DanielBryars/ChadHouse/2D/Structural/20180212_132553 rebate spec.png

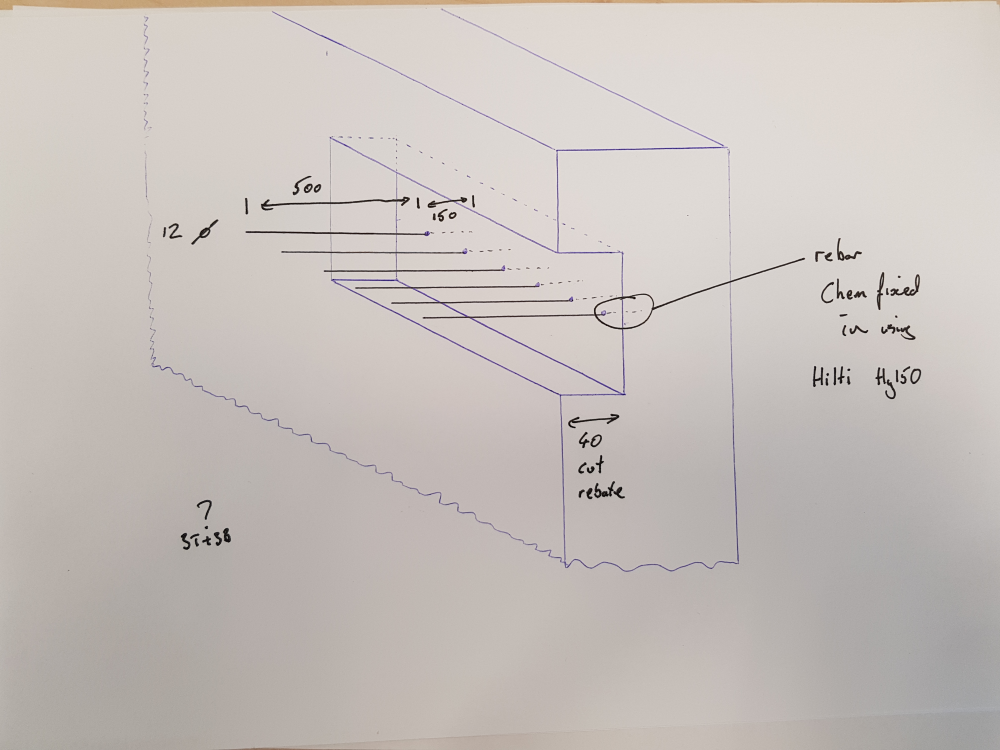
2D/Structural/20180212_132553 rebate spec.png
