DanielBryars/ChadHouse/Planning/readme.txt

15/03680/FUL

https://publicaccess.westoxon.gov.uk/online-applications/applicationDetails.do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
