DanielBryars/ChadHouse/Plumbing/Domestic Takeoff.pdf

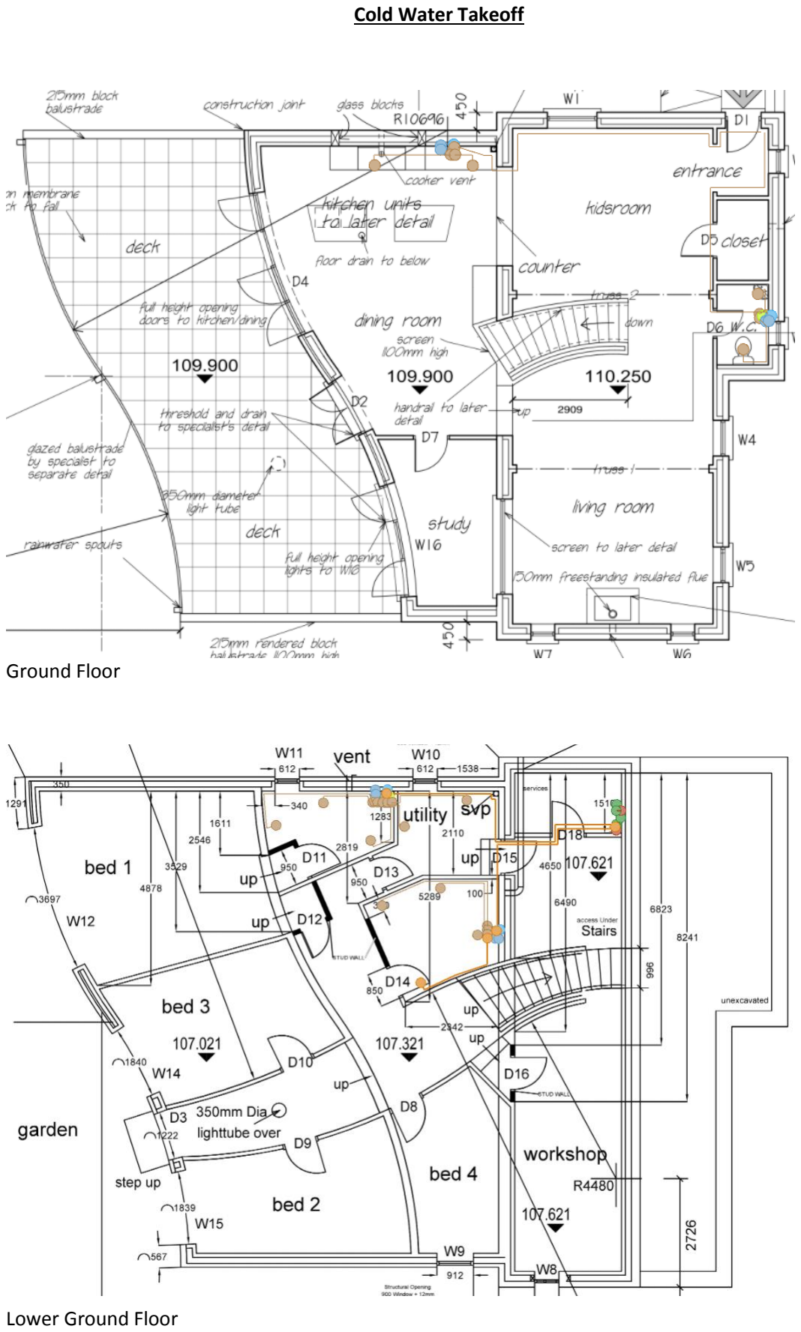
[picture p3: page 1]

Cold Water Takeoff

Ground Floor

Lower Ground Floor

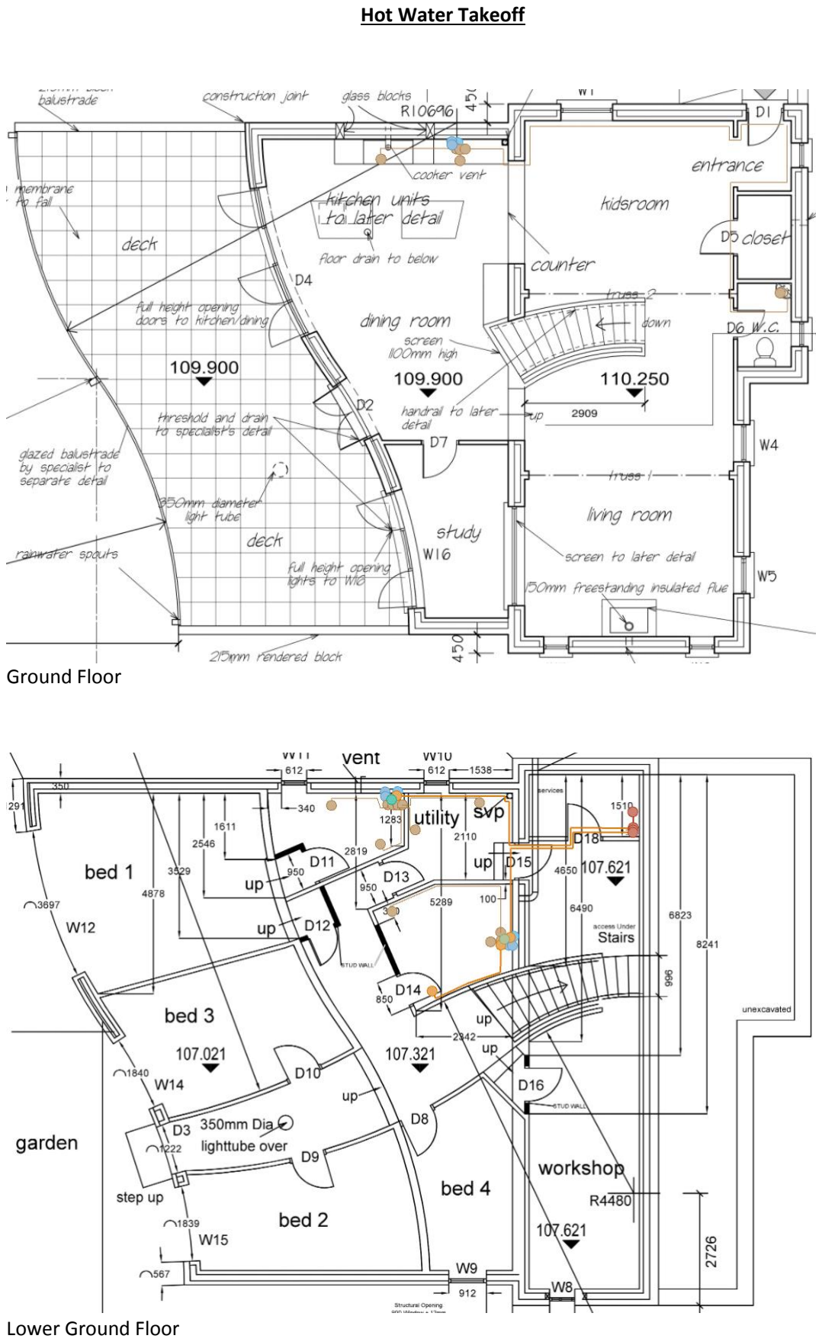
[picture p4: page 2]

Hot Water Takeoff

Ground Floor

Lower Ground Floor

### Key:

= 16mm MLCP

= 20mm MLCP

= 25mm MLCP

= 32mm MLCP
