DanielBryars/ChadHouse/Underfloor Heating/AppleBrookHouse2-Circuit Schedule.PDF

# Circuit Schedule

Project #:AppleBrookHouse2

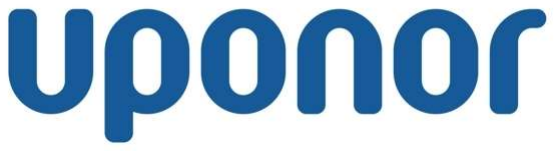
[picture p5: figure]

## Project Information

July 29, 2018

Project #:
Name:
Location:
AppleBrookHouse2 | Notes:

## Circuit Stock Summary

Part Number | Description | Quantity
A1220500 | 1/2" Wirsbo hePEX plus, 1,000 ft. coil | 3
A1250500 | 1/2" Wirsbo hePEX plus, 300 ft. coil | 1
A1260500 | 1/2" Wirsbo hePEX, 500 ft. coil | 1
A1140500 | 1/2" Wirsbo hePEX, 100-ft. coil | 1

## Coil Summary

Coil | Part Number | Coil Length (m) | Tube Type | Length Used (m)
Coil 1 | A1220500 | 304.8 | hePEX 1/2" | 292.6
Coil 2 | A1220500 | 304.8 | hePEX 1/2" | 303.4
Coil 3 | A1250500 | 91.4 | hePEX 1/2" | 87.3
Coil 4 | A1220500 | 304.8 | hePEX 1/2" | 304.1
Coil 5 | A1260500 | 152.4 | hePEX 1/2" | 142.6
Coil 6 | A1140500 | 30.5 | hePEX 1/2" | 12.2

## Circuits Cut Schedule

## Ground Floor

Circuit | Length (m) | Location | Coil | Coil Length (m)
A-1 | 39.1 | Ground Floor;Manifold 2;Main Bathroom | Coil 1 | 304.8
A-2 | 33.0 | Ground Floor;Manifold 2;Ensuite | Coil 2 | 304.8
A-3 | 68.8 | Ground Floor;Manifold 2;Bed 1 | Coil 2 | 304.8
A-4 | 66.6 | Ground Floor;Manifold 2;Bed 1 | Coil 2 | 304.8
A-5 | 35.5 | Ground Floor;Manifold 2;Hall 2 | Coil 2 | 304.8
A-6 | 59.8 | Ground Floor;Manifold 4;Bed 4 | Coil 1 | 304.8
A-7 | 49.2 | Ground Floor;Manifold 4;Bed 3 | Coil 2 | 304.8
A-8 | 50.4 | Ground Floor;Manifold 4;Bed 3 | Coil 2 | 304.8
A-9 | 52.5 | Ground Floor;Manifold 4;Bed 2 | Coil 1 | 304.8
A-10 | 52.5 | Ground Floor;Manifold 4;Bed 2 | Coil 1 | 304.8
A-11 | 44.9 | Ground Floor;Manifold 4;Hall 1 | Coil 1 | 304.8
A-12 | 87.3 | Ground Floor;Manifold 4;Basement | Coil 3 | 91.4
A-13 | 43.8 | Ground Floor;Manifold 4;Basement | Coil 1 | 304.8

## Main Floor

Circuit | Length (m) | Location | Coil | Coil Length (m)
B-1 | 44.8 | Main Floor;Manifold 1;Kitchen | Coil 5 | 152.4
B-2 | 3.8 | Main Floor;Manifold 1;Kitchen | Coil 6 | 30.5
B-3 | 4.3 | Main Floor;Manifold 1; | Coil 6 | 30.5

Created Using LoopCAD 2018 Uponor(US) (7/30/2018) Version:18.0.0594 R (Trial)

IN NO EVENT WILL AVENIR SOFTWARE INC. (“AVENIR”) OR ITS AFFILIATES BE LIABLE UNDER ANY CONTRACT, NEGLIGENCE, STRICT LIABILITY OR OTHER LEGAL OR EQUITABLE THEORY FOR ANY CONSEQUENTIAL, INCIDENTAL, INDIRECT OR SPECIAL OR PUNITIVE DAMAGES WHATSOEVER (INCLUDING, BUT NOT LIMITED TO, DAMAGES FOR LOSS OF BUSINESS PROFITS, BUSINESS INTERRUPTION, LOSS OF BUSINESS INFORMATION OR DATA AND THE LIKE), EVEN IF SUCH PARTY HAS BEEN ADVISED OF THE POSSIBILITY OF SUCH DAMAGES. AVENIR’S CUMULATIVE LIABILITY FROM ANY CAUSE RELATED TO OR ARISING FROM THE USE THIS REPORT, AND REGARDLESS OF THE FORM OF THE ACTION, SHALL BE LIMITED TO NO GREATER THAN THE AMOUNT OF FEES PAID TO AVENIR UNDER THE SOFTWARE LICENSE AGREEMENT.

B-4 | 4.1 | Main Floor;Manifold 1;Kitchen | Coil 6 | 30.5
B-5 | 61.4 | Main Floor;Manifold 1;Study | Coil 4 | 304.8
B-6 | 61.6 | Main Floor;Manifold 1;Kitchen | Coil 5 | 152.4
B-8 | 43.1 | Main Floor;Manifold 3;Main Cottage | Coil 4 | 304.8
B-9 | 66.0 | Main Floor;Manifold 3;Main Cottage,WC | Coil 4 | 304.8
B-10 | 65.5 | Main Floor;Manifold 3;Main Cottage,Entrance | Coil 4 | 304.8
B-11 | 36.1 | Main Floor;Manifold 3;Main Cottage | Coil 5 | 152.4
B-12 | 68.1 | Main Floor;Manifold 3;Main Cottage | Coil 4 | 304.8

The calculated values shown in this report are based on the data input by the user of the software. Inaccurate or erroneous data input will result in inaccurate or erroneous results. You are strongly advised to review all input data carefully, and to have the calculated results reviewed by an experienced heating professional to ensure reasonableness and suitability for your application.

## Disclaimers

Name:

Project #: AppleBrookHouse2 | Circuit Schedule July 29, 2018

Created Using LoopCAD 2018 Uponor(US) (7/30/2018) Version:18.0.0594 R (Trial)

IN NO EVENT WILL AVENIR SOFTWARE INC. (“AVENIR”) OR ITS AFFILIATES BE LIABLE UNDER ANY CONTRACT, NEGLIGENCE, STRICT LIABILITY OR OTHER LEGAL OR EQUITABLE THEORY FOR ANY CONSEQUENTIAL, INCIDENTAL, INDIRECT OR SPECIAL OR PUNITIVE DAMAGES WHATSOEVER (INCLUDING, BUT NOT LIMITED TO, DAMAGES FOR LOSS OF BUSINESS PROFITS, BUSINESS INTERRUPTION, LOSS OF BUSINESS INFORMATION OR DATA AND THE LIKE), EVEN IF SUCH PARTY HAS BEEN ADVISED OF THE POSSIBILITY OF SUCH DAMAGES. AVENIR’S CUMULATIVE LIABILITY FROM ANY CAUSE RELATED TO OR ARISING FROM THE USE THIS REPORT, AND REGARDLESS OF THE FORM OF THE ACTION, SHALL BE LIMITED TO NO GREATER THAN THE AMOUNT OF FEES PAID TO AVENIR UNDER THE SOFTWARE LICENSE AGREEMENT.
