DanielBryars/ChadHouse/Underfloor Heating/AppleBrookHouse2-Heating System Summary.PDF

# Heating System Summary

Project #:AppleBrookHouse2


## Project Information

July 29, 2018

Project #:
Name:
Location:
AppleBrookHouse2 | Notes:

### Project Summary

Some panels have excessive downward loss. The water temperature calculations are not valid when the downward losses (or back losses) exceed the required upward load. This can occur when inadequate, or no insulation is specified under the panel. It is recommended that adequate insulation be added to radiant panels.

Load Calculation Method: | Manual J8
Design Location: | (User Specified) Chadlington, Oxfordshire
Outdoor Temperature: | -3.8 °C
Floorplans / Levels:
Ground Floor | 150.9 m²
Main Floor | 115.8 m²
Total Area: | 266.7 m²

Total Circuit Lengths:
hePEX 1/2" | 1142.2 m
Total RH Circuits: | 24
Total Manifolds: | 4
Total Zones: | 13
Fluid Type: | 100% Water
Total Tubing Volume: | 130.6 L
Component Losses: | 5,168 W
Infiltration/Ventilation: | 2,129 W
Radiant Back Losses: | 4,855 W
Total Heating Load: | 12,152 W
Radiant Heating: | 7,201 W
Radiant Back Losses: | 4,855 W
Other: | 96 W
Total Heating Load: | 12,152 W

### Zone Heating Summary

Zone # | Gross Area | Construction | Heating Types | RH¹ Circuits | Total Tubing | Manifolds | Flowrate | Head Loss (Circuit Only) | RH Load² | Supplemental | Zone Load³
Zone 102 | 24.2 | Embedded Slab | RH | 2 | 135.4 | 1 | 1.61 | 2.0 | 1,083 | 0 | 1,083
Zone 103 | 6.6 | Embedded Slab | RH | 1 | 33.0 | 1 | 0.42 | 0.3 | 269 | 0 | 269
Zone 104 | 16.5 | Embedded Slab | RH | 2 | 99.6 | 1 | 0.76 | 0.4 | 423 | 0 | 423
Zone 105 | 8.0 | Embedded Slab | RH | 1 | 35.5 | 1 | 0.38 | 0.3 | 36 | 0 | 36
Zone 106 | 8.1 | Embedded Slab | RH | 1 | 39.1 | 1 | 0.38 | 0.3 | 64 | 0 | 64
Zone 107 | 6.6 | Embedded Slab | RH | 0 | 0.0 | 0 | 0.00 | 0.0 | 282 | 0 | 282
Zone 108 | 20.7 | Embedded Slab | RH | 1 | 44.9 | 1 | 0.38 | 0.4 | 347 | 0 | 347
Zone 109 | 17.2 | Embedded Slab | RH | 2 | 105.0 | 1 | 0.97 | 0.7 | 625 | 0 | 625
Zone 110 | 11.3 | Embedded Slab | RH | 1 | 59.8 | 1 | 0.43 | 0.6 | 250 | 0 | 250
Zone 111 | 31.5 | Embedded Slab | RH | 2 | 131.2 | 1 | 1.63 | 4.1 | 1,317 | 0 | 1,317

Created Using LoopCAD 2018 Uponor(US) (7/30/2018) Version:18.0.0594 R (Trial)

Length = m Area = m² | Temperature = °C | Flowrate = L/min | Air Flow = L/s | Heat Loss = W | Unit Heat Loss = W/m² | Rv = m²·K/W
Head Loss = kPa | RH = Radiant Floor Heating | BB = Baseboard | FA = Forced Air | OTH = Other Heating | SM = Snowmelt | N = Not Heated
See end of report for important Notes and Disclaimers. | Page 1 of 3

Zone 201 | 9.5 | Concrete Over-Pour On Suspended Slab | RH | 1 | 61.4 | 1 | 1.44 | 4.7 | 696 | 0 | 696
Zone 202 | 38.7 | Concrete Over-Pour On Suspended Slab | RH | 5 | 118.7 | 1 | 3.27 | 5.1 | 2,388 | 0 | 2,388
Zone 203 | 67.6 | Concrete Over-Pour On Suspended Slab | RH,OTH | 5 | 278.8 | 1 | 10.50 | 21.5 | 6,648 | 96 | 6,745
(1) Complete circuits assigned to this zone. (2) Total Radiant heating load for rooms in zone, including all panel back loss. (3) Total load for zone including all panel back loss. Does not account for reclaimed loss within building envelope.

### Room Heating Summary (By Construction Type)

### Embedded Slab

Zone # | Room Name | Heating Type | Floor Area | Heated Area | Manifold # | Tube Size | RH Circuits¹ | Tube Spacing | Tubing In Room | Floor Cover RV | Required Temp. | Unit RH Load | RH Load² | Supplemental | Total Load³
Zone 102 | Bed 1 | RH | 22.7 | 22.6 | Manifold 2 | 1/2" | 2 | 200 | 106.0 | 0.09 | 32 | 47.9 | 1,083 | 0 | 1,083
Zone 103 | Ensuite | RH | 5.9 | 5.9 | Manifold 2 | 1/2" | 1 | 200 | 24.9 | 0.09 | 32 | 45.1 | 269 | 0 | 269
Zone 104 | Bed 3 | RH | 15.5 | 15.5 | Manifold 4 | 1/2" | 2 | 200 | 68.4 | 0.09 | 32 | 27.3 | 423 | 0 | 423
Zone 105 | Hall 2 | RH | 7.4 | 7.4 | Manifold 2 | 1/2" | 1 | 200 | 36.4 | 0.09 | 32 | 4.9 | 36 | 0 | 36
Zone 106 | Main Bathroom | RH | 7.6 | 7.5 | Manifold 2 | 1/2" | 1 | 200 | 33.9 | 0.09 | 32 | 8.5 | 64 | 0 | 64
Zone 107 | Utility | RH | 5.9 | 5.4 | n/a | n/a | 0 | 200 | 31.9 | 0.09 | -18 | 52.4 | 282 | 0 | 282
Zone 108 | Hall 1 | RH | 19.3 | 19.2 | Manifold 4 | 1/2" | 1 | 200 | 111.8 | 0.09 | 32 | 18.1 | 347 | 0 | 347
Zone 109 | Bed 2 | RH | 15.9 | 15.2 | Manifold 4 | 1/2" | 2 | 200 | 63.9 | 0.09 | 32 | 41.2 | 625 | 0 | 625
Zone 110 | Bed 4 | RH | 10.5 | 10.0 | Manifold 4 | 1/2" | 1 | 200 | 43.0 | 0.09 | 32 | 25.1 | 250 | 0 | 250
Zone 111 | Basement | RH | 29.1 | 28.8 | Manifold 4 | 1/2" | 2 | 200 | 130.2 | 0.09 | 32 | 45.7 | 1,317 | 0 | 1,317
(1) Circuits assigned to this room. Leaders from other rooms may not be counted. (2) Includes panel back loss. (3) Total load including panel back loss. Does not account for reclaimed loss within building envelope.

### Concrete Over-Pour On Suspended Slab

Zone # | Room Name | Heating Type | Floor Area | Heated Area | Manifold # | Tube Size | RH Circuits¹ | Tube Spacing | Tubing In Room | Floor Cover RV | Required Temp. | Unit RH Load | RH Load² | Supplemental | Total Load³
Zone 201 | Study | RH | 8.6 | 8.6 | Manifold 1 | 1/2" | 1 | 200 | 41.9 | 0.09 | 38 | 81.0 | 696 | 0 | 696
Zone 202 | Kitchen | RH | 36.6 | 28.6 | Manifold 1 | 1/2" | 4 | 200 | 115.7 | 0.09 | 37 | 83.6 | 2,388 | 0 | 2,388
Zone 203 | Entrance | RH, OTH | 2.5 | 2.5 | Manifold 3 | 1/2" | 1 | 200 | 9.2 | 0.09 | 54 | 204.0 | 516 | 96 | 612
Zone 203 | Main Cottage | RH | 58.5 | 56.7 | Manifold 3 | 1/2" | 5 | 200 | 249.2 | 0.09 | 54 | 100.1 | 5,677 | 0 | 5,677
Zone 203 | WC | RH | 2.5 | 2.4 | Manifold 3 | 1/2" | 1 | 200 | 9.3 | 0.09 | 49 | 186.4 | 456 | 0 | 456
(1) Circuits assigned to this room. Leaders from other rooms may not be counted. (2) Includes panel back loss. (3) Total load including panel back loss. Does not account for reclaimed loss within building envelope.

### Manifold Summary

Manifold Name | #
Zones
Circuits

Flowrate Head
Loss¹

Required
Temp.

Supplied
Temp.

Temp
Drop
Manifold Type | Control
Type
Actuators

S/R
Length²

S/R
Pipe

Name:
Project #:AppleBrookHouse2

July 29, 2018

Created Using LoopCAD 2018 Uponor(US) (7/30/2018) Version:18.0.0594 R (Trial)

Length = m Area = m² | Temperature = °C | Flowrate = L/min | Air Flow = L/s | Heat Loss = W | Unit Heat Loss = W/m² | Rv = m²·K/W
Head Loss = kPa | RH = Radiant Floor Heating | BB = Baseboard | FA = Forced Air | OTH = Other Heating | SM = Snowmelt | N = Not Heated
See end of report for important Notes and Disclaimers. | Page 2 of 3

Name:
Project #:AppleBrookHouse2

July 29, 2018

Manifold 1 | 2 | 6 | 4.70 | 5.3 | 38 | 38 | 11 | TruFLOW Jr Valved w/ Balancing | Circuit | 6 | - | -
Manifold 2 | 4 | 5 | 2.79 | 2.1 | 32 | 38 | 11 | TruFLOW Jr Valved w/ Balancing | Circuit | 5 | - | -
Manifold 3 | 1 | 5 | 10.50 | 22.7 | 54 | 54 | 11 | TruFLOW Jr Valved w/ Balancing | Manifold | 0 | - | -
Manifold 4 | 5 | 8 | 4.18 | 4.2 | 32 | 38 | 11 | TruFLOW Jr Valved w/ Balancing | Circuit | 8 | - | -
Total | 12 | 24 | 22.17 | 22.7 | 54 | - | 11 | - | - | 19 | - | -
(1) Total Head loss includes manifold, circuits and supply/return piping if specified. (2) S/R Length = one way

## Disclaimers

With the permission of the Air Conditioning Contractors of America (“ACCA”), material is reproduced from Manual J Residential Load Calculation (8th Edition) which is copyrighted by ACCA. The program and data are provided "as is" without warranty of any kind either expressed or implied. The entire risk as the quality and performance of the program and data is with you. In no event will ACCA be liable to you for any damages, including without limitation any lost profits, lost savings, or other incidental or consequential damages arising out of the use or inability to use this program or the data. © 2015 Air Conditioning Contractors of America. All Rights Reserved. www.acca.org

ACCA, Manual J and Powered by ACCA Manual J are registered trademarks of the Air Conditioning Contractors of America. All rights reserved.

Cold weather humidification, or some lifestyles that produce excessive moisture, may cause condensation to occur if the absolute humidity of the indoor air is too high for the momentary circumstances. Condensation can occur on surfaces or concealed within the structure, and can lead to mold, mildew, frost damage, and moisture damage. The software does not perform calculations for the estimation or detection of possible condensation problems, and it is the designers (i.e. software users) responsibility to do so independently if required. For guidance and additional cautions refer to ACCA Manual J 8th Edition, including Section 1-11 and Section 27.

The calculated values shown in this report are based on the data input by the user of the software. Inaccurate or erroneous data input will result in inaccurate or erroneous results. You are strongly advised to review all input data carefully, and to have the calculated results reviewed by an experienced heating professional to ensure reasonableness and suitability for your application.

IN NO EVENT WILL AVENIR SOFTWARE INC. (“AVENIR”) OR ITS AFFILIATES BE LIABLE UNDER ANY CONTRACT, NEGLIGENCE, STRICT LIABILITY OR OTHER LEGAL OR EQUITABLE THEORY FOR ANY CONSEQUENTIAL, INCIDENTAL, INDIRECT OR SPECIAL OR PUNITIVE DAMAGES WHATSOEVER (INCLUDING, BUT NOT LIMITED TO, DAMAGES FOR LOSS OF BUSINESS PROFITS, BUSINESS INTERRUPTION, LOSS OF BUSINESS INFORMATION OR DATA AND THE LIKE), EVEN IF SUCH PARTY HAS BEEN ADVISED OF THE POSSIBILITY OF SUCH DAMAGES. AVENIR’S CUMULATIVE LIABILITY FROM ANY CAUSE RELATED TO OR ARISING FROM THE USE THIS REPORT, AND REGARDLESS OF THE FORM OF THE ACTION, SHALL BE LIMITED TO NO GREATER THAN THE AMOUNT OF FEES PAID TO AVENIR UNDER THE SOFTWARE LICENSE AGREEMENT.

Created Using LoopCAD 2018 Uponor(US) (7/30/2018) Version:18.0.0594 R (Trial)

Length = m Area = m² | Temperature = °C | Flowrate = L/min | Air Flow = L/s | Heat Loss = W | Unit Heat Loss = W/m² | Rv = m²·K/W
Head Loss = kPa | RH = Radiant Floor Heating | BB = Baseboard | FA = Forced Air | OTH = Other Heating | SM = Snowmelt | N = Not Heated
See end of report for important Notes and Disclaimers. | Page 3 of 3
