DanielBryars/ChadHouse/Underfloor Heating/AppleBrookHouse2-LoopCAD Drawing Room By Room.PDF

### Project Number: AppleBrookHouse2 Floorplan: Bed 4 (Fit To Page) July 30, 2018

Note: Details of the tubing bend radius have been simplified for clarity. Consult tubing manufacturer for specific bend radius recommendations.
Created Using LoopCAD 2018 18.0.0594 (7/30/2018)

### Project Number: AppleBrookHouse2 Floorplan: Bed 2 (Fit To Page)

Note: Details of the tubing bend radius have been simplified for clarity. Consult tubing manufacturer for specific bend

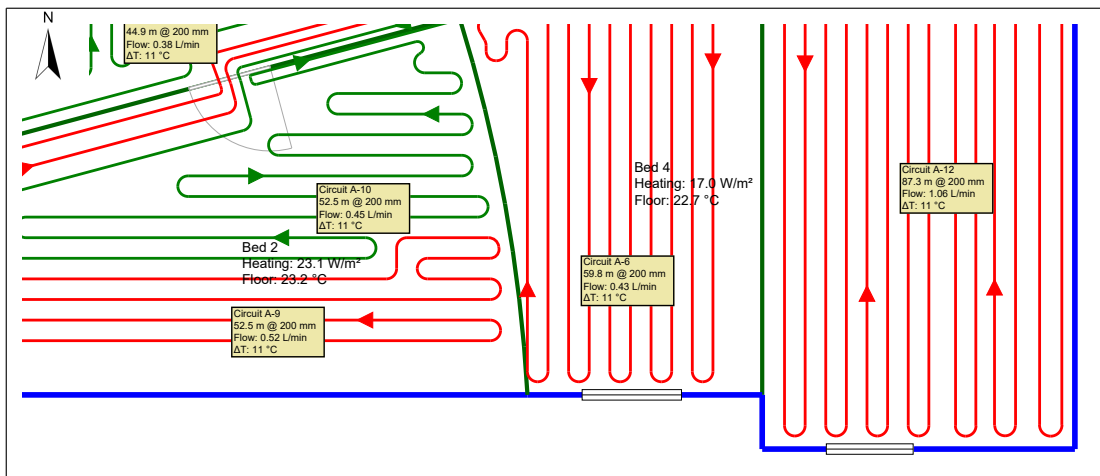
[picture p6: page 3]
Bed 4 Heating: 17.0 W/m² Floor: 22.7 °C; Bed 2 Heating: 23.1 W/m² Floor: 23.2 °C; Circuit A-10 52.5 m @ 200 mm Flow: 0.45 L/min ΔT: 11 °C; Circuit A-9 52.5 m @ 200 mm Flow: 0.52 L/min ΔT: 11 °C; Circuit A-6 59.8 m @ 200 mm Flow: 0.43 L/min ΔT: 11 °C; 44.9 m @ 200 mm Flow: 0.38 L/min ΔT: 11 °C; Circuit A-12 87.3 m @ 200 mm Flow: 1.06 L/min ΔT: 11 °C

Note: Details of the tubing bend radius have been simplified for clarity. Consult tubing manufacturer for specific bend

Project Number: AppleBrookHouse2
Floorplan: Bed 3 (Fit To Page)

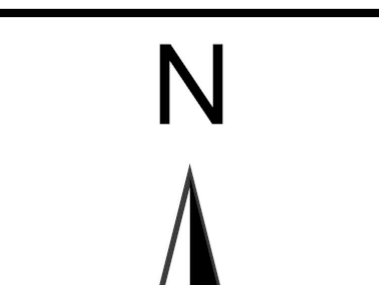
[picture p7: page 4]
Bed 4 Heating: 17.0 W/m² Floor: 22.7 °C; Basement Heating: 25.4 W/m² Floor: 23.4 °C; Floor: 23.7 °C; Main Bathroom Heating: 8.5 W/m² Floor: 21.9 °C; Circuit A-1 39.1 m @ 200 mm Flow: 0.38 L/min ΔT: 11 °C; Circuit A-6 59.8 m @ 200 mm Flow: 0.43 L/min ΔT: 11 °C; Circuit A-13 43.8 m @ 200 mm Flow: 0.58 L/min ΔT: 11 °C; Circuit A-12 87.3 m @ 200 mm Flow: 1.06 L/min ΔT: 11 °C; Manifold 4 (37.5 °C)

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

Project Number: AppleBrookHouse2
Floorplan: Basement (Fit To Page)

### Project Number: AppleBrookHouse2 Floorplan: Services (Fit To Page)

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

### Project Number: AppleBrookHouse2 Floorplan: Utility (Fit To Page)

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

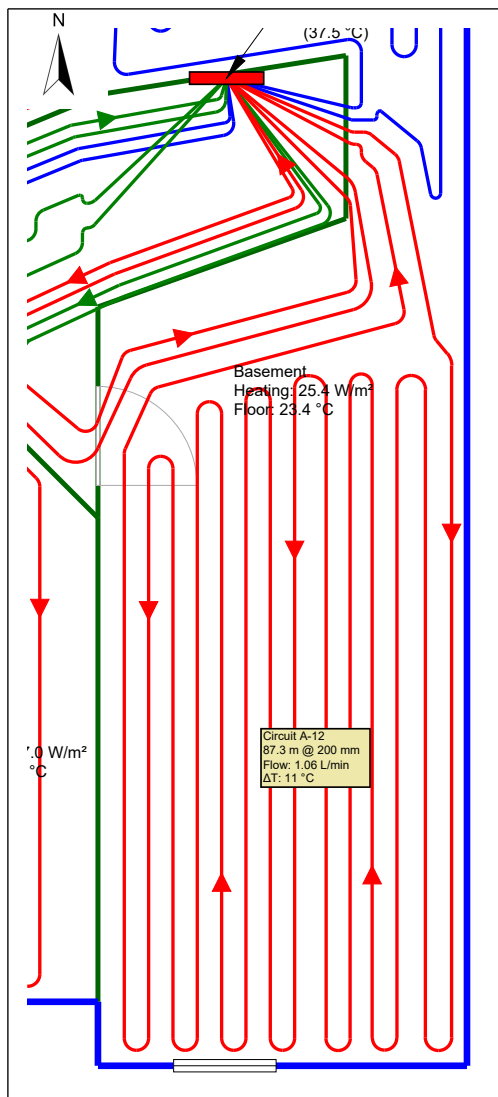
[picture p8: page 7]
Bed 4 Heating: 17.0 W/m² Floor: 22.7 °C; Basement Heating: 25.4 W/m² Floor: 23.4 °C; Heating: 8.5 W/m² Floor: 21.9 °C; 39.1 m @ 200 mm Flow: 0.38 L/min; 59.8 m @ 200 mm Flow: 0.43 L/min; Circuit A-12 87.3 m @ 200 mm Flow: 1.06 L/min ΔT: 11 °C

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

Project Number: AppleBrookHouse2
Floorplan: Hall 2 (Fit To Page)

## Not Heated

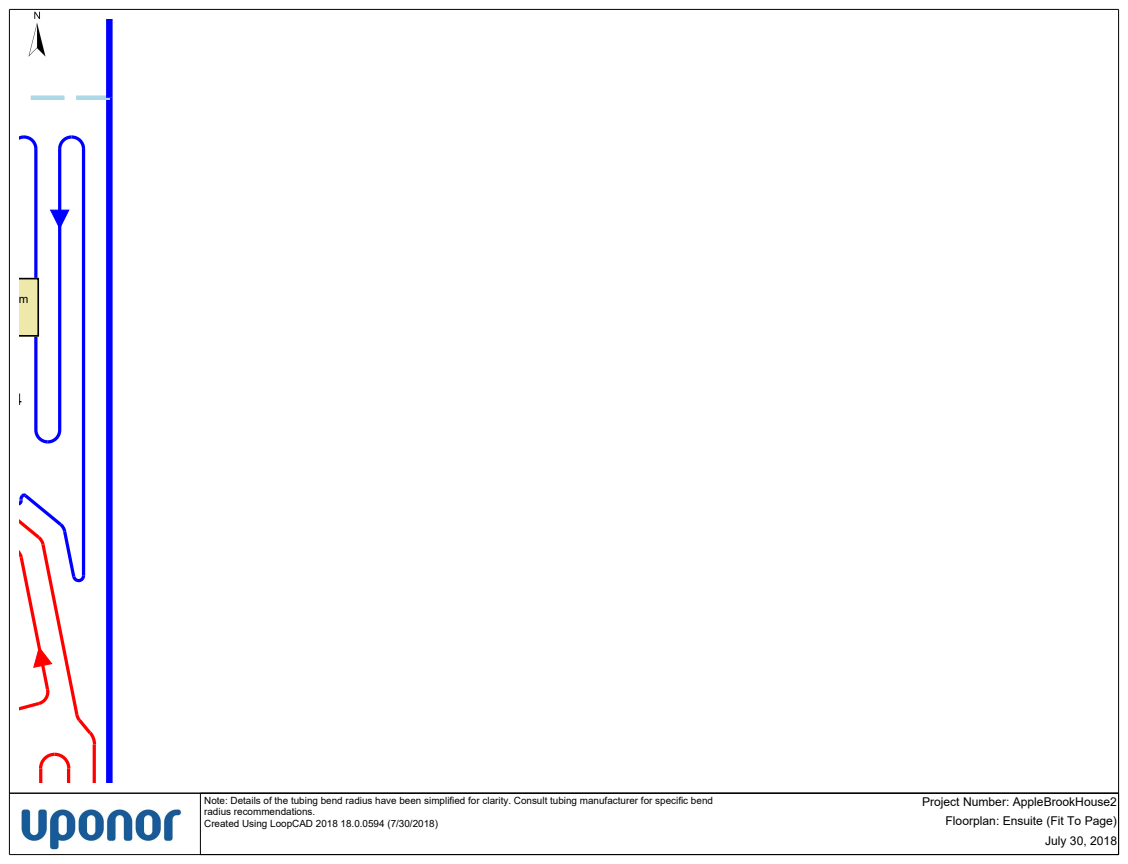
[picture p9: page 8]
Heating: 25.4 W/m²; Circuit A-13 43.8 m @ 200 mm Flow: 0.58 L/min ΔT: 11 °C; Manifold 4 (37.5 °C)

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

Project Number: AppleBrookHouse2
Floorplan: Ensuite (Fit To Page)

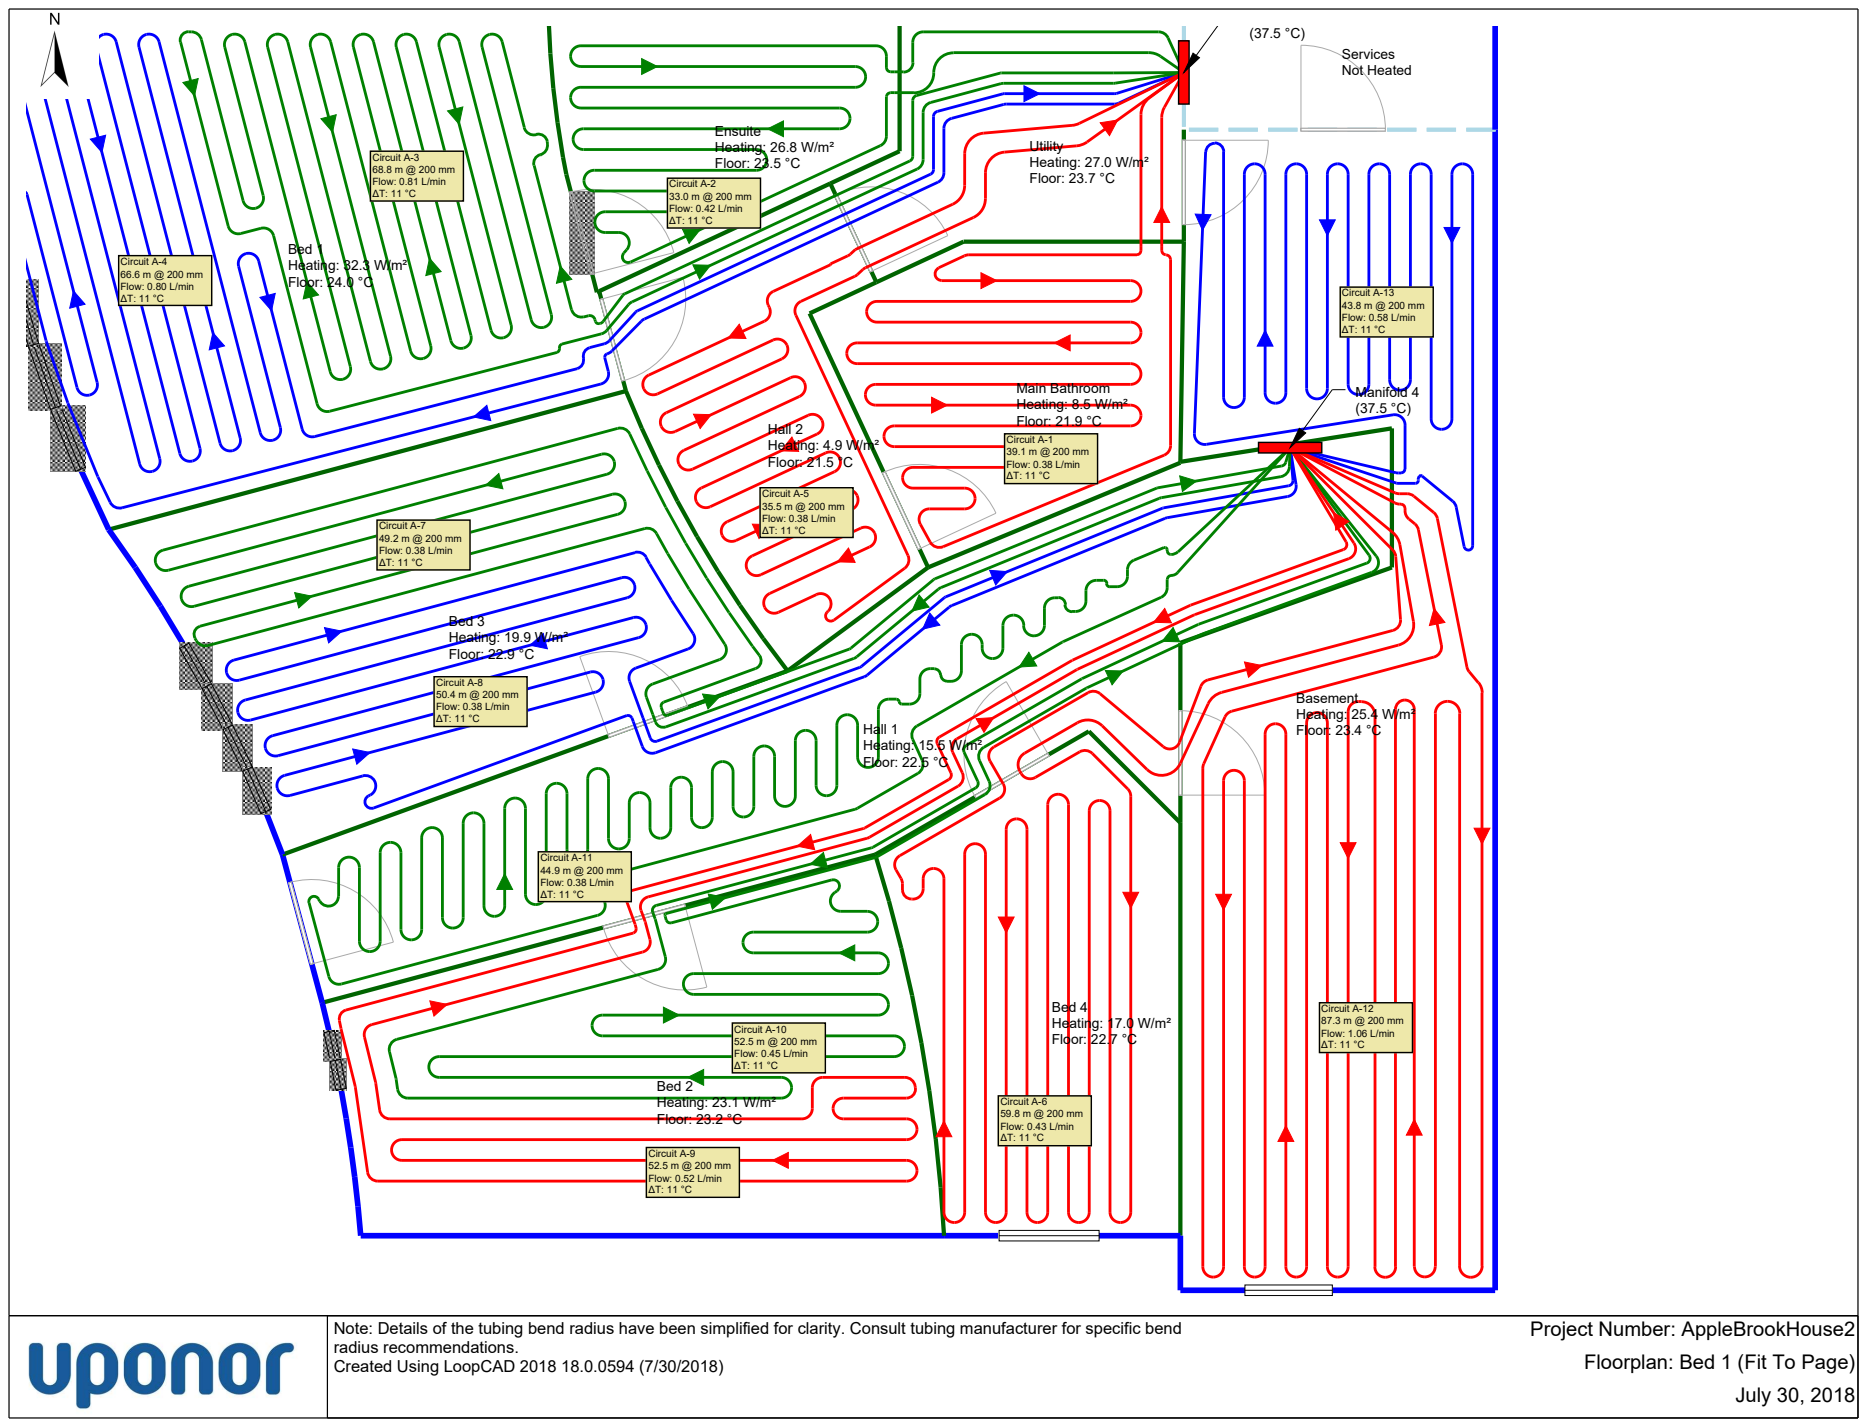
[picture p10: page 9]
Bed 4 Heating: 17.0 W/m² Floor: 22.7 °C; Bed 2 Heating: 23.1 W/m² Floor: 23.2 °C; Bed 3 Heating: 19.9 W/m² Floor: 22.9 °C; Basement Heating: 25.4 W/m² Floor: 23.4 °C; Services Not Heated; Utility Heating: 27.0 W/m² Floor: 23.7 °C; Hall 2 Heating: 4.9 W/m² Floor: 21.5 °C; Ensuite Heating: 26.8 W/m² Floor: 23.5 °C; Bed 1 Heating: 32.3 W/m² Floor: 24.0 °C; Hall 1 Heating: 15.5 W/m² Floor: 22.5 °C; Main Bathroom Heating: 8.5 W/m² Floor: 21.9 °C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

Project Number: AppleBrookHouse2
Floorplan: Bed 1 (Fit To Page)

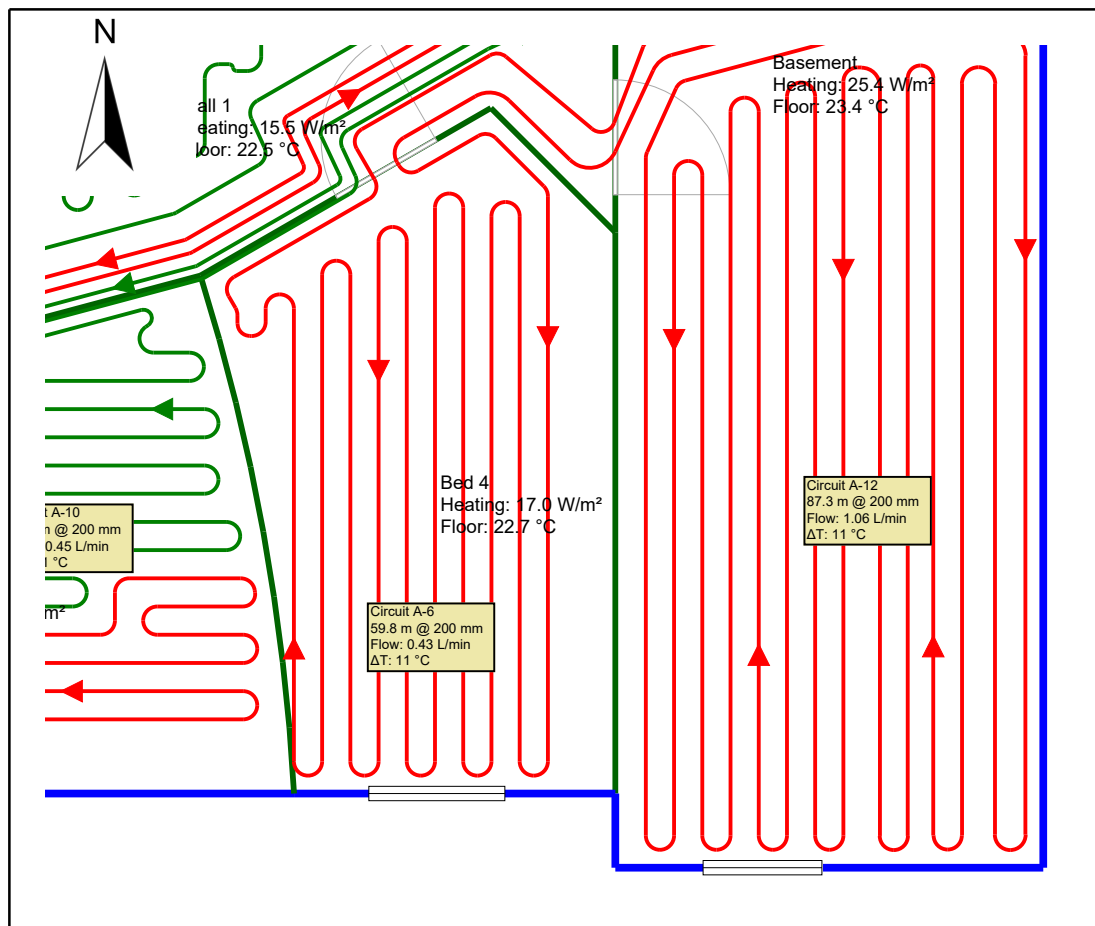
[picture p11: page 10]
Bed 4 Heating: 17.0 W/m² Floor: 22.7 °C; Bed 2 Heating: 23.1 W/m² Floor: 23.2 °C; Basement Heating: 25.4 W/m² Floor: 23.4 °C; Hall 1 Heating: 15.5 W/m² Floor: 22.5 °C; Circuit A-10 52.5 m @ 200 mm Flow: 0.45 L/min ΔT: 11 °C; Circuit A-9 52.5 m @ 200 mm Flow: 0.52 L/min ΔT: 11 °C; Circuit A-6 59.8 m @ 200 mm Flow: 0.43 L/min ΔT: 11 °C; Circuit A-12 87.3 m @ 200 mm Flow: 1.06 L/min ΔT: 11 °C

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

Project Number: AppleBrookHouse2
Floorplan: Hall 1 (Fit To Page)

### Project Number: AppleBrookHouse2 Floorplan: Main Bathroom (Fit To Page)

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

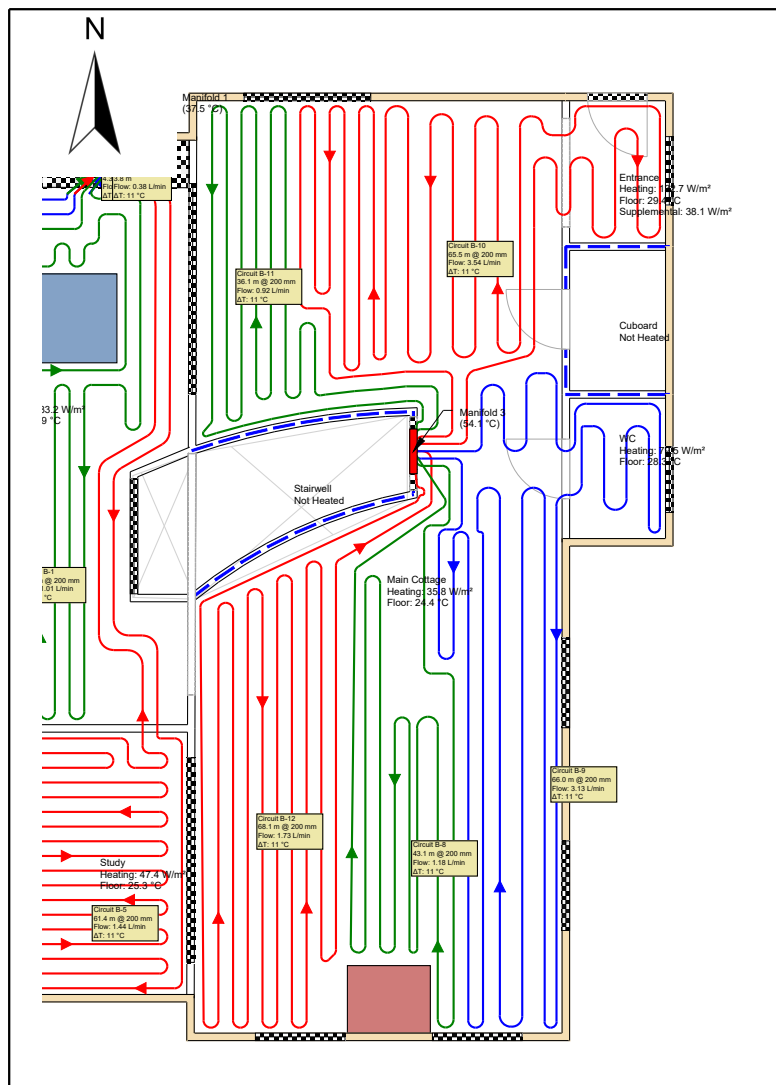
[picture p12: page 12]
Main Cottage Heating: 35.8 W/m² Floor: 24.4 °C; Entrance Heating: 132.7 W/m² Floor: 29.4 °C Supplemental: 38.1 W/m²; WC Heating: 79.5 W/m² Floor: 28.3 °C; Cuboard Not Heated; Study Heating: 47.4 W/m² Floor: 25.3 °C; Kitchen Heating: 33.2 W/m² Floor: 24.9 °C; Stairwell Not Heated; Circuit B-5 61.4 m @ 200 mm Flow: 1.44 L/min ΔT: 11 °C; Circuit B-11 36.1 m @ 200 mm Flow: 0.92 L/min ΔT: 11 °C; Circuit B-10 65.5 m @ 200 mm Flow: 3.54 L/min ΔT: 11 °C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

Project Number: AppleBrookHouse2
Floorplan: Main Cottage (Fit To Page)

### Project Number: AppleBrookHouse2 Floorplan: Entrance (Fit To Page)

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

### Project Number: AppleBrookHouse2 Floorplan: WC (Fit To Page)

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

### Project Number: AppleBrookHouse2 Floorplan: Cuboard (Fit To Page)

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

### Project Number: AppleBrookHouse2 Floorplan: Study (Fit To Page)

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

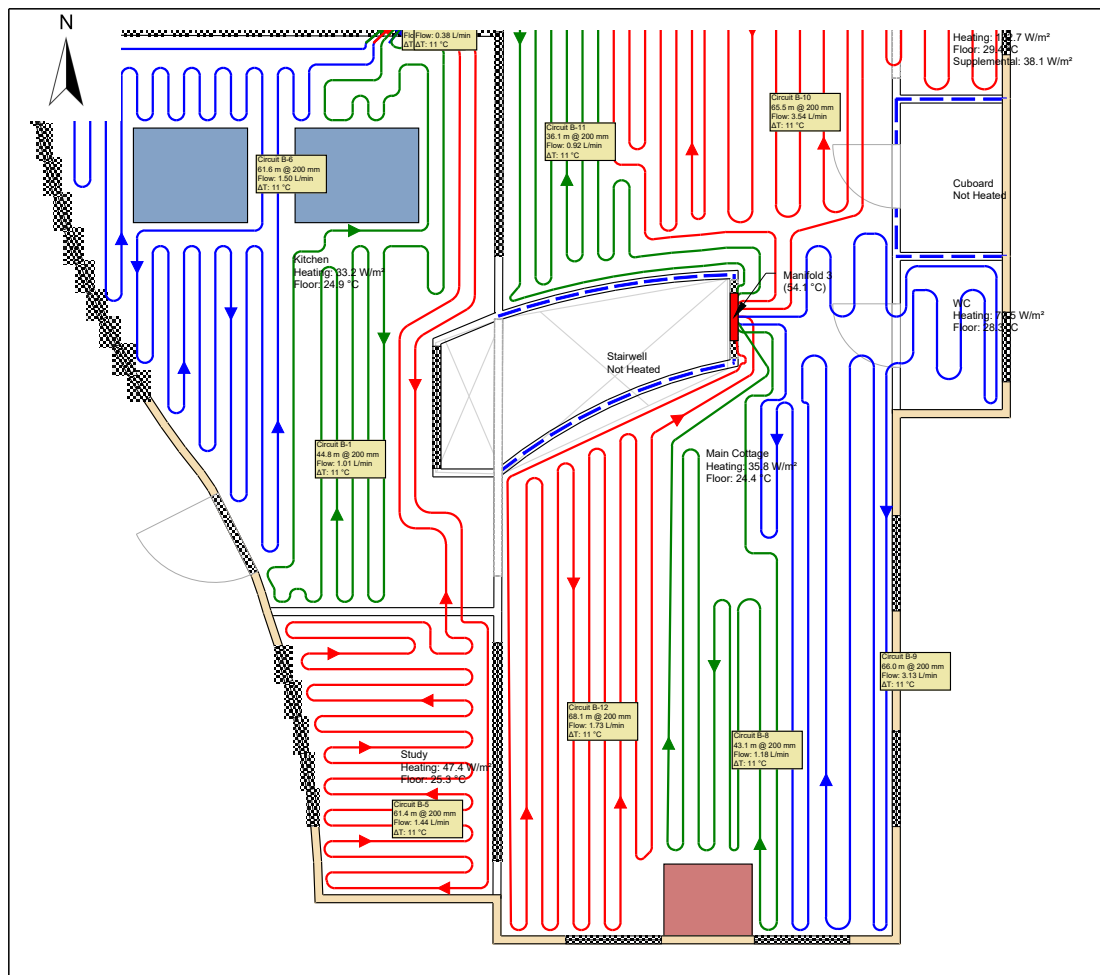
[picture p13: page 17]
Main Cottage Heating: 35.8 W/m² Floor: 24.4 °C; Entrance Heating: 132.7 W/m² Floor: 29.4 °C Supplemental: 38.1 W/m²; WC Heating: 79.5 W/m² Floor: 28.3 °C; Cuboard Not Heated; Study Heating: 47.4 W/m² Floor: 25.3 °C; Kitchen Heating: 33.2 W/m² Floor: 24.9 °C; Stairwell Not Heated; Circuit B-5 61.4 m @ 200 mm Flow: 1.44 L/min ΔT: 11 °C; Circuit B-11 36.1 m @ 200 mm Flow: 0.92 L/min ΔT: 11 °C; Circuit B-10 65.5 m @ 200 mm Flow: 3.54 L/min ΔT: 11 °C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

Project Number: AppleBrookHouse2
Floorplan: Kitchen (Fit To Page)

### Project Number: AppleBrookHouse2 Floorplan: Stairwell (Fit To Page)

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
