DanielBryars/ChadHouse/Kitchen/BuiltInMonitor/MonitorGlass.pdf

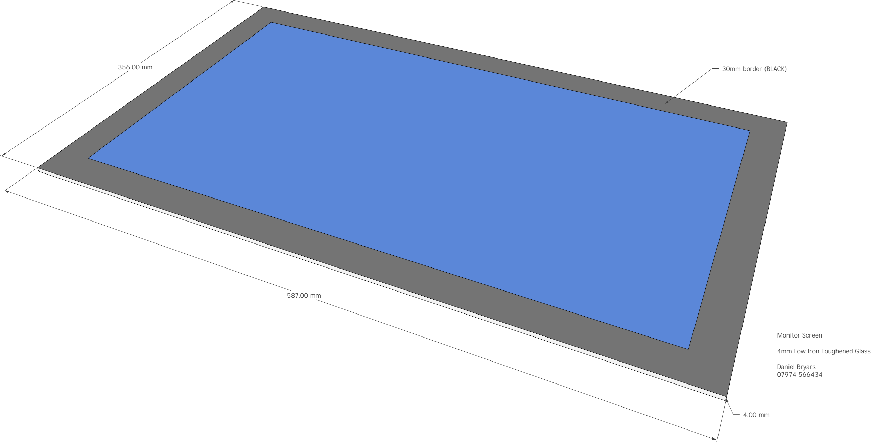
[picture p26: figure]
30mm border (BLACK); Monitor Screen; 4mm Low Iron Toughened Glass; Daniel Bryars 07974 566434
