DanielBryars/ChadHouse/2D/Structural/CHB_7011-051-01 BBS.pdf

Bar schedule ref : | 051 | 01 | Revision:
Project : | Date :
Project Ref : | Prepared by : CHB | Checked by : | PCO
Member | Bar mark | Type and size | No. of mbrs | No. of bars in each | Total no. | Length of each bar † mm | Shape code | A * B * C * D * E/R * mm mm mm mm mm | Rev letter

Side Insitu Strips

Bottom Bars | 01 | B 8 | 2 | 27 | 54 | 350 | 13 | 150 70 150
Closers | 02 | B 8 | 2 | 27 | 54 | 600 | 11 | 150 450
Lacers | 03 | B 8 | 2 | 4 | 8 | 2800 | 00 | 2800

This schedule conforms to BS 8666:2005
* Specified in multiples of 5mm. | † Specified in multiples of 25mm.

Middle Insitu Strip

Mesh Support | 04 | B 8 | 1 | 14 | 14 | 925 | 44 | 150 80 525 80 150

### 19-Jul-18

Horseshoe Lane Chadlington

### CHB_7011

# Consult h-b Ltd
