DanielBryars/ChadHouse/2D/Structural/CHB_7011-106-01 BBS.pdf

Bar schedule ref : | 106 | 01 | Revision:
Project : | Date :
Project Ref : | Prepared by : CHB | Checked by : | PCO
Member | Bar mark | Type and size | No. of mbrs | No. of bars in each | Total no. | Length of each bar † mm | Shape code | A * B * C * D * E/R * mm mm mm mm mm | Rev letter

UGF Rear Eaves Lintel

| 01 | B 16 | 1 | 1 | 1 | 6050 | 67 | 6050 5965 440 10385
| 02 | B 16 | 1 | 1 | 1 | 6425 | 67 | 6425 6335 470 10985
| 03 | B 16 | 1 | 1 | 1 | 6025 | 67 | 6025 5945 440 10335
| 04 | B 16 | 1 | 1 | 1 | 6450 | 67 | 6450 6360 470 11030
Btm Lap Bars | 05 | B 16 | 1 | 2 | 2 | 1350 | 00 | 1350
| 06 | B 12 | 1 | 1 | 1 | 6050 | 67 | 6050 5965 440 10385
| 07 | B 12 | 1 | 1 | 1 | 6425 | 67 | 6425 6335 470 10985
| 08 | B 12 | 1 | 1 | 1 | 6025 | 67 | 6025 5945 440 10335
| 09 | B 12 | 1 | 1 | 1 | 6450 | 67 | 6450 6360 470 11030
Top Lap Bars | 10 | B 12 | 1 | 2 | 2 | 600 | 00 | 600
End U Bars | 11 | B 12 | 1 | 8 | 8 | 1575 | 21 | 700 200 700
Open Links | 12 | B 8 | 1 | 64 | 64 | 875 | 47 | 270 90

This schedule conforms to BS 8666:2005
* Specified in multiples of 5mm. | † Specified in multiples of 25mm.

19-Jul-18
Horseshoe Lane Chadlington

CHB_7011

## Consult h-b Ltd
