DanielBryars/ChadHouse/2D/Edge Detail 1.png

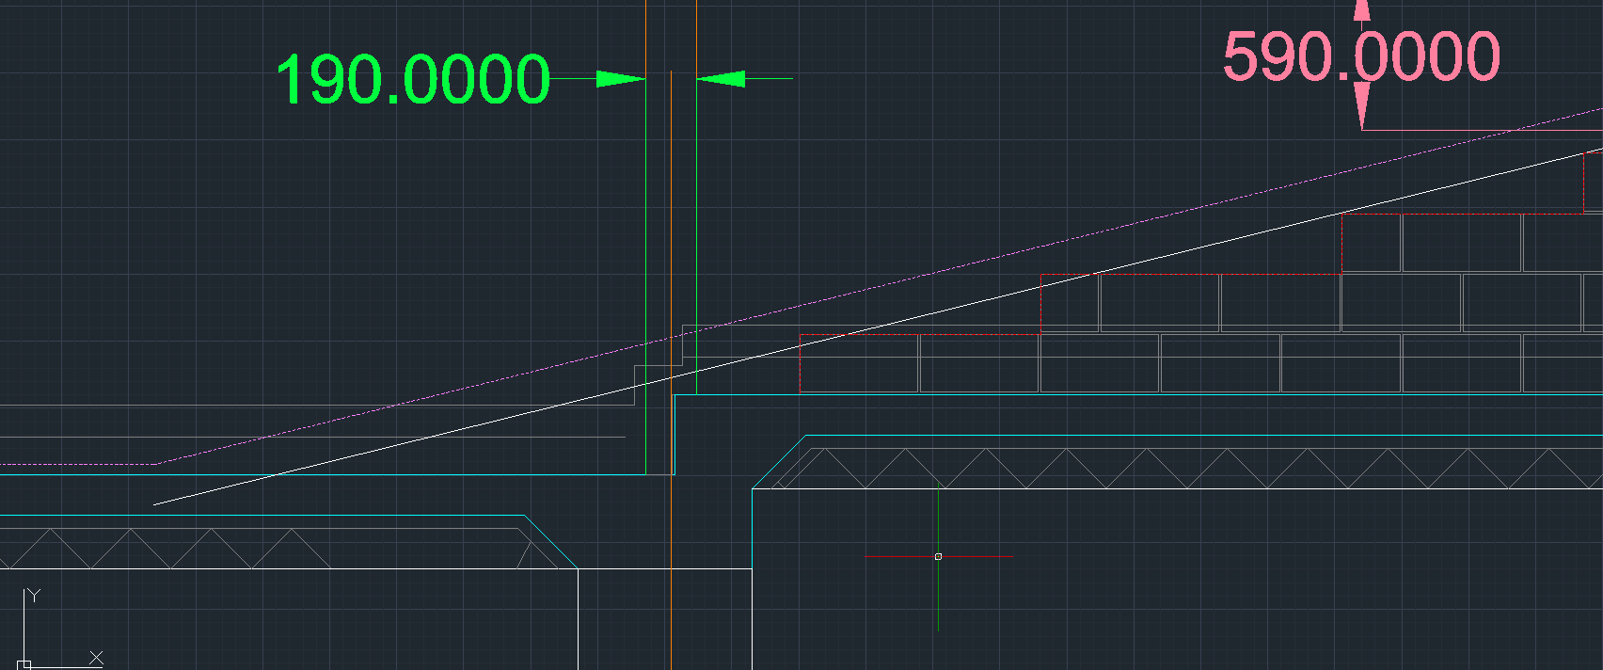
2D/Edge Detail 1.png
