DanielBryars/ChadHouse/2D/Edge Detail 2.png

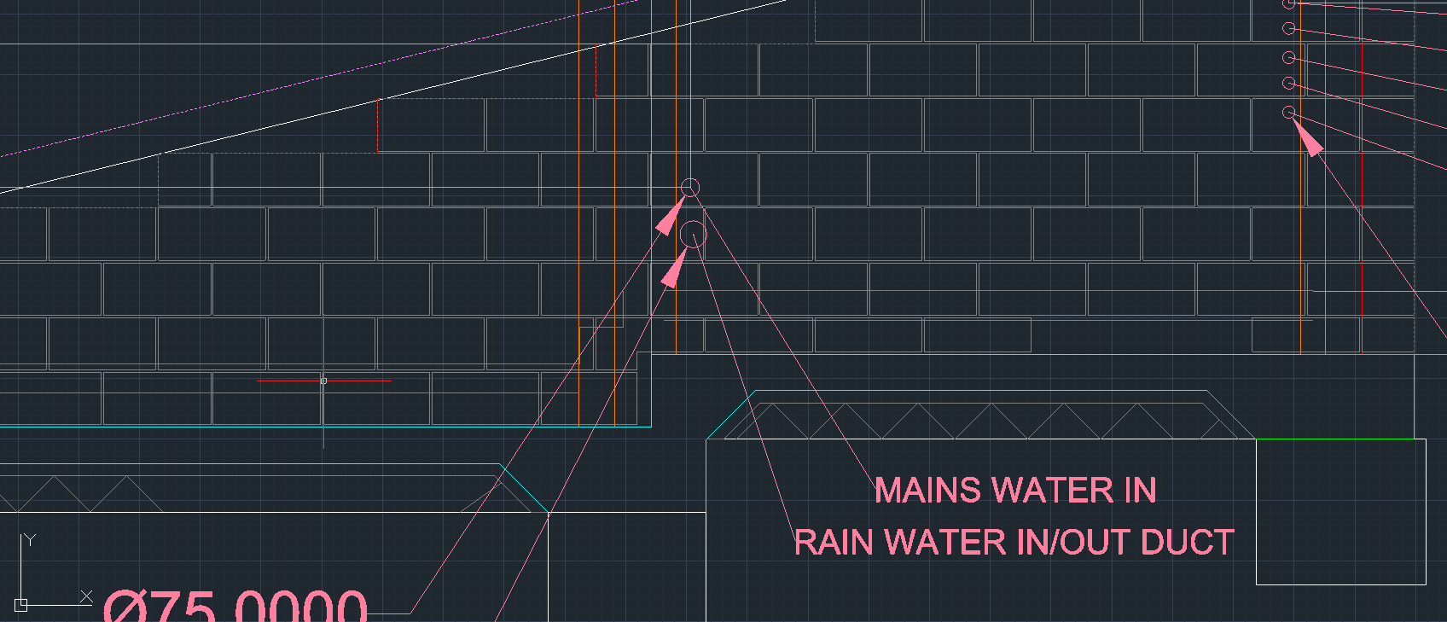
2D/Edge Detail 2.png
