DanielBryars/ChadHouse/2D/General Arrangement/pdf/ActualSizes.png

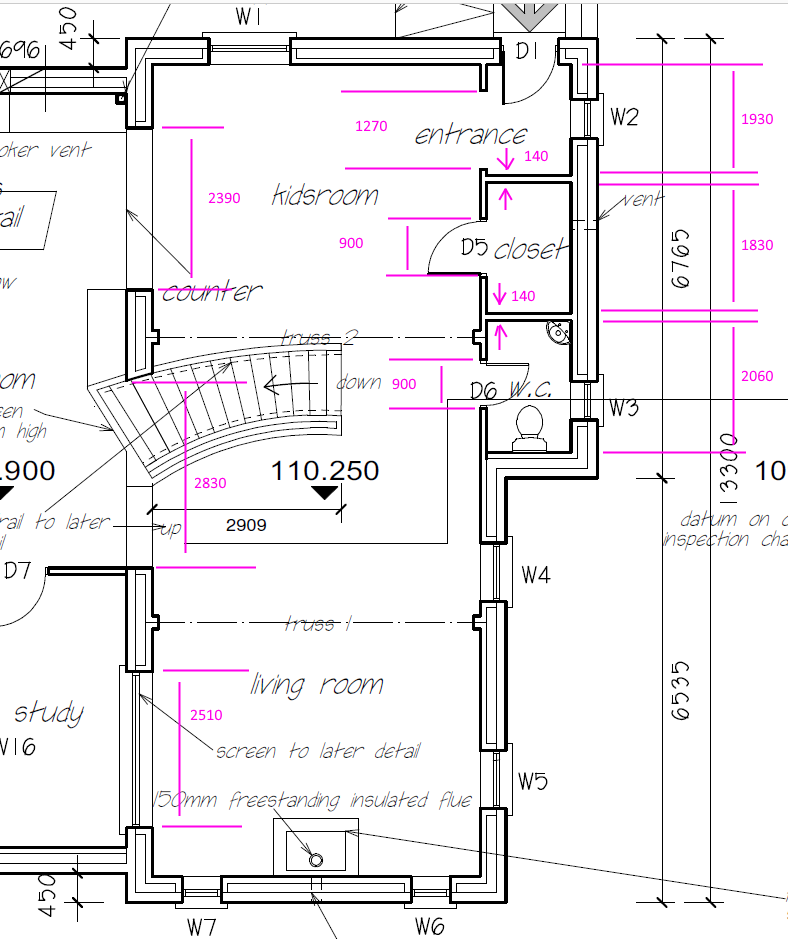
2D/General Arrangement/pdf/ActualSizes.png
