DanielBryars/ChadHouse/2D/HouseAngle/House Angle.png

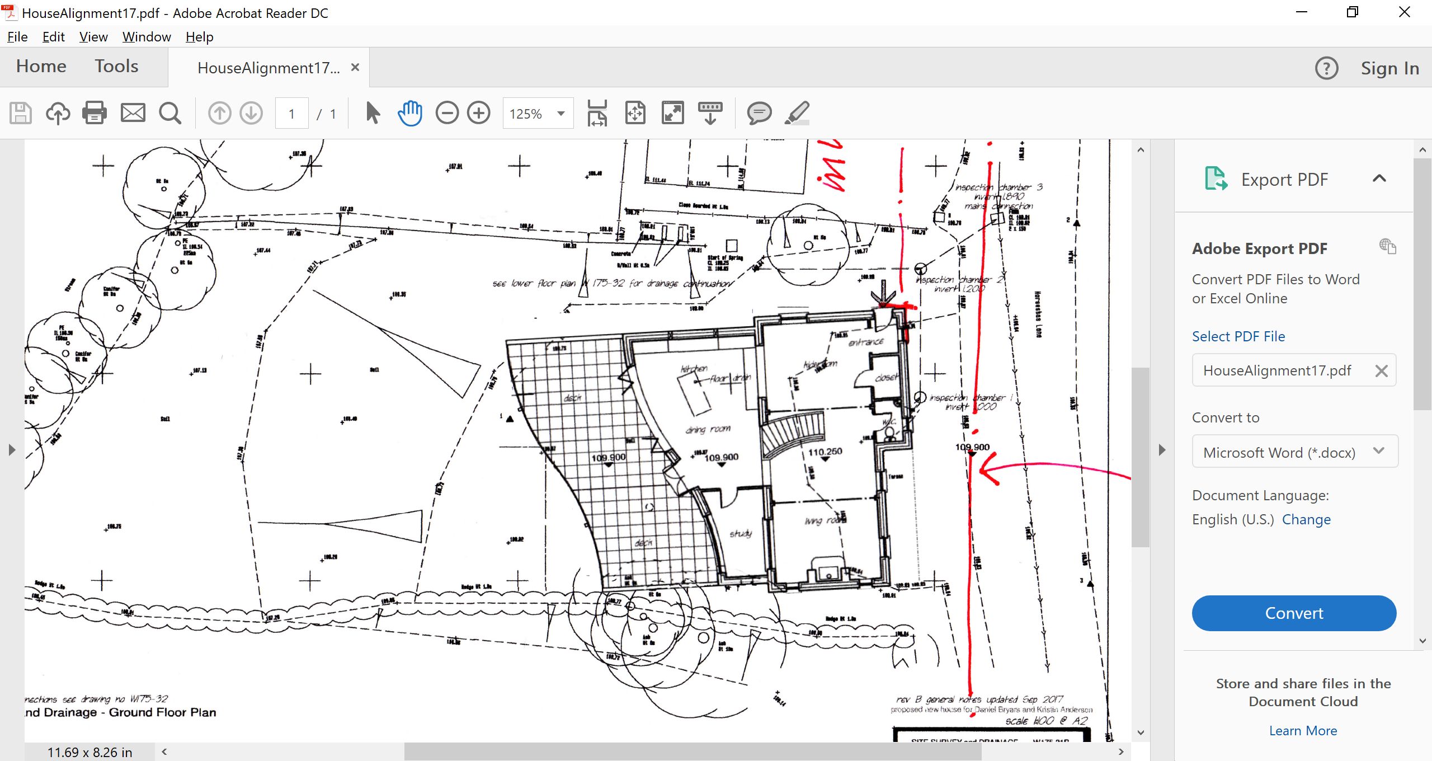
2D/HouseAngle/House Angle.png
