DanielBryars/ChadHouse/2D/RoofPanel/Beam Layout Roof Light.png

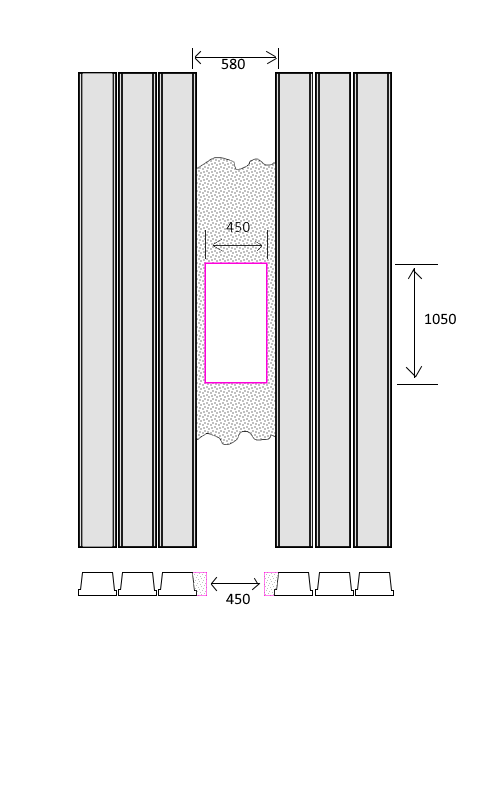
2D/RoofPanel/Beam Layout Roof Light.png
