DanielBryars/ChadHouse/2D/RoofPanel/Idea.png

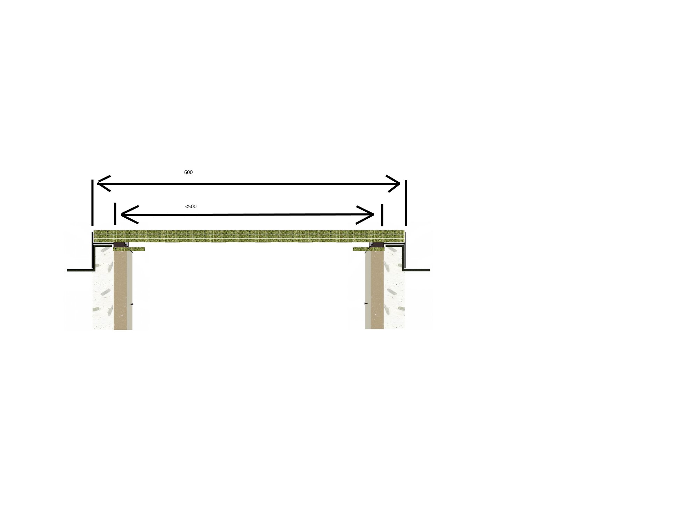
2D/RoofPanel/Idea.png
