DanielBryars/ChadHouse/2D/RoofPanel/RoofLightTopView.png

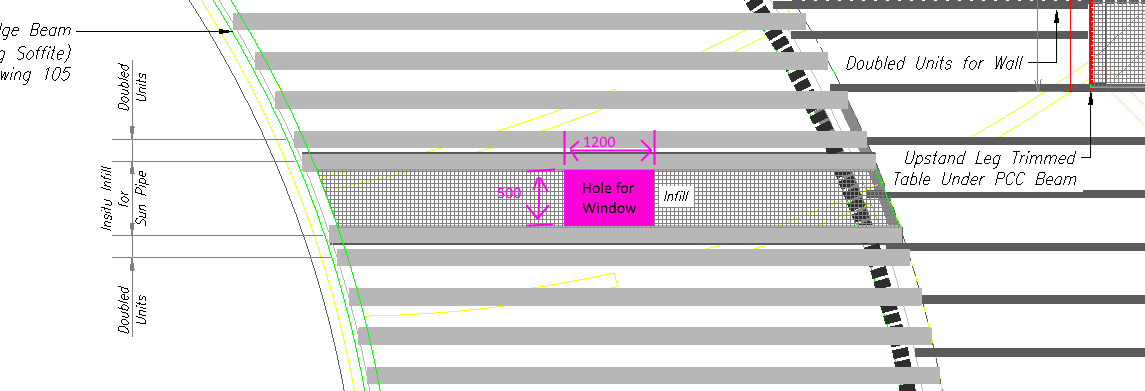
2D/RoofPanel/RoofLightTopView.png
