DanielBryars/ChadHouse/2D/RoofPanel/Sketch.jpg

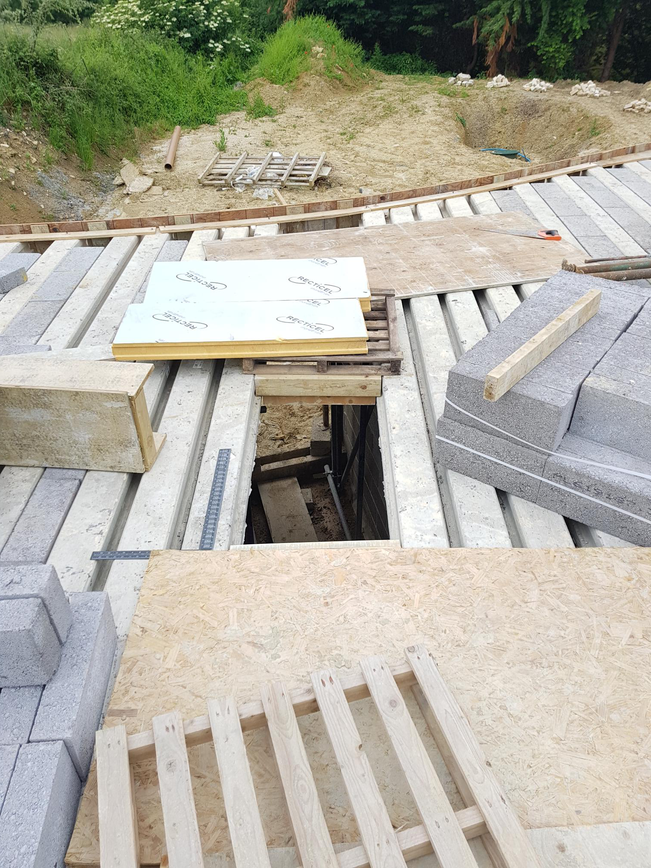
2D/RoofPanel/Sketch.jpg
