DanielBryars/ChadHouse/2D/RoofPanel/Top View Dimensions.png

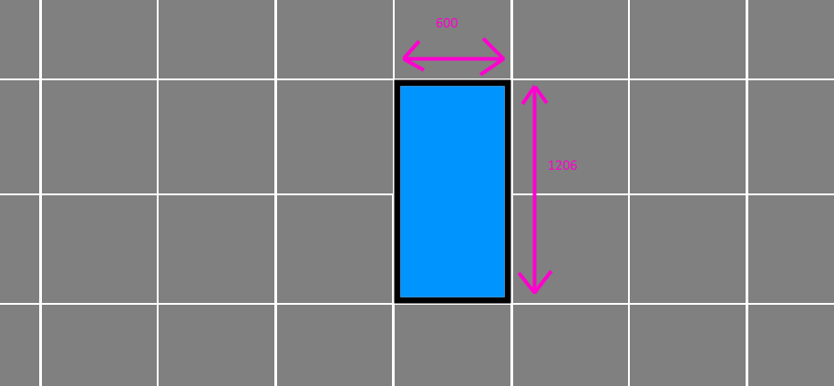
2D/RoofPanel/Top View Dimensions.png
