DanielBryars/ChadHouse/2D/Structural/7011 022p4 annotated.png

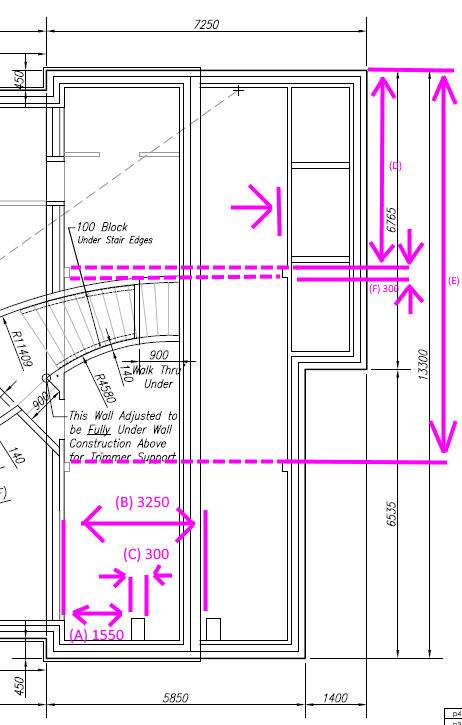
2D/Structural/7011 022p4 annotated.png
