DanielBryars/ChadHouse/2D/Structural/7011 D-04 p1 annotated 2.png

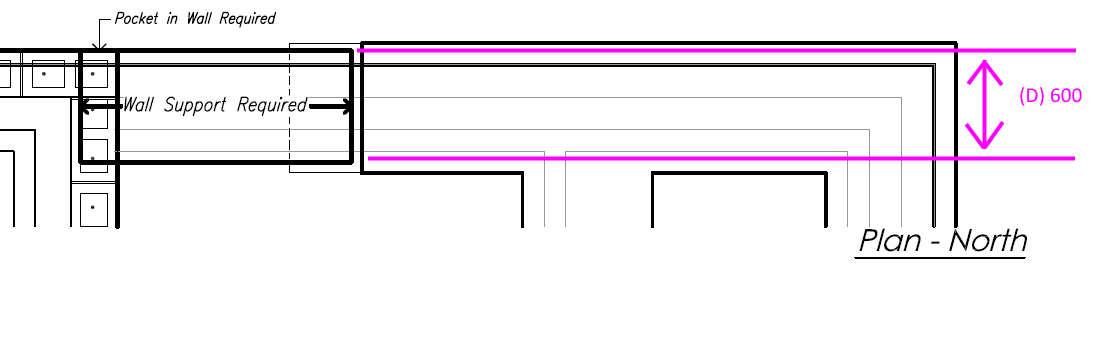
2D/Structural/7011 D-04 p1 annotated 2.png
