DanielBryars/ChadHouse/2D/Structural/7011 D-04 p1 annotated.png

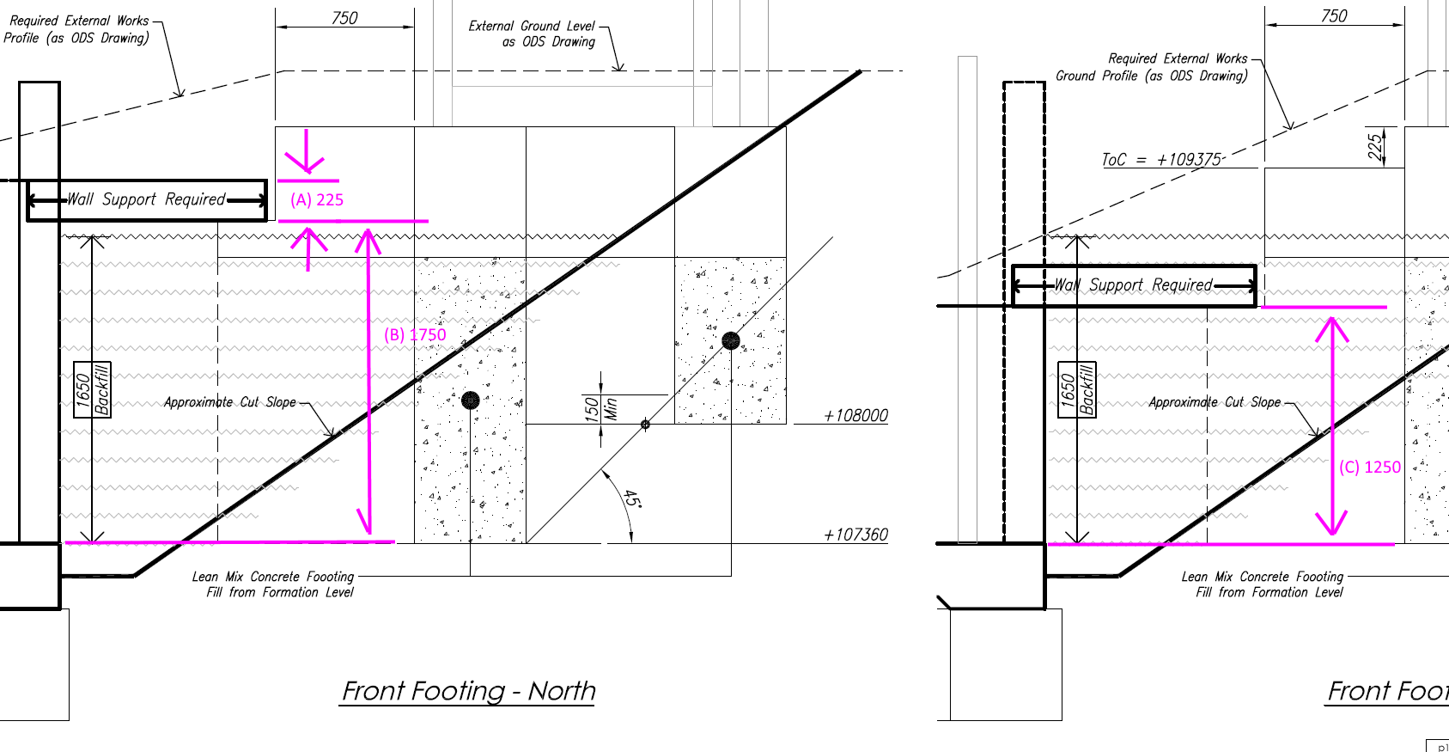
2D/Structural/7011 D-04 p1 annotated.png
