DanielBryars/ChadHouse/2D/Structural/CavityDetails.png

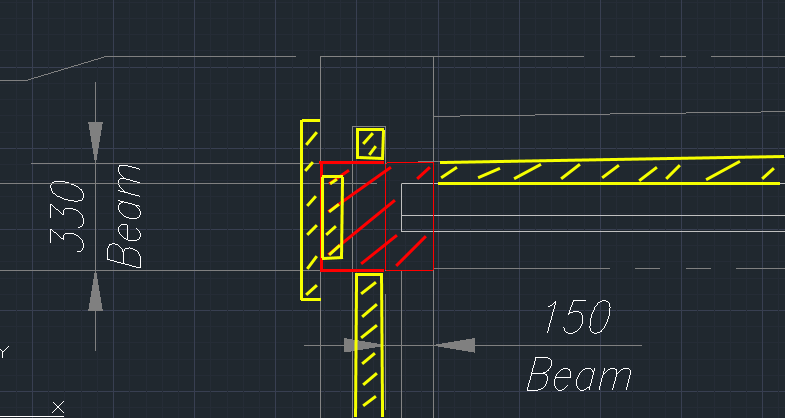
2D/Structural/CavityDetails.png
