DanielBryars/ChadHouse/2D/Structural/Screenshot_2017-12-04-07-24-40.jpg

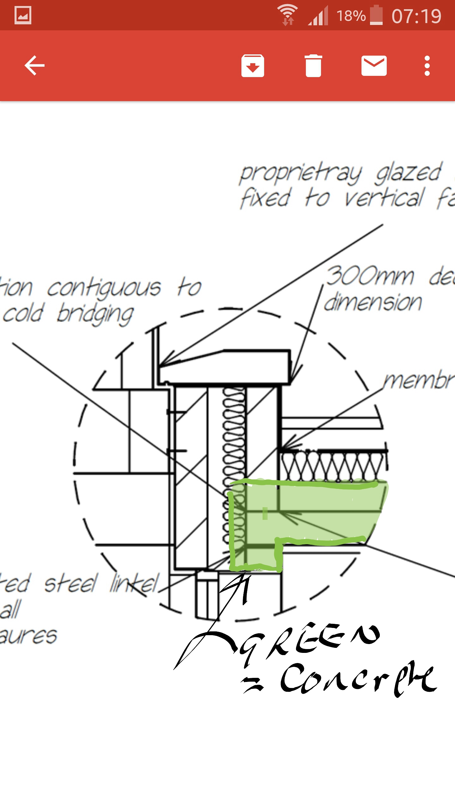
2D/Structural/Screenshot_2017-12-04-07-24-40.jpg
