DanielBryars/ChadHouse/2D/Structural/Screenshot_2017-12-04-07-26-30.png

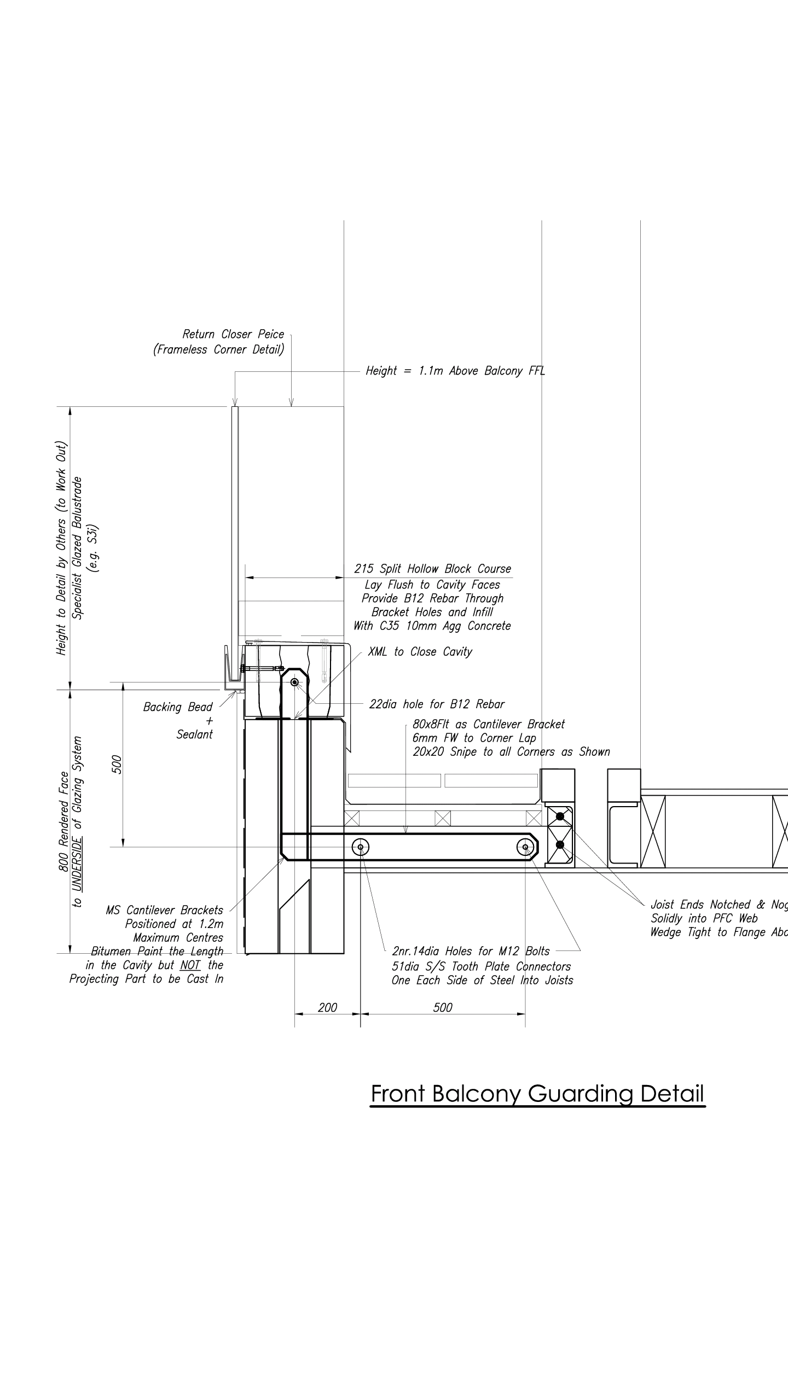
2D/Structural/Screenshot_2017-12-04-07-26-30.png
