DanielBryars/ChadHouse/ChadHouseView.png

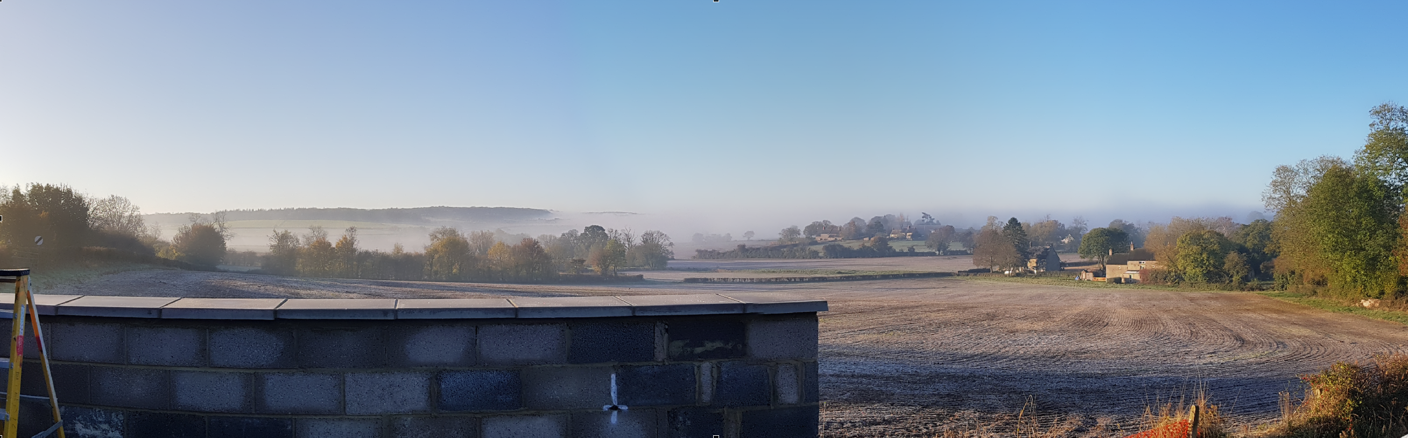
ChadHouseView.png
