DanielBryars/ChadHouse/Electrical/BathroomMain.PNG

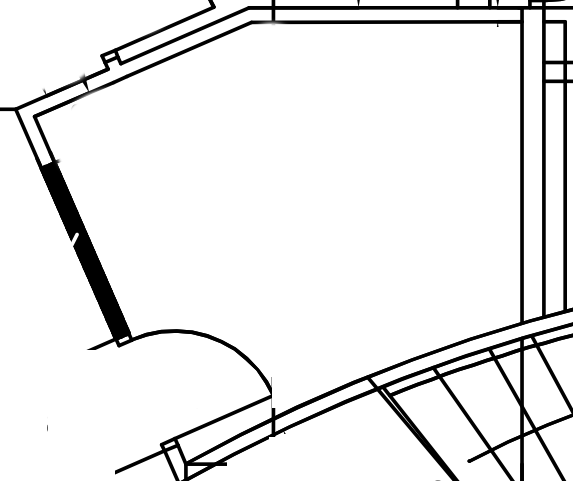
Electrical/BathroomMain.PNG
