DanielBryars/ChadHouse/Electrical/Bed1.PNG

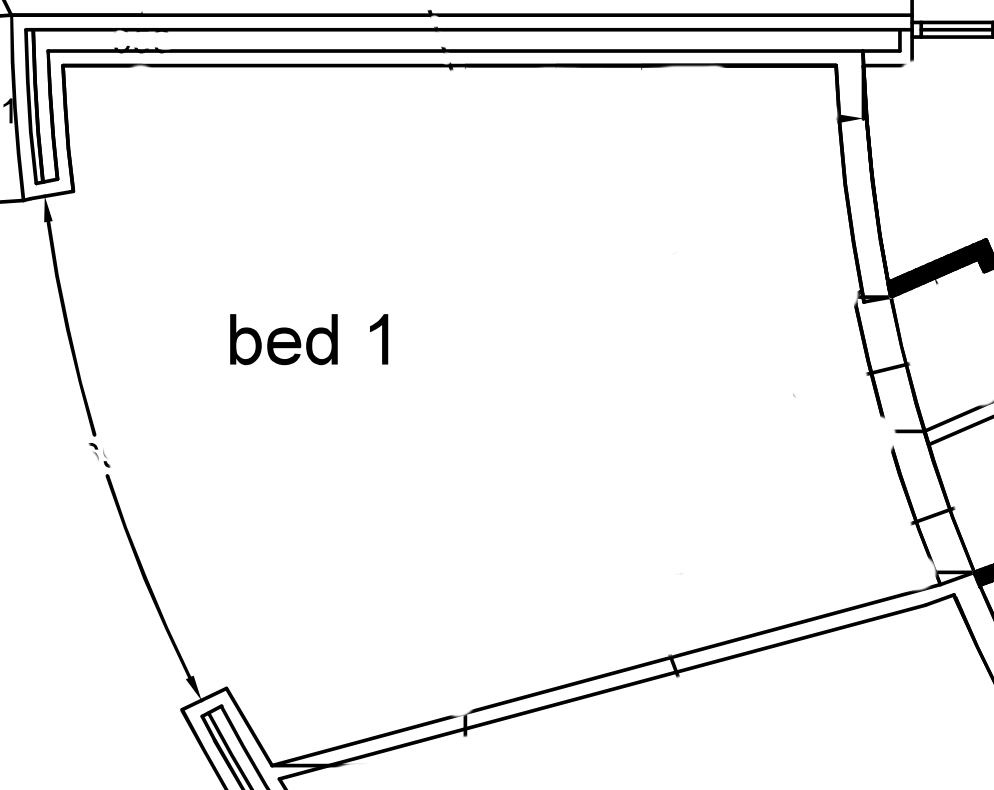
Electrical/Bed1.PNG
