DanielBryars/ChadHouse/Electrical/Bed2.PNG

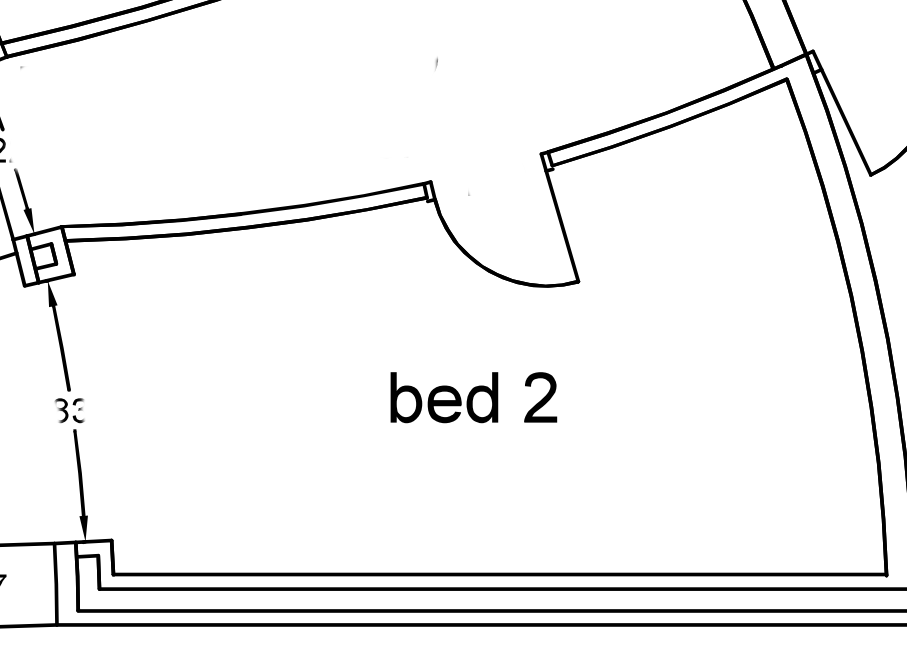
Electrical/Bed2.PNG
