DanielBryars/ChadHouse/Electrical/Bed3.PNG

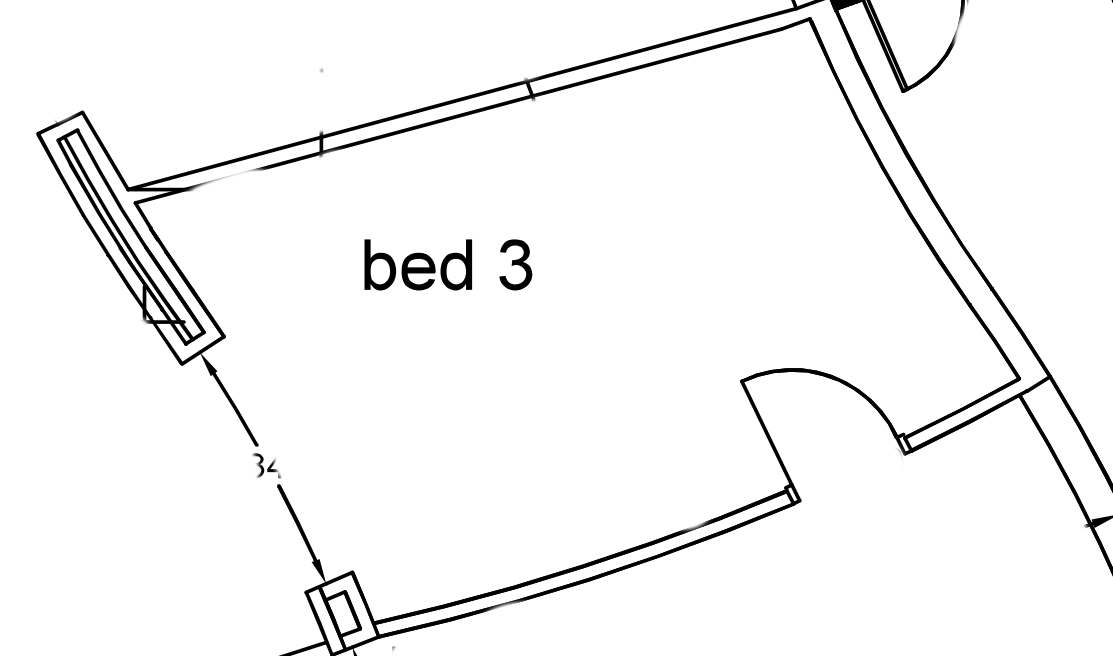
Electrical/Bed3.PNG
