DanielBryars/ChadHouse/Electrical/Bed4.PNG

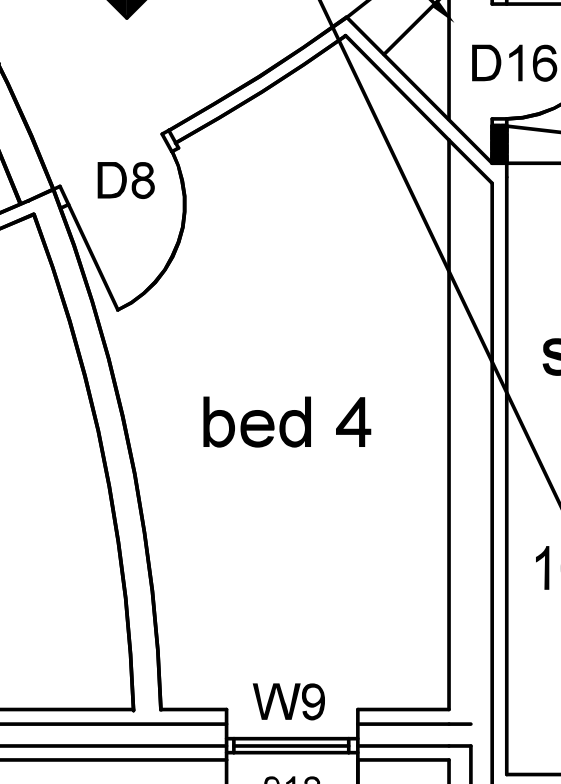
Electrical/Bed4.PNG
