DanielBryars/ChadHouse/Electrical/Ensuite.PNG

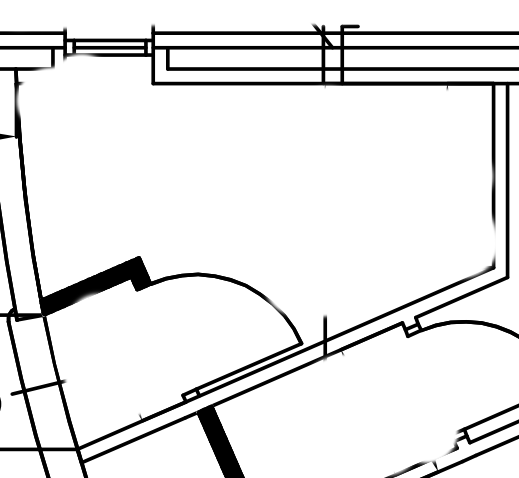
Electrical/Ensuite.PNG
