DanielBryars/ChadHouse/Electrical/HallwayCentre.PNG

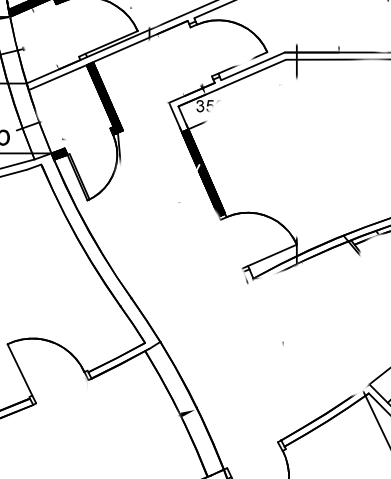
Electrical/HallwayCentre.PNG
