DanielBryars/ChadHouse/Electrical/HallwayWest.PNG

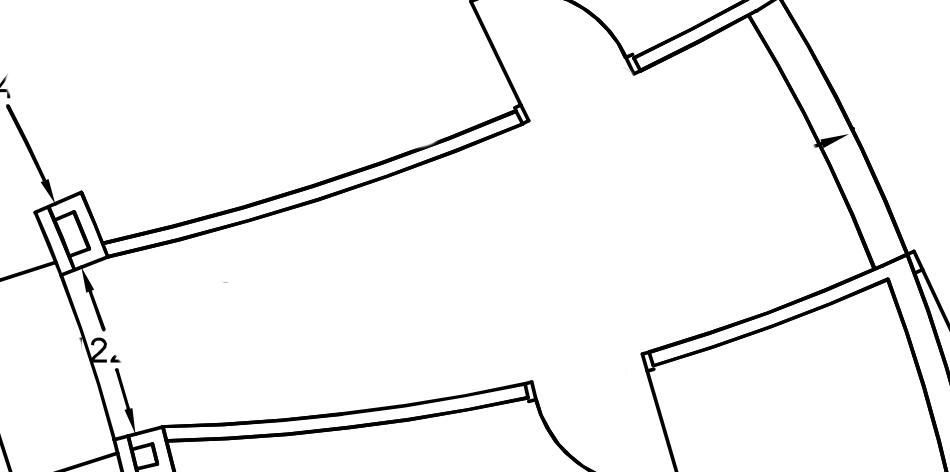
Electrical/HallwayWest.PNG
