DanielBryars/ChadHouse/Electrical/Utility.PNG

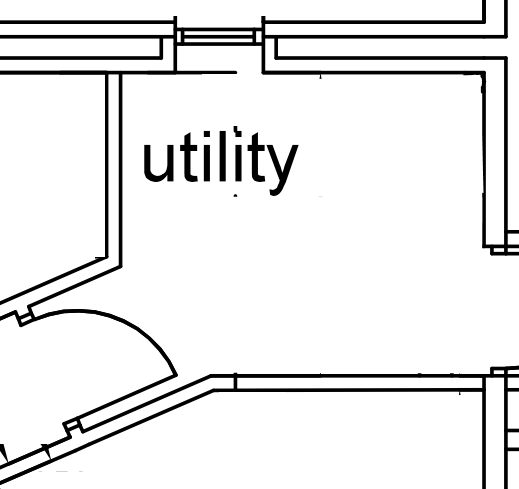
Electrical/Utility.PNG
