DanielBryars/ChadHouse/Electrical/WorkshopStorage.PNG

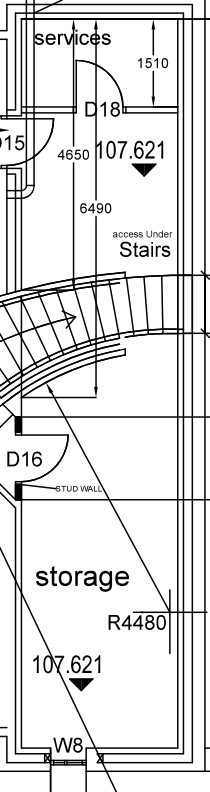
Electrical/WorkshopStorage.PNG
