DanielBryars/ChadHouse/Kitchen/BuiltInMonitor/Hb98b7226760440ba9224da1dfd856340N.png_.webp

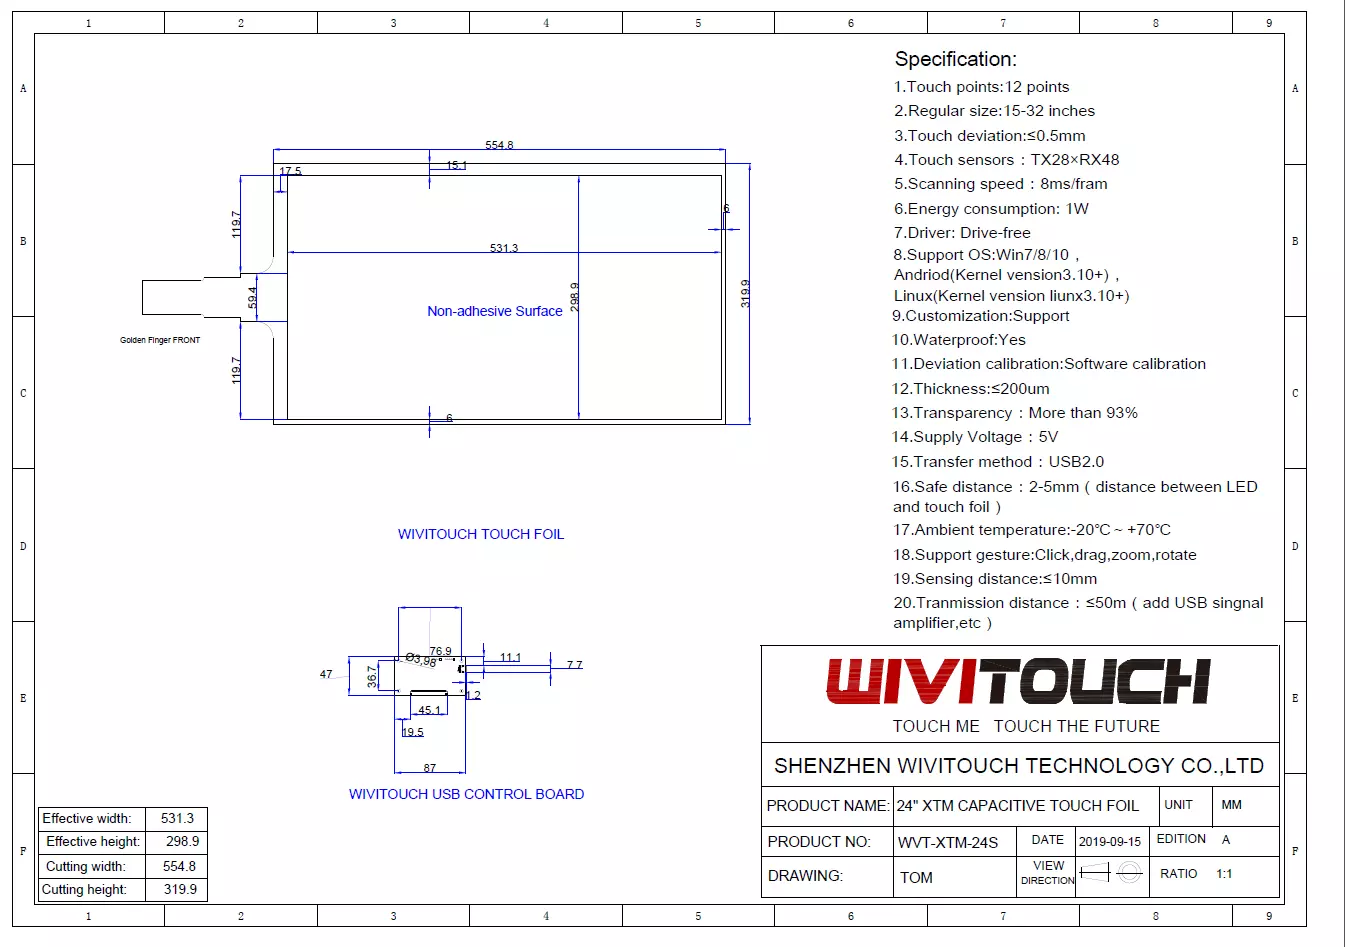
Kitchen/BuiltInMonitor/Hb98b7226760440ba9224da1dfd856340N.png_.webp
