DanielBryars/ChadHouse/Kitchen/Cool Table.jpg

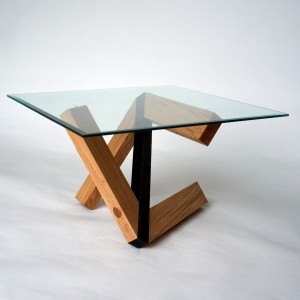
Kitchen/Cool Table.jpg
