DanielBryars/ChadHouse/Kitchen/Kitchen Island Mould Base Bottom Only.jpg

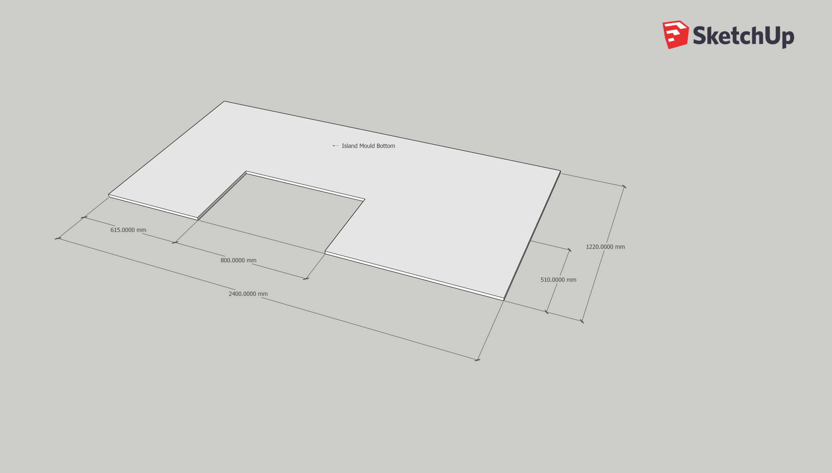
Kitchen/Kitchen Island Mould Base Bottom Only.jpg
