DanielBryars/ChadHouse/Kitchen/Kitchen Island Mould Base.jpg

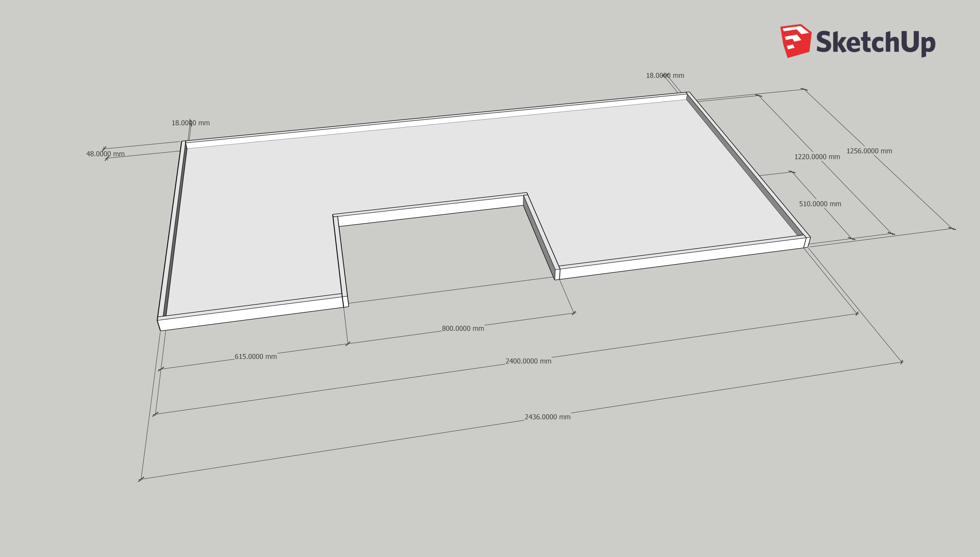
Kitchen/Kitchen Island Mould Base.jpg
