DanielBryars/ChadHouse/Kitchen/Kitchen Island Mould.jpg

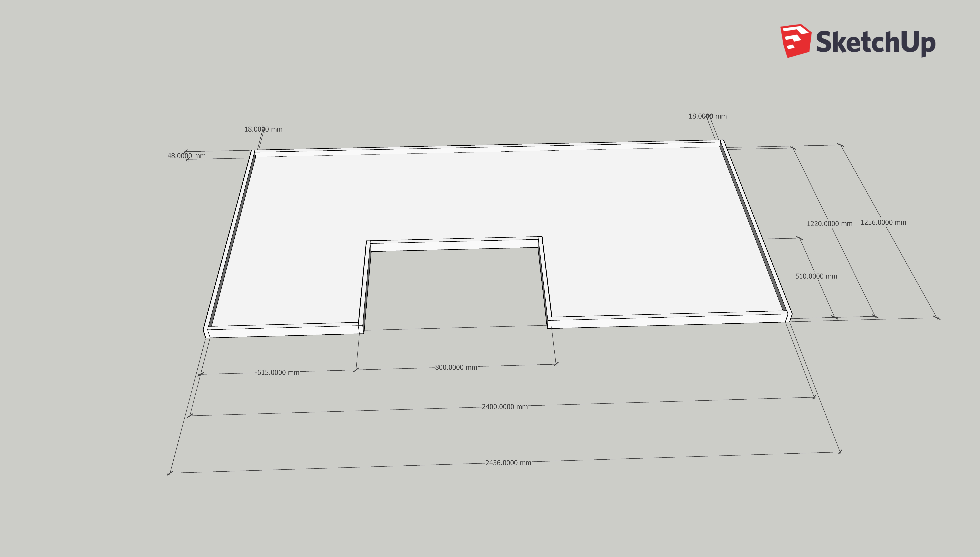
Kitchen/Kitchen Island Mould.jpg
