DanielBryars/ChadHouse/Kitchen/Kitchen Sideboard Mould .jpg

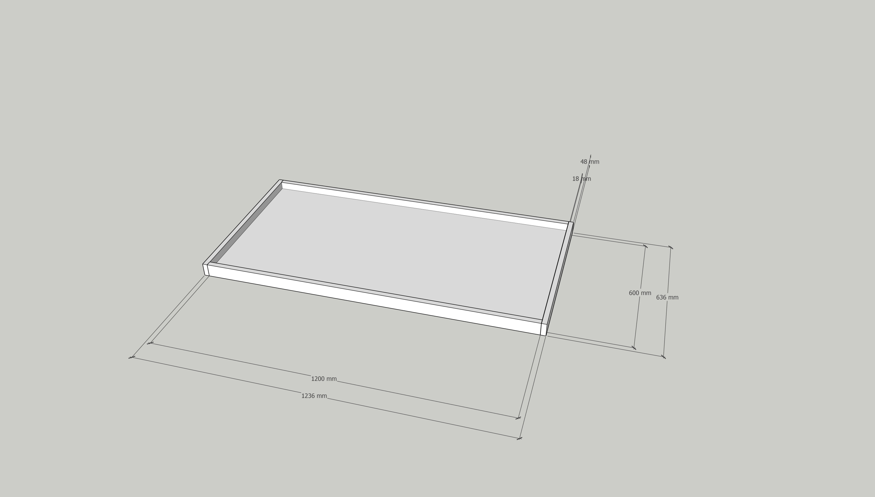
Kitchen/Kitchen Sideboard Mould .jpg
