DanielBryars/ChadHouse/Planning/15_03680_FUL-AMENDED_PLANS-374969 - Minor Amendment.jpg

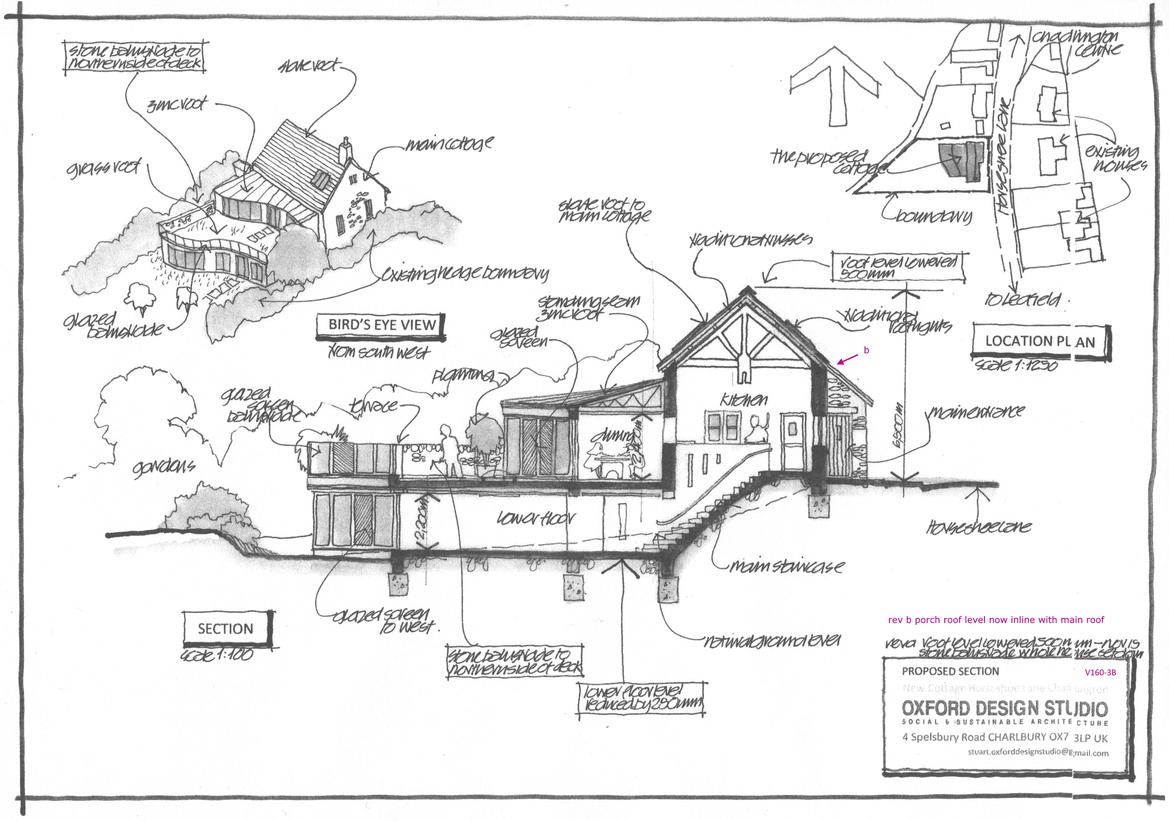
Planning/15_03680_FUL-AMENDED_PLANS-374969 - Minor Amendment.jpg
