DanielBryars/ChadHouse/Planning/DSC_1101.JPG

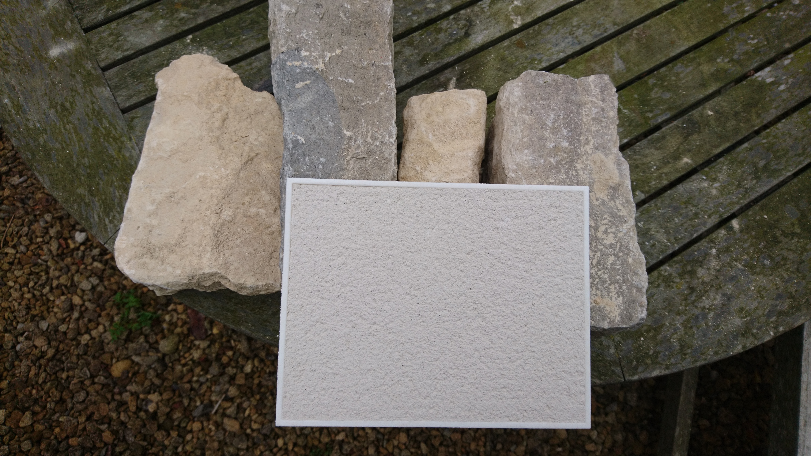
Planning/DSC_1101.JPG
