DanielBryars/ChadHouse/Planning/DSC_1102.JPG

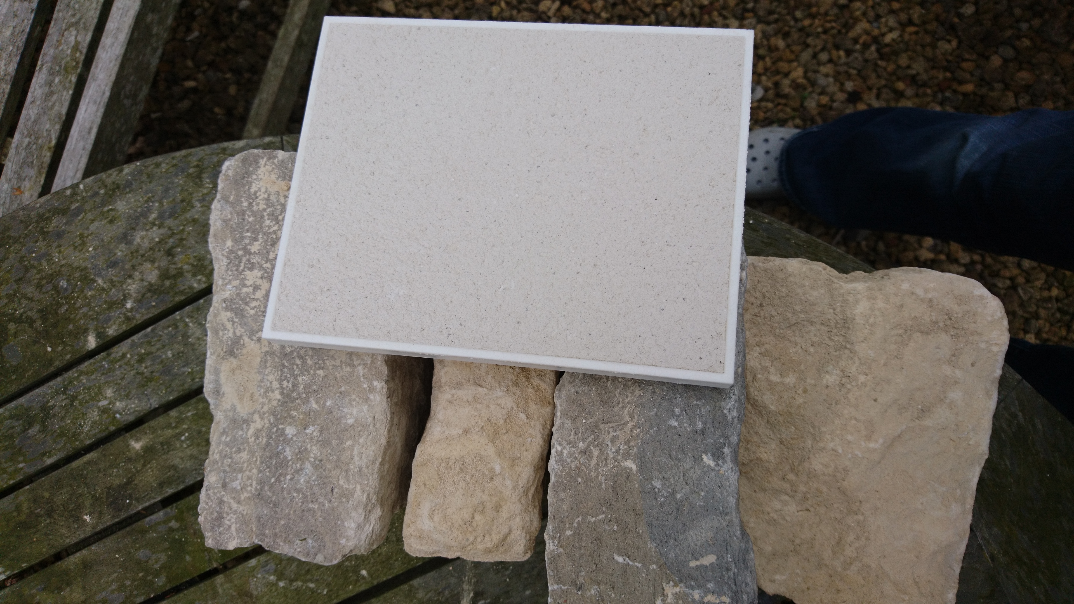
Planning/DSC_1102.JPG
