DanielBryars/ChadHouse/Planning/DSC_1103.JPG

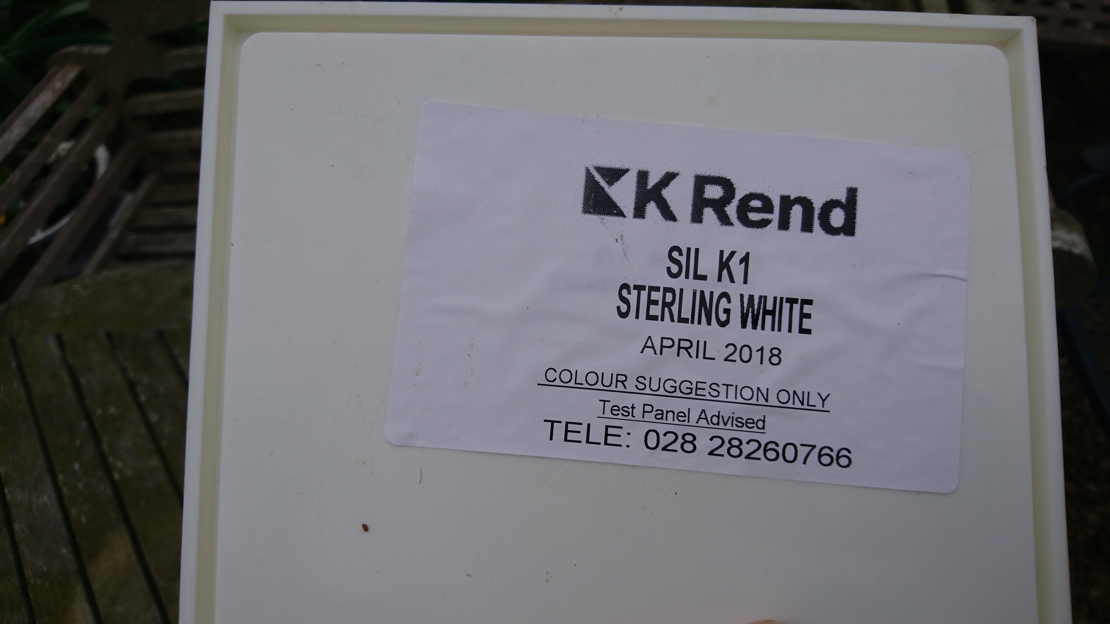
Planning/DSC_1103.JPG
