DanielBryars/ChadHouse/Render/house-transparent-final.jpg

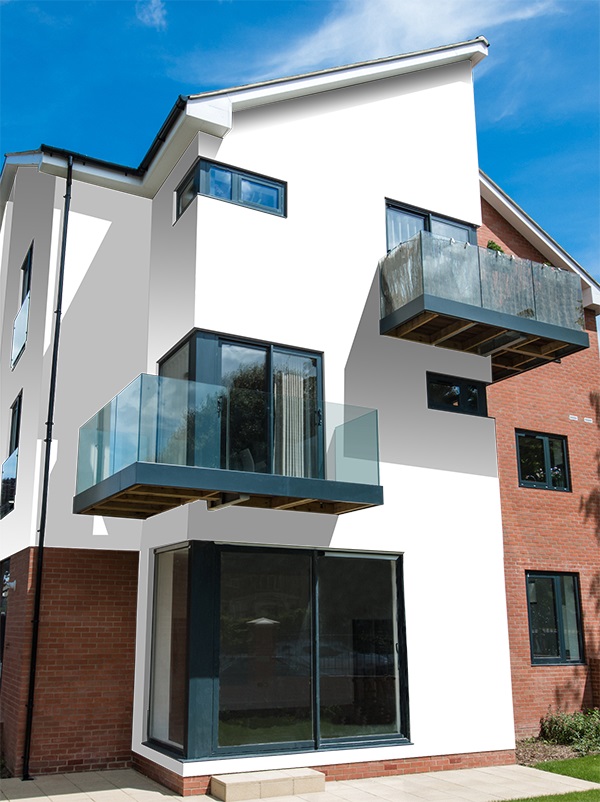
Render/house-transparent-final.jpg
