DanielBryars/ChadHouse/Render/North Elevation Render Dimensions.png

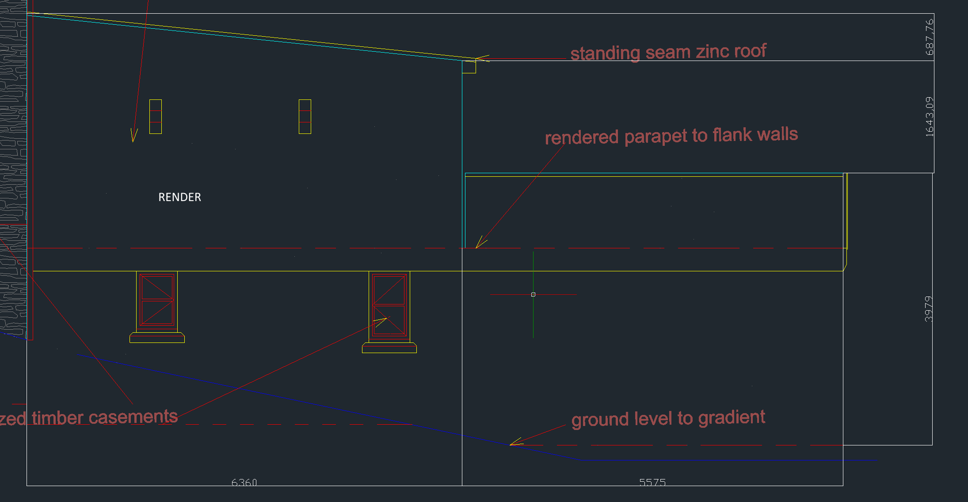
Render/North Elevation Render Dimensions.png
