DanielBryars/ChadHouse/Render/South Elevation Render Dimensions.png

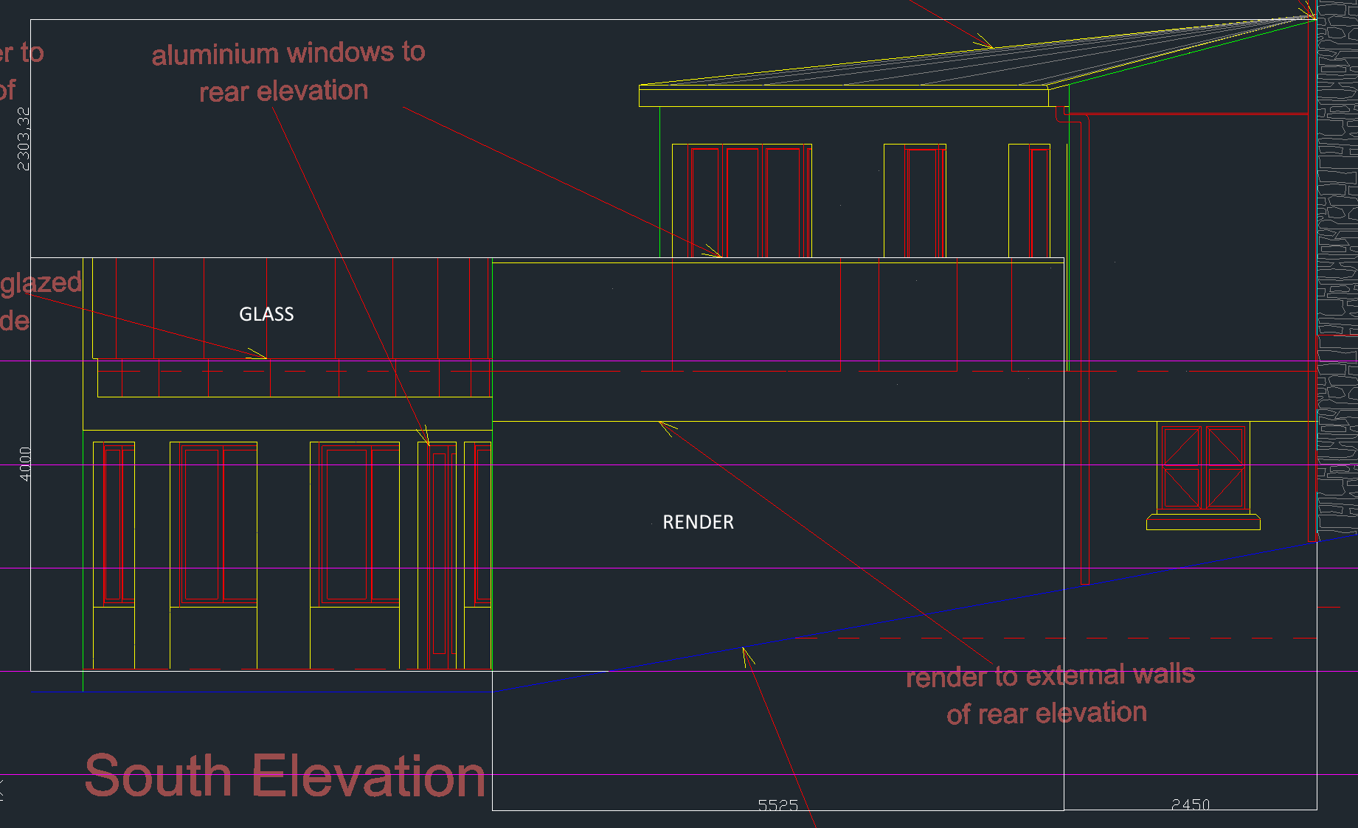
Render/South Elevation Render Dimensions.png
