DanielBryars/ChadHouse/Render/West Elevation Render Dimensions.png

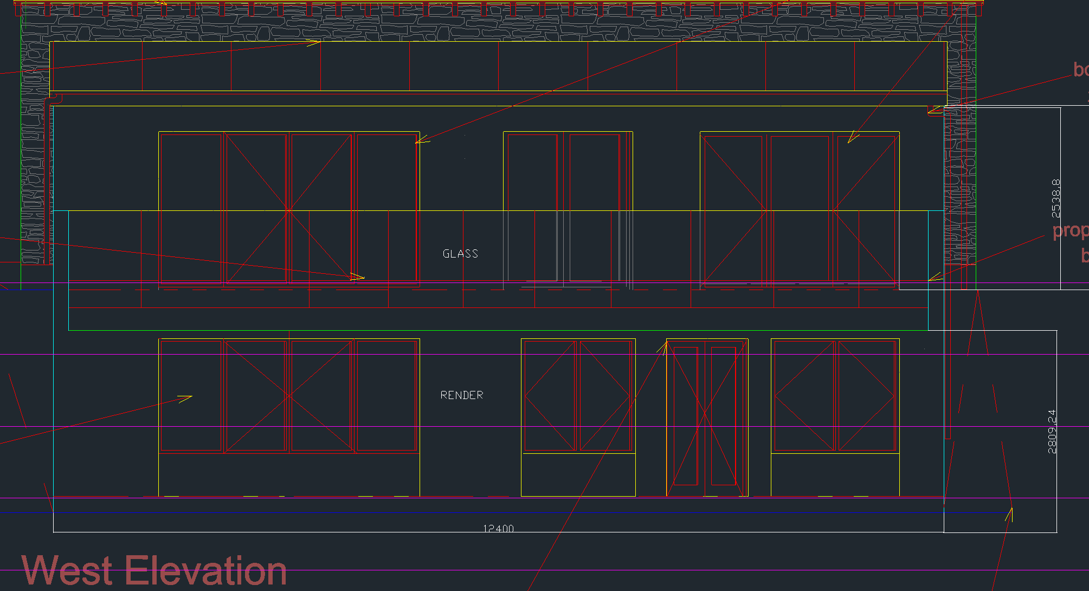
Render/West Elevation Render Dimensions.png
