DanielBryars/ChadHouse/Stairs/Side View.png

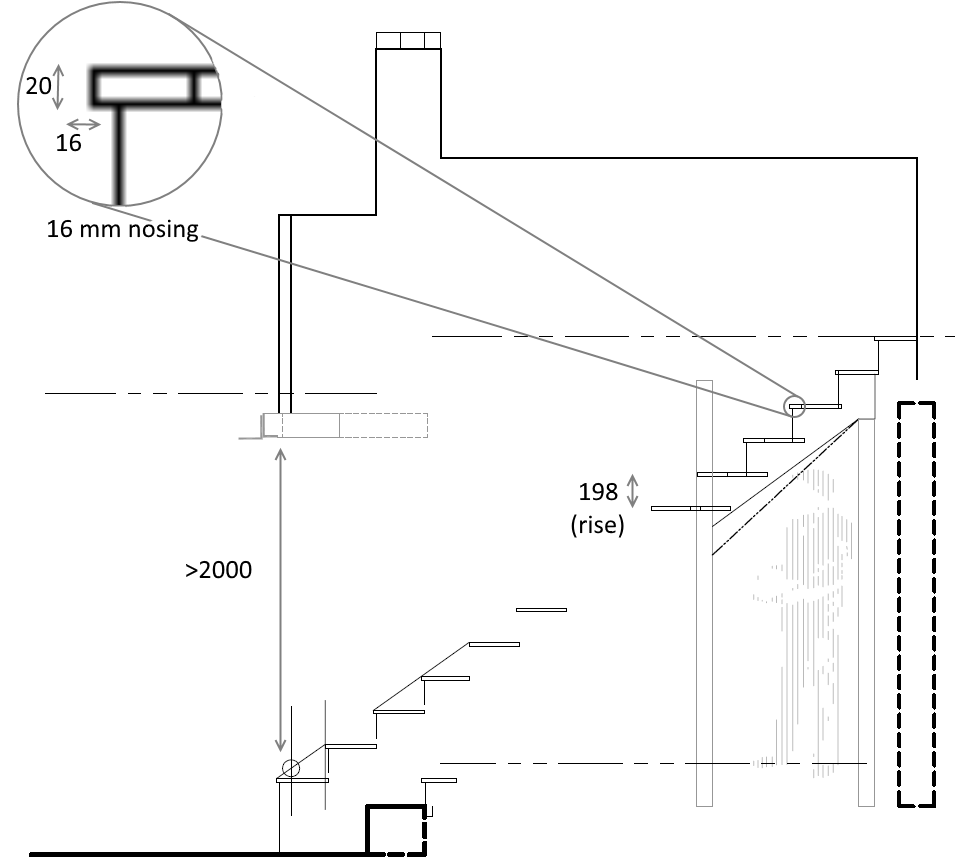
Stairs/Side View.png
