DanielBryars/ChadHouse/Stairs/TopView.png

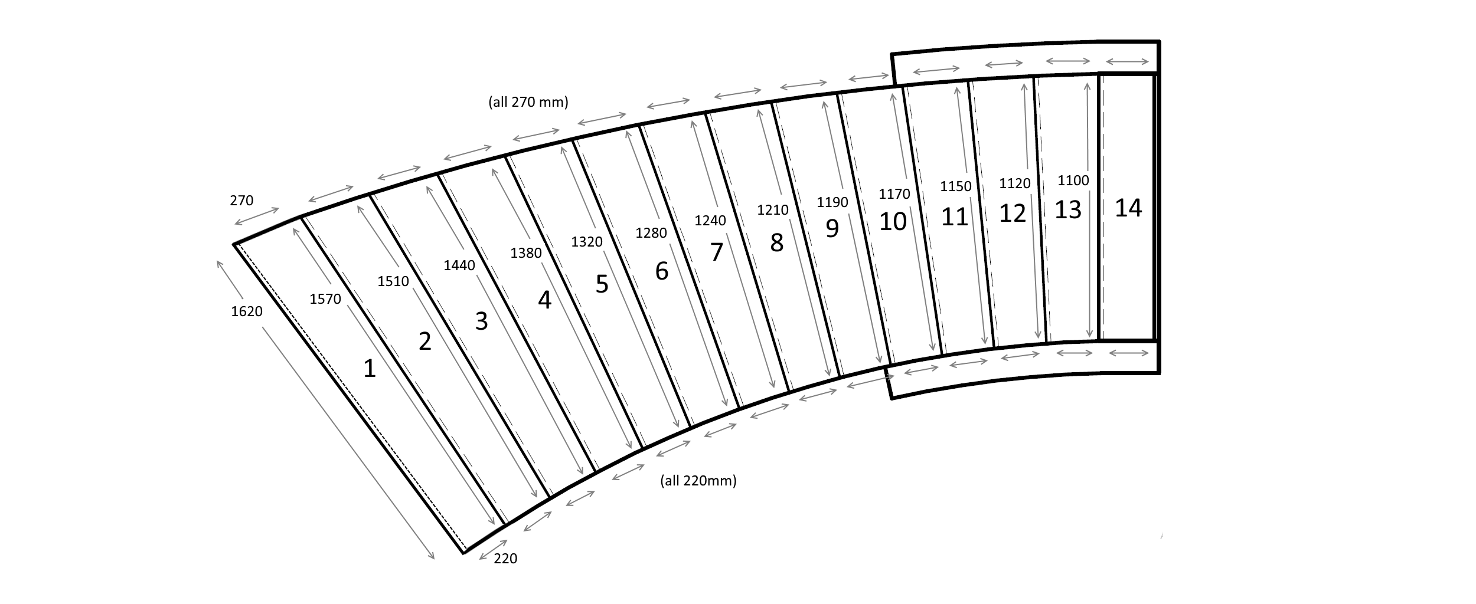
Stairs/TopView.png
