DanielBryars/ChadHouse/Trusses/Truss Design.png

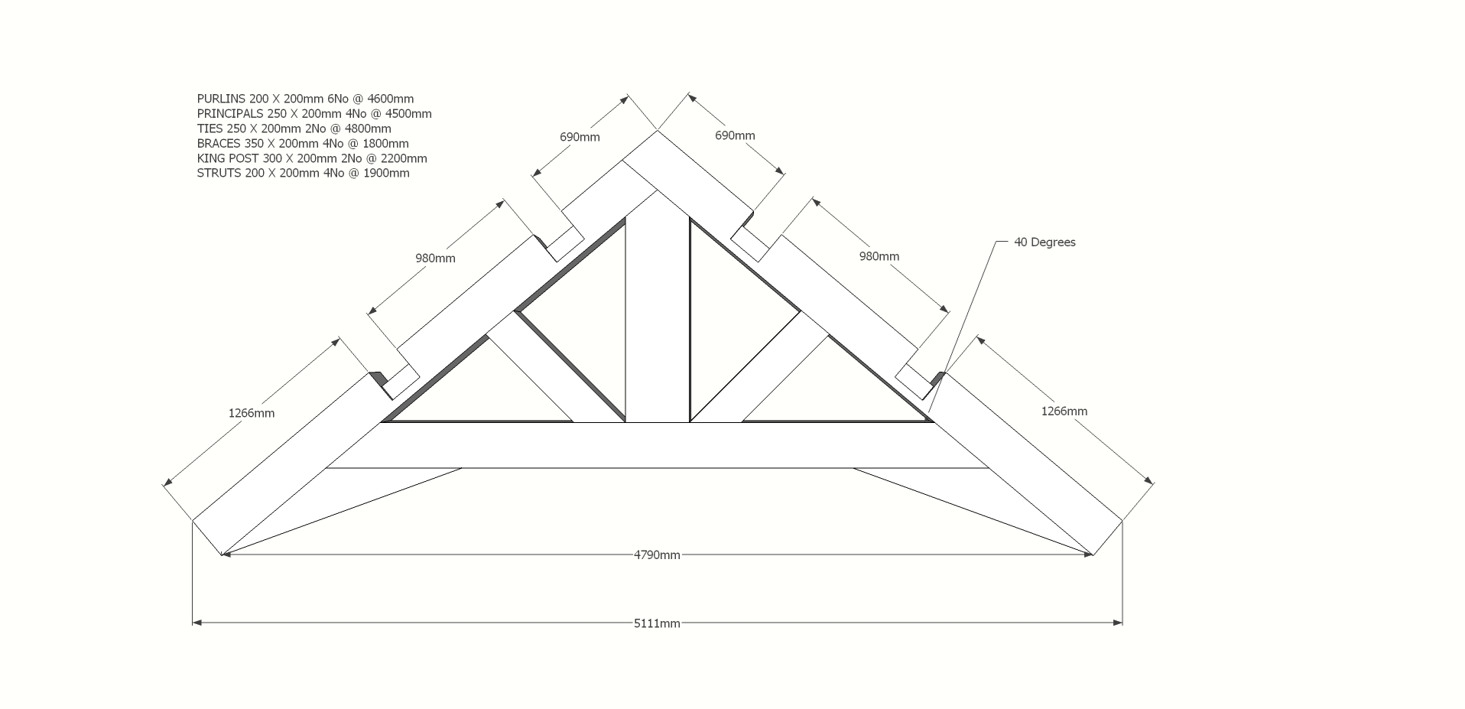
Trusses/Truss Design.png
