DanielBryars/ChadHouse/Underfloor Heating/AppleBrookHouse GF.PNG

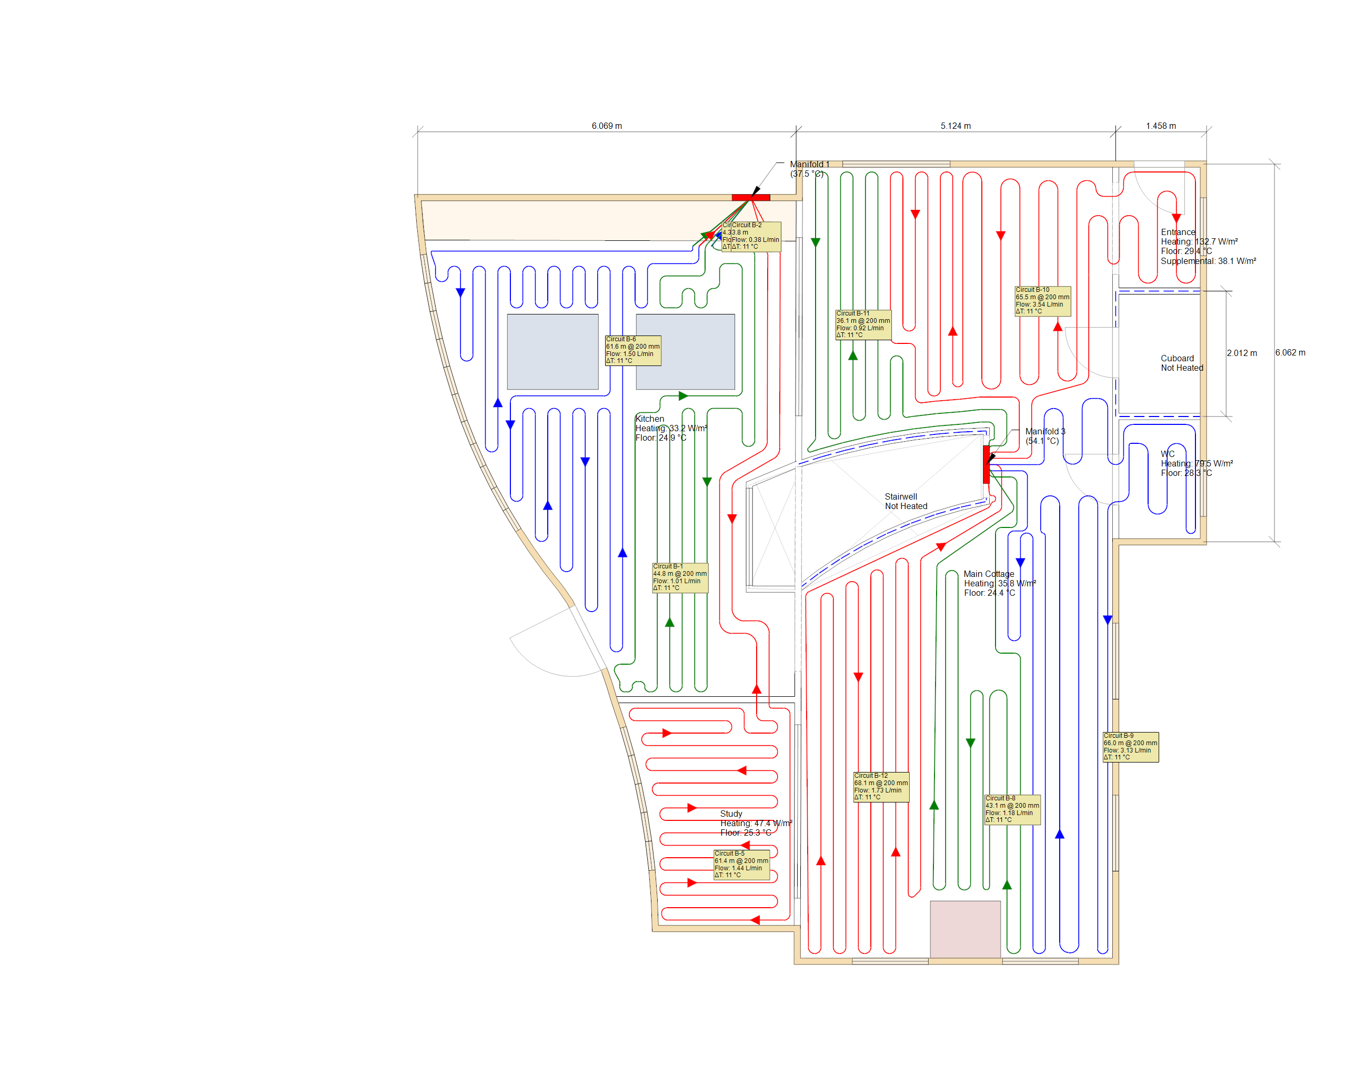
Underfloor Heating/AppleBrookHouse GF.PNG
