DanielBryars/ChadHouse/Underfloor Heating/AppleBrookHouse LGF.PNG

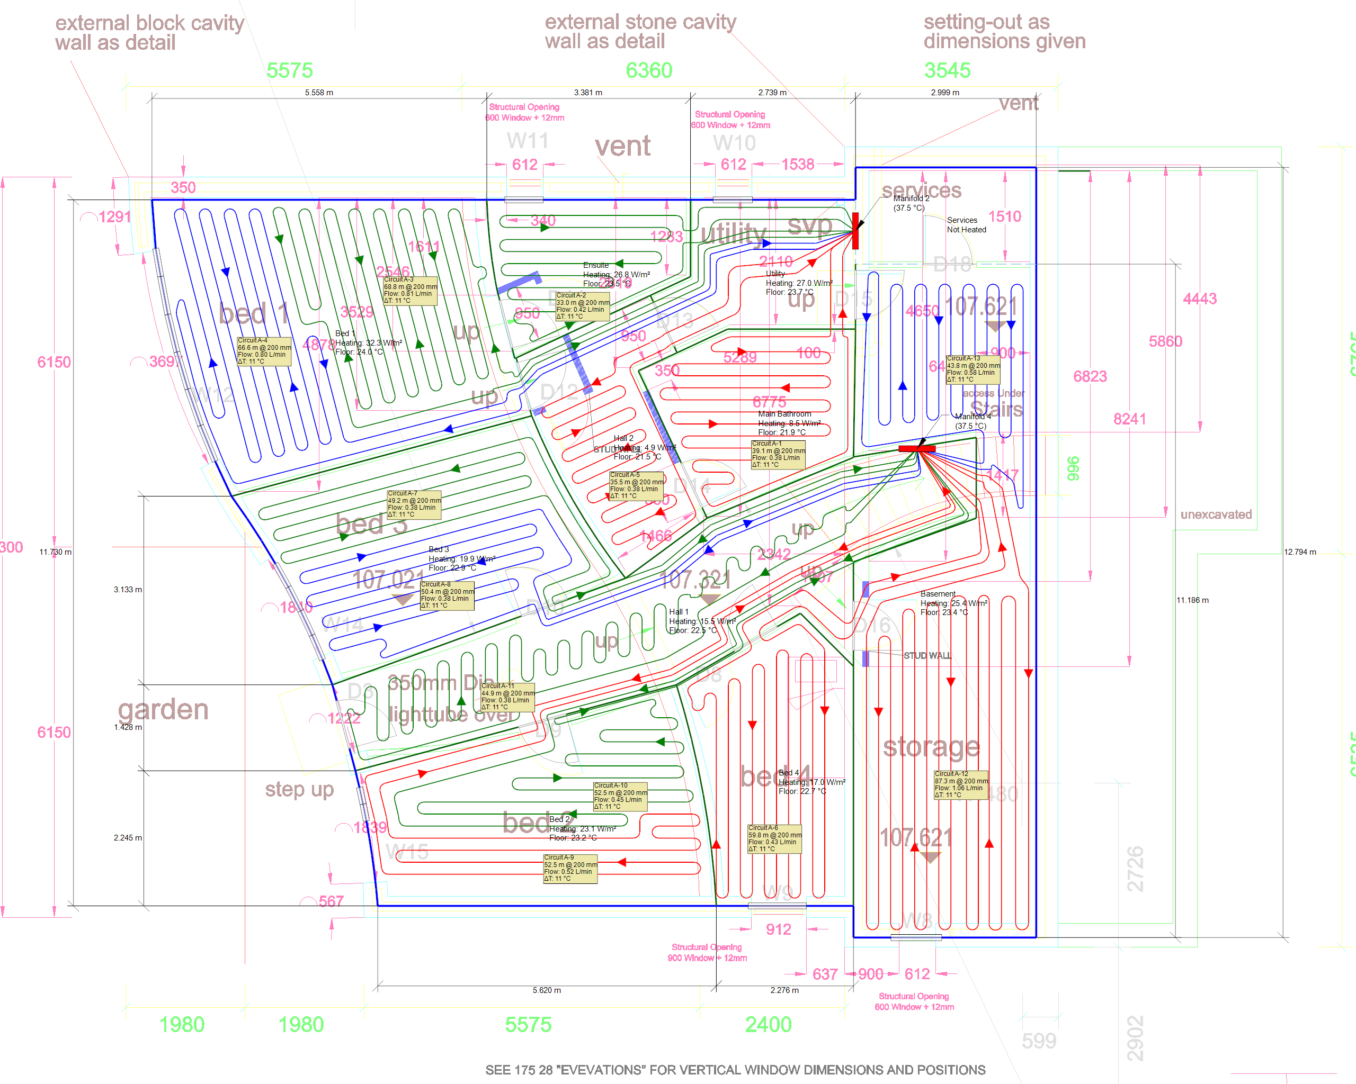
Underfloor Heating/AppleBrookHouse LGF.PNG
