DanielBryars/ChadHouse/Underfloor Heating/AppleBrookHouse-Background1.jpg

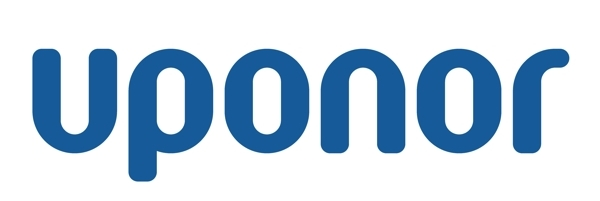
Underfloor Heating/AppleBrookHouse-Background1.jpg
