DanielBryars/ChadHouse/Underfloor Heating/House1.png

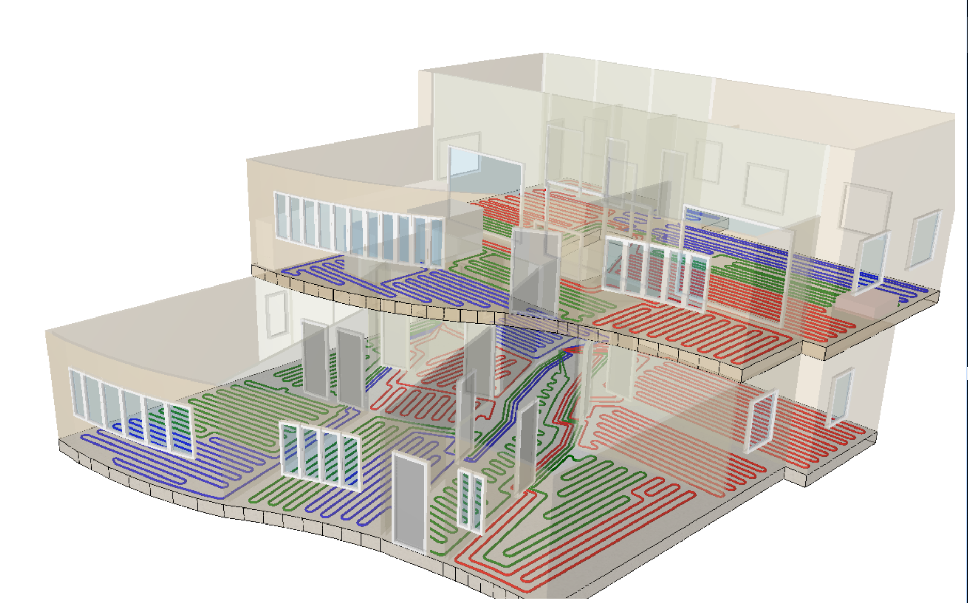
Underfloor Heating/House1.png
