DanielBryars/ChadHouse/Underfloor Heating/House2.png

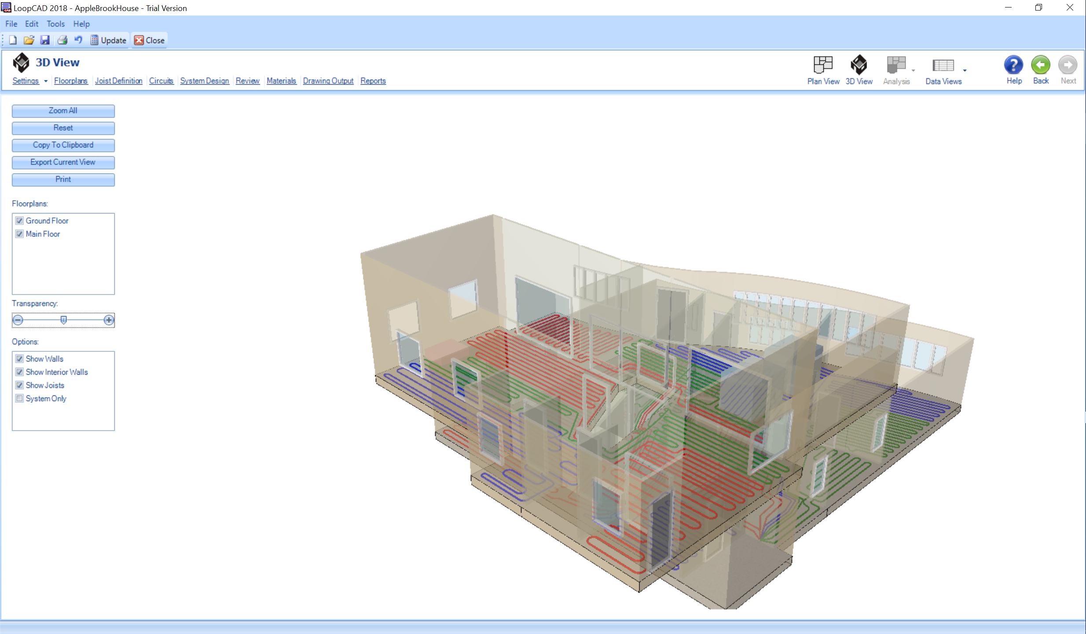
Underfloor Heating/House2.png
