DanielBryars/ChadHouse/Underfloor Heating/House3.png

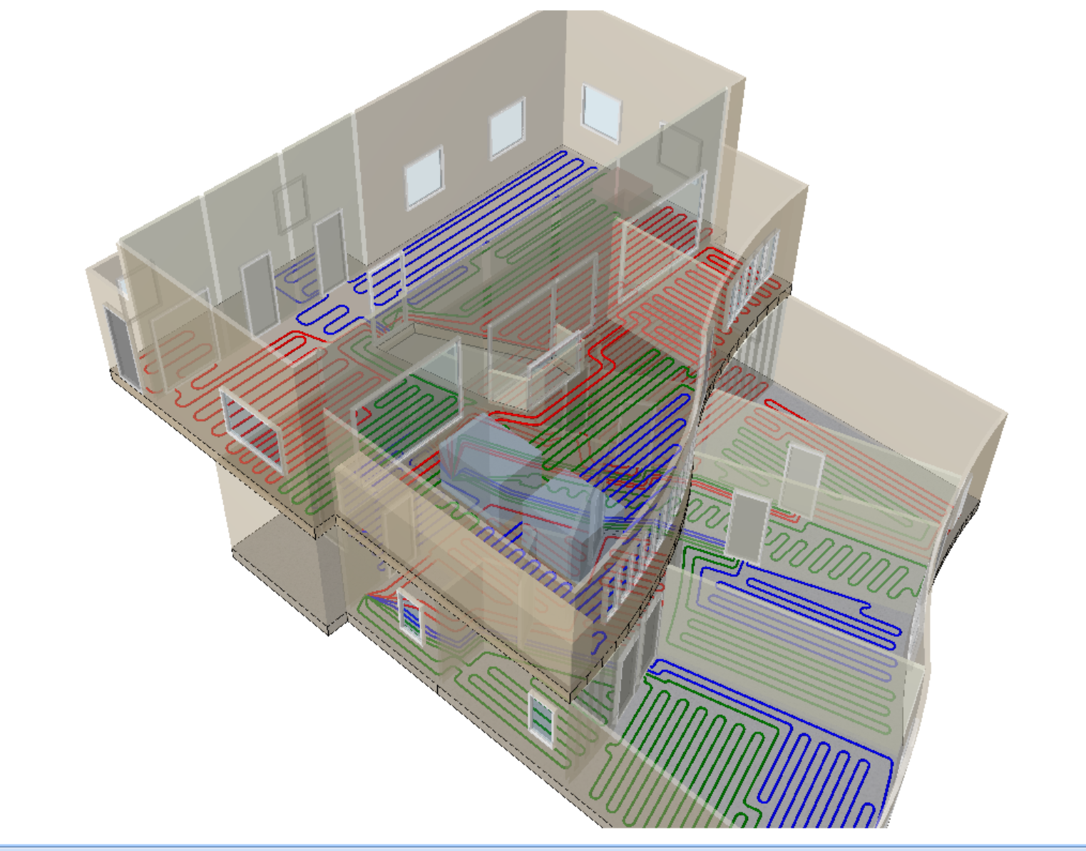
Underfloor Heating/House3.png
