DanielBryars/ChadHouse/Underfloor Heating/House4.png

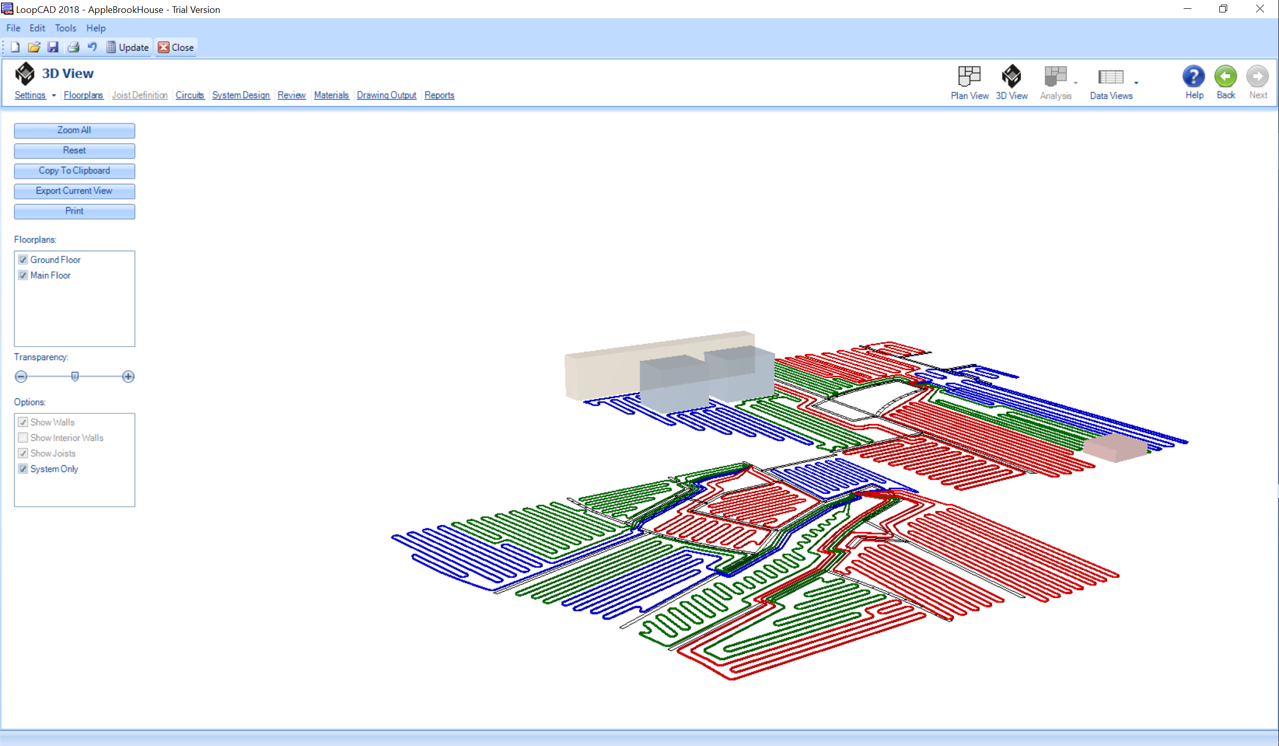
Underfloor Heating/House4.png
