DanielBryars/ChadHouse/Ventilation/GF Blank.png

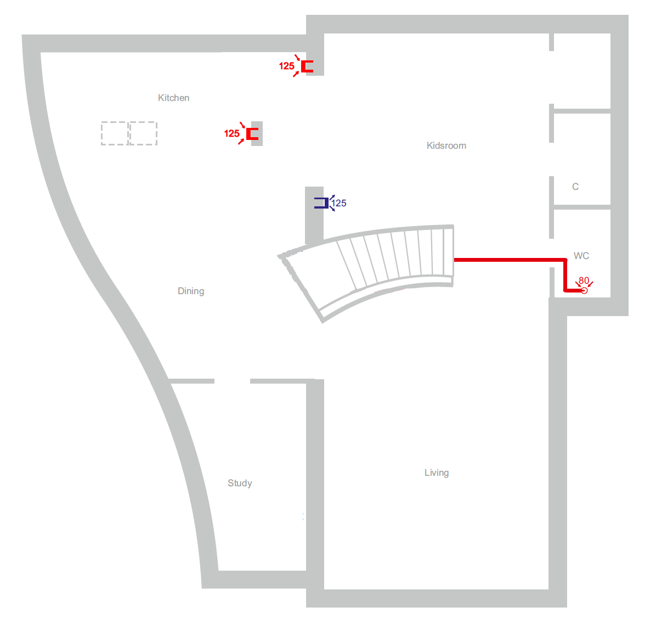
Ventilation/GF Blank.png
