DanielBryars/ChadHouse/Ventilation/GF V1.png

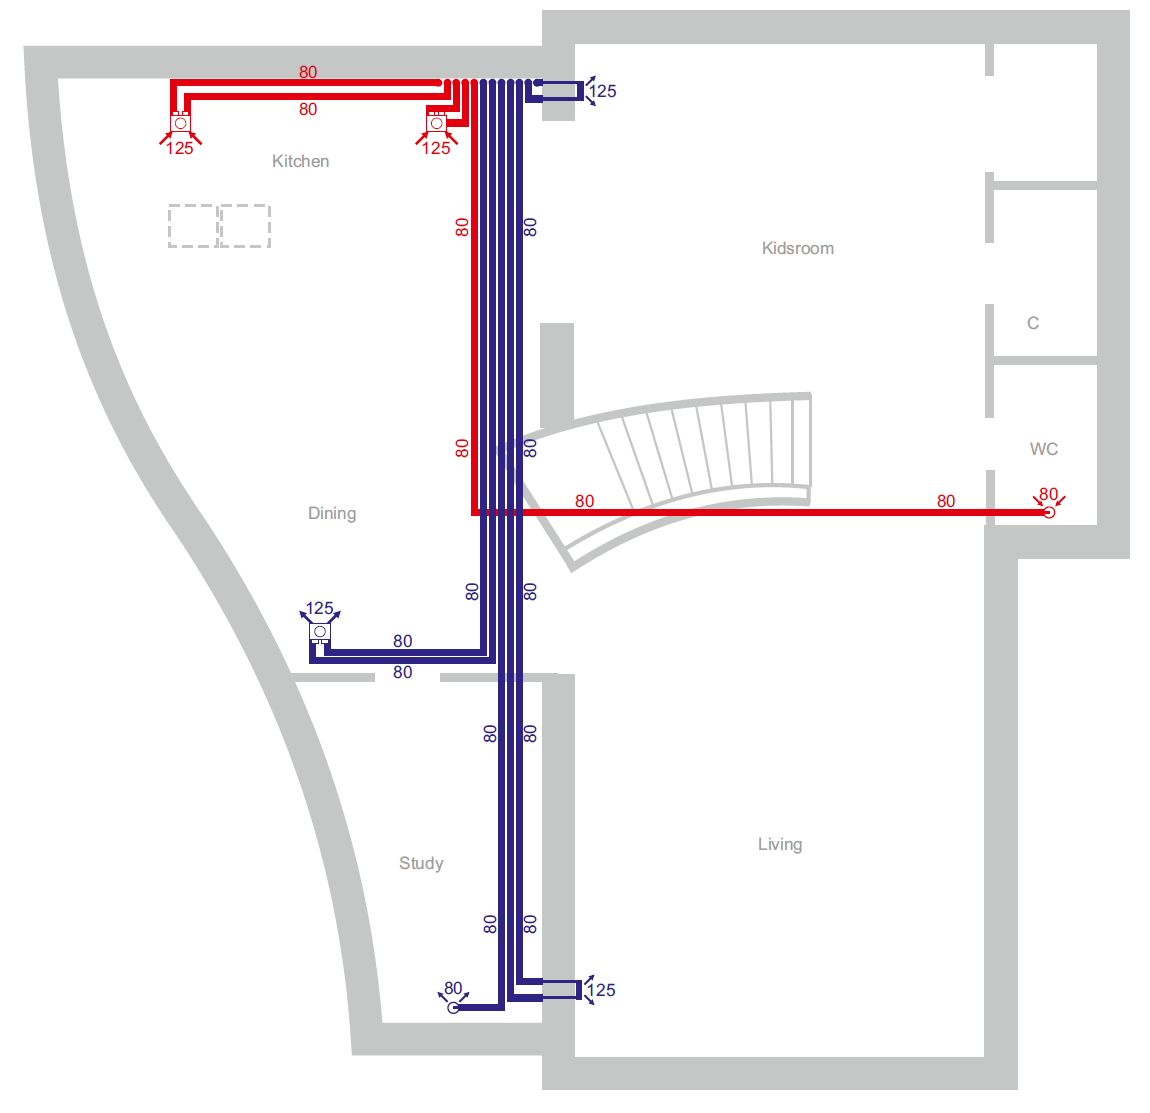
Ventilation/GF V1.png
