DanielBryars/ChadHouse/Ventilation/GF V2.png

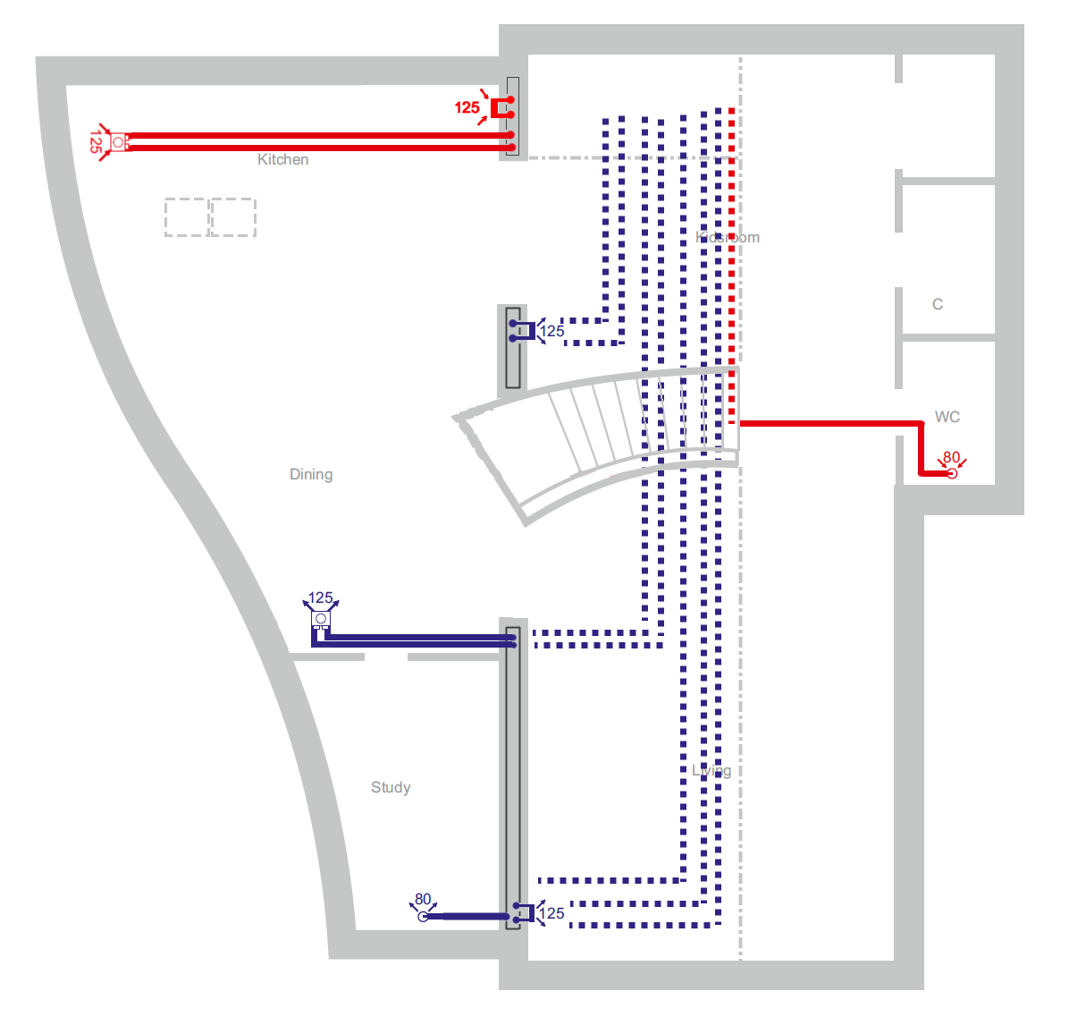
Ventilation/GF V2.png
