DanielBryars/ChadHouse/Ventilation/LGF Blank.png

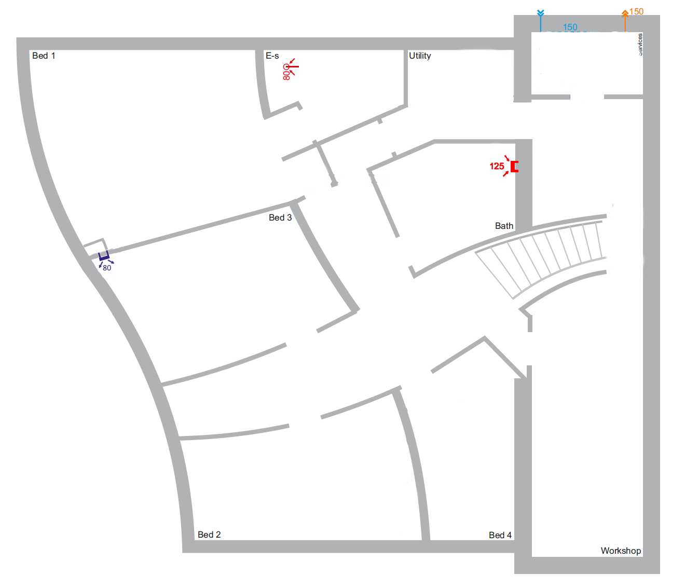
Ventilation/LGF Blank.png
