DanielBryars/ChadHouse/Ventilation/LGF V1.png

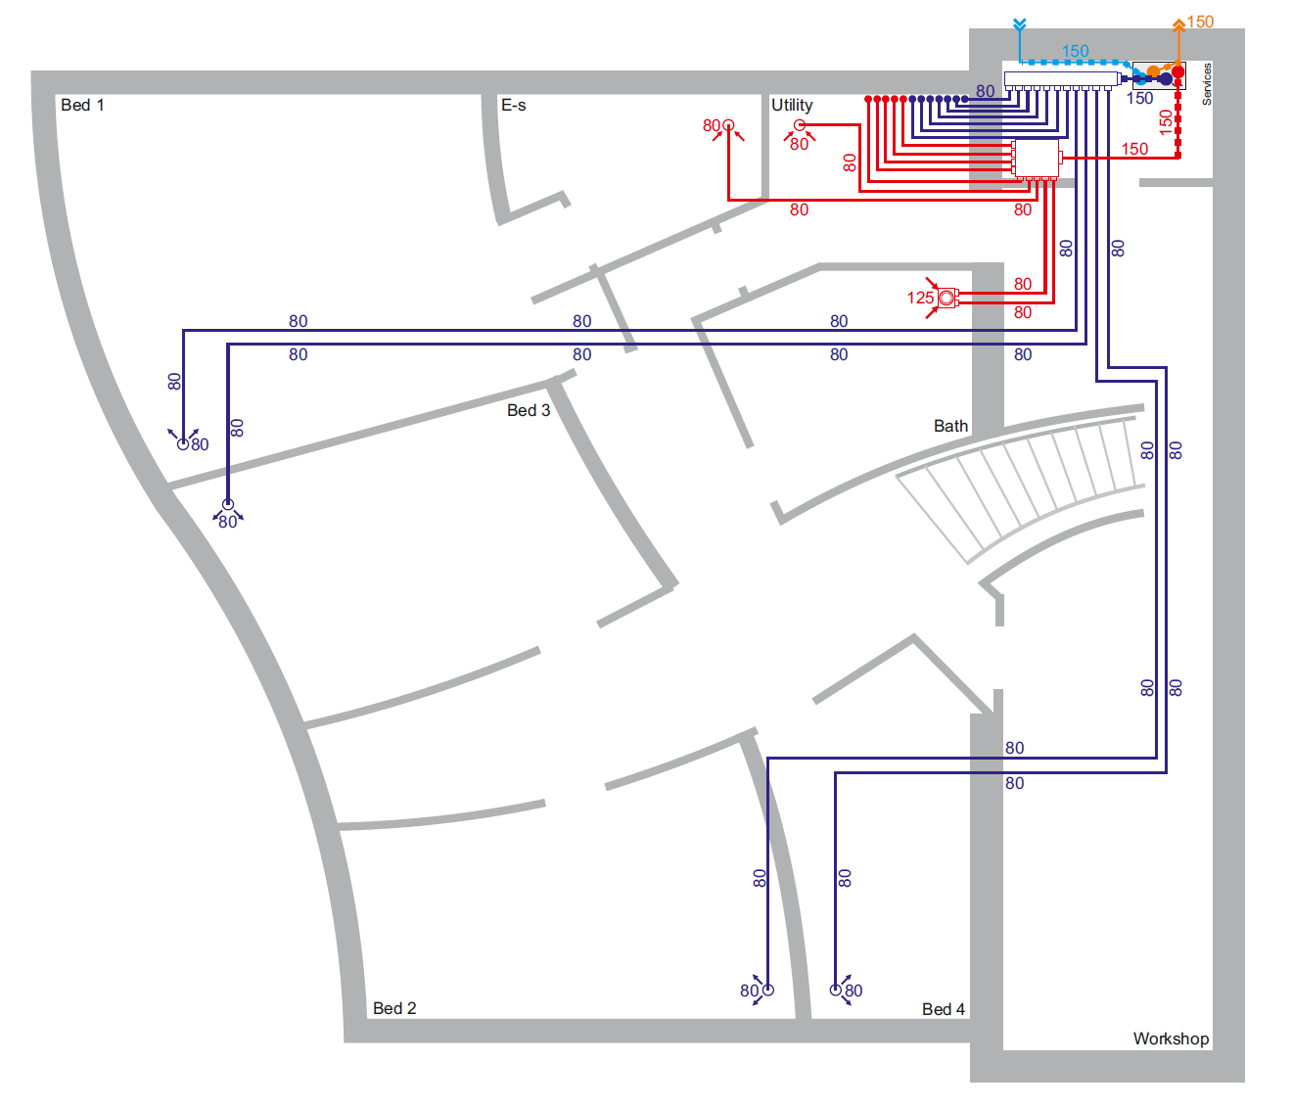
Ventilation/LGF V1.png
