DanielBryars/ChadHouse/Ventilation/LGF V2.png

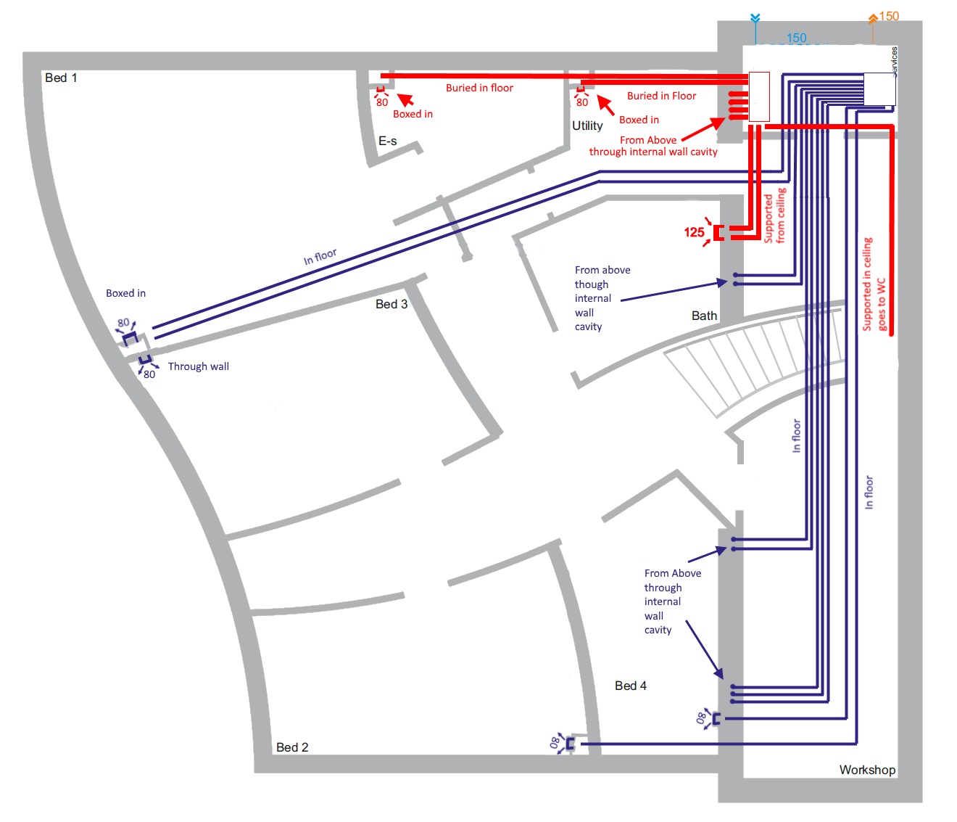
Ventilation/LGF V2.png
