DanielBryars/ChadHouse/WhatsApp Image 2018-07-16 at 13.40.37.jpeg

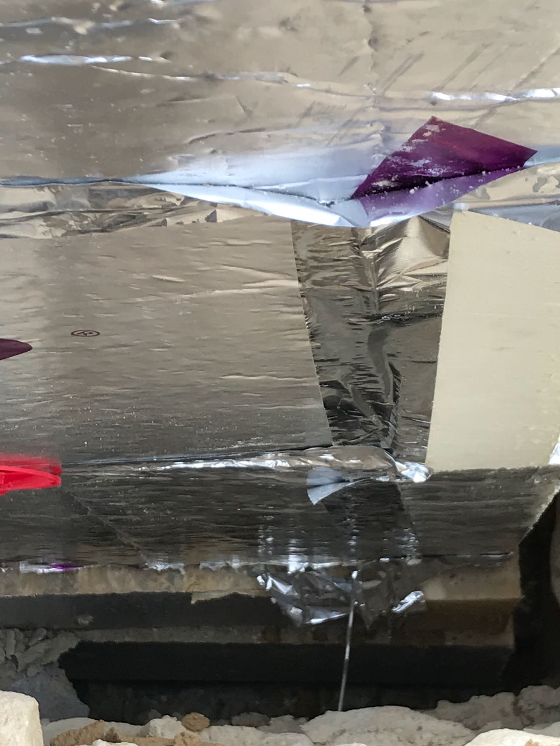
WhatsApp Image 2018-07-16 at 13.40.37.jpeg
