DanielBryars/ChadHouse/WhatsApp Image 2018-07-17 at 12.51.02.jpeg

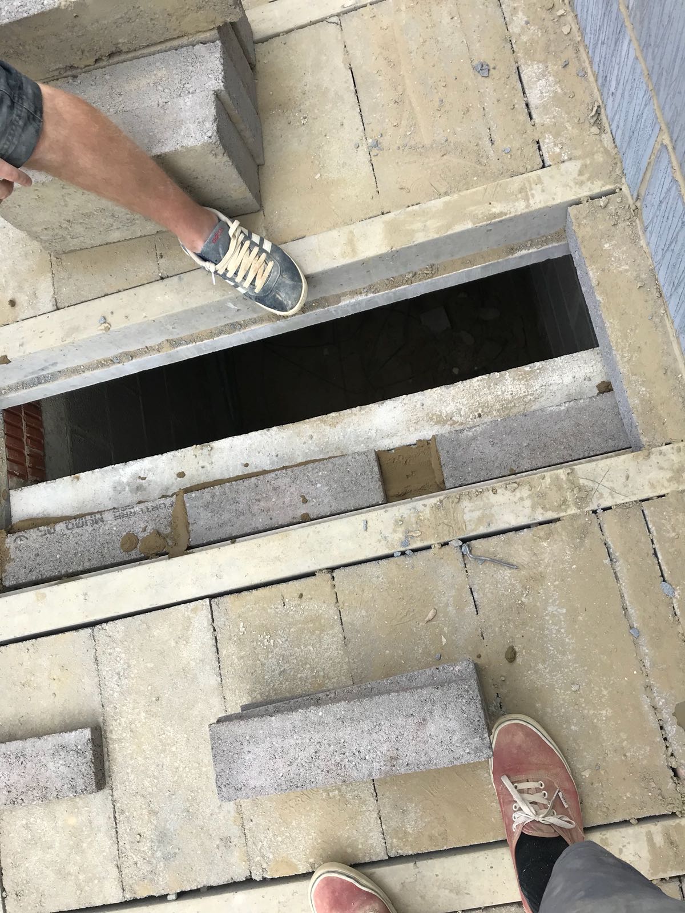
WhatsApp Image 2018-07-17 at 12.51.02.jpeg
