DanielBryars/ChadHouse/Wooden Windows/Sizes.png

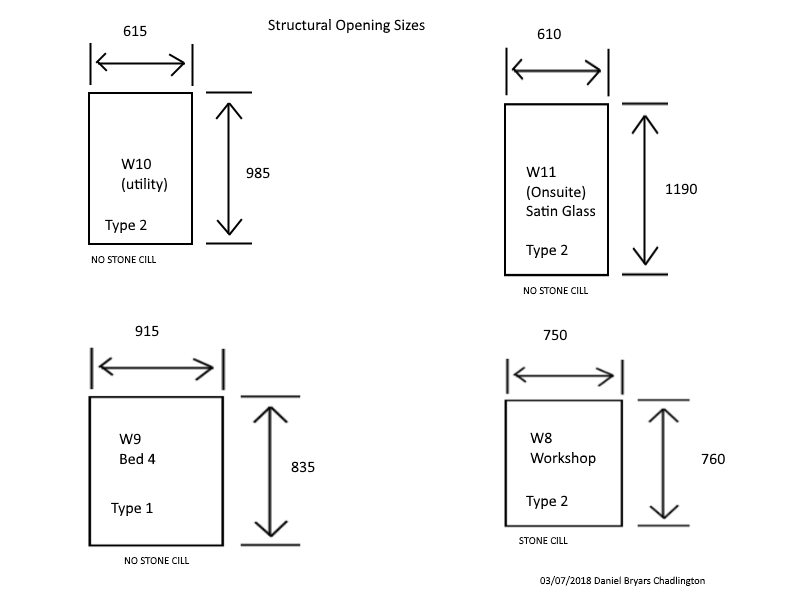
Wooden Windows/Sizes.png
