DanielBryars/ChadHouse/Kitchen/Cutlist-Component-enquiry-form-2020-R8.xlsx

Customer: | Daniel Bryars | Invoice address below:
Contact number: | 07974566434 | Apple Brook House, Horseshoe Lane, Chadlington, OX7 3NB
E-mail address: | daniel.bryars@speik.com |  |  |  |  | VERSION NUMBER:
Enquiry date: |  | Delivery address below (if different from above): |  |  |  | QUOTE COMPLETED BY:
Project Name: | Kitchen Top Moulds |  |  |  |  | MANUFACTURE DATE:
Delivery or Collect: | Collect |  |  |  |  | SPRAY FINISH COMPLETION DATE:
Offcuts required?: *over 400mm square | Yes, I'll use any offcuts if you have any. | Estimated order weight: |  |  | KG | DELIVERY DATE:
Complete and email this form to info@cutlist.co.uk and we will optimise your cutlist and confirm prices by return- QUOTES VALID FOR 30 DAYS
Customer Panel reference- for component label | Sheet Material - Inc Thickness | Length - mm (Grain running) | Width - mm | Qty | Edge banding (if applicable) - LLWW Refer to edging notes below- please use number 0 | Edgeband Type | Square/ Radius edge detail (Please use drop down menu) | Spray Finishing Painted edges must be edgebanded (Please use drop down menu)
eg. Cab 1 base | eg. Egger W980 Platinum White ST2 18mm MFC | Finished sizes include edgebanding |  |  |  | (Please use drop down menu)
Sideboard Mould Base | Melamine 18 mm Any colour | 1200 | 600 | 2 | N/A |  | -No Edging | - N/A
Sideboard Mould NS | Melamine 18 mm Any colour | 636 | 48 | 4 | N/A |  | -No Edging | - N/A
Sideboard Mould EW | Melamine 18 mm Any colour | 1200 | 48 | 4 | N/A |  | -No Edging | - N/A
Island Mould Base | Melamine 18 mm Any colour | 2400 | 1220 | 1 | N/A |  | -No Edging | - N/A
Island Mould NS | Melamine 18 mm Any colour | 1256 | 48 | 2 | N/A |  | -No Edging | - N/A
Island Mould CO NS | Melamine 18 mm Any colour | 528 | 48 | 2 | N/A |  | -No Edging | - N/A
Island Mould E | Melamine 18 mm Any colour | 2400 | 48 | 1 | N/A |  | -No Edging | - N/A
Island Mould NW | Melamine 18 mmAny colour | 615 | 48 | 1 | N/A |  | -No Edging | - N/A
Island Mould CO E | Melamine 18 mm Any colour | 764 | 48 | 1 | N/A |  | -No Edging | - N/A
Island Mould SW | Melamine 18 mm Any colour | 985 | 48 | 1 | N/A |  | -No Edging | - N/A
Office Use Only Total number of finished panels: |  |  |  | 19
Please insert additional lines should you need more space on your cutting list (highlight rows, right-click, insert)
Edging: Please note: L in edging code= edge listed in 'Length' column, even if dim in 'Length' column is shorter than dim in 'width' column- same for W = edge listed in 'Width' column |  |  |  |  | Office use only | QTY |  | Price
 |  |  |  |  | Board Total: | 0 |  | £0.00
Spray Finish: To edgeband a length less than 150mm, the panel may be subject to an edge and re cut process. Unfortunately we cannot offer component labelling on parts going through spray finishing. |  |  |  |  | Edging Total (inc £5 set up fee): | 0 |  | £0.00
 |  |  |  |  | Other:
Spray finished edges must be edged with Maple or solid wood edging to match veneer. Edges without edge banding will receive a coating of finish, but will not be sanded or prepared in any way. On Lacquered Birch Ply, select edge sanding for finished edges. |  |  |  |  | Delivery:
 |  |  |  |  | Subtotal: |  |  | £0.00
Delivery: *Estimated lead time will be confirmed at confirmation of order & receipt of payment |  |  |  |  | Vat: |  |  | £0.00
1/2 hour unloading time- failed deliveries will incur charge of £65 + VAT- Kerbside only, requires 2 person lift |  |  |  |  | Grand Total: |  |  | £0.00
By confirming this quote you agree all of the info above is correct and you agree to the CutList Terms & Conditions
Delivery Sign Off: All of the above goods are correct and received in perfect condition: |  |  |  |  | Sign: |  | Date:
Where signing 'unchecked' for an order, damages/ shortages must be reported within 24 hours of delivery or you may not qualify for replacements
Manor Farm, Chinnor Hill, Oxfordshire, OX39 4BG - 01844 35 34 39 | CutList Limited Registered in England and Wales 9439957 VAT 216 0505 50
