DanielBryars/ChadHouse/Plumbing/Rifeng.xlsx

Sheet: Sheet1
 |  | Size | Qty
 | Hot water cylinder feed | 25 | 1
 | Hot water cylinder feed T Piece | 25,25,25 | 1
 | Cold Utility T Piece | 25,25,25 | 1
 | Hot Utility T Piece | 25,25,25 | 1
 | Cold Ensuite Shower T Piece | 25,25,25 | 1
 | Hot Ensuite Shower T Piece | 25,25,25 | 1
 | Rain Water Fill T Piece | 25,16,25 | 1
 | Rain Water Fill Pipe | 16 | 2
 | Boiler T Piece | 25,25,25 | 1
 | Rainwater Utility T Piece | 25,25,25 | 1
 | Rainwater WC T Piece | 25,16,16 | 1
 | Hot WC T Piece | 25,25,16 | 1
 | Cold WC T Piece | 25,25,16 | 1
 | Main Bathroom Hot Shower | 25,25,25 | 1
 | Main Bathroom Cold Shower | 25,25,25 | 1
 | Main Bathroom Hot Feed | 25,25,25 | 1
 | Main Bathroom Cold Feed | 25,25,25 | 1
Utility | Cold Room Supply | 25 | 3
 | Cold Sink T Piece | 25,16,16 | 1
 | Cold Sink Feed | 16 | 1 | 25 | 56 | 110
 | Hot Room Supply | 25 | 3 | 16 | 109 | 65
 | Hot Sink T Piece | 25,16,16 | 1
 | Hot Sink Feed | 16 | 1
 | Rainwater T Feed | 25,16,16 | 1
 | Rainwater T Feed | 16,16,16 | 1
 | Washing machine and Tap Pipe | 16 | 3.5
On suite | Cold Sink Feed | 16 | 4.4
 | Hot Sink Feed | 16 | 4.4
 | Shower Cold Feed | 25 | 7.5
 | Shower Hot Feed | 25 | 7.5
 | Rainwater Toilet Feed | 16 | 6
Upstairs WC | Rainwater Toilet and tap feed | 16 | 17
 | Toilet T | 16,16,16
 | Cold Sink Feed | 16 | 17
 | Hot Sink Feed | 16 | 17
Main Bathroom | Rainwatch toilet | 16 | 9
 | Hot Shower Feed | 25 | 9
 | Cold Shower Feed | 25 | 9
 | Hot Bath Feed | 25 | 9
 | Cold Bath Feed | 25 | 9
 | Cold Bath T | 25,16,25 | 1
 | Hot Bath T | 25,16,25 | 1
 | Cold Bath Leg | 16 | 3
 | Hot Bath Leg | 16 | 3
 | Cold Sink T | 25,16,25 | 1
 | Hot Sink T | 25,16,25 | 1
 | Cold Sink Leg | 16 | 3
 | Hot Sink Leg | 16 | 3
Kitchen | 90 Deg Elbow | 25 | 2
 | Dish/Sink T | 25,16,16 | 2
 | Hot Feed | 16 | 6
 | Cold Feed | 16 | 6
 | Bending Spring
 | Compression Clamp Tool

Sheet: Sheet2
Hot water cylinder feed | 25 | 1 | Hot water cylinder feed | 25 | 1 | Cold Room Supply | 25 | 3
Rain Water Fill Pipe | 16 | 2 | Rain Water Fill Pipe | 16 | 2 | Hot Room Supply | 25 | 3
Cold Room Supply | 25 | 3 | Cold Sink Feed | 16 | 1 | Shower Cold Feed | 25 | 7.5
Cold Sink Feed | 16 | 1 | Hot Sink Feed | 16 | 1 | Shower Hot Feed | 25 | 7.5
Hot Room Supply | 25 | 3 | Washing machine and Tap Pipe | 16 | 3.5 | Hot Shower Feed | 25 | 9
Hot Sink Feed | 16 | 1 | Cold Sink Feed | 16 | 4.4 | Cold Shower Feed | 25 | 9
Washing machine and Tap Pipe | 16 | 3.5 | Hot Sink Feed | 16 | 4.4 | Hot Bath Feed | 25 | 9
Cold Sink Feed | 16 | 4.4 | Rainwater Toilet Feed | 16 | 6 | Cold Bath Feed | 25 | 9
Hot Sink Feed | 16 | 4.4 | Rainwater Toilet and tap feed | 16 | 17 | 90 Deg Elbow | 25 | 2
Shower Cold Feed | 25 | 7.5 | Cold Sink Feed | 16 | 17
Shower Hot Feed | 25 | 7.5 | Hot Sink Feed | 16 | 17
Rainwater Toilet Feed | 16 | 6 | Rainwatch toilet | 16 | 9
Rainwater Toilet and tap feed | 16 | 17 | Cold Bath Leg | 16 | 3
Cold Sink Feed | 16 | 17 | Hot Bath Leg | 16 | 3
Hot Sink Feed | 16 | 17 | Cold Sink Leg | 16 | 3
Rainwatch toilet | 16 | 9 | Hot Sink Leg | 16 | 3
Hot Shower Feed | 25 | 9 | Hot Feed | 16 | 6
Cold Shower Feed | 25 | 9 | Cold Feed | 16 | 6
Hot Bath Feed | 25 | 9
Cold Bath Feed | 25 | 9
Cold Bath Leg | 16 | 3
Hot Bath Leg | 16 | 3
Cold Sink Leg | 16 | 3
Hot Sink Leg | 16 | 3
90 Deg Elbow | 25 | 2
Hot Feed | 16 | 6
Cold Feed | 16 | 6

Sheet: Sheet3
Cold Room Supply | 25 | 3
Hot Room Supply | 25 | 3
Shower Cold Feed | 25 | 7.5
Shower Hot Feed | 25 | 7.5
Hot Shower Feed | 25 | 9
Cold Shower Feed | 25 | 9
Hot Bath Feed | 25 | 9
Cold Bath Feed | 25 | 9
90 Deg Elbow | 25 | 2
 |  | 59

Sheet: Sheet4
Rain Water Fill Pipe | 16 | 2
Cold Sink Feed | 16 | 1
Hot Sink Feed | 16 | 1
Washing machine and Tap Pipe | 16 | 3.5
Cold Sink Feed | 16 | 4.4
Hot Sink Feed | 16 | 4.4
Rainwater Toilet Feed | 16 | 6
Rainwater Toilet and tap feed | 16 | 17
Cold Sink Feed | 16 | 17
Hot Sink Feed | 16 | 17
Rainwatch toilet | 16 | 9
Cold Bath Leg | 16 | 3
Hot Bath Leg | 16 | 3
Cold Sink Leg | 16 | 3
Hot Sink Leg | 16 | 3
Hot Feed | 16 | 6
Cold Feed | 16 | 6
 |  | 106.3
