DanielBryars/ChadHouse/Gas/SOPL_FGP_570UK_METRIC_UK_Website_Version_Rev_2_09_15_1.xlsx

Sheet: Instructions
Sum - Pressure-Loss Worksheet Instructions
Step 1 | Select the Fuel Gas Type in cell K10. Note: Gas Types are based on the following Specific Gravity (also known as Relative Density): 0.60 - Natural Gas, 1.52 - Propane, 2.07 - Butane, 1.20 - Air-Gas. For additonal information on gas calorific values, read the comments in the note in cells L10 and M10.
Step 2 | Enter the minimum pressure allowed at the end of the installation pipe (cell “K11”). This is the system operating pressure minus the allowable pressure drop across the installation. For example, you are allowed a maximum of 1mbar pressure drop across a Natural Gas installation (between the outlet of the gas meter and to any connected appliance) so in this cell you would enter 20mbar (21mbar nominal operating pressure minus 1mbar allowable pressure drop).
Step 3 | Enter supply pressure (cell “K12”). For example 21mbar for Natural Gas, 37mbar for Propane and 28mbar for Butane.
Step 4 | Select supply pressure source for the run from the Column “B” dropdown list. Select “1” (Supply 1) for a meter (NG) or outlet of ECV/Cylinder regulator (LPG). Lettered selections (A, B, C…) refer to the pressure at the end of the pipe run. For example, if Pipe Run “D” is connected to the end of Pipe Run “C” (such as a branch off a tee), then select “C” as the "source" for pipe run "D" from the dropdown list.
Step 5 | Select "TracPipe" from the Pipe Type column (this table cannot be used for sizing any other type of pipe material) .
Step 6 | Enter “Run Length” and “Run Load” in Columns “D” and “E” respectively. The run length should be in metres (m) and is the equivalent length which should include any additional theoretical length added for bends, tees, AECV’s etc (see Table G7 of the TracPipe Design and Installation Specification (Current Edition) for relevant equivalent lengths). The load is the maximum heat input that pipe is expected to carry and must be inputted in cubic metres per hour (m3/hr).
Step 7 | Estimate the pipe size required for the pipe run being considered and enter this in Column “F” using the dropdown list. After the completion of the worksheet, note any “Pressures @ End of Run” in Column “F” that are shown in red. Red values represent a pressure drop in excess of the design limits previously inputted in Steps “2” and “3”. The pipe runs will need to be adjusted in size in order to bring the system within allowable design limits.
Step 8 | Continue adjusting pipe sizes until optimum piping sizes are obtained. This is done under the cell block which states DN.

Sheet: TracPipe Worksheet
Sum of Pressure Loss Worksheet
Tel: 01295 676 670
Project: |  |  |  |  |  |  |  |  | Date:
Contact/Tel: |  |  |  |  |  |  |  |  | Drawn:
Location: |  |  |  |  |  |  |  |  | Checked:
Description: |  |  |  |  |  |  |  |  | Sheet:
System Data and Requirements
 |  |  |  |  |  | Fuel Gas Type |  |  | Nat Gas | **For Notes about gas calorific value, read comments here**
Sum - Of - Pressure loss calculations are based on pressure drop per metre data located in Annex G of the TracPipe Design and Installation Specification - UK Version. |  |  |  |  |  | Supply Pressure - Gas Meter or LPG Vessel / ECV outlet (Supply 1 ) |  |  | 21 | mbar
 |  |  |  |  |  | Minimum pressure at appliance inlet or appliance isolation valve (taking in to account maximum allowable design pressure drop) |  |  | 20 | mbar
Pipe Run | Source | Pipe Type | Run length | Run load | Pipe Size | Pressure drop per metre | Pressure drop over run | Pressure @ start of run | Pressure @ end of run | Run Description | Notes
 |  |  | (m) | **Cubic Metres per Hour | DN | mbar / m | mbar | mbar | mbar |  | FLAT
A |  |  |  |  |  |  |  | - | -
B |  |  |  |  |  |  |  | - | -
C |  |  |  |  |  |  |  | - | -
D |  |  |  |  |  |  |  | - | -
E |  |  |  |  |  |  |  | - | -
F |  |  |  |  |  |  |  | - | -
G |  |  |  |  |  |  |  | - | -
H |  |  |  |  |  |  |  | - | -
I |  |  |  |  |  |  |  | - | -
J |  |  |  |  |  |  |  | - | -
K |  |  |  |  |  |  |  | - | -
L |  |  |  |  |  |  |  | - | -
M |  |  |  |  |  |  |  | - | -
N |  |  |  |  |  |  |  | - | -
O |  |  |  |  |  |  |  | - | -
P |  |  |  |  |  |  |  | - | -
Q |  |  |  |  |  |  |  | - | -
R |  |  |  |  |  |  |  | - | -
S |  |  |  |  |  |  |  | - | -
T |  |  |  |  |  |  |  | - | -
U |  |  |  |  |  |  |  | - | -
V |  |  |  |  |  |  |  | - | -
W |  |  |  |  |  |  |  | - | -
X |  |  |  |  |  |  |  | - | -
Y |  |  |  |  |  |  |  | - | -
Z |  |  |  |  |  |  |  | - | -
AA |  |  |  |  |  |  |  | - | -
AB |  |  |  |  |  |  |  | - | -
AC |  |  |  |  |  |  |  | - | -
AD |  |  |  |  |  |  |  | - | -
AE |  |  |  |  |  |  |  | - | -
AF |  |  |  |  |  |  |  | - | -
AG |  |  |  |  |  |  |  | - | -
AH |  |  |  |  |  |  |  | - | -
AI |  |  |  |  |  |  |  | - | -
AJ |  |  |  |  |  |  |  | - | -
AK |  |  |  |  |  |  |  | - | -
AL |  |  |  |  |  |  |  | - | -
AM |  |  |  |  |  |  |  | - | -
AN |  |  |  |  |  |  |  | - | -
AO |  |  |  |  |  |  |  | - | -
AP |  |  |  |  |  |  |  | - | -
AQ |  |  |  |  |  |  |  | - | -
AR |  |  |  |  |  |  |  | - | -
AS |  |  |  |  |  |  |  | - | -
AT |  |  |  |  |  |  |  | - | -
AU |  |  |  |  |  |  |  | - | -
AV |  |  |  |  |  |  |  | - | -
AW |  |  |  |  |  |  |  | - | -
AX |  |  |  |  |  |  |  | - | -
AY |  |  |  |  |  |  |  | - | -
AZ |  |  |  |  |  |  |  | - | -
BA |  |  |  |  |  |  |  | - | -
BB |  |  |  |  |  |  |  | - | -
BC |  |  |  |  |  |  |  | - | -
BD |  |  |  |  |  |  |  | - | -
BE |  |  |  |  |  |  |  | - | -
BF |  |  |  |  |  |  |  | - | -
BG |  |  |  |  |  |  |  | - | -
BH |  |  |  |  |  |  |  | - | -
BI |  |  |  |  |  |  |  | - | -
BJ |  |  |  |  |  |  |  | - | -
BK |  |  |  |  |  |  |  | - | -
Note: "Source" (Column B) must be used to establish the starting pressure for each pipe run. Pressure will come from the natural gas meter or propane/butane regulator (Supply 1), or from another pipe run in the system from Column A (runs A-BK).
 |  |  |  |  |  |  |  | 0.000
