DanielBryars/ChadHouse/Underfloor Heating/UFH.xlsx

LGF |  |  | GF
Bed1, Bed2, Bed3, Hallway | On suite, Utility, Main Bathroom, Hall way, Bed 4 | worshop | Kitchen and Study | Main Living Area | Entrance, closet , toilet
5.575 | 3.96 | 3.5 | 3.96 | 5.85 | 1.5
12.3 | 12.3 | 13.3 | 12.3 | 13.3 | 6.7
68.5725 | 48.708 | 46.55 | 48.708 | 77.805 | 10.05 | Watts per m2
 |  | 163.8305 |  |  |  | 60 | 260 | 15600
TOTAL
300.3935
seconds and co | www.secondsandco.co.uk
 | http://www.insulation4less.co.uk/Clearance/
 | http://www.aandainsulationservices.com/index.php
 | info@bmdinsulation.com |  |  |  |  |  | Screed
 |  |  |  |  |  |  | 260 | 10 | 2600
2.4
1.2 |  |  |  |  |  |  |  |  |  |  | 4022
2.88 |  |  |  |  |  |  |  |  |  |  | 1670
 |  |  | www.secondsandco.co.uk |  |  |  |  |  |  | git p | 5692
Sheet Thickness | m2 | Number of Sheets | per unit | total
20 | 70 | 25 | 11.5 | 287.5
40 | 30 | 11
100 | 160 | 56 | 37 | 2072
140 | 30 | 11 | 50 | 550
Delivery |  |  |  | 40
 |  |  |  | 2949.5
 |  |  | inc VAT | 3539.4
