DanielBryars/ChadHouse/2D/General Arrangement/dxf/W175-29D.dxf

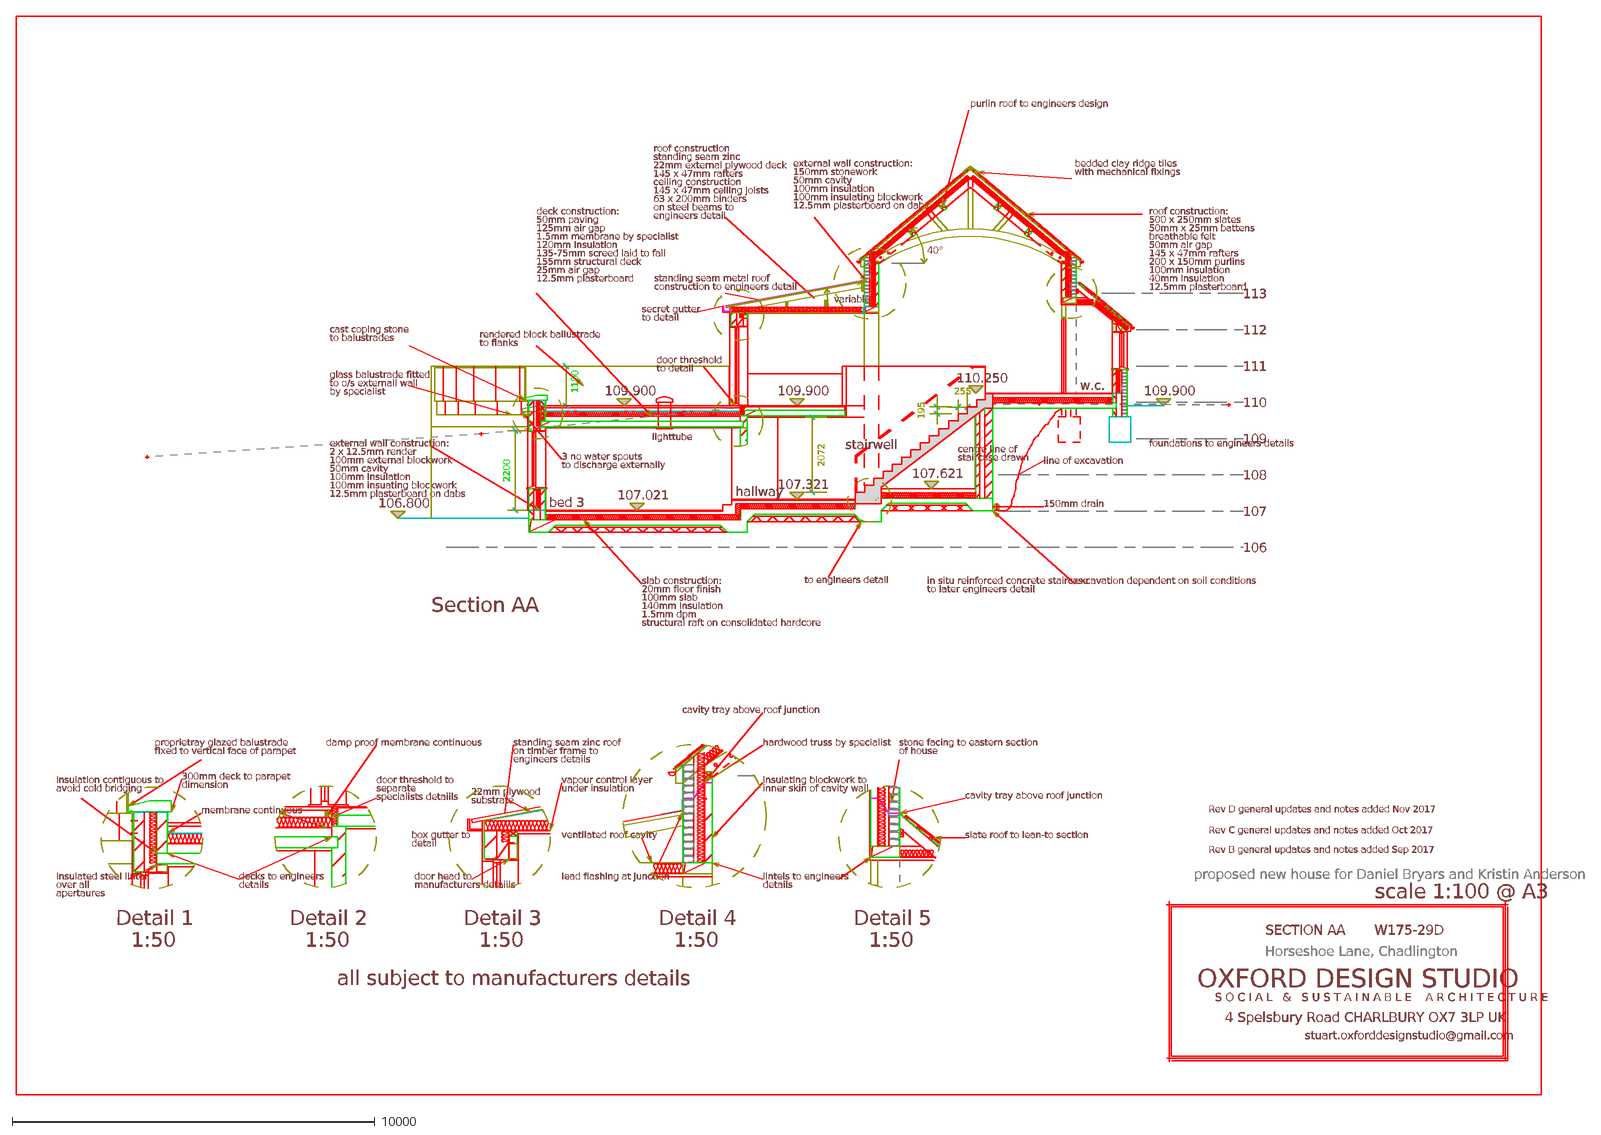
[picture p89: CAD file, 2017-12-17]
2D/General Arrangement/dxf/W175-29D.dxf
Slate
500
290
4
3
109.900
106
107
108
109
110
111
112
113
WINDOW IN SECTION
EXT WINDOWS
1
A314
0
1050
225
Window in section
IG Cavity Heavy Duty Lintel
2
150
100
2021
variable°
40°
1100
standing seam metal roof
construction to engineers detail
glass balustrade fitted
to o/s externall wall
by specialist
rendered block ballustrade
to flanks
line of excavation
150mm drain
deck construction:
50mm paving
125mm air gap
1.5mm membrane by specialist
120mm insulation
135-75mm screed laid to fall
155mm structural deck
25mm air gap
12.5mm plasterboard
proprietray glazed balustrade
fixed to vertical face of parapet
damp proof membrane continuous
standing seam zinc roof
on timber frame to
engineers details
stone facing to eastern section
of house
cavity tray above roof junction
insulation contiguous to
avoid cold bridging
insulated steel lintel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
