DanielBryars/ChadHouse/FreeCAD/HorseShoeLane.FCStd

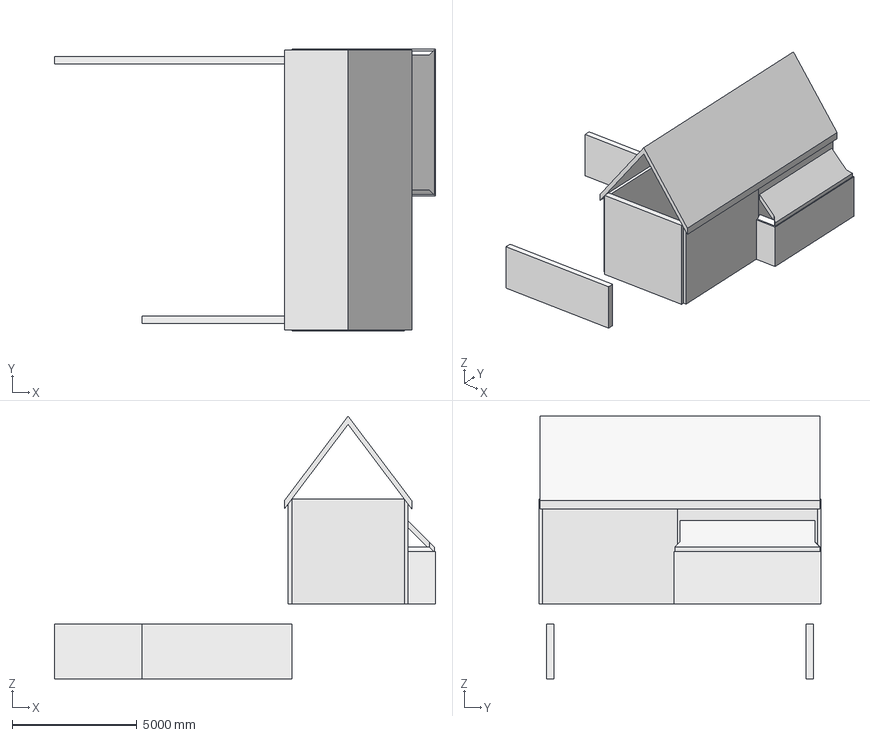
[picture p90: CAD file, 2017-12-17]
FreeCAD/HorseShoeLane.FCStd
15250.0 x 11300.0 x 10518.2 mm
LF South Wall
LF North Wall
MC North Wall
MC South Wall
MC External West Wall
MC External East S Wall
MC Porch North Wall
Wall
Roof
Roof001
