DanielBryars/ChadHouse/2D/General Arrangement/dxf/W175-26D.dxf

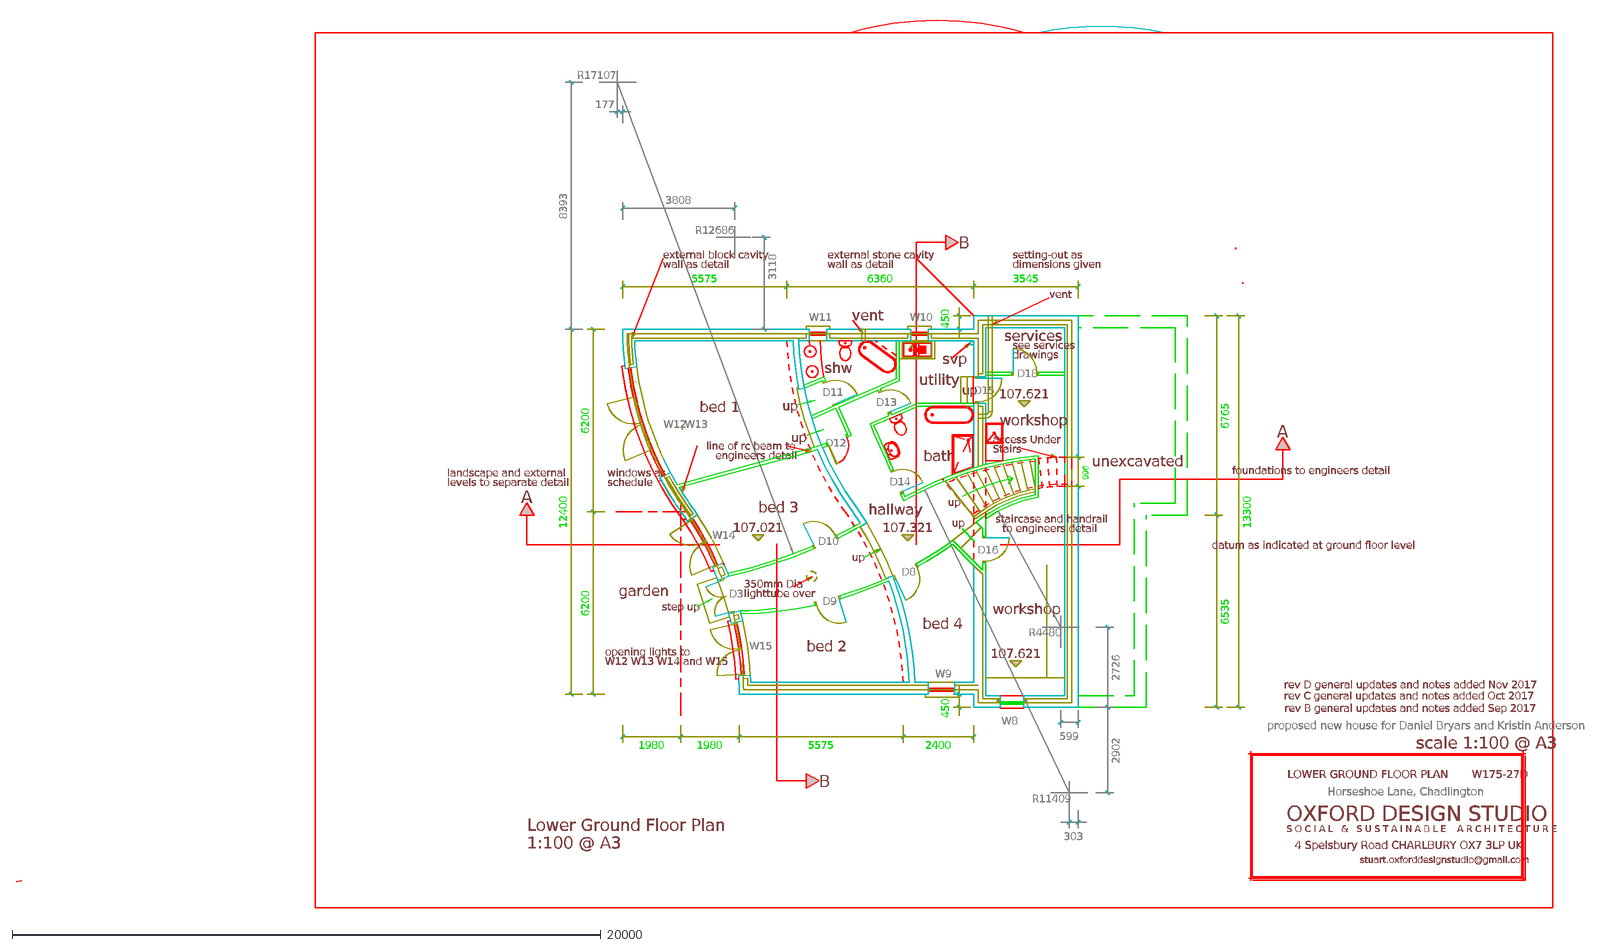
[picture p91: CAD file, 2017-12-17]
2D/General Arrangement/dxf/W175-26D.dxf
107.321
107.621
107.021
A
B
Window
1
0
DIST(XOF('O3'),YOF('O3'),XOF('O4'),YOF('O4'))
NEW
2100
AutoHatch
EXT WINDOWS
A314
1200
W
150
100
2
12400
6200
1980
5575
2400
450
6535
6765
13300
3545
6360
Single
Door
INTERNAL DOORS
A315
D
12
4
90
5
16
400
600
17
12101a2t
SANITARY
COTTAGE WASHBASIN
ARMITAGE SHANKS
W8
W9
W10
W11
W12
W13
W14
W15
D3
D9
D10
D11
D12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
