DanielBryars/ChadHouse/FreeCAD/Roof.FCStd

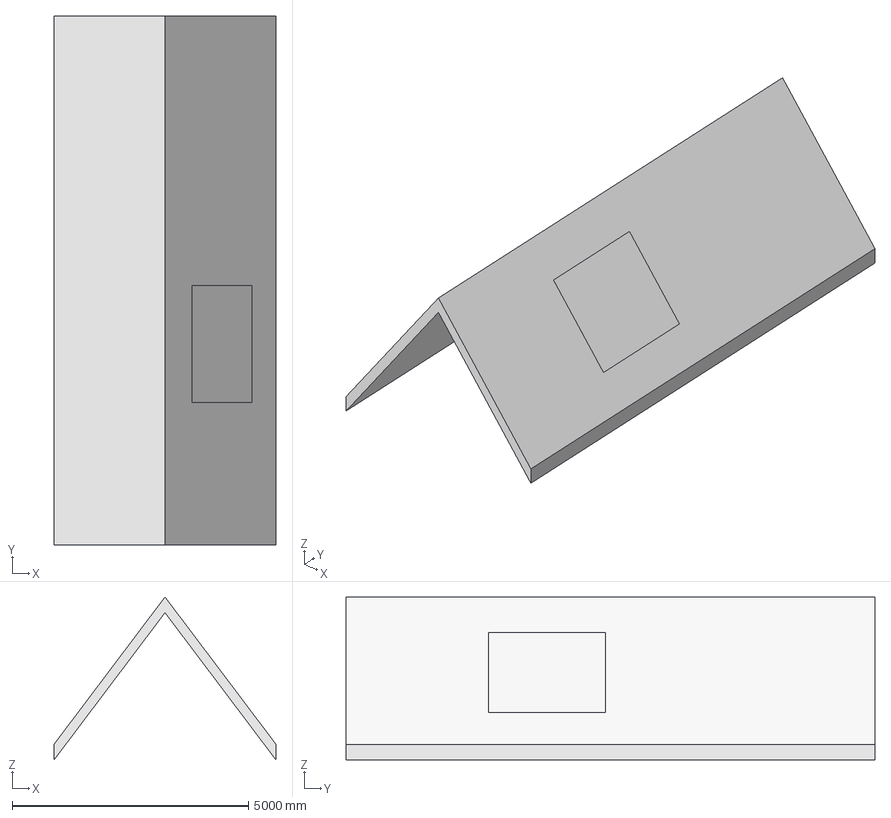
[picture p92: CAD file, 2017-12-17]
FreeCAD/Roof.FCStd
4700.0 x 11200.0 x 3450.9 mm
Roof003
Window
Roof
