DanielBryars/ChadHouse/2D/General Arrangement/dxf/W175-30D.dxf

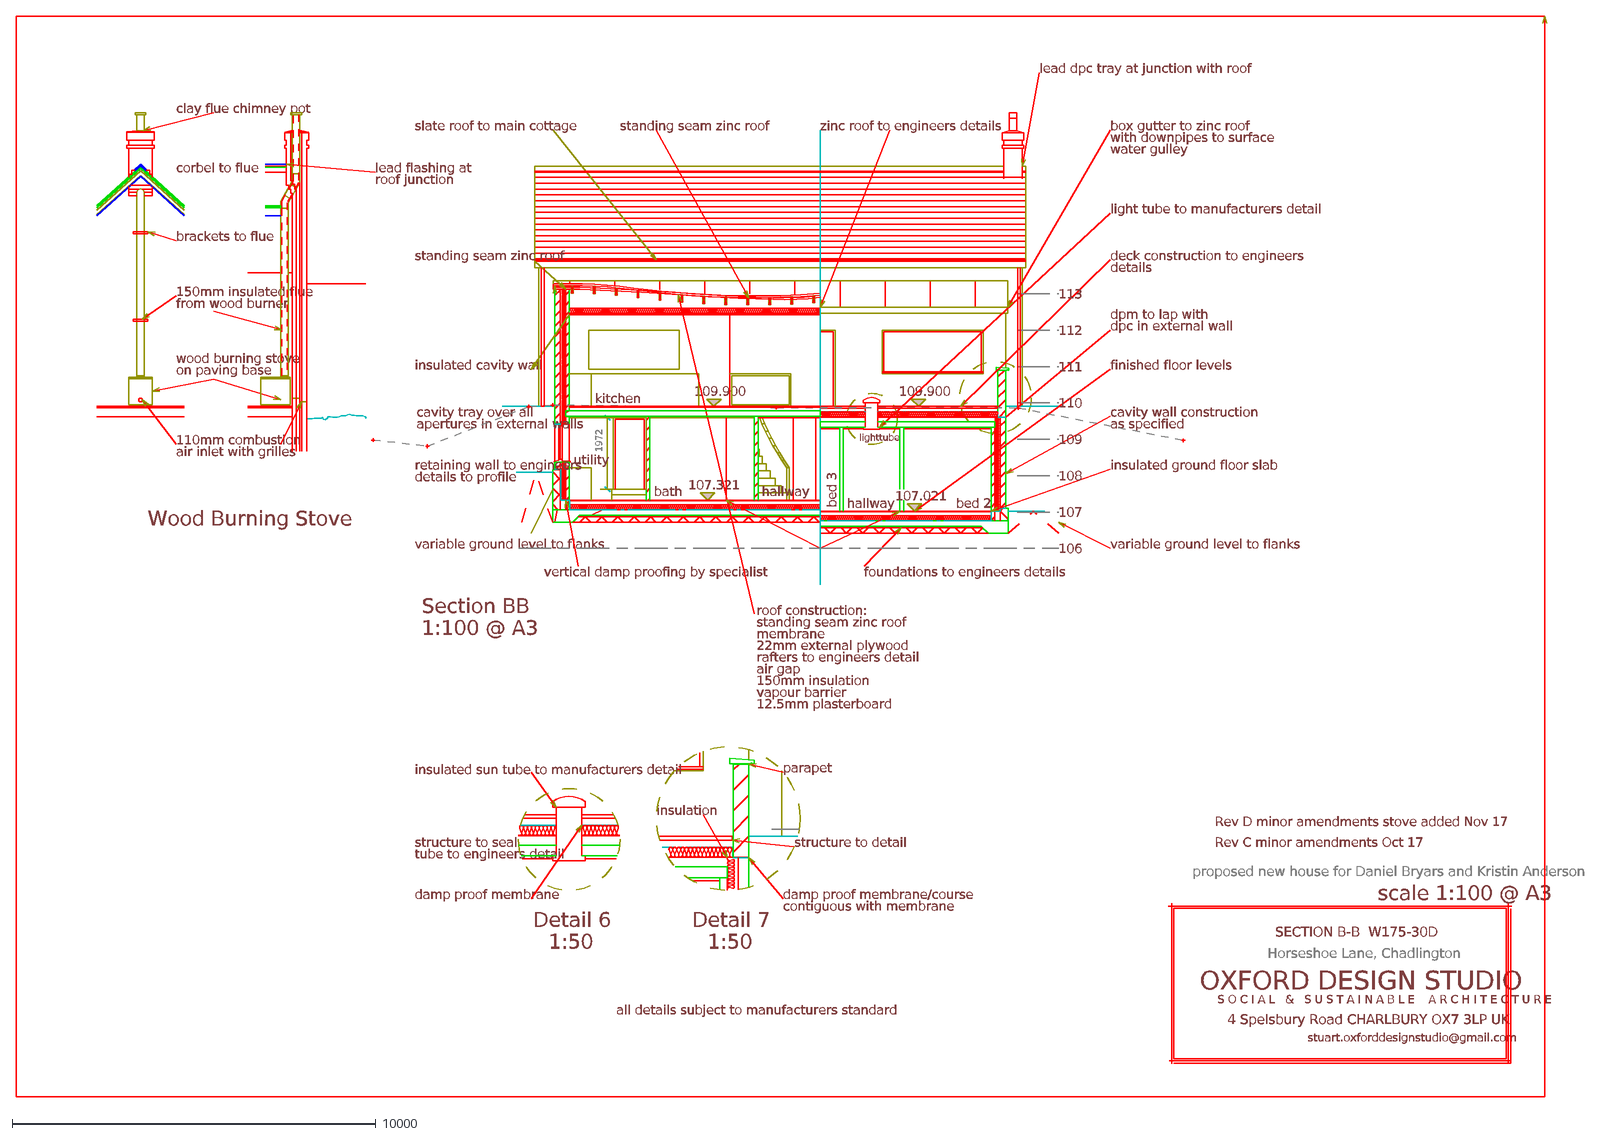
[picture p93: CAD file, 2017-12-17]
2D/General Arrangement/dxf/W175-30D.dxf
107.021
107.321
109.900
scale 1:100 @ A3
Horseshoe Lane, Chadlington
SECTION B-B W175-30D
OXFORD DESIGN STUDIO
S O C I A L & S U S T A I N A B L E A R C H I T E C T U R E
4 Spelsbury Road CHARLBURY OX7 3LP UK
stuart.oxforddesignstudio@gmail.com
proposed new house for Daniel Bryars and Kristin Anderson
bed 3
hallway
bed 2
WINDOW IN SECTION
EXT WINDOWS
1
A314
0
1050
225
Window in section
IG Cavity Heavy Duty Lintel
2
4
150
100
2021
lighttube
Section BB
1:100 @ A3
Detail 6
1:50
Detail 7
Wood Burning Stove
1972
utility
bath
kitchen
parapet
insulated sun tube to manufacturers detail
structure to seal
tube to engineers detail
damp proof membrane/course
contiguous with membrane
structure to detail
damp proof membrane
slate roof to main cottage
standing seam zinc roof
insulated cavity wall
box gutter to zinc roof
with downpipes to surface
water gulley
finished floor levels
insulated ground floor slab
variable ground level to flanks
retaining wall to engineers
details to profile
insulation
deck construction to engineers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
