DanielBryars/ChadHouse/(list of files, cad)

Other CAD files:
2D/AluminiumWindows/CHDB_001.dwg
2D/Balcony/DJB Balustrade Model.dwg
2D/RoofPanel/Fakro/DXW cross section dwg.dwg
2D/Structural/CHB_7011 Model Issue (BB Flr) 180411.2013.dwg
2D/Structural/DXF/CHB_7011 Model - to DB.dwg
Stairs/Stairs.dwg
Topological/LowerGroundFloorDFXaug17.dwg
Underfloor Heating/AppleBrookHouse.dwg
Velfac/SOUTH OF ANVIL COTTAGE.DWG
2D/Structural/DXF/CHB_7011 Model Dan.dxf
2D/Structural/DXF/CHB_7011 Model Issue171023 SETTING OUT AMENDED 31-10-17.dxf
2D/ServiceDucts.dwg
Topological/GroundFloorDFXaug17.dwg
2D/General Arrangement/dxf/W175-34E.dxf
2D/General Arrangement/dxf/W175-27D.dxf
2D/General Arrangement/dxf/W175-31D.dxf
2D/175026 Working.DWG
2D/175027 Working.dwg
2D/175029 Working.dwg
2D/ForterraBeams/68631_Ground_Floor.dwg
2D/General Arrangement/dwg/OLD/W175-26D (1).DWG
2D/General Arrangement/dwg/OLD/W175-27D (1).dwg
2D/General Arrangement/dwg/W175-26D (1).DWG
2D/General Arrangement/dwg/W175-26D.DWG
2D/General Arrangement/dwg/W175-27D (1).dwg
2D/General Arrangement/dwg/W175-27D.dwg
2D/General Arrangement/dwg/W175-29D.dwg
2D/General Arrangement/dwg/W175-30D.dwg
2D/General Arrangement/dwg/W175-31D.dwg
2D/General Arrangement/dwg/W175-34E.dwg
2D/General Arrangement/dxf/W175-26D (1).dxf
2D/General Arrangement/dxf/W175-27D (1).dxf
2D/Structural/68361_Ground_Floor_RevA.dwg
2D/Structural/DXF/#CHB_7011 Model Dan.dxf
2D/Structural/DXF/CHB_7011 Model Issue171023 SETTING OUT AMENDED 31-10-17.dwg
Kitchen/BuiltInMonitor/MonitorGlass.skp
Kitchen/Kitchen Island Mould.skp
Kitchen/Kitchen Island Mould2.skp
Kitchen/Kitchen Sideboard Mould .skp
Topological/16764-Topo.dwg
Topological/16764.dxf
