DanielBryars/ChadHouse/2D/Structural/Wall-At slab step.pdf

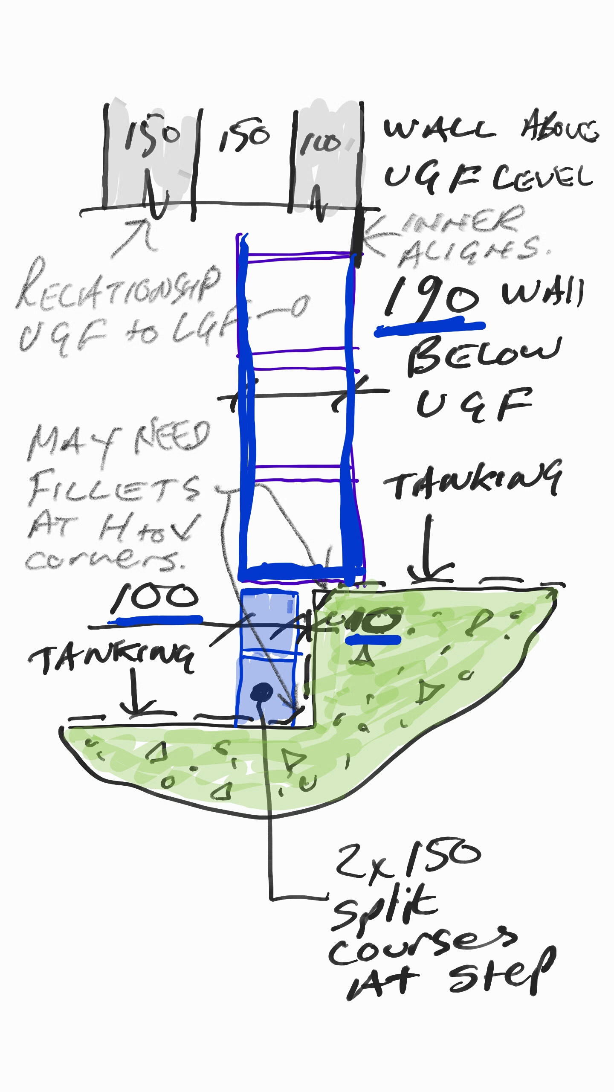
[picture p94: page 1]
