DanielBryars/ChadHouse/Gas/Install Location.png

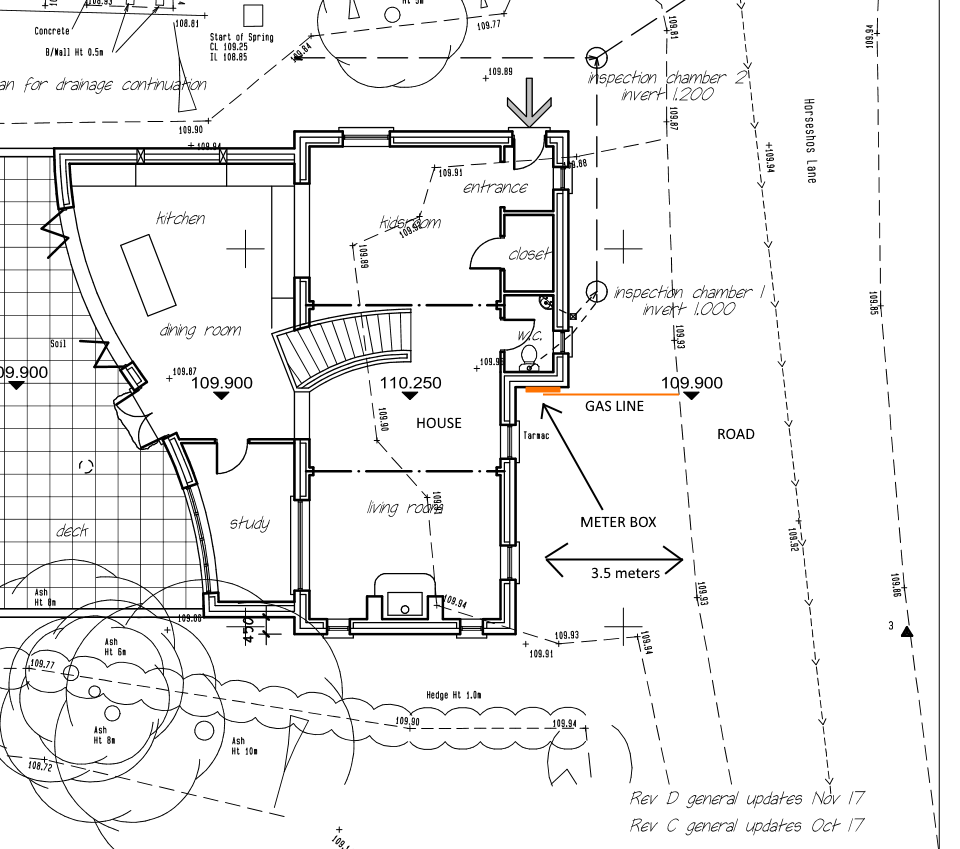
Gas/Install Location.png
