DanielBryars/ChadHouse/Kitchen/Concrete Experiments.xlsx

 |  |  | Test 1 |  |  | Test 2 |  |  | Test 3
Recipe |  |  | Target | Actual | Actual % | Target | Actual | Actual % | Target | Actual | Actual %
Ingredient | Percentage |  | 2500 | 2500 |  | 3000 |  |  | 2500
Sand | 50 | Of Total | 1250 | 1250 | 50 | 1500 |  | #DIV/0! | 1250 |  | #DIV/0!
Cementisous | 50 | Of Total | 1250 | 1768 |  | 1500 | 0 |  | 1250 | 0
Cement | 80 | Of Cementisious | 1000 | 1000 | 80 | 1200 |  | 0 | 1000 |  | 0
MicroSilica | 20 | Of Cementisious | 250 | 250 | 500 | 300 |  | #DIV/0! | 250 |  | #DIV/0!
PXR | 1 | Of Cementisious | 12.5 | 34 | 2.72 | 15 |  | 0 | 12.5 |  | 0
Dye | 1 | Of Cementisious | 12.5 | 34 | 2.72 | 15 |  | 0 | 12.5 |  | 0
Water | 30 | Of Cementisious | 375 | 450 | 36 | 450 |  | 0 | 375 |  | 0
 |  | Notes | Charcoal Grey
 |  |  | Test 4 |  |  | Test 5 |  |  | Test 6
 |  |  | Target | Actual | Actual % | Target | Actual | Actual % | Target | Actual | Actual %
 |  |  | 2500 |  |  | 2500 |  |  | 2500
 |  |  | 1250 |  | #DIV/0! | 1250 |  | #DIV/0! | 1250 |  | #DIV/0!
 |  |  | 1250 | 0 |  | 1250 | 0 |  | 1250 | 0
 |  |  | 1000 |  | 0 | 1000 |  | 0 | 1000 |  | 0
 |  |  | 250 |  | #DIV/0! | 250 |  | #DIV/0! | 250 |  | #DIV/0!
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
