DanielBryars/ChadHouse/SAP/Condensation_Risk_Analysis_S17212.pdf

# CONDENSATION RISK ANALYSIS

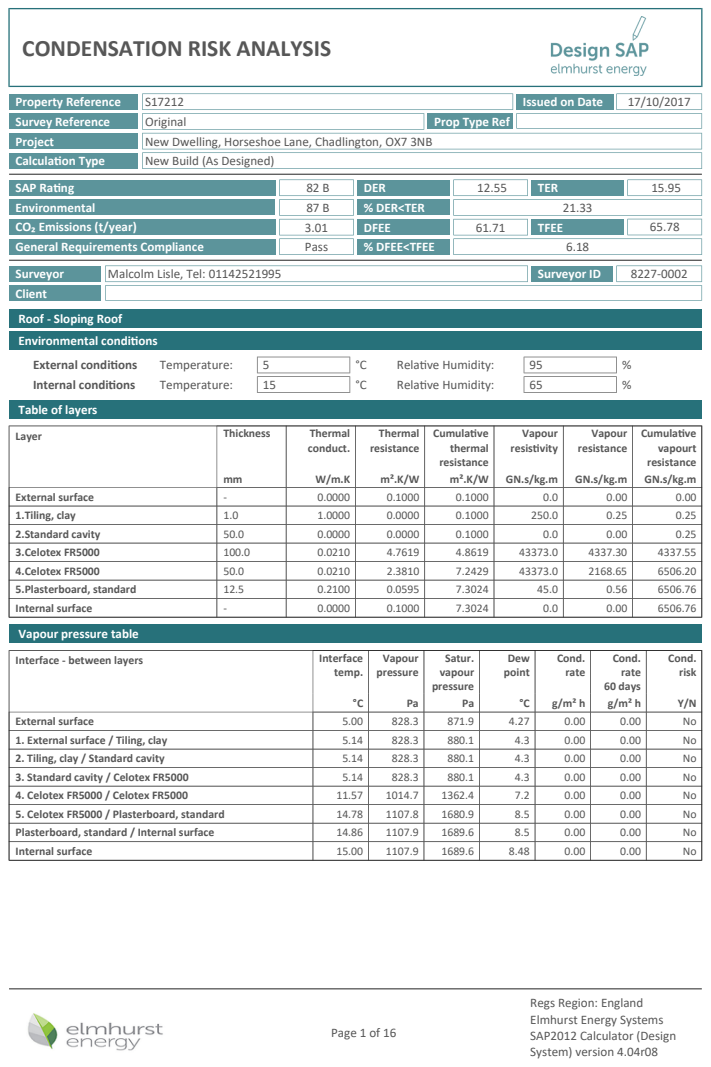
[picture p96: page 1]
Property Reference; Survey Reference; Issued on Date; Original; Project; New Dwelling, Horseshoe Lane, Chadlington, OX7 3NB; Calculaon Type; New Build (As Designed); % DFEE<TFEE; % DER<TER; TFEE; TER; DFEE; DER; Pass; Surveyor; Malcolm Lisle, Tel: 01142521995; Surveyor ID; Layer; Thickness; Thermal; conduct.; Thermal resistance; Cumulave thermal resistance; Vapour resisvity; Vapour resistance; Cumulave vapourt resistance; External surface; 1.Tiling, clay; 2.Standard cavity; 3.Celotex FR5000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

Prop Type Ref

SAP Rang
Environmental
CO₂ Emissions (t/year)
General Requirements Compliance

Client
Roof - Sloping Roof
Environmental condions
Table of layers

Vapour pressure table

Regs Region: England
Elmhurst Energy Systems
SAP2012 Calculator (Design
System) version 4.04r08

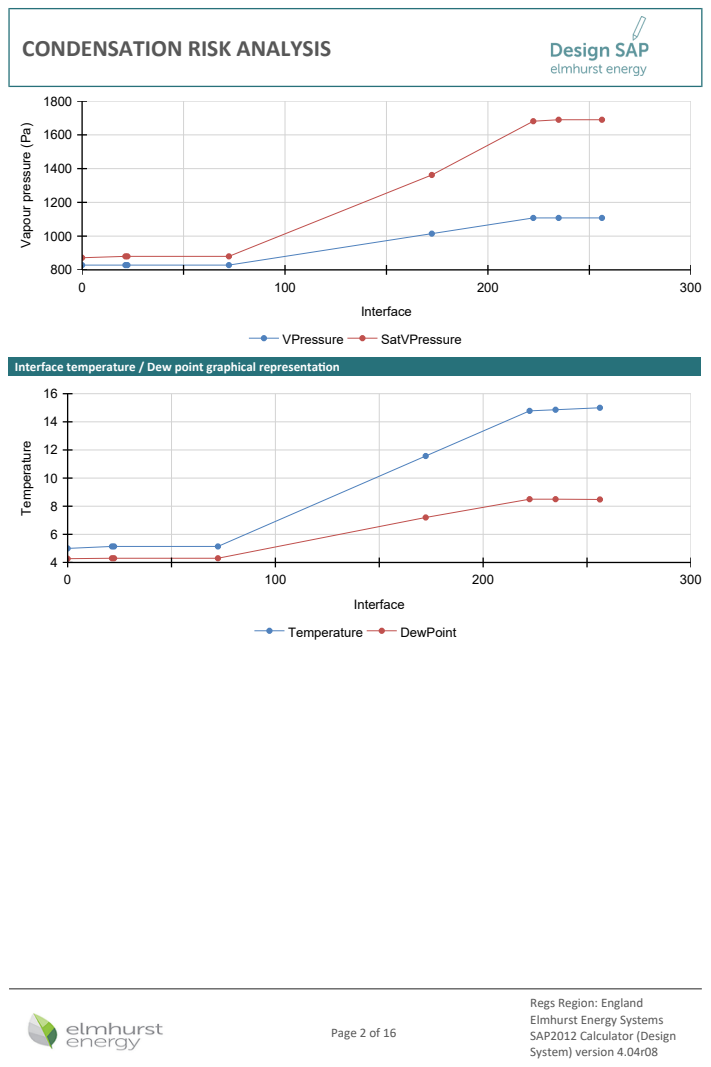
[picture p97: page 2]
Interface; VPressure; SatVPressure; Temperature; DewPoint

Vapour pressure (Pa)

Interface temperature / Dew point graphical representaon

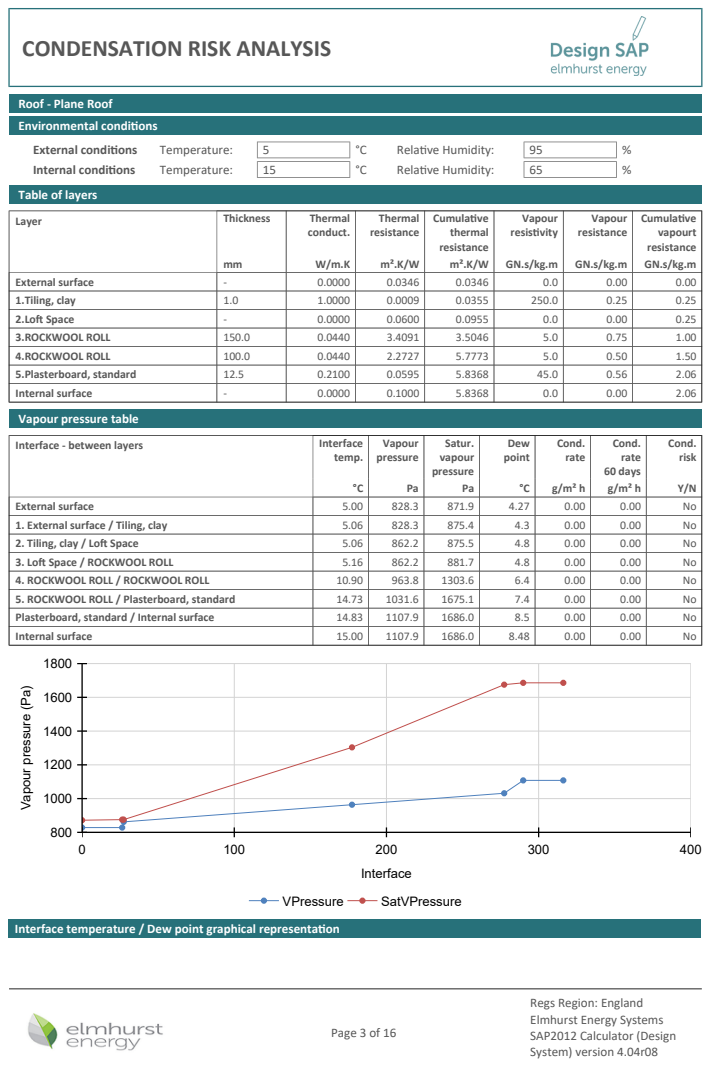
[picture p98: page 3]
Layer; Thickness; Thermal; conduct.; Thermal resistance; Cumulave thermal resistance; Vapour resisvity; Vapour resistance; Cumulave vapourt resistance; External surface; 1.Tiling, clay; 2.Lo Space; 3.ROCKWOOL ROLL; 4.ROCKWOOL ROLL; 5.Plasterboard, standard; Internal surface; Interface - between layers; Interface; temp.; Vapour pressure; Satur. vapour pressure; Dew point; Cond. rate; Cond. rate 60 days; Cond. risk; 1. External surface / Tiling, clay; 2. Tiling, clay / Lo Space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

Roof - Plane Roof
Environmental condions
Table of layers

Vapour pressure table

Vapour pressure (Pa)

Interface temperature / Dew point graphical representaon

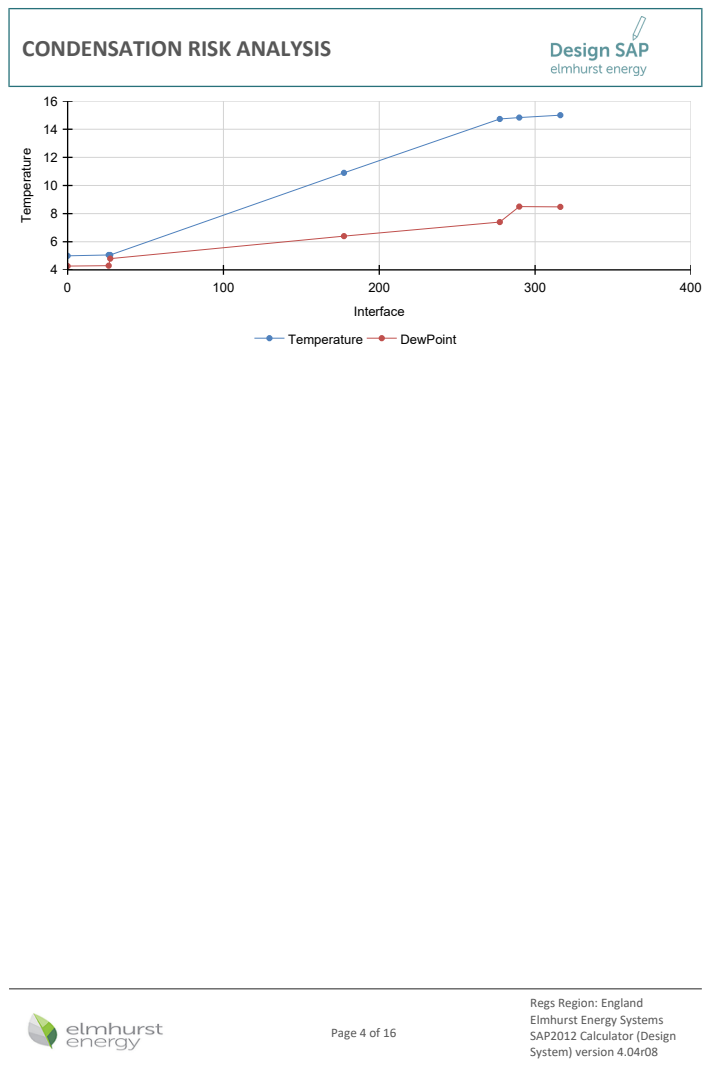
[picture p99: page 4]
Interface; Temperature; DewPoint

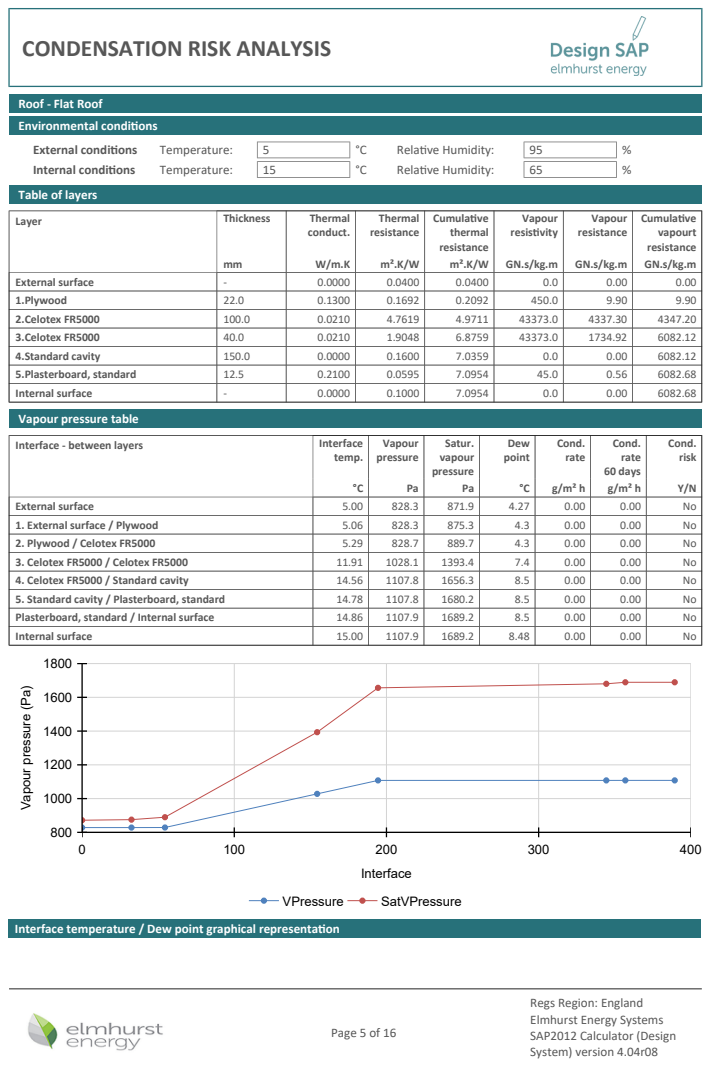
[picture p100: page 5]
Layer; Thickness; Thermal; conduct.; Thermal resistance; Cumulave thermal resistance; Vapour resisvity; Vapour resistance; Cumulave vapourt resistance; External surface; 1.Plywood; 2.Celotex FR5000; 3.Celotex FR5000; 4.Standard cavity; 5.Plasterboard, standard; Internal surface; Interface - between layers; Interface; temp.; Vapour pressure; Satur. vapour pressure; Dew point; Cond. rate; Cond. rate 60 days; Cond. risk; 1. External surface / Plywood; 2. Plywood / Celotex FR5000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

Roof - Flat Roof
Environmental condions
Table of layers

Vapour pressure table

Vapour pressure (Pa)

Interface temperature / Dew point graphical representaon

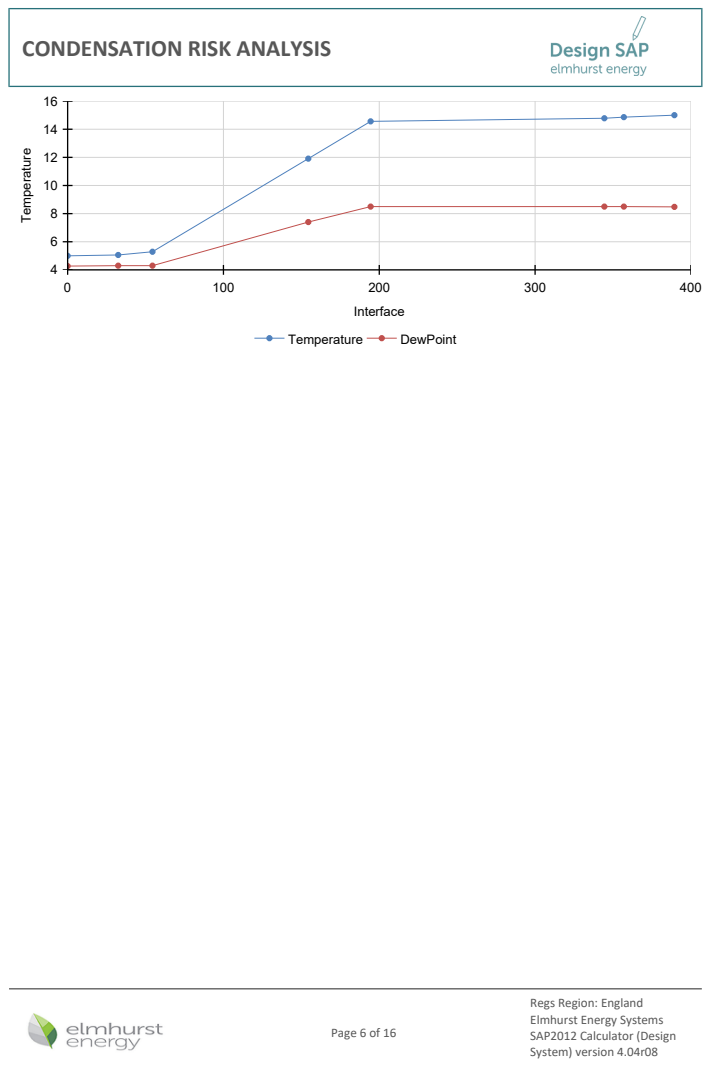
[picture p101: page 6]
Interface; Temperature; DewPoint

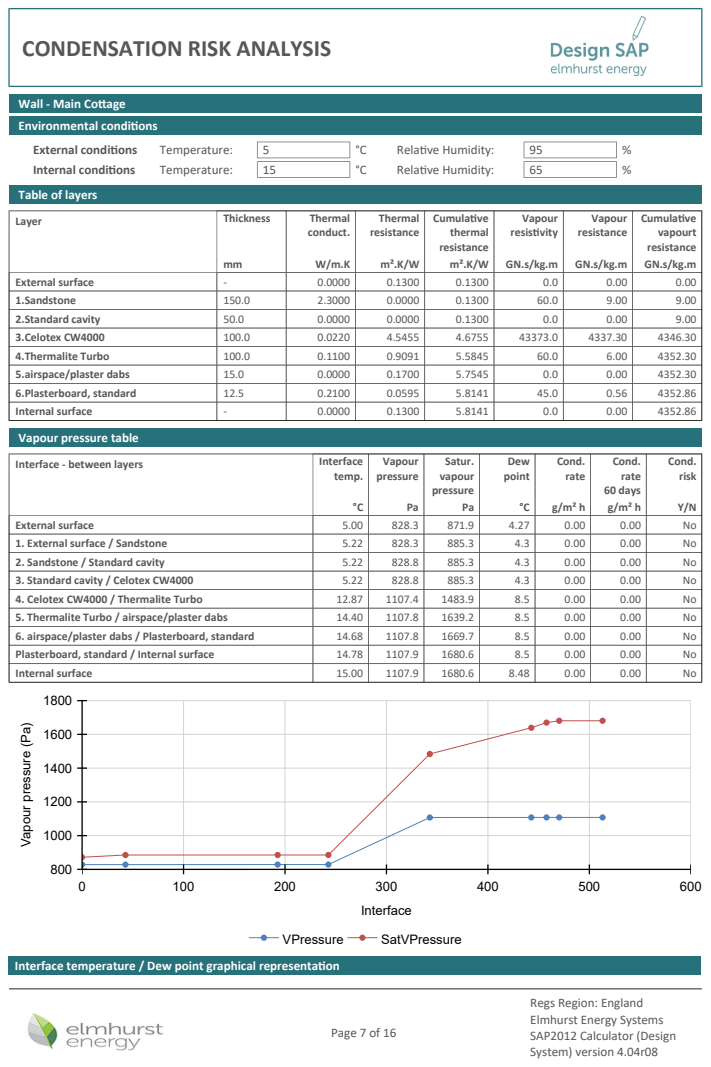
[picture p102: page 7]
Layer; Thickness; Thermal; conduct.; Thermal resistance; Cumulave thermal resistance; Vapour resisvity; Vapour resistance; Cumulave vapourt resistance; External surface; 1.Sandstone; 2.Standard cavity; 3.Celotex CW4000; 4.Thermalite Turbo; 5.airspace/plaster dabs; 6.Plasterboard, standard; Internal surface; Interface - between layers; Interface; temp.; Vapour pressure; Satur. vapour pressure; Dew point; Cond. rate; Cond. rate 60 days; Cond. risk; 1. External surface / Sandstone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

Wall - Main Coage
Environmental condions
Table of layers

Vapour pressure table

Vapour pressure (Pa)

Interface temperature / Dew point graphical representaon

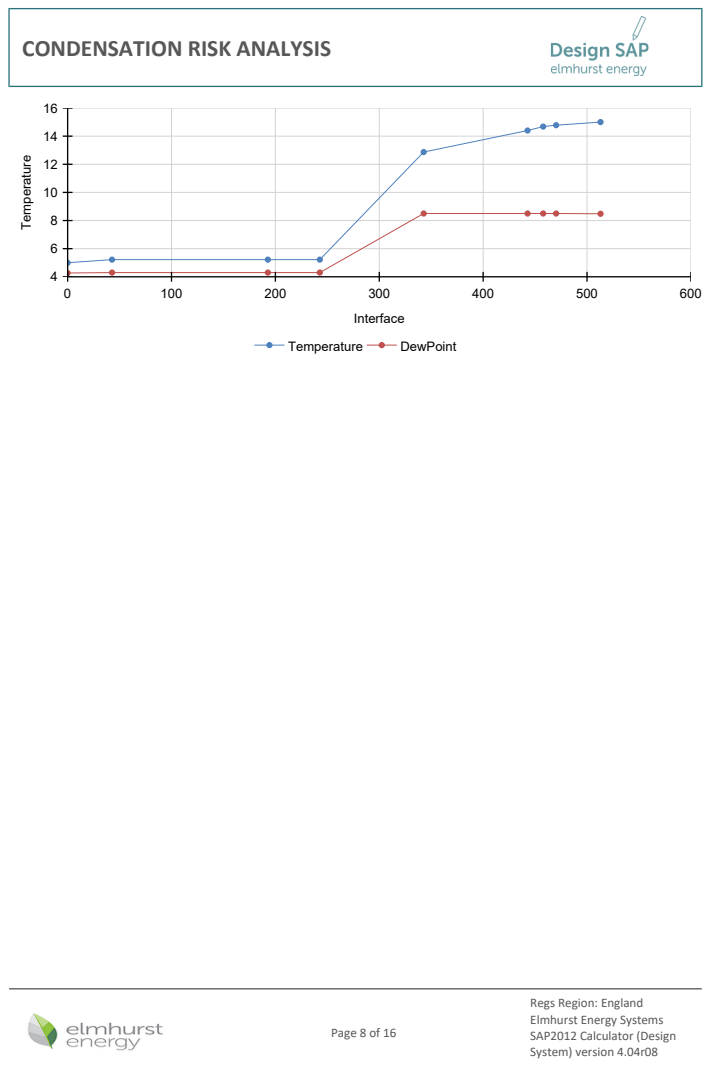
[picture p103: page 8]
Interface; Temperature; DewPoint

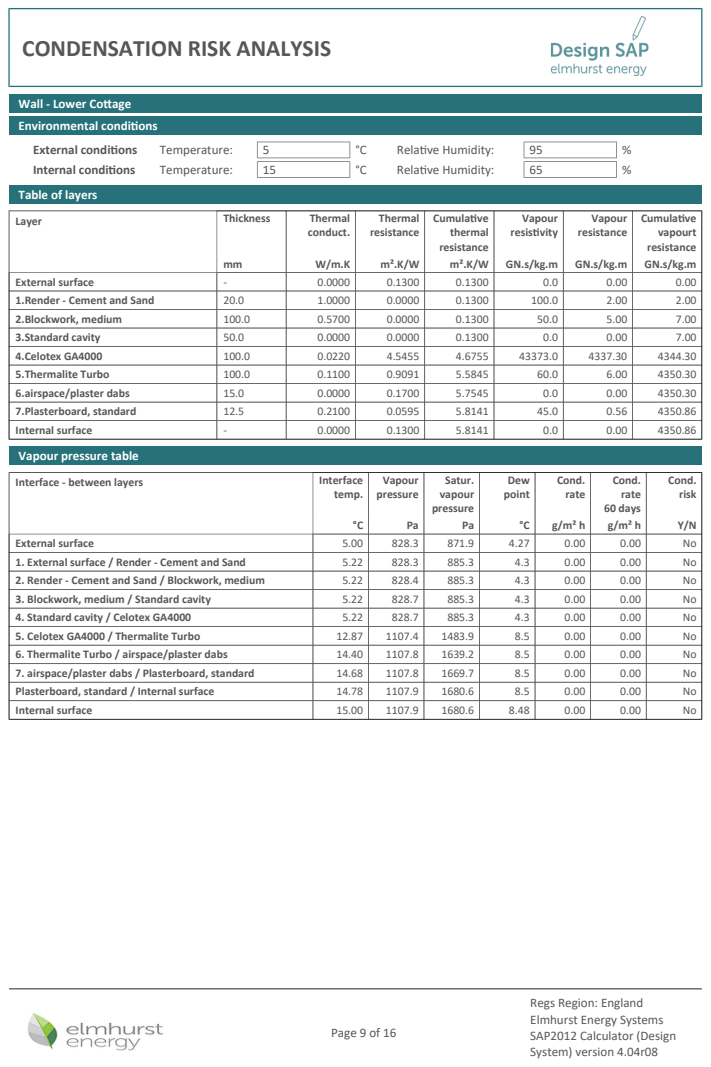
[picture p104: page 9]
Layer; Thickness; Thermal; conduct.; Thermal resistance; Cumulave thermal resistance; Vapour resisvity; Vapour resistance; Cumulave vapourt resistance; External surface; 1.Render - Cement and Sand; 2.Blockwork, medium; 3.Standard cavity; 4.Celotex GA4000; 5.Thermalite Turbo; 6.airspace/plaster dabs; 7.Plasterboard, standard; Internal surface; Interface - between layers; Interface; temp.; Vapour pressure; Satur. vapour pressure; Dew point; Cond. rate; Cond. rate 60 days; Cond. risk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

Wall - Lower Coage
Environmental condions
Table of layers

Vapour pressure table

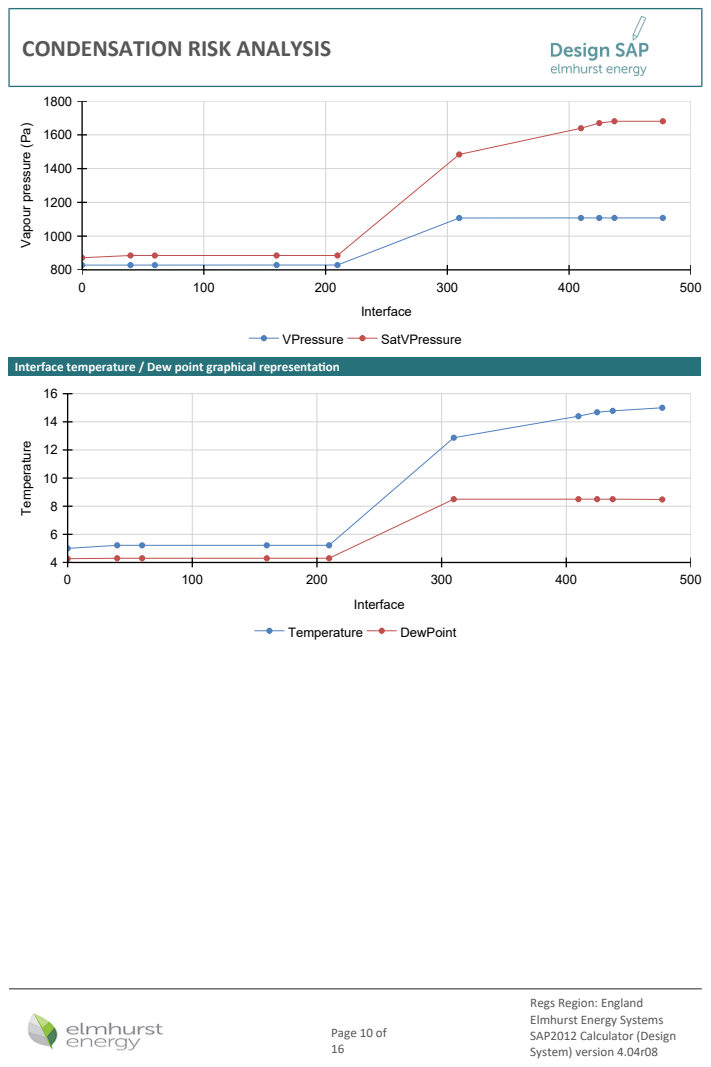
[picture p105: page 10]
Interface; VPressure; SatVPressure; Temperature; DewPoint; Page 10 of

Vapour pressure (Pa)

Interface temperature / Dew point graphical representaon

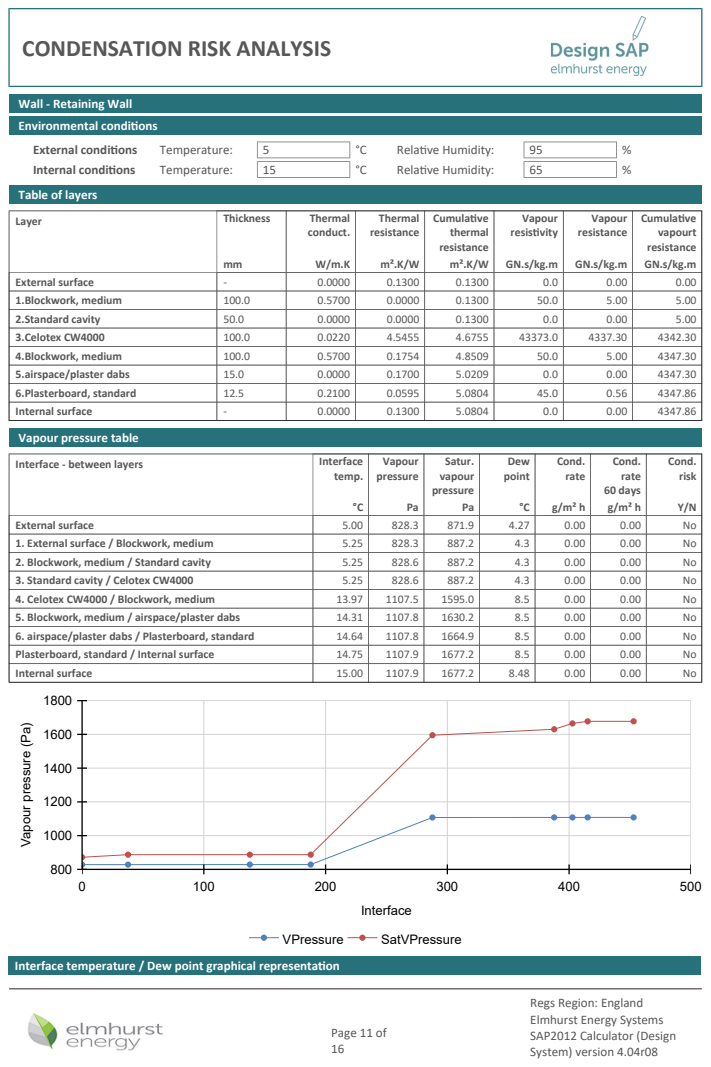
[picture p106: page 11]
Layer; Thickness; Thermal; conduct.; Thermal resistance; Cumulave thermal resistance; Vapour resisvity; Vapour resistance; Cumulave vapourt resistance; External surface; 1.Blockwork, medium; 2.Standard cavity; 3.Celotex CW4000; 4.Blockwork, medium; 5.airspace/plaster dabs; 6.Plasterboard, standard; Internal surface; Interface - between layers; Interface; temp.; Vapour pressure; Satur. vapour pressure; Dew point; Cond. rate; Cond. rate 60 days; Cond. risk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

Wall - Retaining Wall
Environmental condions
Table of layers

Vapour pressure table

Vapour pressure (Pa)

Interface temperature / Dew point graphical representaon

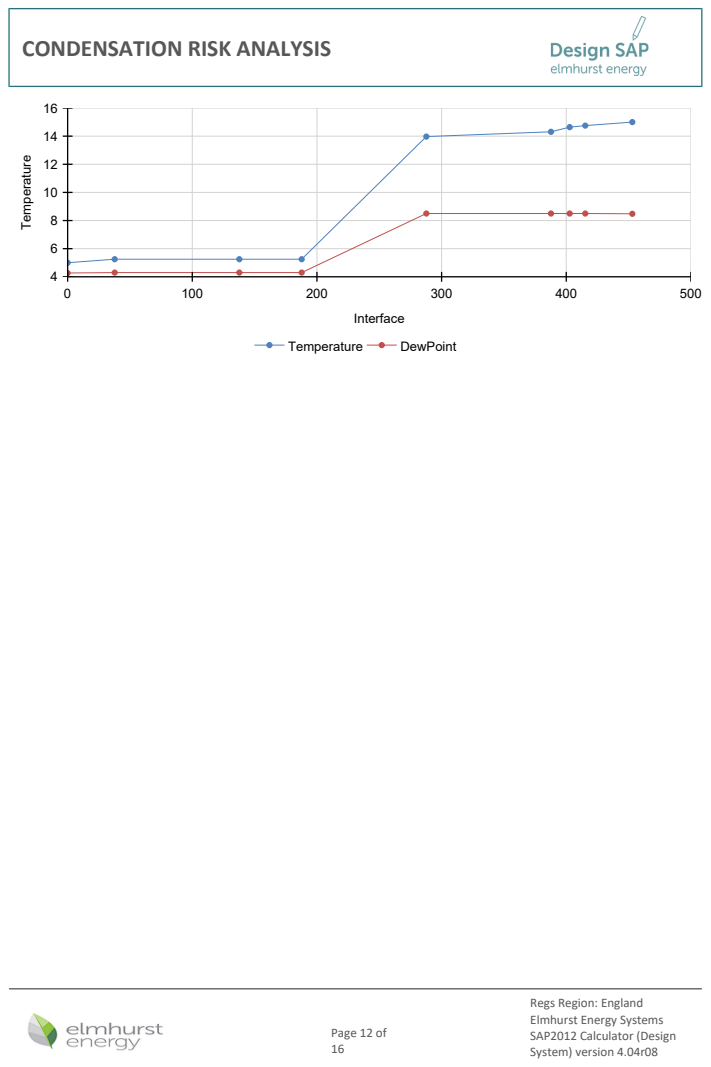
[picture p107: page 12]
Interface; Temperature; DewPoint; Page 12 of

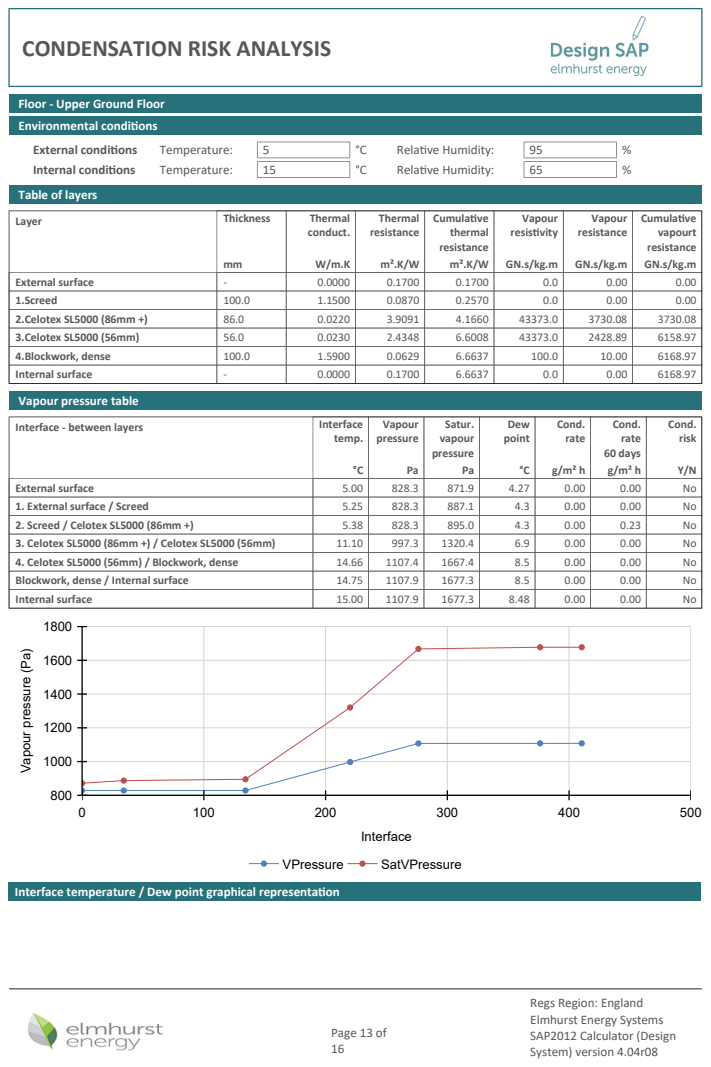
[picture p108: page 13]
Layer; Thickness; Thermal; conduct.; Thermal resistance; Cumulave thermal resistance; Vapour resisvity; Vapour resistance; Cumulave vapourt resistance; External surface; 1.Screed; 2.Celotex SL5000 (86mm +); 3.Celotex SL5000 (56mm); 4.Blockwork, dense; Internal surface; Interface - between layers; Interface; temp.; Vapour pressure; Satur. vapour pressure; Dew point; Cond. rate; Cond. rate 60 days; Cond. risk; 1. External surface / Screed; 2. Screed / Celotex SL5000 (86mm +)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

Floor - Upper Ground Floor
Environmental condions
Table of layers

Vapour pressure table

Vapour pressure (Pa)

Interface temperature / Dew point graphical representaon

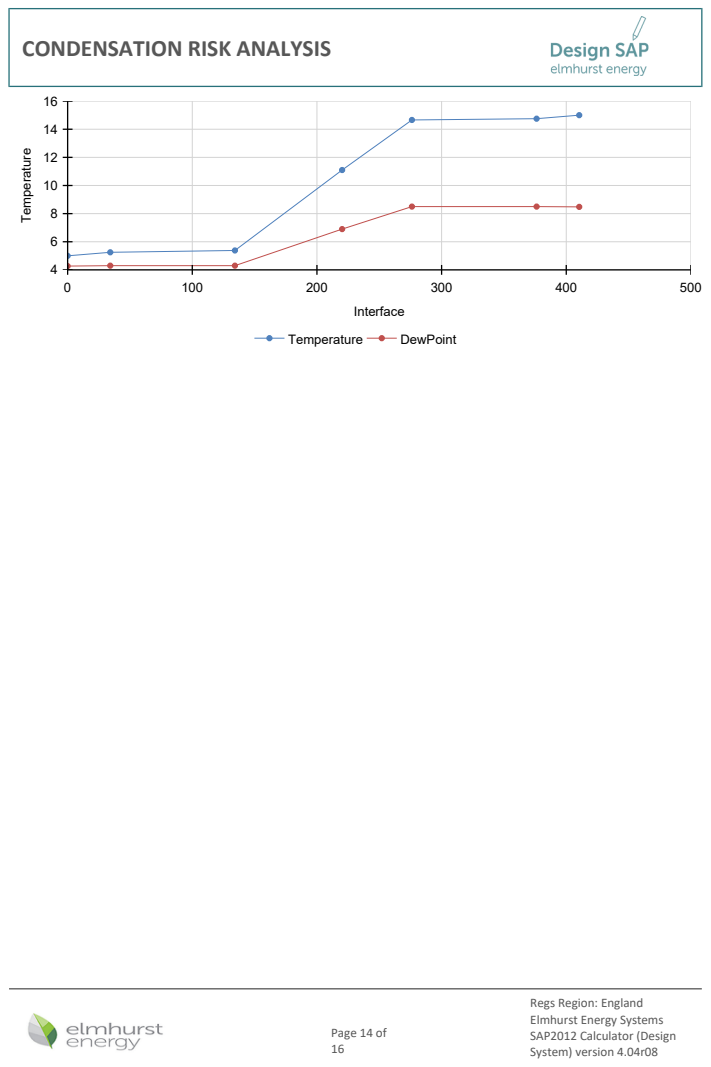
[picture p109: page 14]
Interface; Temperature; DewPoint; Page 14 of

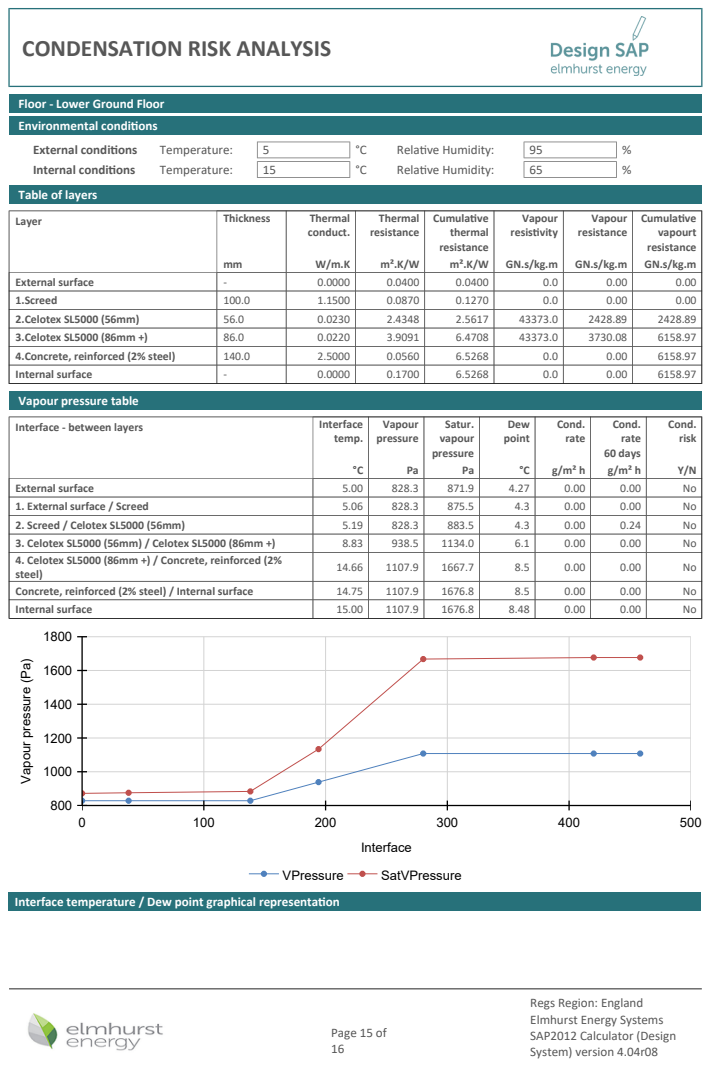
[picture p110: page 15]
Layer; Thickness; Thermal; conduct.; Thermal resistance; Cumulave thermal resistance; Vapour resisvity; Vapour resistance; Cumulave vapourt resistance; External surface; 1.Screed; 2.Celotex SL5000 (56mm); 3.Celotex SL5000 (86mm +); 4.Concrete, reinforced (2% steel); Internal surface; Interface - between layers; Interface; temp.; Vapour pressure; Satur. vapour pressure; Dew point; Cond. rate; Cond. rate 60 days; Cond. risk; 1. External surface / Screed; 2. Screed / Celotex SL5000 (56mm)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

Floor - Lower Ground Floor
Environmental condions
Table of layers

Vapour pressure table

Vapour pressure (Pa)

Interface temperature / Dew point graphical representaon

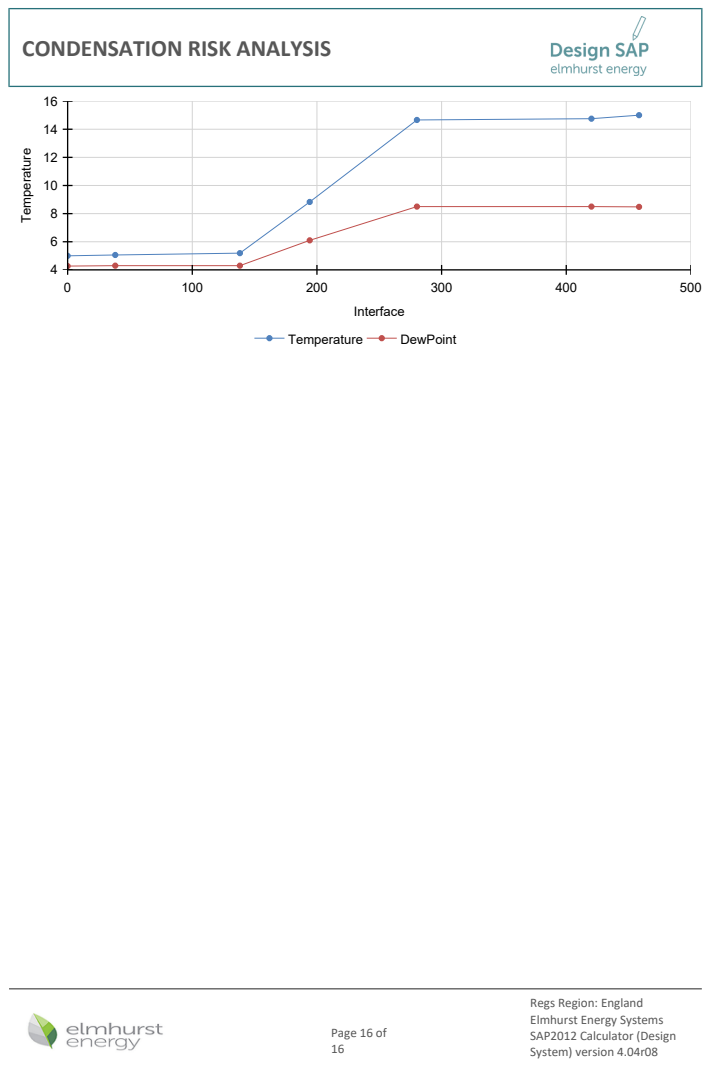
[picture p111: page 16]
Interface; Temperature; DewPoint; Page 16 of
