DanielBryars/ChadHouse/SAP/UValue_Calculator_Report_S17212.pdf

# U-VALUE CALCULATOR REPORT

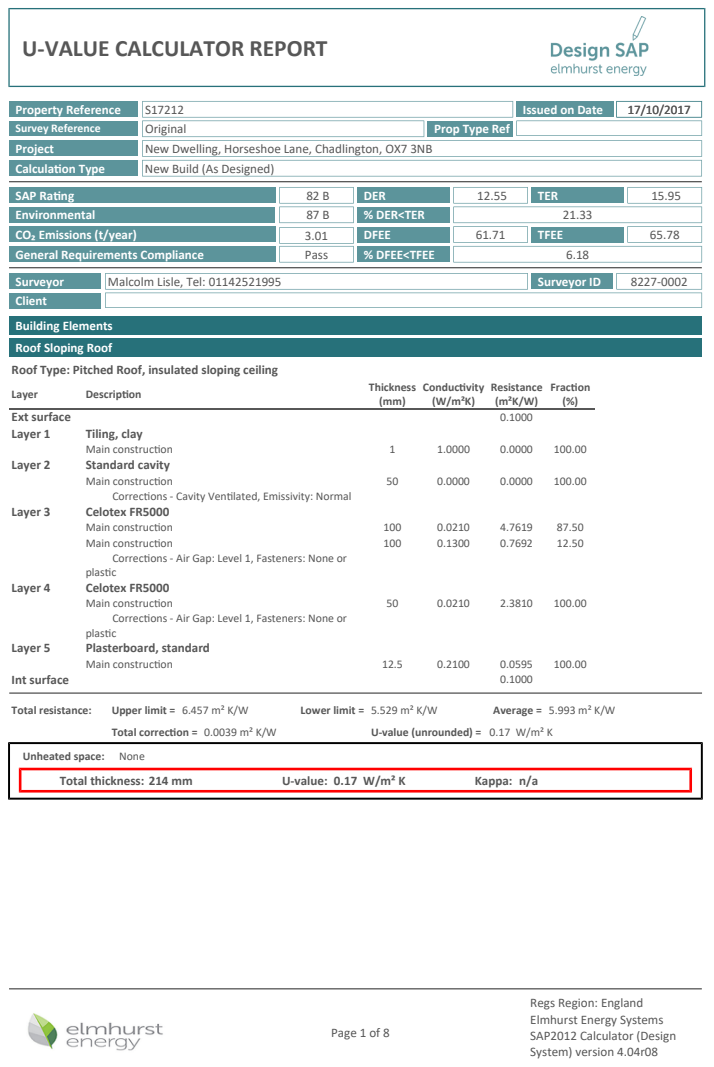
[picture p112: page 1]
Total resistance:; Upper limit = 6.457 m² K/W; Lower limit = 5.529 m² K/W; Average = 5.993 m² K/W; Total correcon = 0.0039 m² K/W; U-value (unrounded) = 0.17 W/m² K; Unheated space:; None; Total thickness: 214 mm; U-value: 0.17 W/m² K; Kappa: n/a; Layer; Descripon; Thickness (mm); Conducvity (W/m²K); Resistance (m²K/W); Fracon (%); Ext surface; Layer 1; Tiling, clay; Main construcon; Layer 2; Standard cavity; Layer 3; Celotex FR5000; Layer 4; Layer 5; Plasterboard, standard; Int surface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

Prop Type Ref

SAP Rang
Environmental
CO₂ Emissions (t/year)
General Requirements Compliance

Client
Building Elements
Roof Sloping Roof
Roof Type: Pitched Roof, insulated sloping ceiling

Correcons - Cavity Venlated, Emissivity: Normal

Correcons - Air Gap: Level 1, Fasteners: None or
plasc

Regs Region: England
Elmhurst Energy Systems
SAP2012 Calculator (Design
System) version 4.04r08

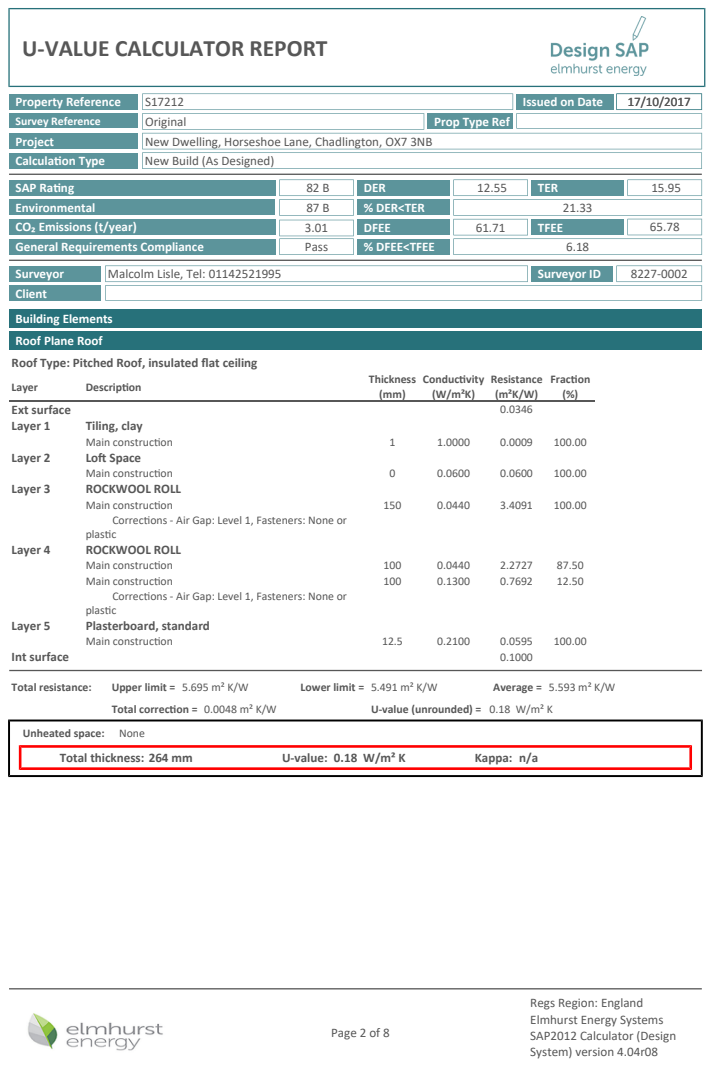
[picture p113: page 2]
Total resistance:; Upper limit = 5.695 m² K/W; Lower limit = 5.491 m² K/W; Average = 5.593 m² K/W; Total correcon = 0.0048 m² K/W; U-value (unrounded) = 0.18 W/m² K; Unheated space:; None; Total thickness: 264 mm; U-value: 0.18 W/m² K; Kappa: n/a; Layer; Descripon; Thickness (mm); Conducvity (W/m²K); Resistance (m²K/W); Fracon (%); Ext surface; Layer 1; Tiling, clay; Main construcon; Layer 2; Lo Space; Layer 3; ROCKWOOL ROLL; Layer 4; Layer 5; Plasterboard, standard; Int surface; Surveyor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

Prop Type Ref

SAP Rang
Environmental
CO₂ Emissions (t/year)
General Requirements Compliance

Client
Building Elements
Roof Plane Roof
Roof Type: Pitched Roof, insulated at ceiling

Correcons - Air Gap: Level 1, Fasteners: None or
plasc

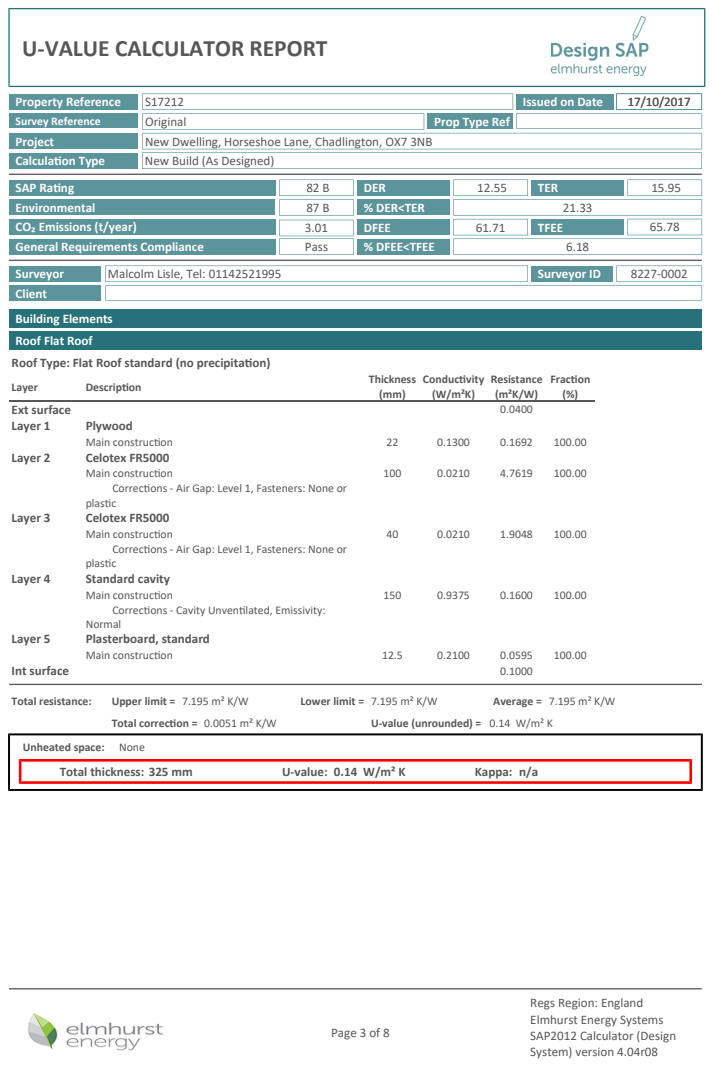
[picture p114: page 3]
Total resistance:; Upper limit = 7.195 m² K/W; Lower limit = 7.195 m² K/W; Average = 7.195 m² K/W; Total correcon = 0.0051 m² K/W; U-value (unrounded) = 0.14 W/m² K; Unheated space:; None; Total thickness: 325 mm; U-value: 0.14 W/m² K; Kappa: n/a; Layer; Descripon; Thickness (mm); Conducvity (W/m²K); Resistance (m²K/W); Fracon (%); Ext surface; Layer 1; Plywood; Main construcon; Layer 2; Celotex FR5000; Layer 3; Layer 4; Standard cavity; Layer 5; Plasterboard, standard; Int surface; Surveyor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

Prop Type Ref

SAP Rang
Environmental
CO₂ Emissions (t/year)
General Requirements Compliance

Client
Building Elements
Roof Flat Roof
Roof Type: Flat Roof standard (no precipitaon)

Correcons - Air Gap: Level 1, Fasteners: None or
plasc

Correcons - Cavity Unvenlated, Emissivity:
Normal

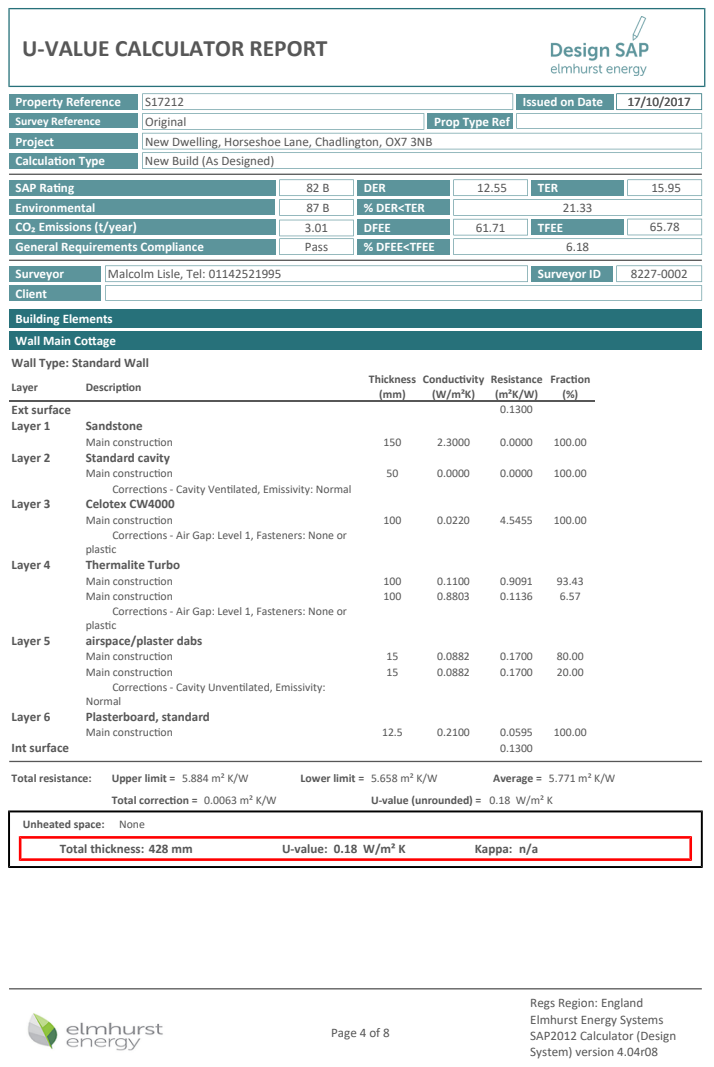
[picture p115: page 4]
Total resistance:; Upper limit = 5.884 m² K/W; Lower limit = 5.658 m² K/W; Average = 5.771 m² K/W; Total correcon = 0.0063 m² K/W; U-value (unrounded) = 0.18 W/m² K; Unheated space:; None; Total thickness: 428 mm; U-value: 0.18 W/m² K; Kappa: n/a; Layer; Descripon; Thickness (mm); Conducvity (W/m²K); Resistance (m²K/W); Fracon (%); Ext surface; Layer 1; Sandstone; Main construcon; Layer 2; Standard cavity; Layer 3; Celotex CW4000; Layer 4; Thermalite Turbo; Layer 5; airspace/plaster dabs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

Prop Type Ref

SAP Rang
Environmental
CO₂ Emissions (t/year)
General Requirements Compliance

Client
Building Elements
Wall Main Coage
Wall Type: Standard Wall

Correcons - Cavity Venlated, Emissivity: Normal

Correcons - Air Gap: Level 1, Fasteners: None or
plasc

Correcons - Cavity Unvenlated, Emissivity:
Normal

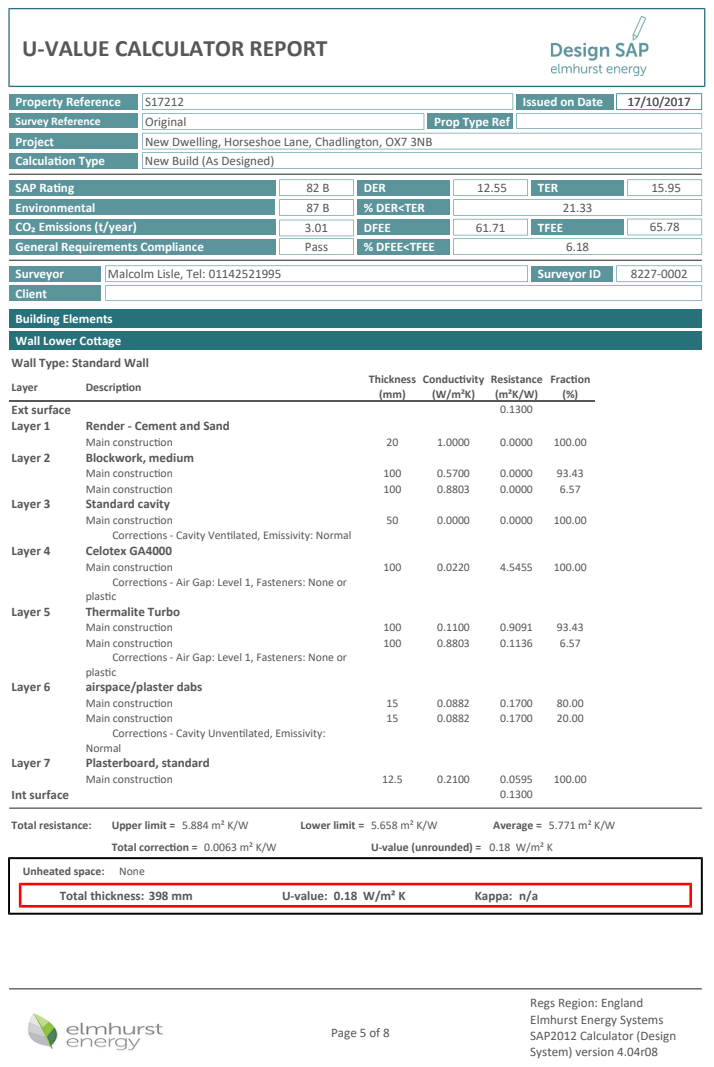
[picture p116: page 5]
Total resistance:; Upper limit = 5.884 m² K/W; Lower limit = 5.658 m² K/W; Average = 5.771 m² K/W; Total correcon = 0.0063 m² K/W; U-value (unrounded) = 0.18 W/m² K; Unheated space:; None; Total thickness: 398 mm; U-value: 0.18 W/m² K; Kappa: n/a; Layer; Descripon; Thickness (mm); Conducvity (W/m²K); Resistance (m²K/W); Fracon (%); Ext surface; Layer 1; Render - Cement and Sand; Main construcon; Layer 2; Blockwork, medium; Layer 3; Standard cavity; Layer 4; Celotex GA4000; Layer 5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

Prop Type Ref

SAP Rang
Environmental
CO₂ Emissions (t/year)
General Requirements Compliance

Client
Building Elements
Wall Lower Coage
Wall Type: Standard Wall

Correcons - Cavity Venlated, Emissivity: Normal

Correcons - Air Gap: Level 1, Fasteners: None or
plasc

Correcons - Cavity Unvenlated, Emissivity:
Normal

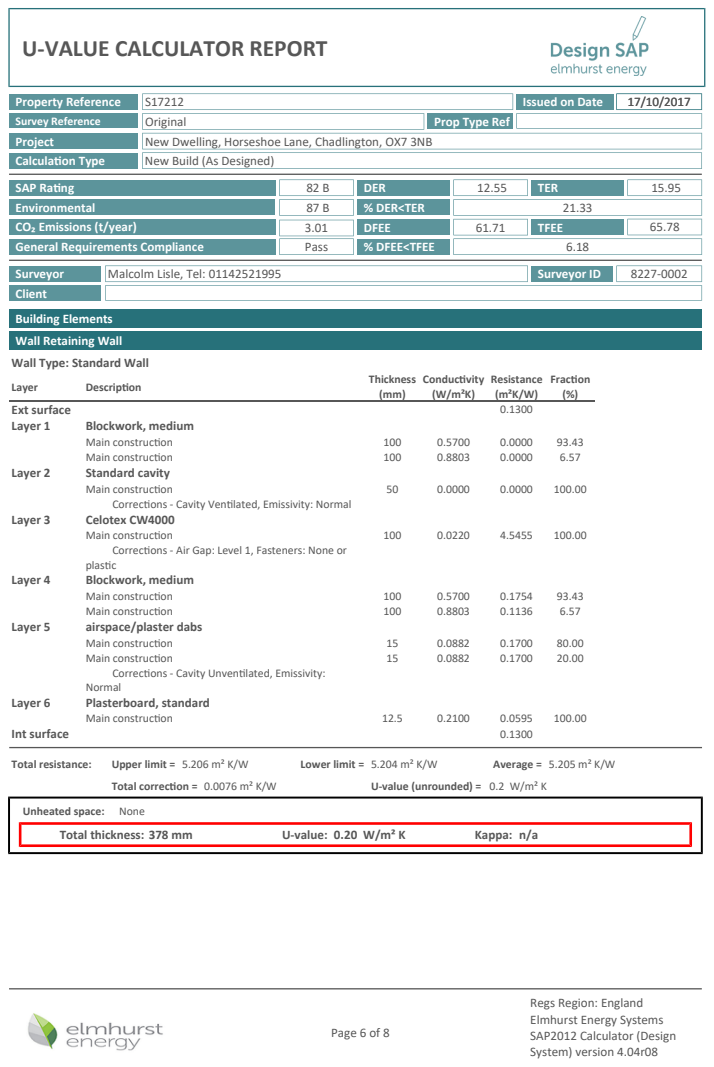
[picture p117: page 6]
Total resistance:; Upper limit = 5.206 m² K/W; Lower limit = 5.204 m² K/W; Average = 5.205 m² K/W; Total correcon = 0.0076 m² K/W; U-value (unrounded) = 0.2 W/m² K; Unheated space:; None; Total thickness: 378 mm; U-value: 0.20 W/m² K; Kappa: n/a; Layer; Descripon; Thickness (mm); Conducvity (W/m²K); Resistance (m²K/W); Fracon (%); Ext surface; Layer 1; Blockwork, medium; Main construcon; Layer 2; Standard cavity; Layer 3; Celotex CW4000; Layer 4; Layer 5; airspace/plaster dabs; Layer 6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

Prop Type Ref

SAP Rang
Environmental
CO₂ Emissions (t/year)
General Requirements Compliance

Client
Building Elements
Wall Retaining Wall
Wall Type: Standard Wall

Correcons - Cavity Venlated, Emissivity: Normal

Correcons - Air Gap: Level 1, Fasteners: None or
plasc

Correcons - Cavity Unvenlated, Emissivity:
Normal

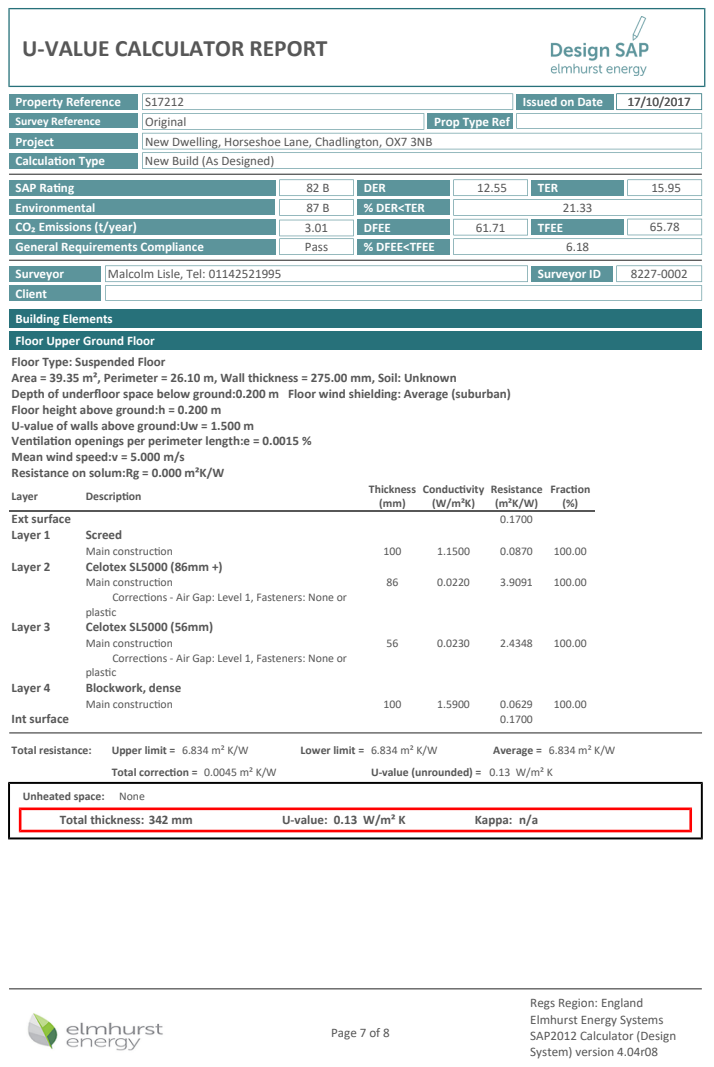
[picture p118: page 7]
Total resistance:; Upper limit = 6.834 m² K/W; Lower limit = 6.834 m² K/W; Average = 6.834 m² K/W; Total correcon = 0.0045 m² K/W; U-value (unrounded) = 0.13 W/m² K; Unheated space:; None; Total thickness: 342 mm; U-value: 0.13 W/m² K; Kappa: n/a; Layer; Descripon; Thickness (mm); Conducvity (W/m²K); Resistance (m²K/W); Fracon (%); Ext surface; Layer 1; Screed; Main construcon; Layer 2; Celotex SL5000 (86mm +); Layer 3; Celotex SL5000 (56mm); Layer 4; Blockwork, dense; Int surface; Surveyor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

Prop Type Ref

SAP Rang
Environmental
CO₂ Emissions (t/year)
General Requirements Compliance

Client
Building Elements
Floor Upper Ground Floor
Floor Type: Suspended Floor
Area = 39.35 m², Perimeter = 26.10 m, Wall thickness = 275.00 mm, Soil: Unknown
Depth of underoor space below ground:0.200 m Floor wind shielding: Average (suburban)
Floor height above ground:h = 0.200 m
U-value of walls above ground:Uw = 1.500 m
Venlaon openings per perimeter length:e = 0.0015 %
Mean wind speed:v = 5.000 m/s
Resistance on solum:Rg = 0.000 m²K/W

Correcons - Air Gap: Level 1, Fasteners: None or
plasc

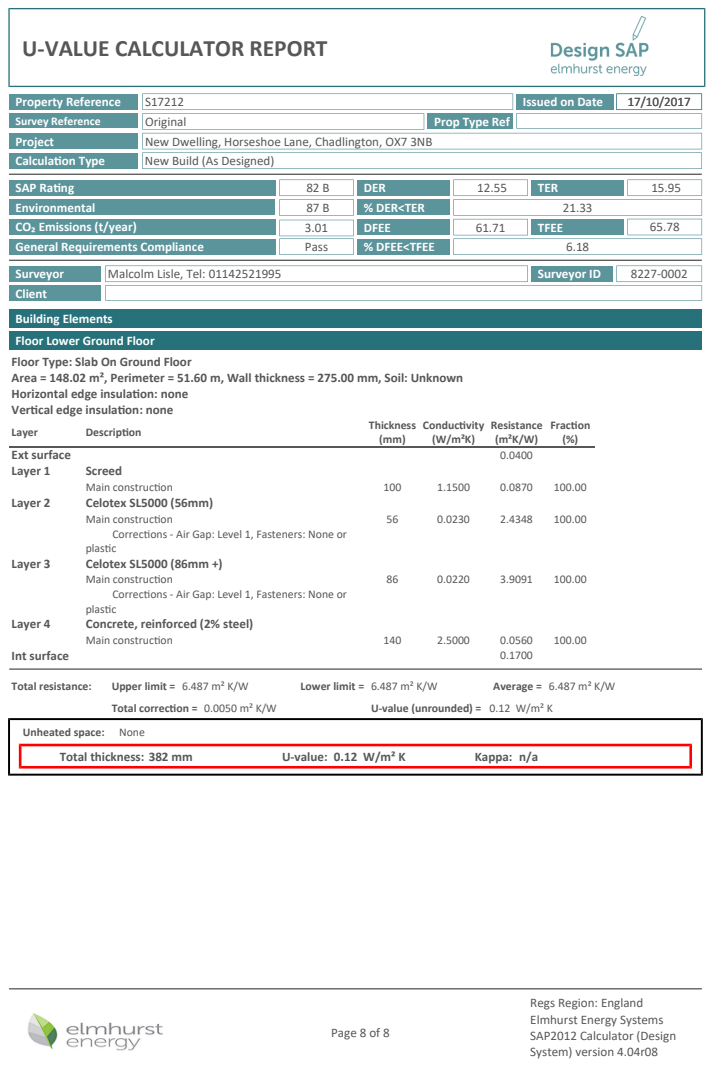
[picture p119: page 8]
Total resistance:; Upper limit = 6.487 m² K/W; Lower limit = 6.487 m² K/W; Average = 6.487 m² K/W; Total correcon = 0.0050 m² K/W; U-value (unrounded) = 0.12 W/m² K; Unheated space:; None; Total thickness: 382 mm; U-value: 0.12 W/m² K; Kappa: n/a; Layer; Descripon; Thickness (mm); Conducvity (W/m²K); Resistance (m²K/W); Fracon (%); Ext surface; Layer 1; Screed; Main construcon; Layer 2; Celotex SL5000 (56mm); Layer 3; Celotex SL5000 (86mm +); Layer 4; Concrete, reinforced (2% steel)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

Prop Type Ref

SAP Rang
Environmental
CO₂ Emissions (t/year)
General Requirements Compliance

Client
Building Elements
Floor Lower Ground Floor
Floor Type: Slab On Ground Floor
Area = 148.02 m², Perimeter = 51.60 m, Wall thickness = 275.00 mm, Soil: Unknown
Horizontal edge insulaon: none
Vercal edge insulaon: none

Correcons - Air Gap: Level 1, Fasteners: None or
plasc
