DanielBryars/ChadHouse/Underfloor Heating/AppleBrookHouse-Drawing2.PDF

## Manifold 2

(37. 5 °C)

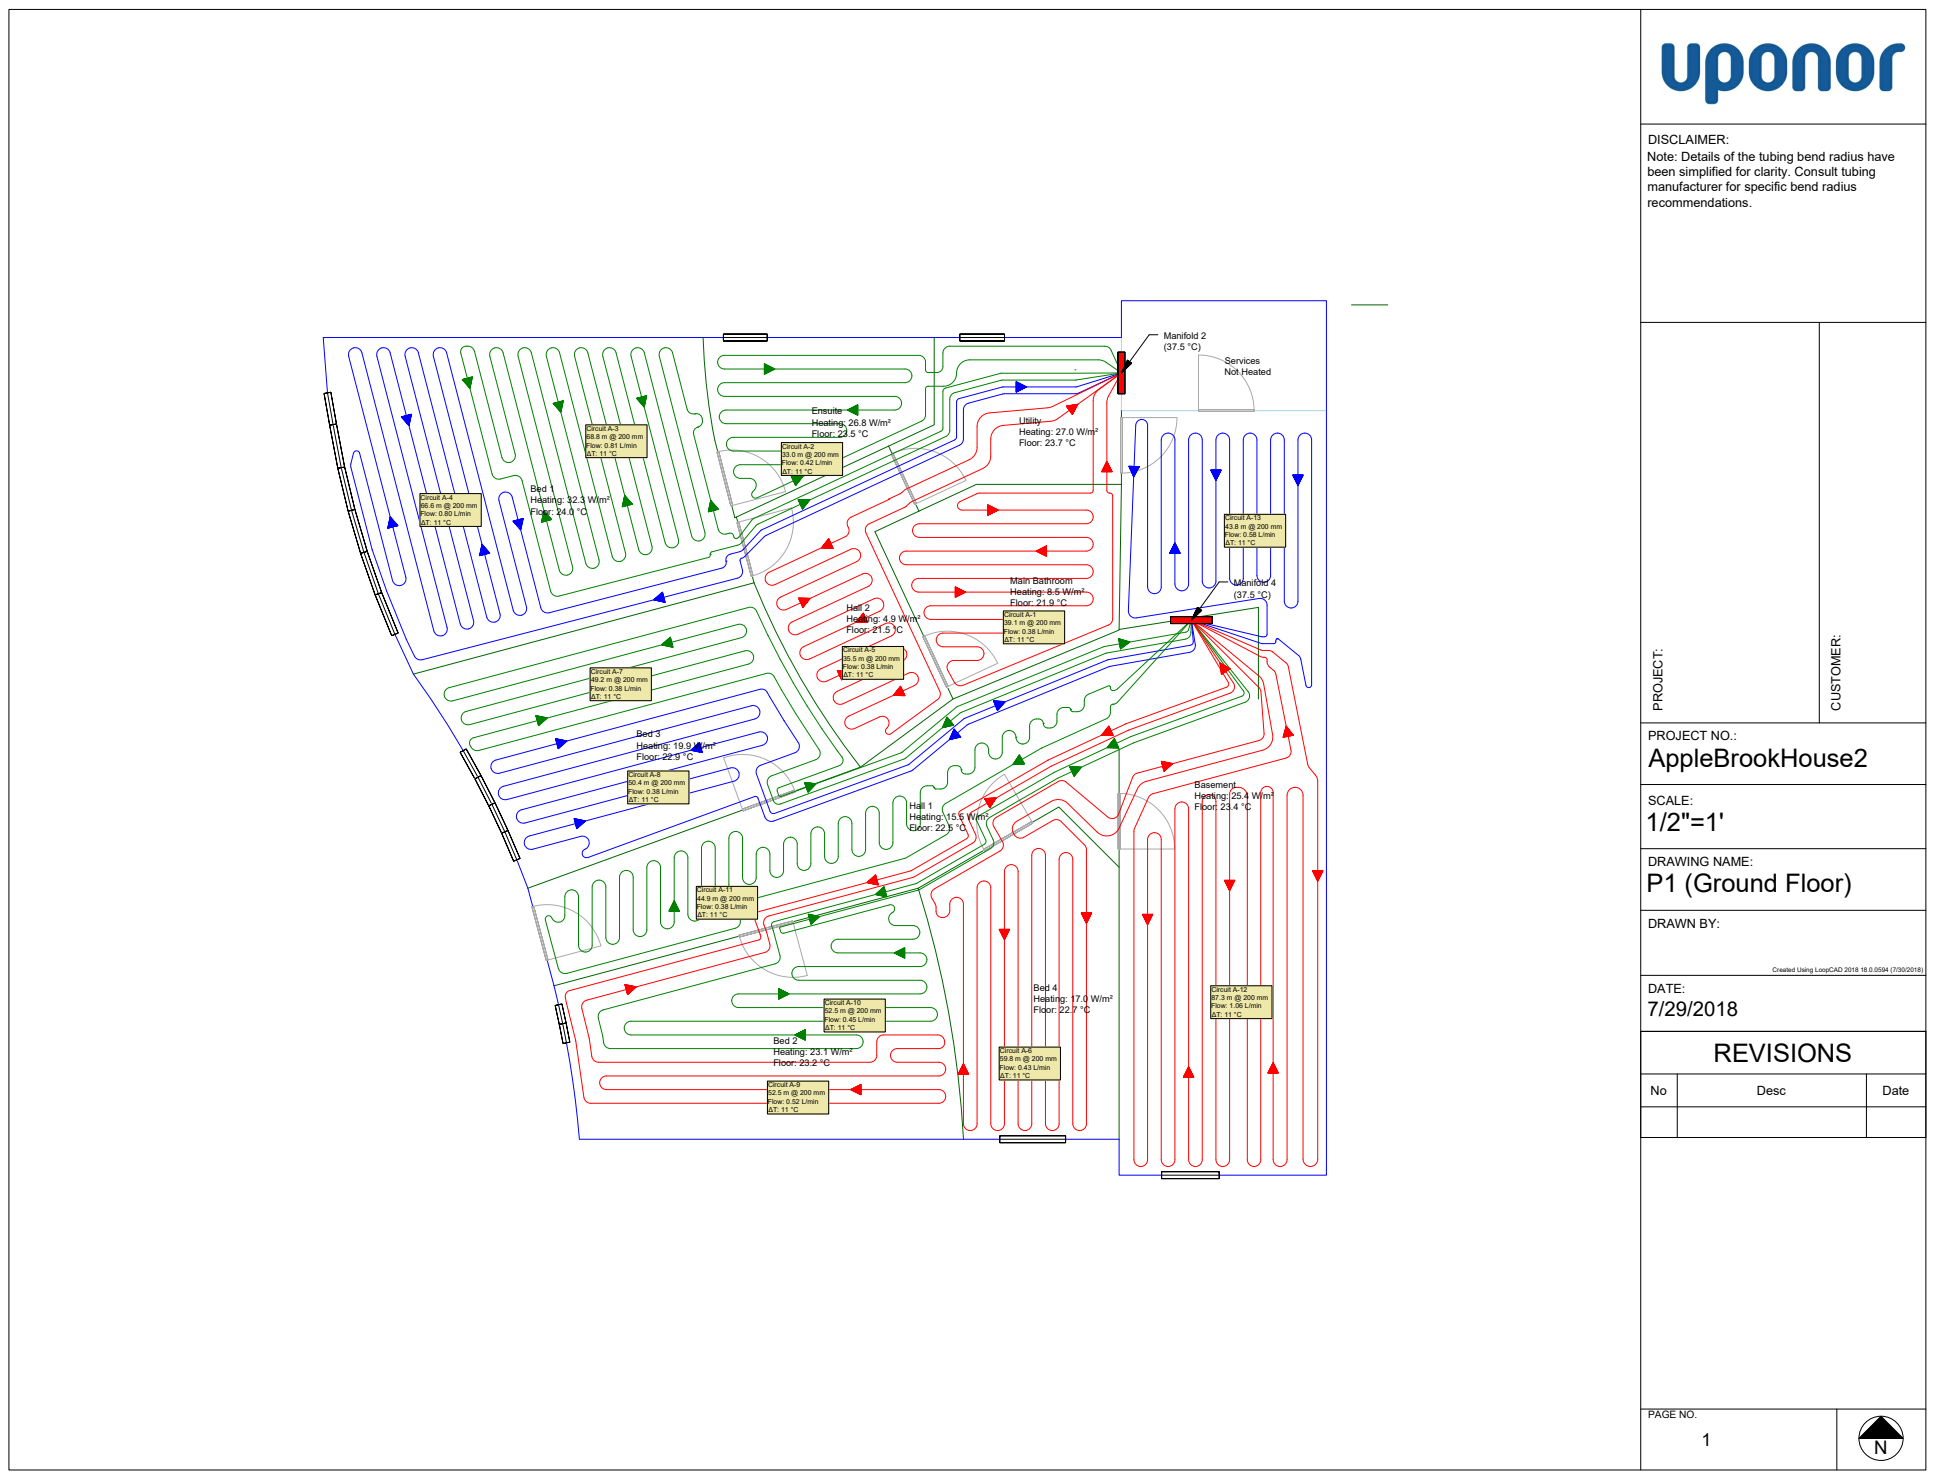
[picture p120: page 1]
Bed 4; Heating: 17.; Floor:; Bed 2; Heating: 23.; Floor: 23.2 °C; Bed 3; Heating: 19.; Floor: 22.; Basement; Heating:; Floor: 23.4 °C; Services; Not Heated; Utility; Heating: 27.; Floor: 23.; Hall 2; Heating: 4.; Floor: 21.; Ensuite; Heating: 26.; Bed 1; Heating: 32.; Floor: 24.; Hall 1; Heating: 15.; Main Bathroom; Heating: 8.; Circuit A-2; Flow: 0.42 L/min; Circuit A-; Flow: 0.; 38 L/min; Circuit A-4; 80 L/min; Circuit A-3; 81 L/min; Circuit A-5; Circuit A-8; Circuit A-7; Flow: 0.45 L/min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

Note: Details of the tubing bend radius have

manufacturer for specific bend radius

PAGE NO. PROJECT:

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

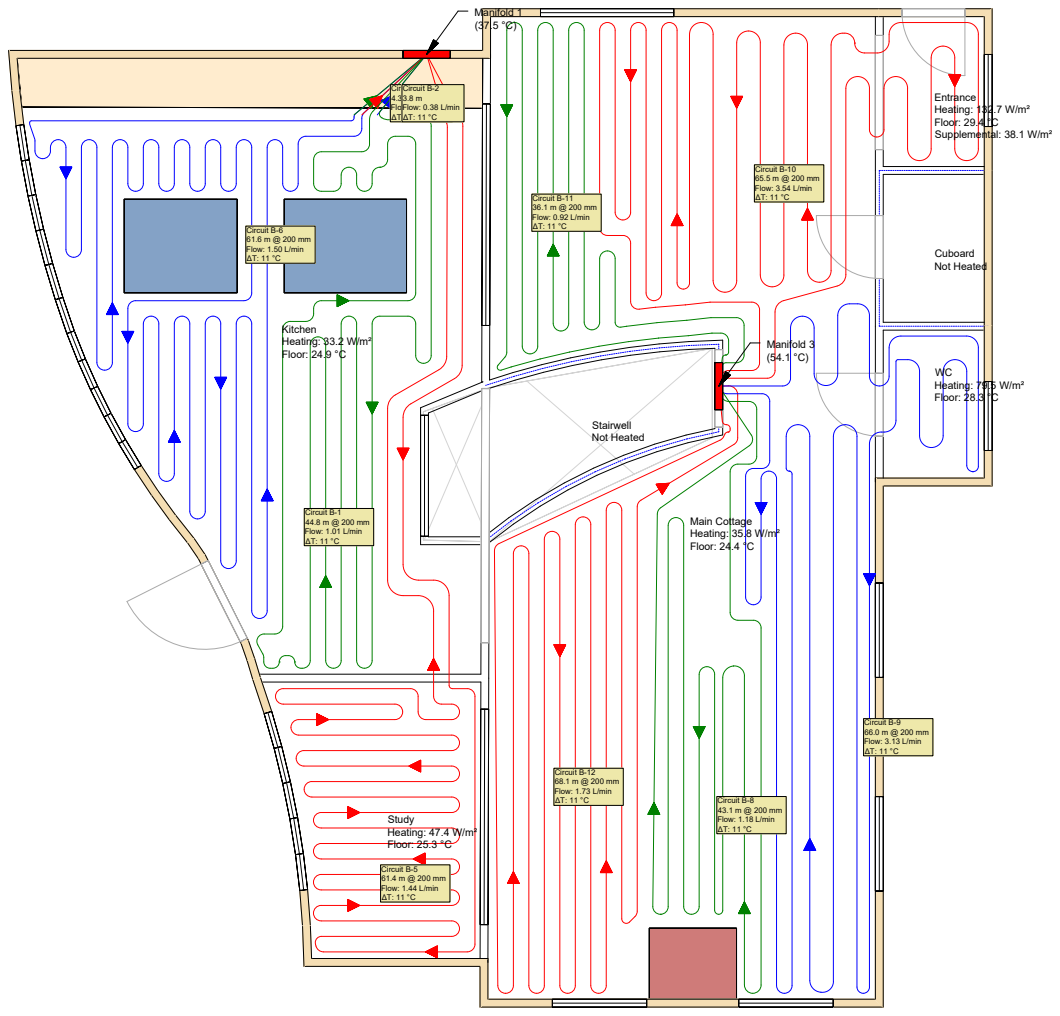
[picture p121: page 2]
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
