DanielBryars/ChadHouse/Underfloor Heating/AppleBrookHouse2-LoopCAD Drawing.PDF

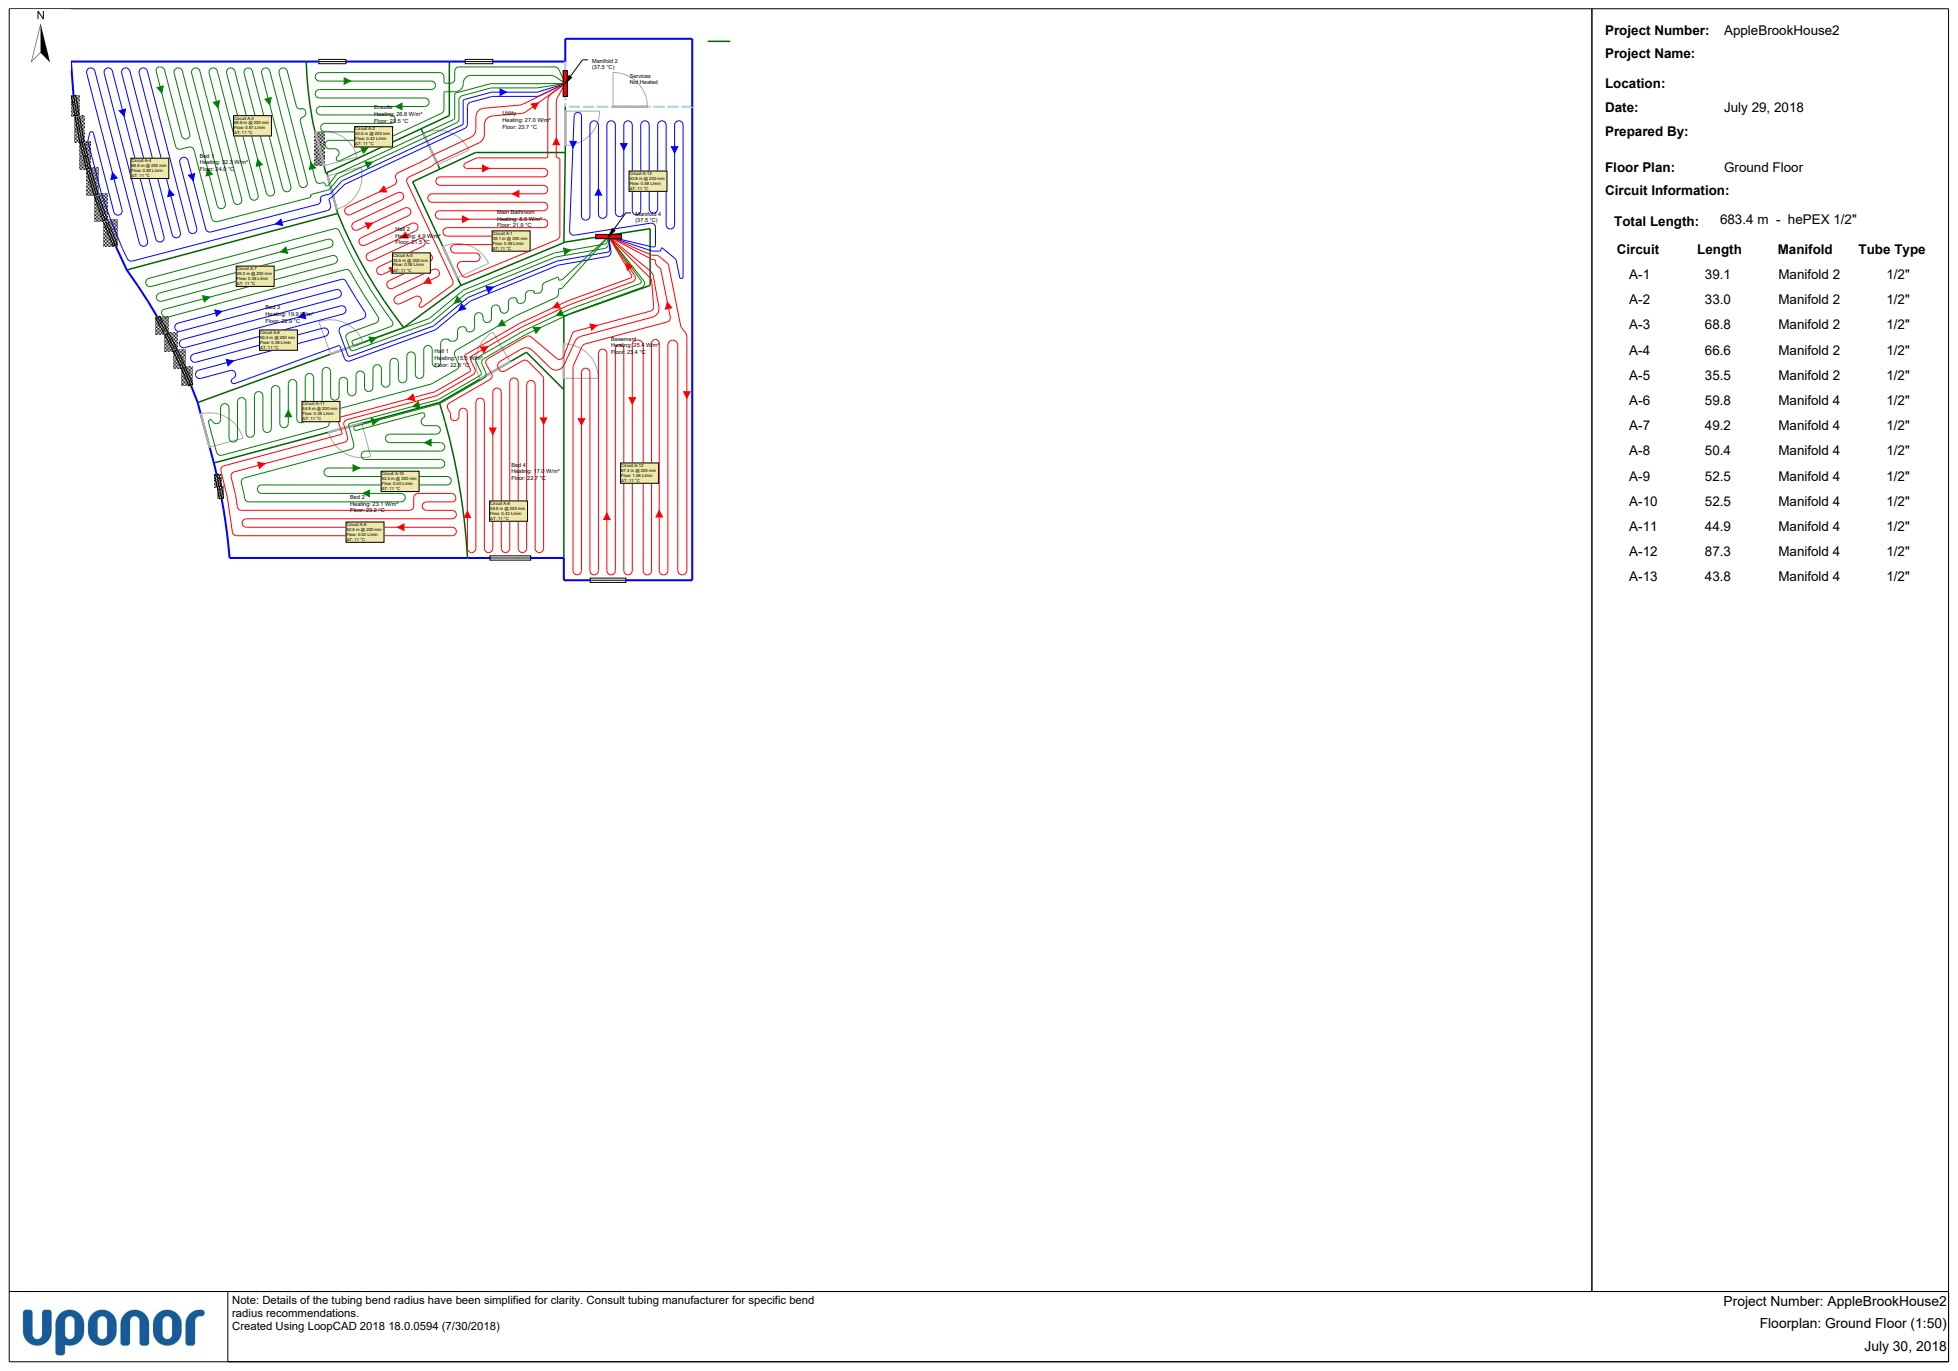
[picture p122: page 1]
Project Number: AppleBrookHouse2; Project Name:; Location:; Date:; July 29, 2018; Prepared By:; Floor Plan:; Ground Floor; Circuit Information:; Total Length:; 683.4 m - hePEX 1/2"; Circuit; Length; Manifold; Tube Type; Manifold 2; Manifold 4; July 30, 2018; Bed 4 Heating: 17.0 W/m² Floor: 22.7 °C; Bed 2 Heating: 23.1 W/m² Floor: 23.2 °C; Bed 3 Heating: 19.9 W/m² Floor: 22.9 °C; Basement Heating: 25.4 W/m² Floor: 23.4 °C; Services Not Heated; Utility Heating: 27.0 W/m² Floor: 23.7 °C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

Note: Details of the tubing bend radius have been simplified for clarity. Consult tubing manufacturer for specific bend
radius recommendations.
Created Using LoopCAD 2018 18.0.0594 (7/30/2018)

Project Number: AppleBrookHouse2
Floorplan: Ground Floor (1:50)

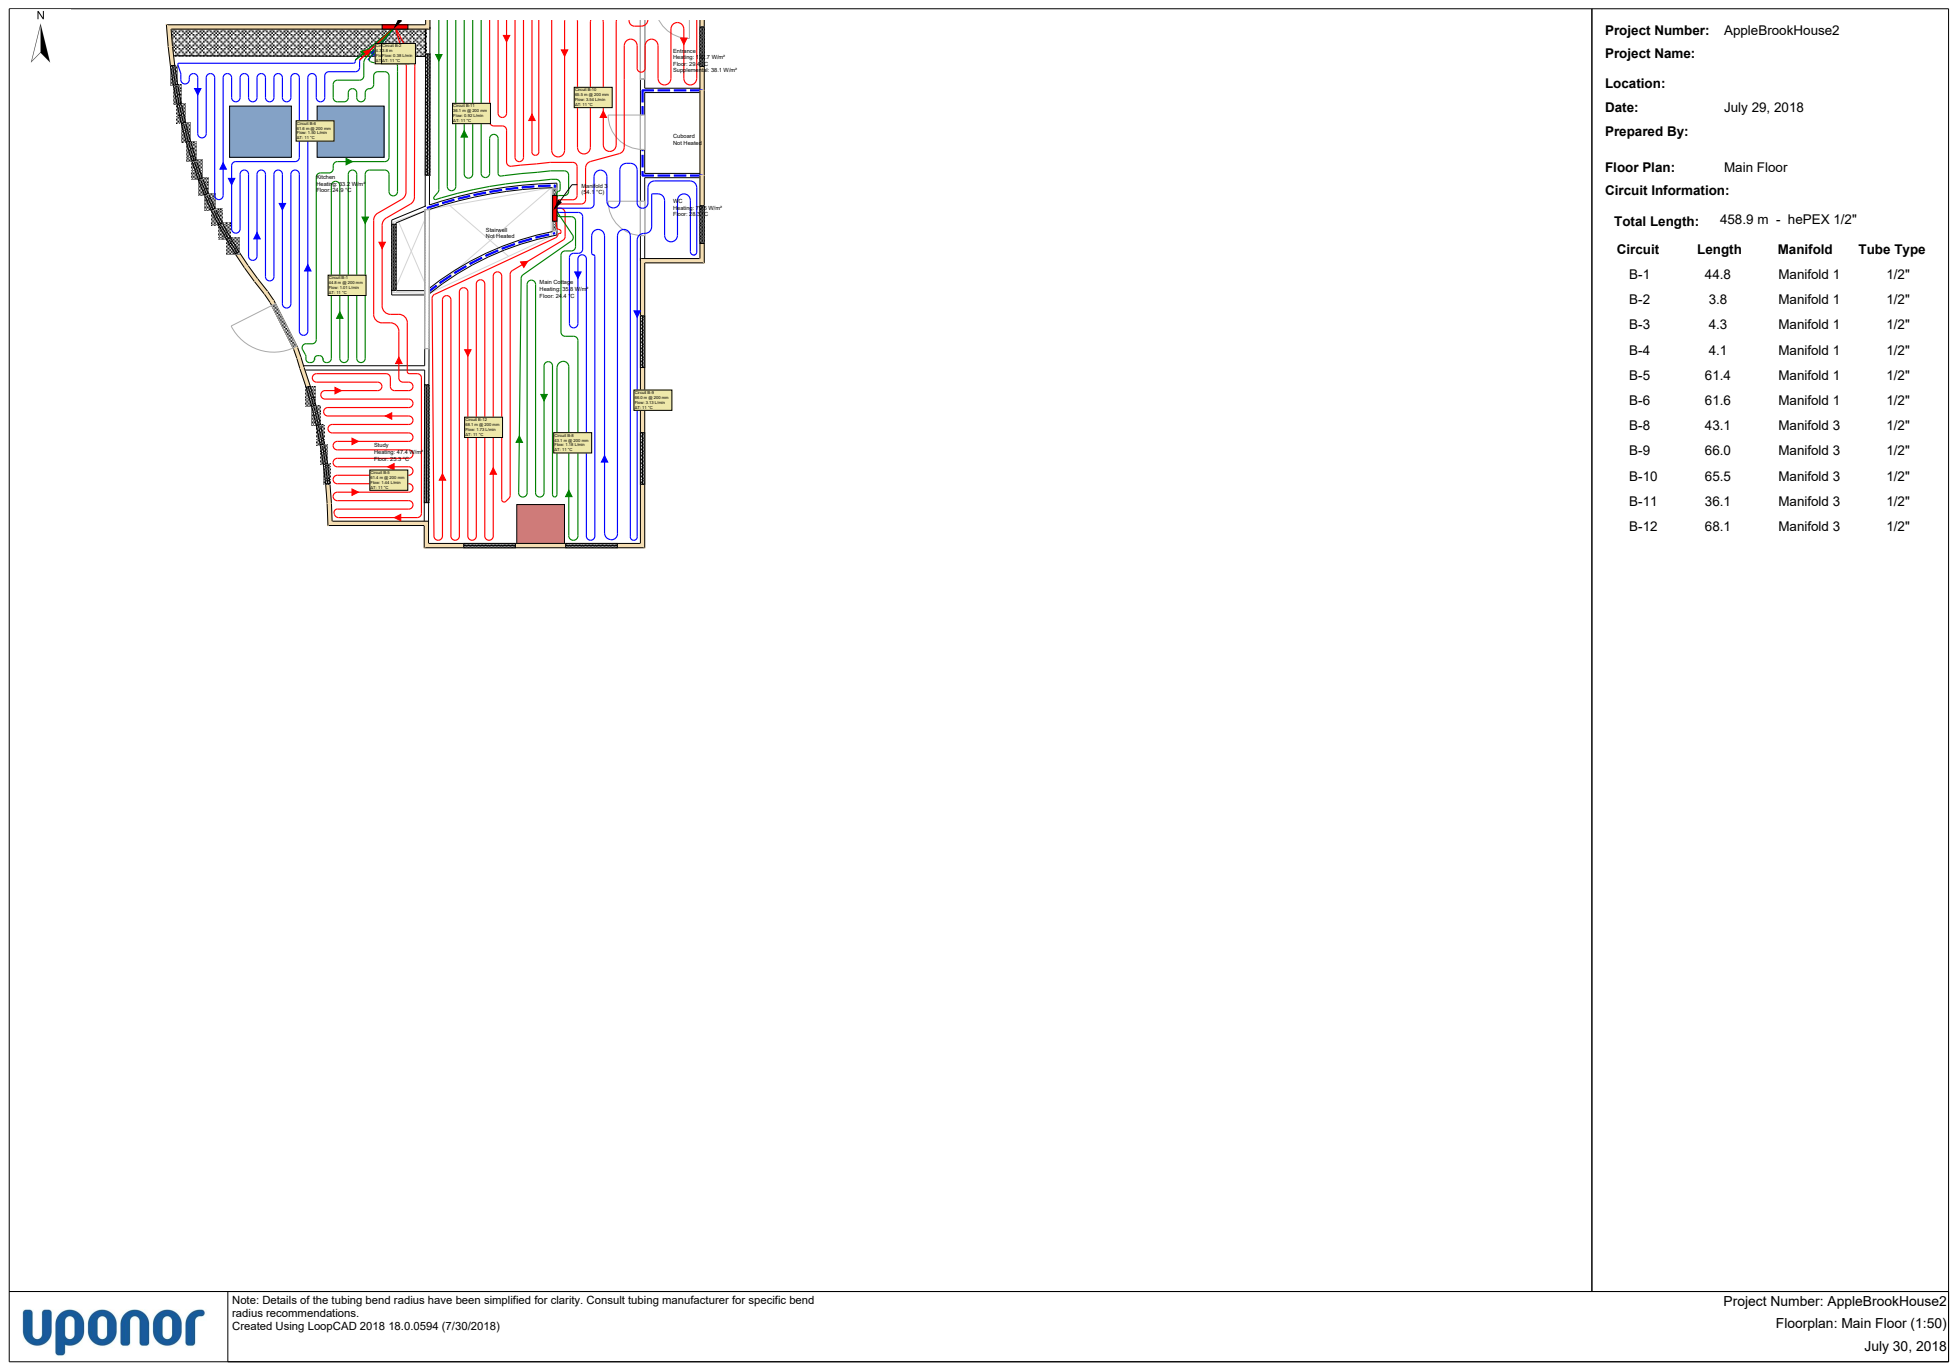
[picture p123: page 2]
Project Number: AppleBrookHouse2; Project Name:; Location:; Date:; July 29, 2018; Prepared By:; Floor Plan:; Main Floor; Circuit Information:; Total Length:; 458.9 m - hePEX 1/2"; Circuit; Length; Manifold; Tube Type; Manifold 1; Manifold 3; July 30, 2018; Main Cottage Heating: 35.8 W/m² Floor: 24.4 °C; Entrance Heating: 132.7 W/m² Floor: 29.4 °C Supplemental: 38.1 W/m²; WC Heating: 79.5 W/m² Floor: 28.3 °C; Cuboard Not Heated; Study Heating: 47.4 W/m² Floor: 25.3 °C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

Floorplan: Main Floor (1:50)
