DanielBryars/ChadHouse/SAP/Compliance_Information_S17212.pdf

# BUILDING REGULATION COMPLIANCE Calculaon Type: New Build (As Designed)

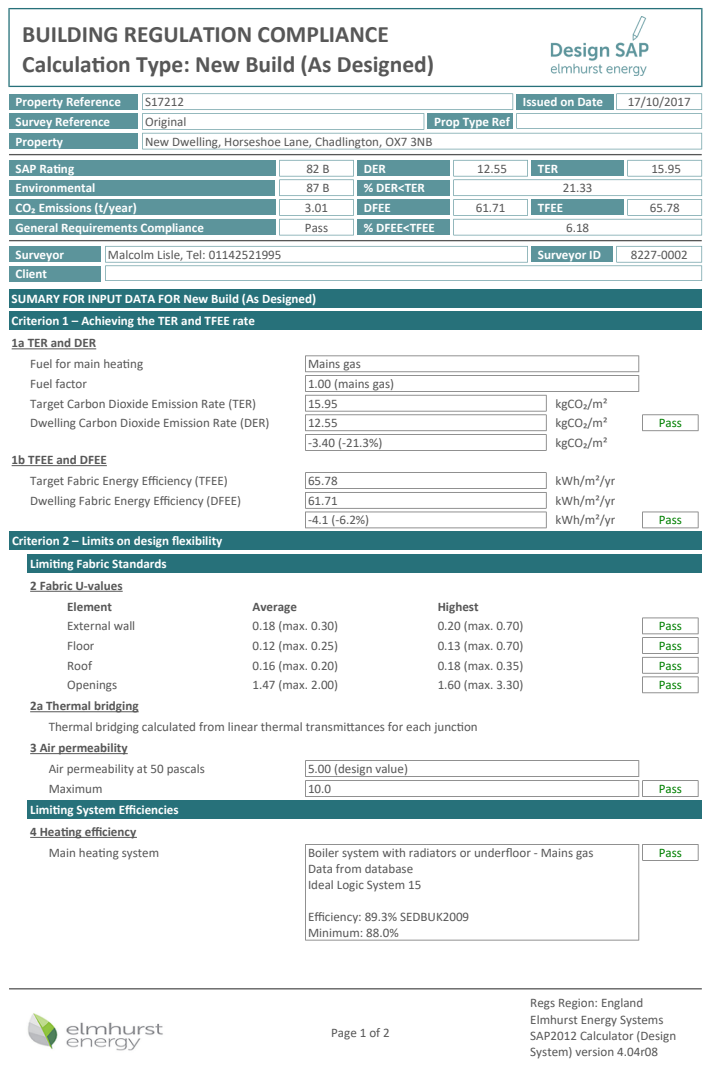
[picture p126: page 1]
Target Carbon Dioxide Emission Rate (TER); kgCO₂/m²; Fuel factor; 1.00 (mains gas); Fuel for main heang; Mains gas; Dwelling Carbon Dioxide Emission Rate (DER); Pass; Target Fabric Energy Eciency (TFEE); kWh/m²/yr; Dwelling Fabric Energy Eciency (DFEE); Property Reference; Survey Reference; Issued on Date; Original; Property; New Dwelling, Horseshoe Lane, Chadlington, OX7 3NB; % DFEE<TFEE; % DER<TER; TFEE; TER; DFEE; DER; Malcolm Lisle, Tel: 01142521995; Surveyor ID; Floor; 0.12 (max. 0.25)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

Prop Type Ref

SAP Rang
Environmental
CO₂ Emissions (t/year)
General Requirements Compliance

Surveyor
Client
SUMARY FOR INPUT DATA FOR New Build (As Designed)
Criterion 1 – Achieving the TER and TFEE rate
1a TER and DER

1b TFEE and DFEE

Criterion 2 – Limits on design exibility
Liming Fabric Standards
2 Fabric U-values
2a Thermal bridging
Thermal bridging calculated from linear thermal transmiances for each juncon
3 Air permeability
Liming System Eciencies
4 Heang eciency

Data from database
Ideal Logic System 15

Regs Region: England
Elmhurst Energy Systems
SAP2012 Calculator (Design
System) version 4.04r08

# BUILDING REGULATION COMPLIANCE Calculaon Type: New Build (As Designed)

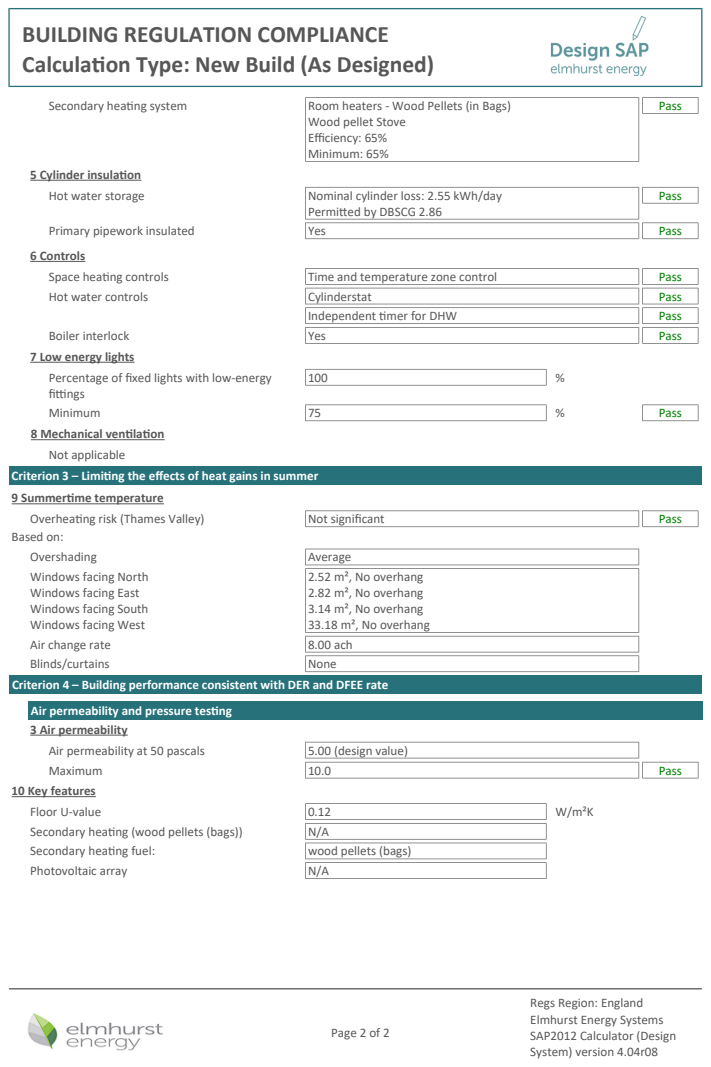
[picture p127: page 2]
Floor U-value; W/m²K; Secondary heang (wood pellets (bags)); Secondary heang fuel:; wood pellets (bags); Photovoltaic array; Overheang risk (Thames Valley); Not signicant; Pass; Overshading; Average; Air change rate; 8.00 ach; Blinds/curtains; None; Secondary heang system; Room heaters - Wood Pellets (in Bags); Hot water storage; Nominal cylinder loss: 2.55 kWh/day; Primary pipework insulated; Yes; 6 Controls; Minimum; Space heang controls; Time and temperature zone control; Hot water controls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

Wood pellet Stove
Eciency: 65%
Minimum: 65%

5 Cylinder insulaon

Permied by DBSCG 2.86

7 Low energy lights
Percentage of xed lights with low-energy
ngs
8 Mechanical venlaon
Not applicable
Criterion 3 – Liming the eects of heat gains in summer
9 Summerme temperature
Based on:
Windows facing North
Windows facing East
Windows facing South
Windows facing West
Criterion 4 – Building performance consistent with DER and DFEE rate

2.52 m², No overhang
2.82 m², No overhang
3.14 m², No overhang
33.18 m², No overhang

Air permeability and pressure tesng
3 Air permeability
10 Key features

Regs Region: England
Elmhurst Energy Systems
SAP2012 Calculator (Design
System) version 4.04r08
