DanielBryars/ChadHouse/SAP/Summary_Information_S17212.pdf

Malcolm Lisle, Tel: 01142521995 | Surveyor ID | 8227-0002

### Surveyor

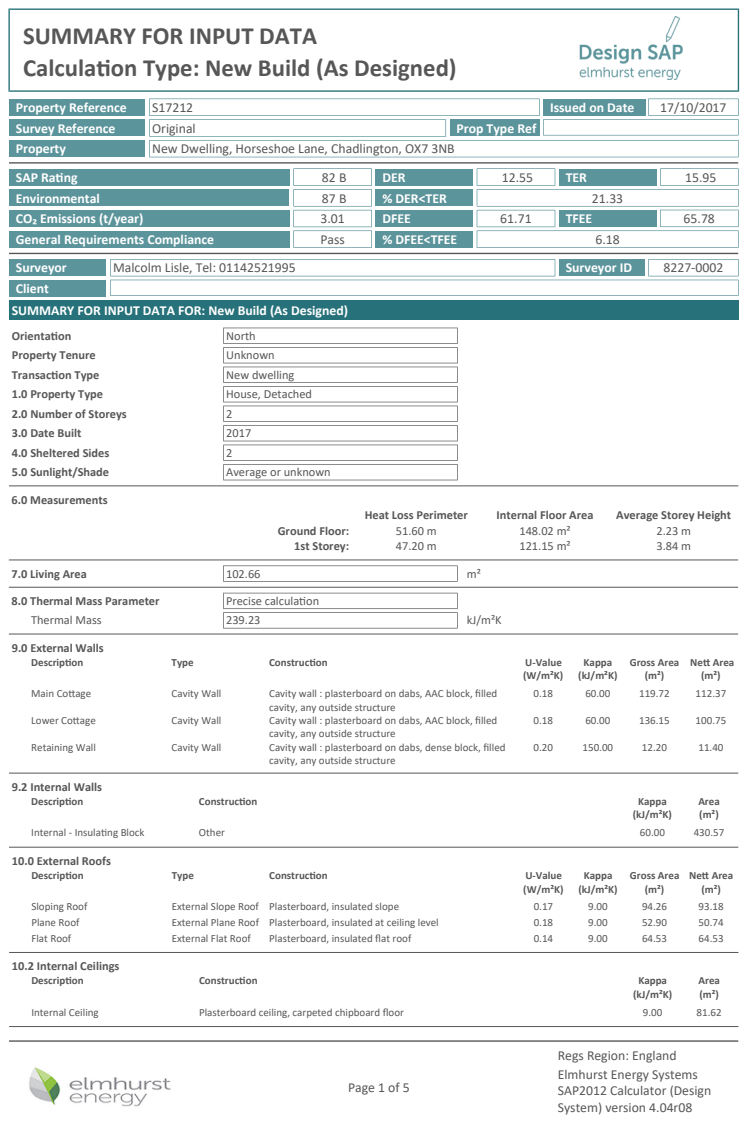
[picture p128: page 1]
7.0 Living Area; 8.0 Thermal Mass Parameter; Precise calculaon; Thermal Mass; kJ/m²K; 9.0 External Walls; Descripon; Type; Construcon; U-Value; (W/m²K); Kappa (kJ/m²K); Gross Area (m²); Ne Area (m²); Main Coage; Cavity Wall; Cavity wall : plasterboard on dabs, AAC block, lled; Lower Coage; Retaining Wall; Cavity wall : plasterboard on dabs, dense block, lled; 6.0 Measurements; Heat Loss Perimeter; Internal Floor Area; Average Storey Height; Ground Floor:; 1st Storey:; 5.0 Sunlight/Shade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

SUMMARY FOR INPUT DATA
Calculaon Type: New Build (As Designed)

Prop Type Ref

SAP Rang
Environmental
CO₂ Emissions (t/year)
General Requirements Compliance

Client
SUMMARY FOR INPUT DATA FOR: New Build (As Designed)

cavity, any outside structure

Regs Region: England
Elmhurst Energy Systems
SAP2012 Calculator (Design
System) version 4.04r08

### 11.2 Internal Floors

Descripon | | Construcon | | | | Kappa (kJ/m²K)

Area
(m²)
Internal Floor | Plasterboard ceiling, carpeted chipboard oor | 18.00 | 81.62

### 12.0 Opening Types

Descripon | Data Source Type | Glazing | Glazing
| | | | | Gap

Argon
Filled

Solar
Trans

Frame
Type
| | | | | | Frame Factor

U Value
(W/m²K)
Lower Coage Windows | Manufacture r
Window | Double Low-E So 0.05
0.45 | 0.70 | 1.44
Main Coage Windows | Manufacture r
Window | Double Low-E So 0.05
0.63 | 0.70 | 1.60
Solid Door | Manufacture r | Solid Door
1.47
Rooights | Manufacture r
Roof Window | Double Low-E So 0.05
0.63 | 0.70 | 1.60
Glazed Doors | Manufacture r
Window | Double Low-E So 0.05
0.63 | 0.70 | 1.60

### 13.0 Openings

Name | Opening Type | Locaon | Orientaon Curtain
| | | | Type | Overhang Rao

Wide
Overhang

Width
(m)

Height
(m)
Count | Area
| | | | | | (m²)

Curtain
Closed
Windows | Window | [1] Main Coage | North | None | 0.00 | 1.20
Windows | Window | [1] Main Coage | East | None | 0.00 | 2.82
Windows | Window | [1] Main Coage | South | None | 0.00 | 1.44
Front Door | Solid Door | [1] Main Coage | North | | | 1.89
Windows | Window | [2] Lower Coage | North | None | 0.00 | 1.32
Windows | Window | [2] Lower Coage | South | None | 0.00 | 0.90
Windows | Window | [2] Lower Coage | West | None | 0.00 | 17.68
Glazed Doors | Window | [2] Lower Coage | West | None | 0.00 | 15.50

### 11.0 Heat Loss Floors

Descripon | Type | Construcon | U-Value
(W/m²K)

Kappa
(kJ/m²K)

Area
(m²)
Upper Ground Floor | Ground Floor - Solid Suspended concrete oor, carpeted | 0.13 | 75.00 | 39.53
Lower Ground Floor | Ground Floor - Solid Slab on ground, screed over insulaon | 0.12 | 110.00 | 148.02

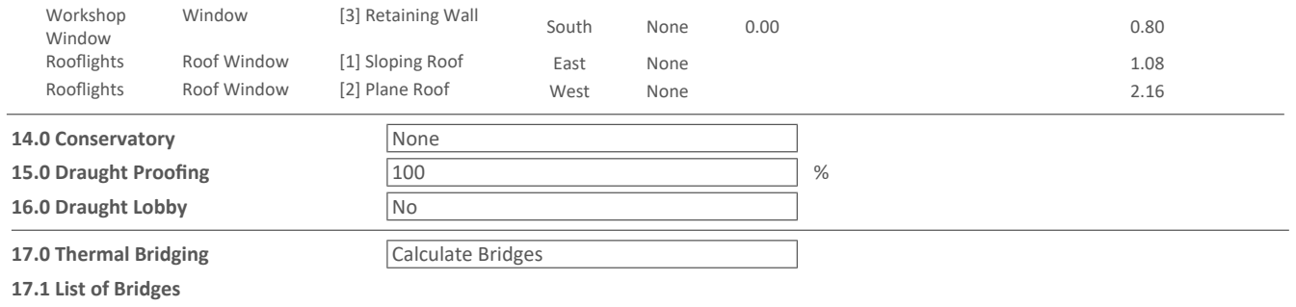
[picture p129: figure]
Workshop Window; Window; [3] Retaining Wall; South; None; Rooights; Roof Window; [1] Sloping Roof; East; [2] Plane Roof; West; 17.1 List of Bridges; 17.0 Thermal Bridging; Calculate Bridges; 16.0 Draught Lobby; 15.0 Draught Proong; 14.0 Conservatory
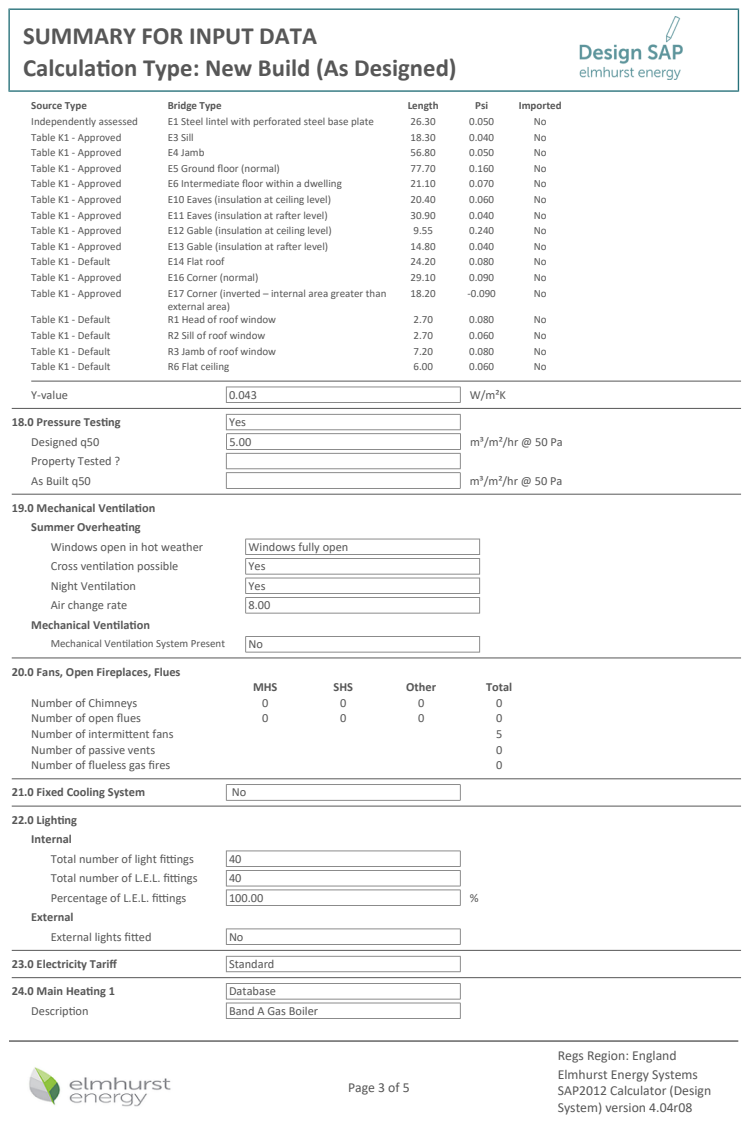
[picture p130: page 3]
Y-value; W/m²K; Source Type; Bridge Type; Length; Psi; Imported; Independently assessed; E1 Steel lintel with perforated steel base plate; Table K1 - Approved; E3 Sill; E4 Jamb; E5 Ground oor (normal); E6 Intermediate oor within a dwelling; E10 Eaves (insulaon at ceiling level); E11 Eaves (insulaon at raer level); E12 Gable (insulaon at ceiling level); E13 Gable (insulaon at raer level); Table K1 - Default; E14 Flat roof; E16 Corner (normal); E17 Corner (inverted – internal area greater than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

19.0 Mechanical Venlaon
Summer Overheang
Mechanical Venlaon

20.0 Fans, Open Fireplaces, Flues

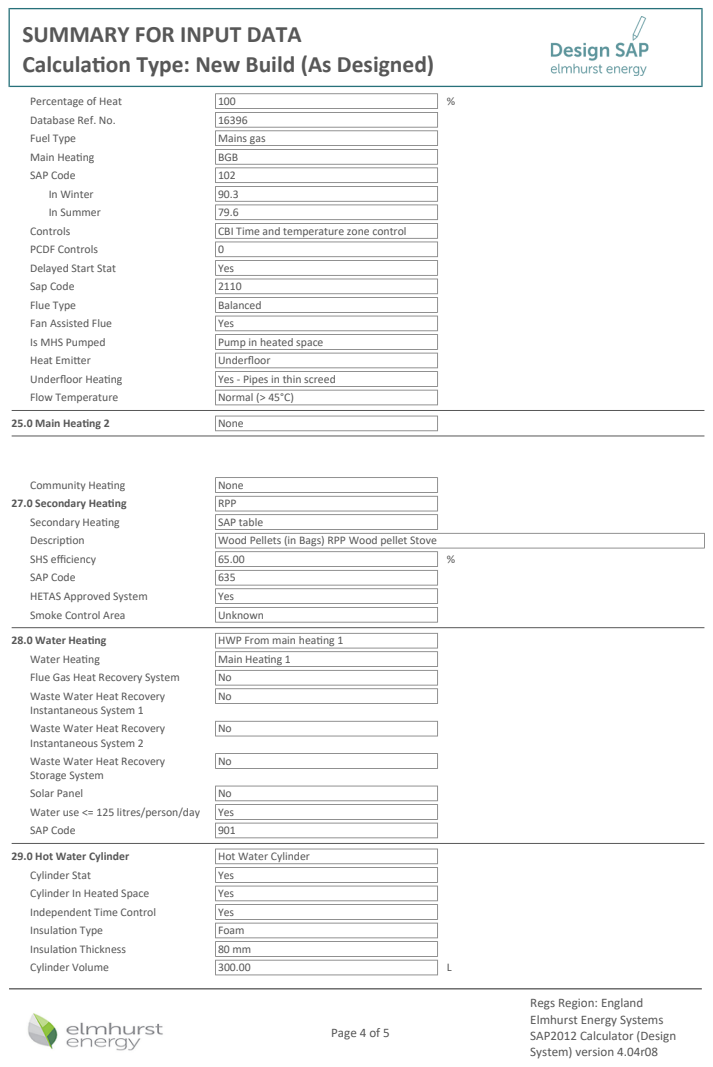
[picture p131: page 4]
25.0 Main Heang 2; None; Percentage of Heat; Flow Temperature; Normal (> 45°C); Underoor Heang; Yes - Pipes in thin screed; Heat Emier; Underoor; Is MHS Pumped; Pump in heated space; Fan Assisted Flue; Yes; Flue Type; Balanced; Sap Code; Delayed Start Stat; PCDF Controls; Controls; CBI Time and temperature zone control; In Summer; In Winter; SAP Code; Main Heang; BGB; Fuel Type; Mains gas; Database Ref. No.; 29.0 Hot Water Cylinder; Hot Water Cylinder; Cylinder Stat; Cylinder In Heated Space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

Waste Water Heat Recovery
Instantaneous System 1
Instantaneous System 2
Storage System

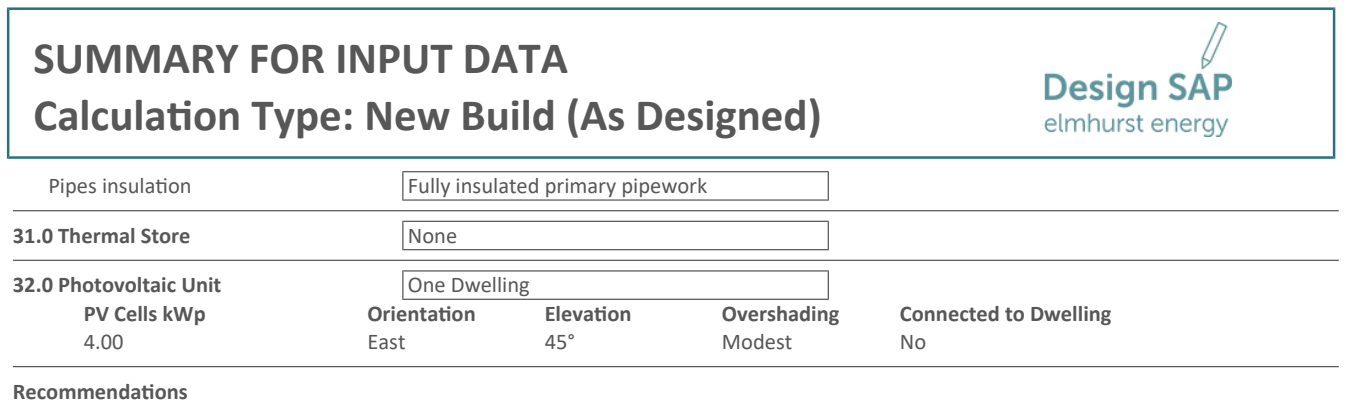
[picture p132: figure]
Recommendaons; 32.0 Photovoltaic Unit; One Dwelling; PV Cells kWp; Orientaon; Elevaon; Overshading; Connected to Dwelling; East; Modest; 31.0 Thermal Store; None; Pipes insulaon; Fully insulated primary pipework

None

Further measures to achieve even higher standards

None

Lower cost measures
