DanielBryars/ChadHouse/Kitchen/BuiltInMonitor/WVT-XTM-24S-Model.pdf

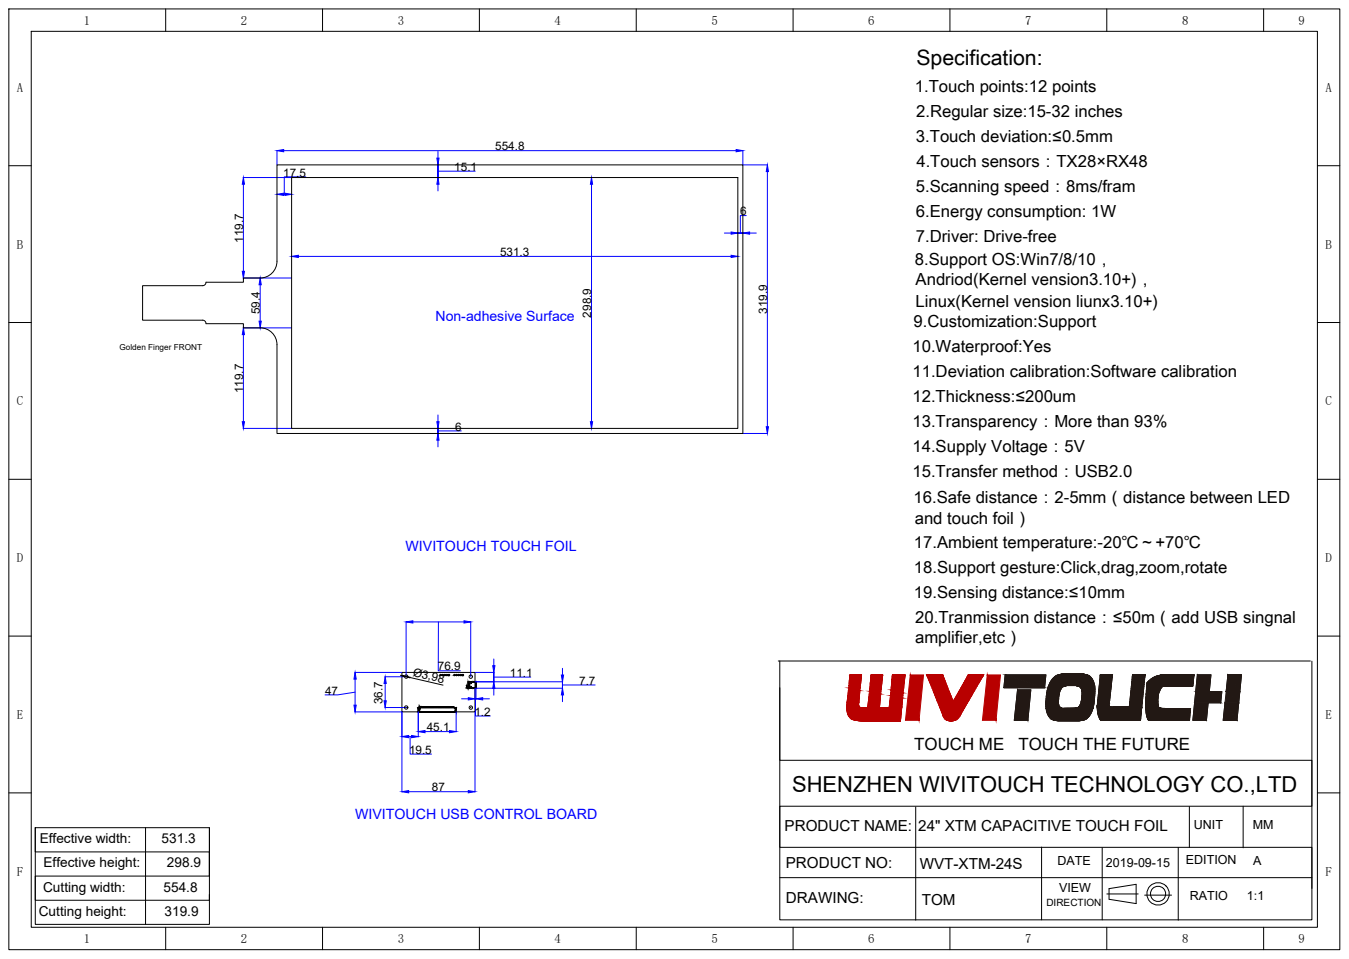
[picture p133: page 1]
CBADEF; CBADEF 1; 9 EDITION RATIO; A1:1 DATE; UNIT; MM DIRECTION VIEW SHENZHEN WIVITOUCH TECHNOLOGY CO.,LTD PRODUCT NO:; WVT-XTM-24S DRAWING:; TOM PRODUCT NAME:; 24" XTM CAPACITIVE TOUCH FOIL Effective width:; 531.3 Cutting width:; 554.8 Effective height:; 298.9 Cutting height:; TOUCH ME TOUCH THE FUTURE WIVITOUCH TOUCH FOIL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

319.9 554.8 Non-adhesive Surface
