DanielBryars/ChadHouse/Velfac/175026 Rev E Working .pdf

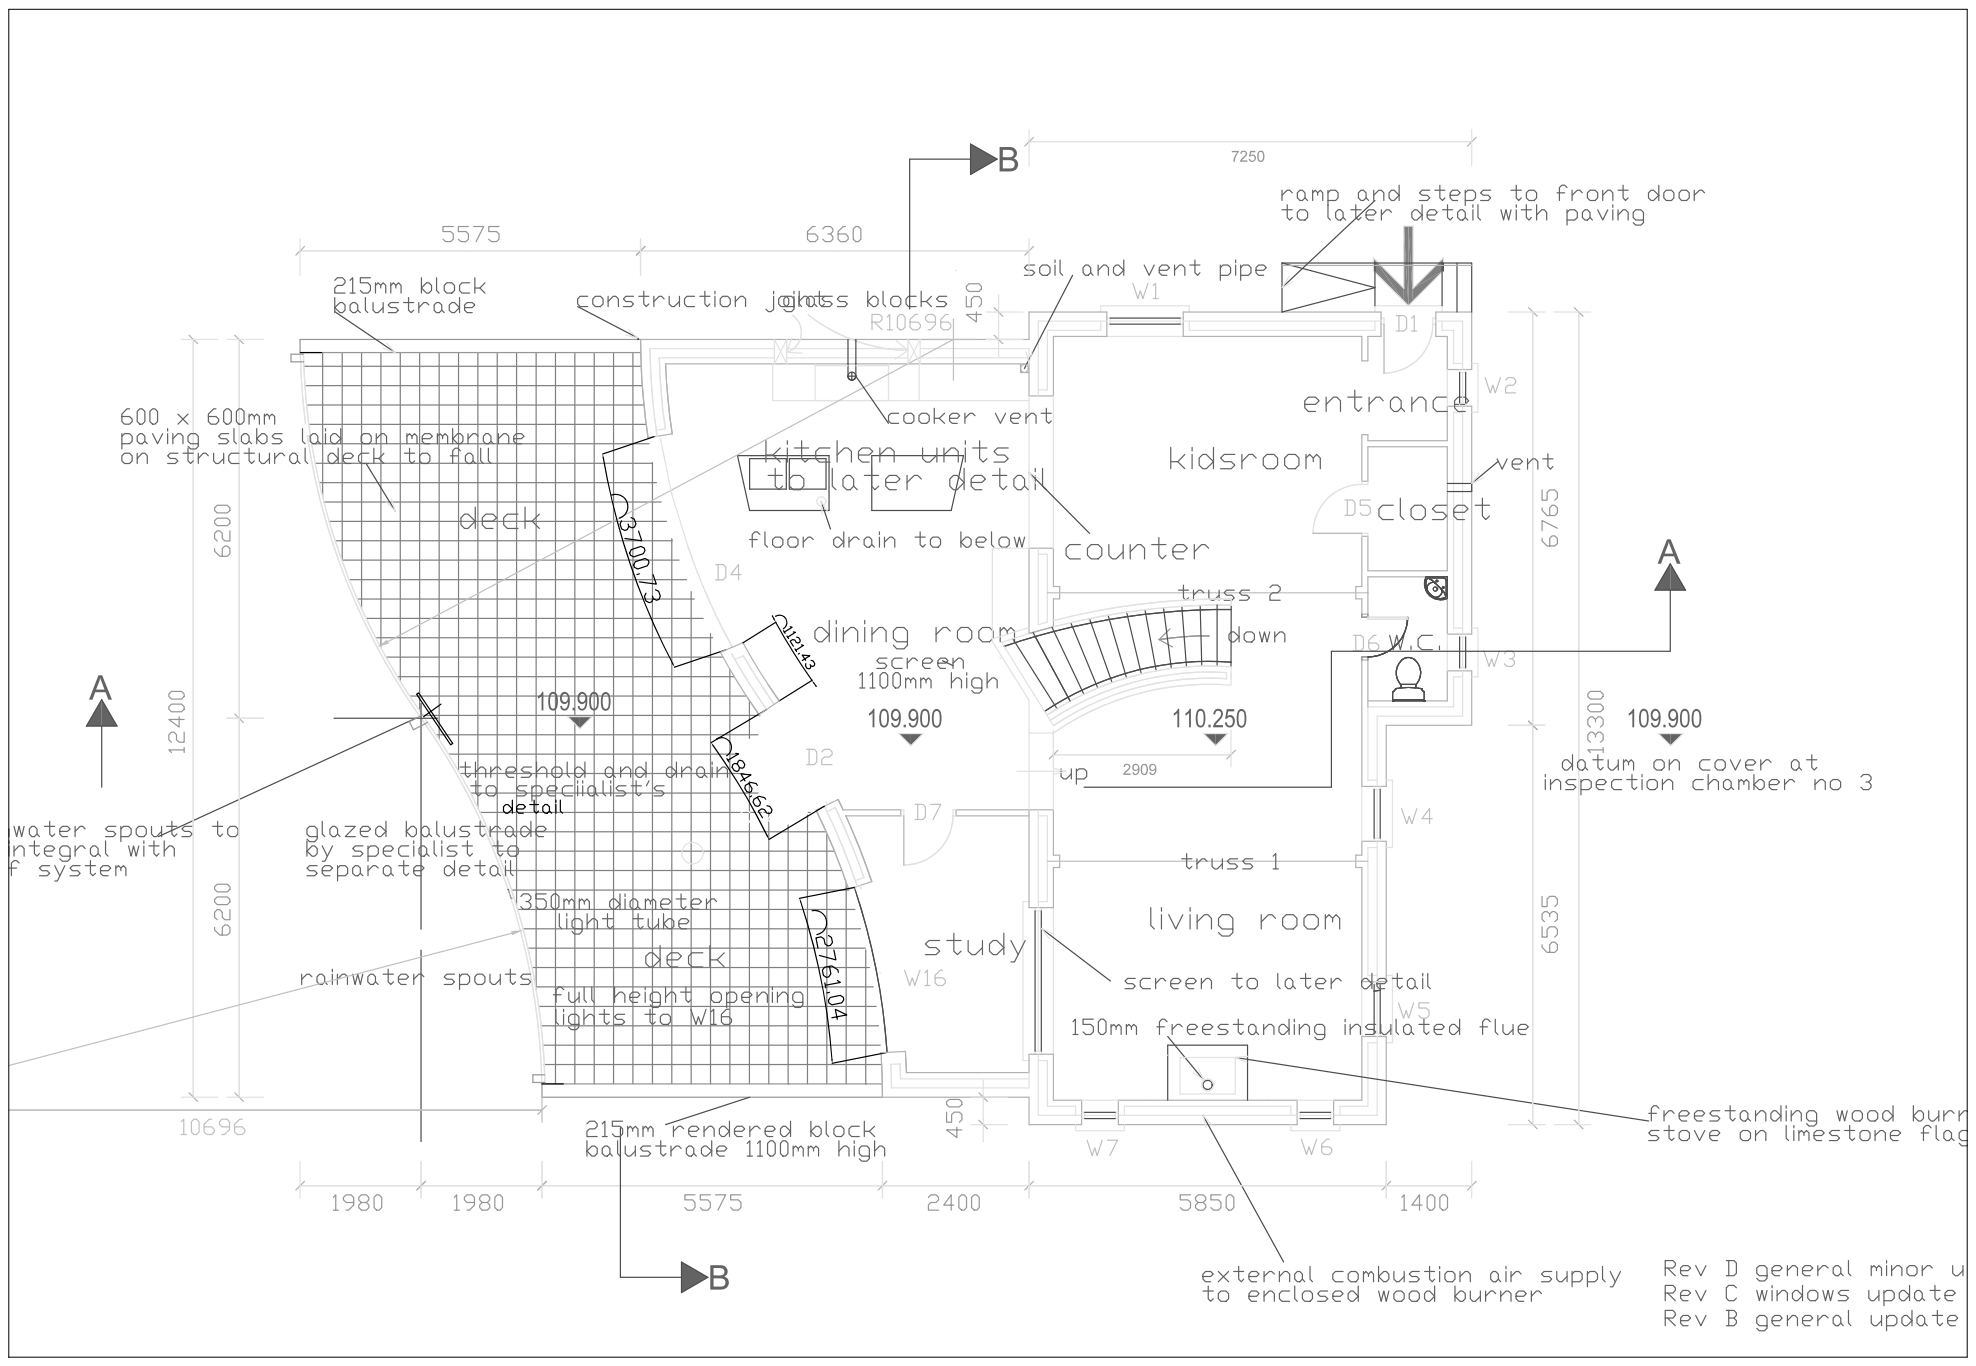
[picture p134: page 1]
