DanielBryars/ChadHouse/2D/W175-28F 1to100 at A2.pdf

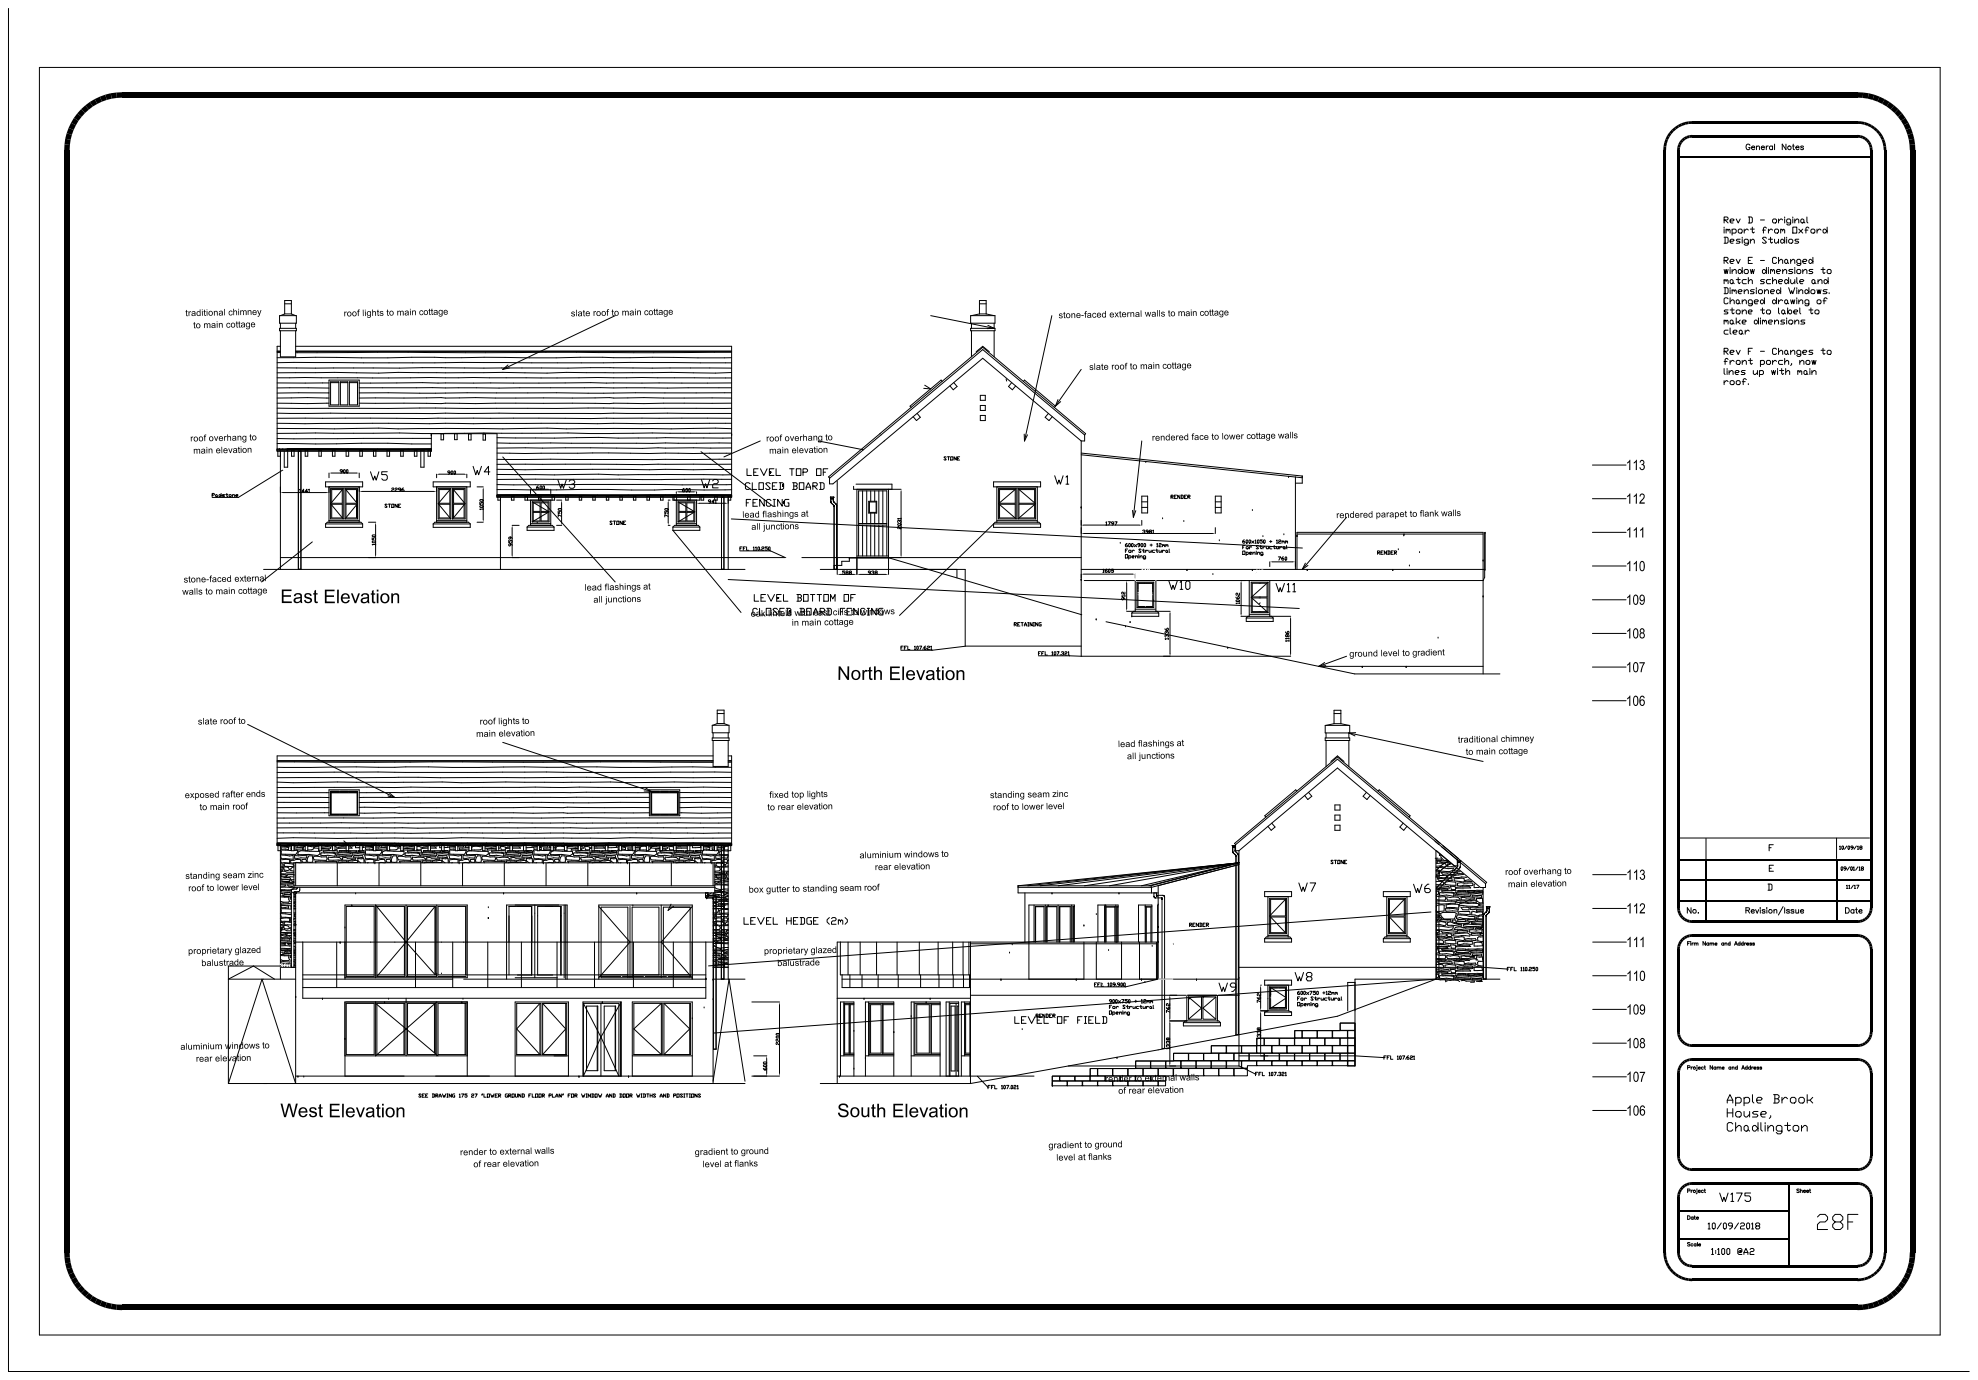
[picture p135: page 1]
