DanielBryars/ChadHouse/2D/W175 F - temp.pdf

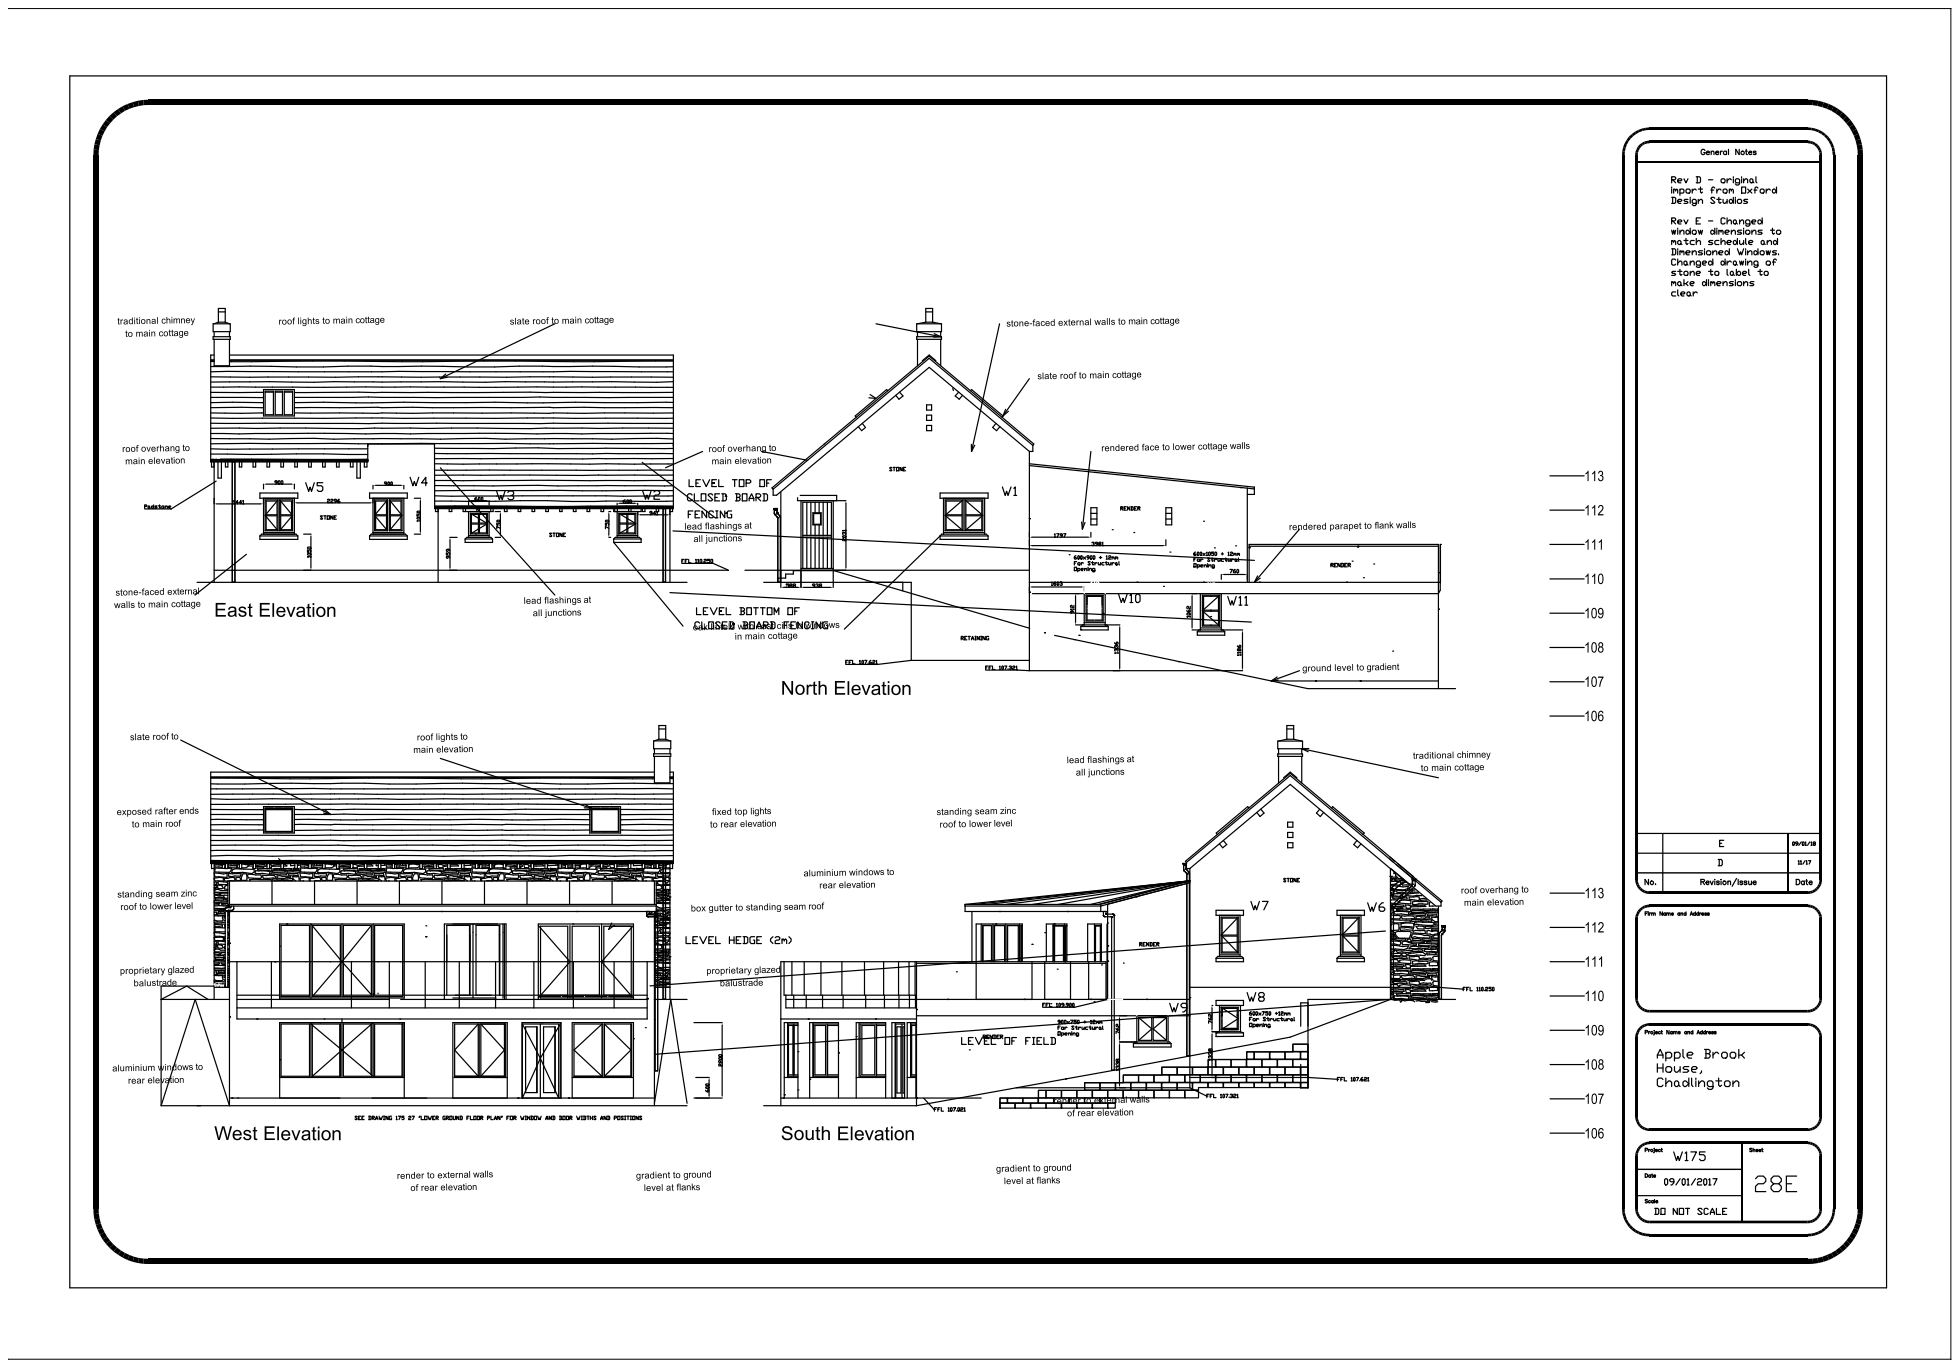
[picture p136: page 1]
