DanielBryars/ChadHouse/2D/W175-28F.pdf

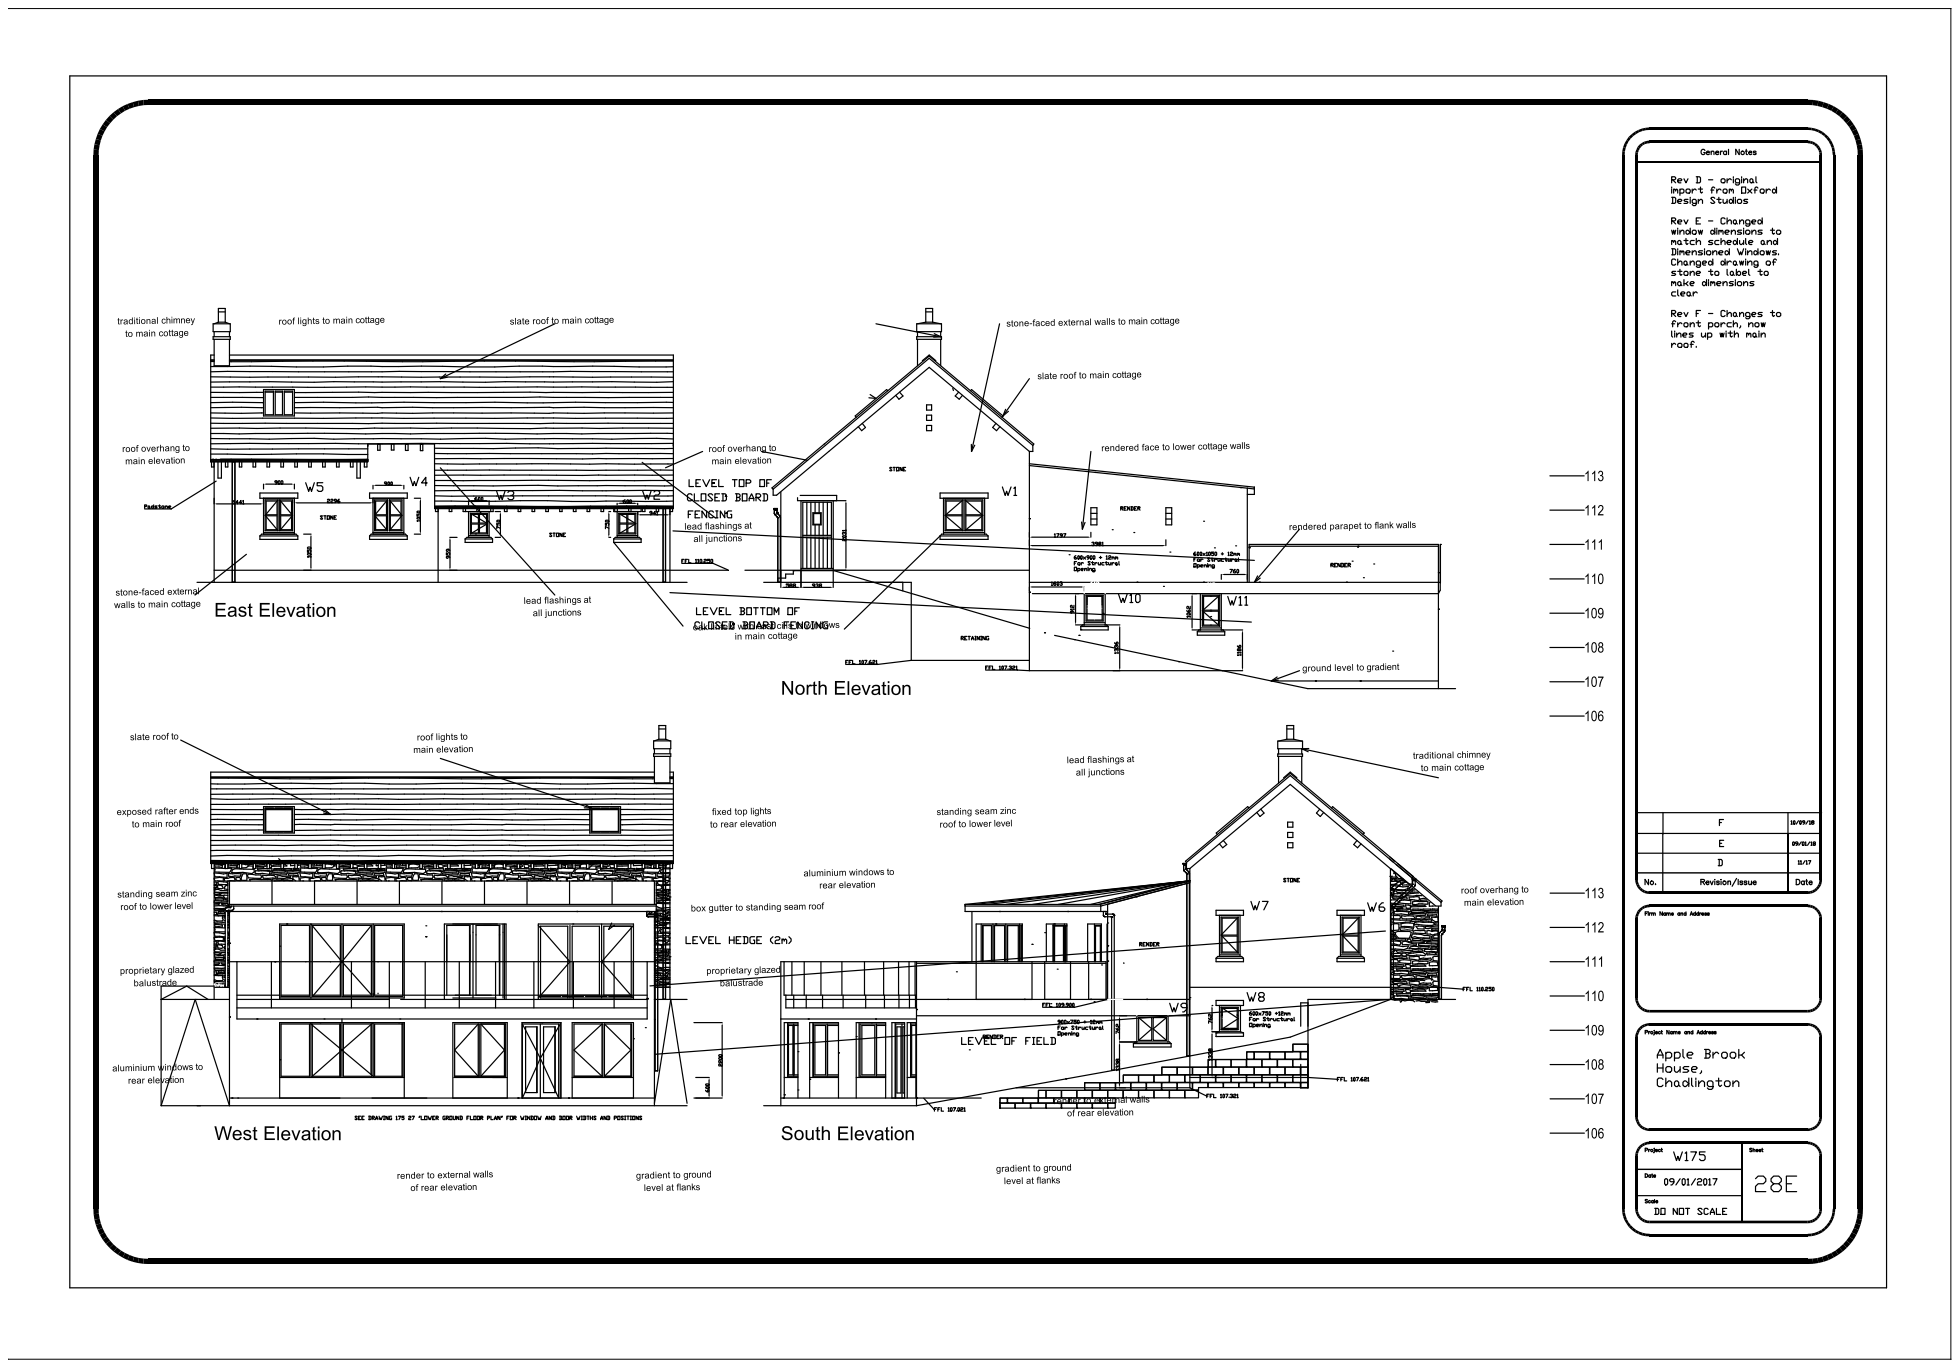
[picture p137: page 1]
