DanielBryars/ChadHouse/Topological/16764-Topo.pdf

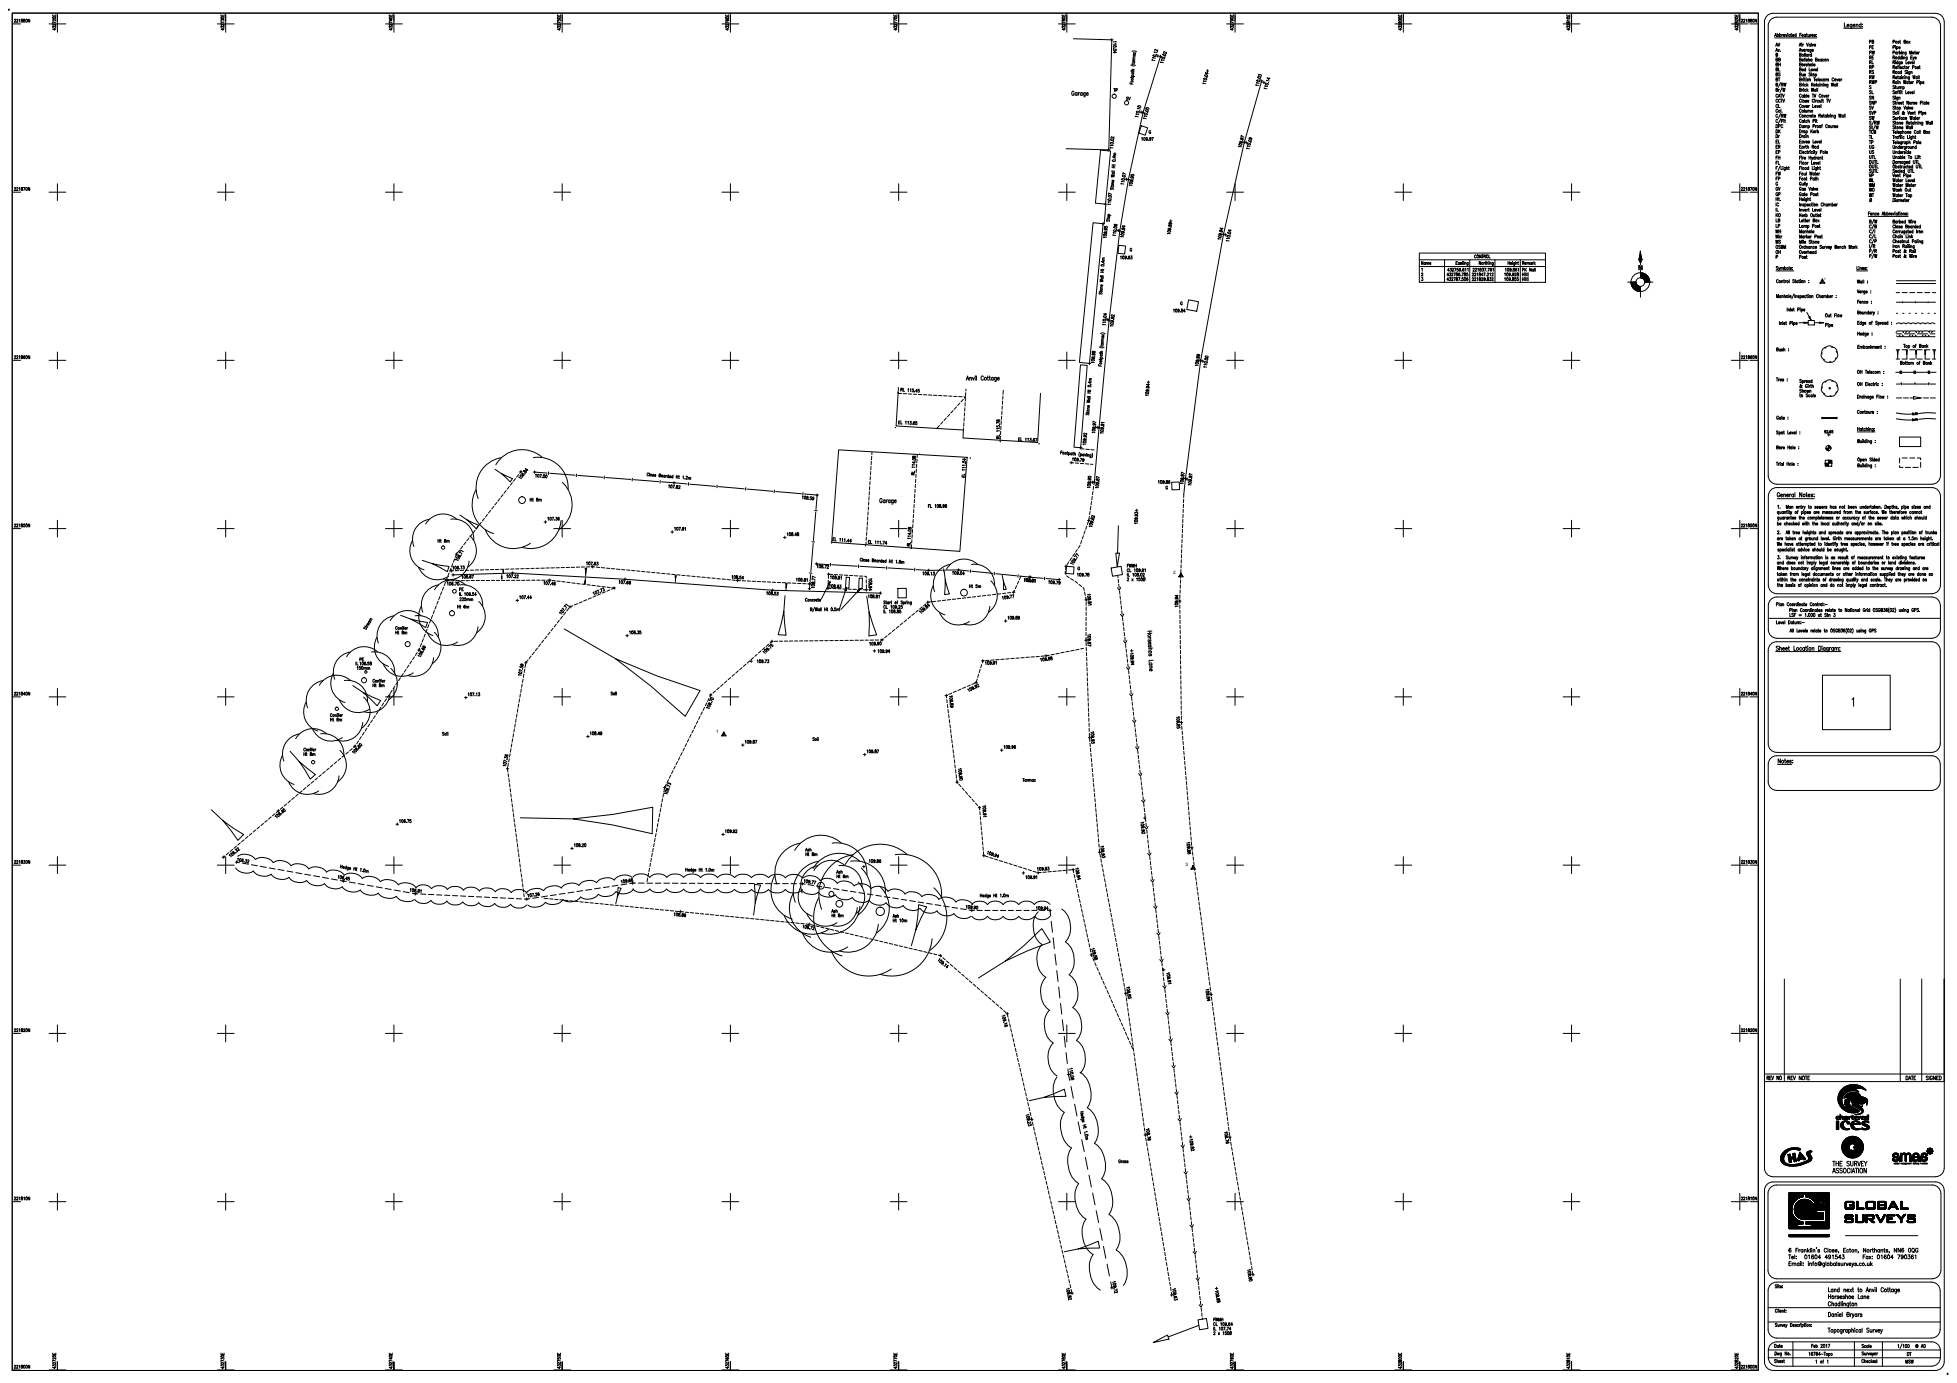
[picture p138: page 1]
