DanielBryars/ChadHouse/Velfac/SOUTH OF ANVIL COTTAGE-D2 dining.pdf

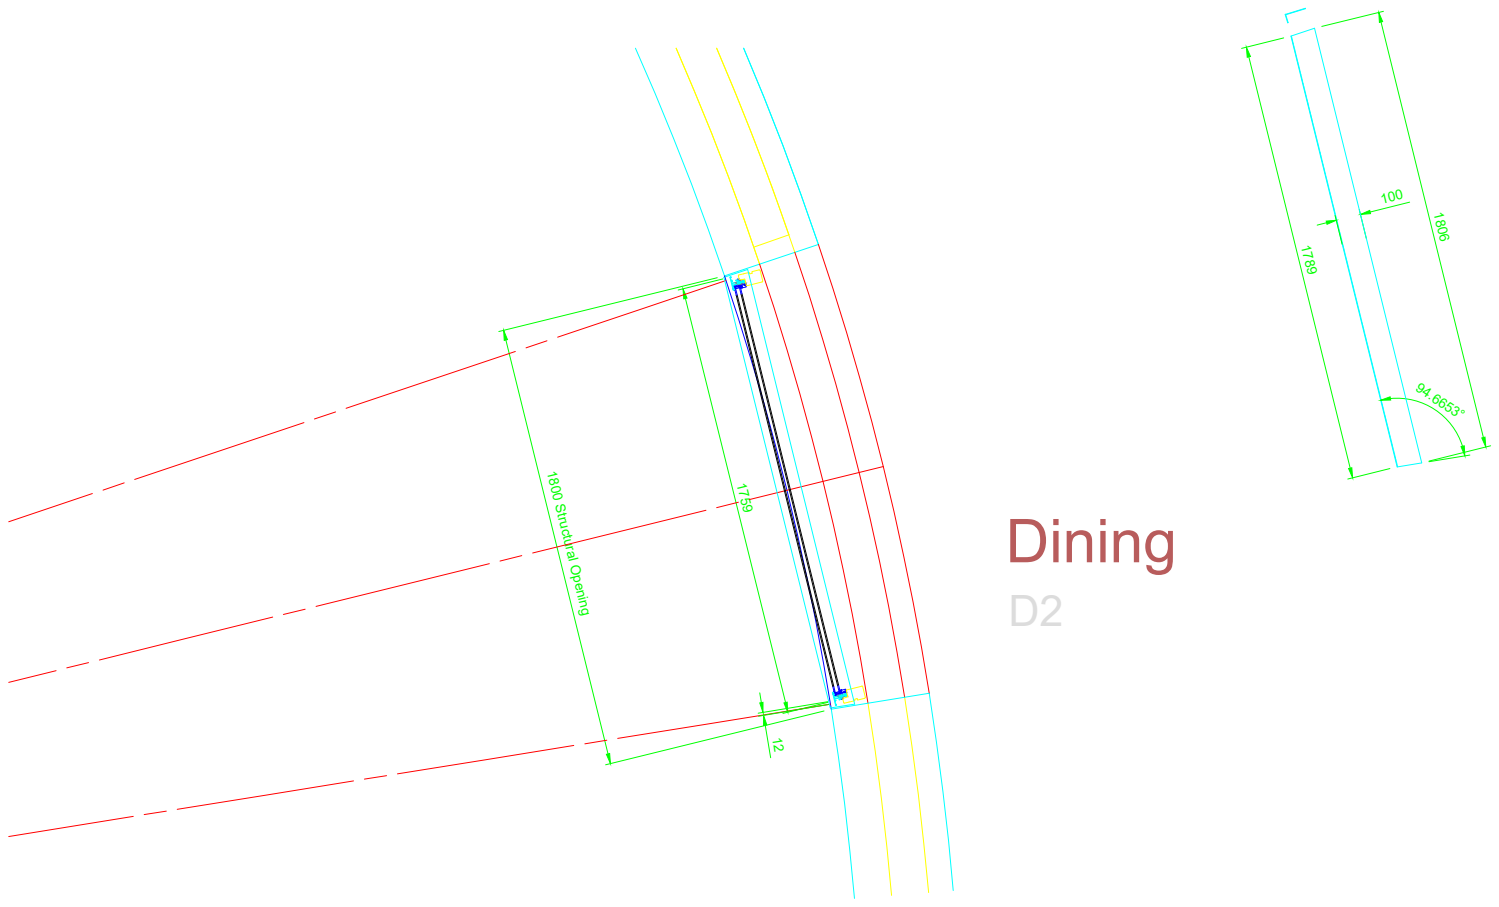
[picture p139: page 1]
1800 Structural Opening D2
