DanielBryars/ChadHouse/Velfac/SOUTH OF ANVIL COTTAGE-D4 Kitchen.pdf

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

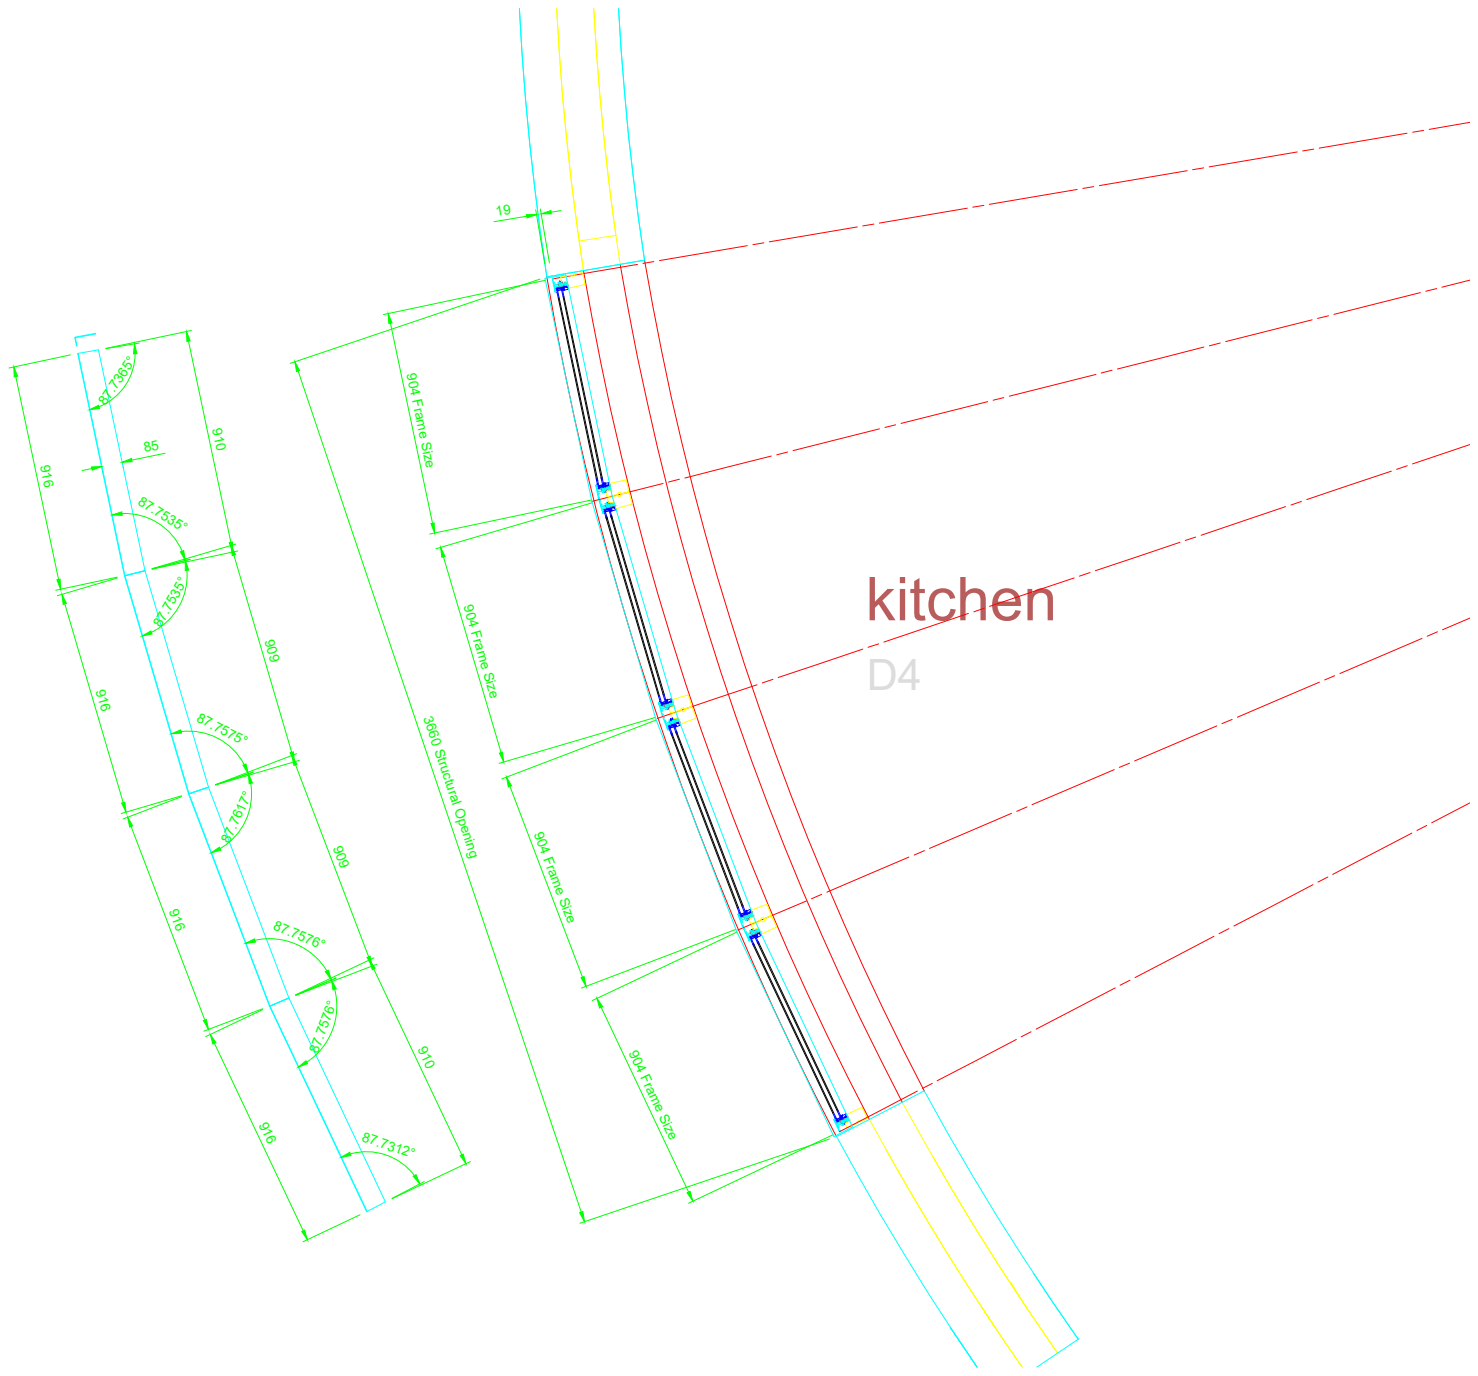
[picture p140: page 1]
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
