DanielBryars/ChadHouse/Velfac/SOUTH OF ANVIL COTTAGE-W12 Bed1.pdf

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

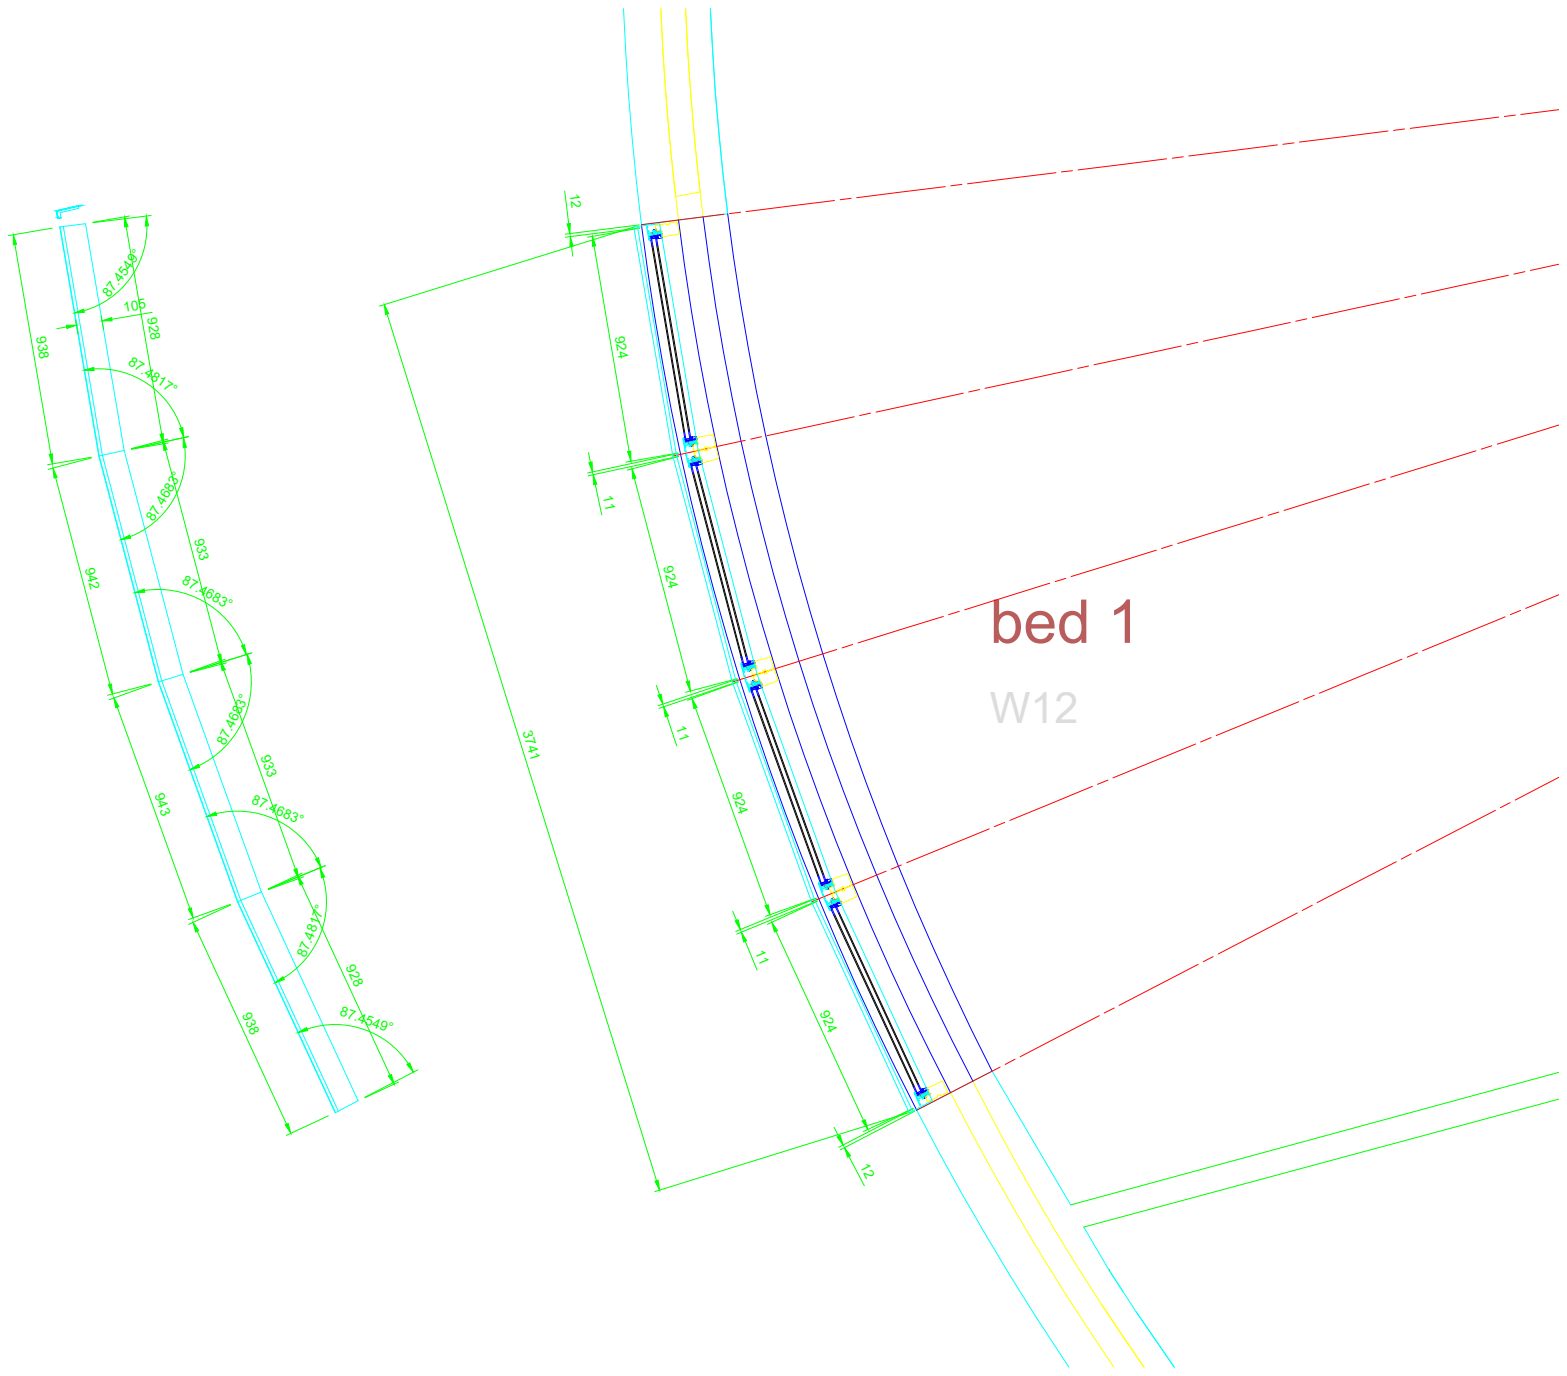
[picture p141: page 1]
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
