DanielBryars/ChadHouse/Velfac/SOUTH OF ANVIL COTTAGE-W15 Bed2.pdf

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

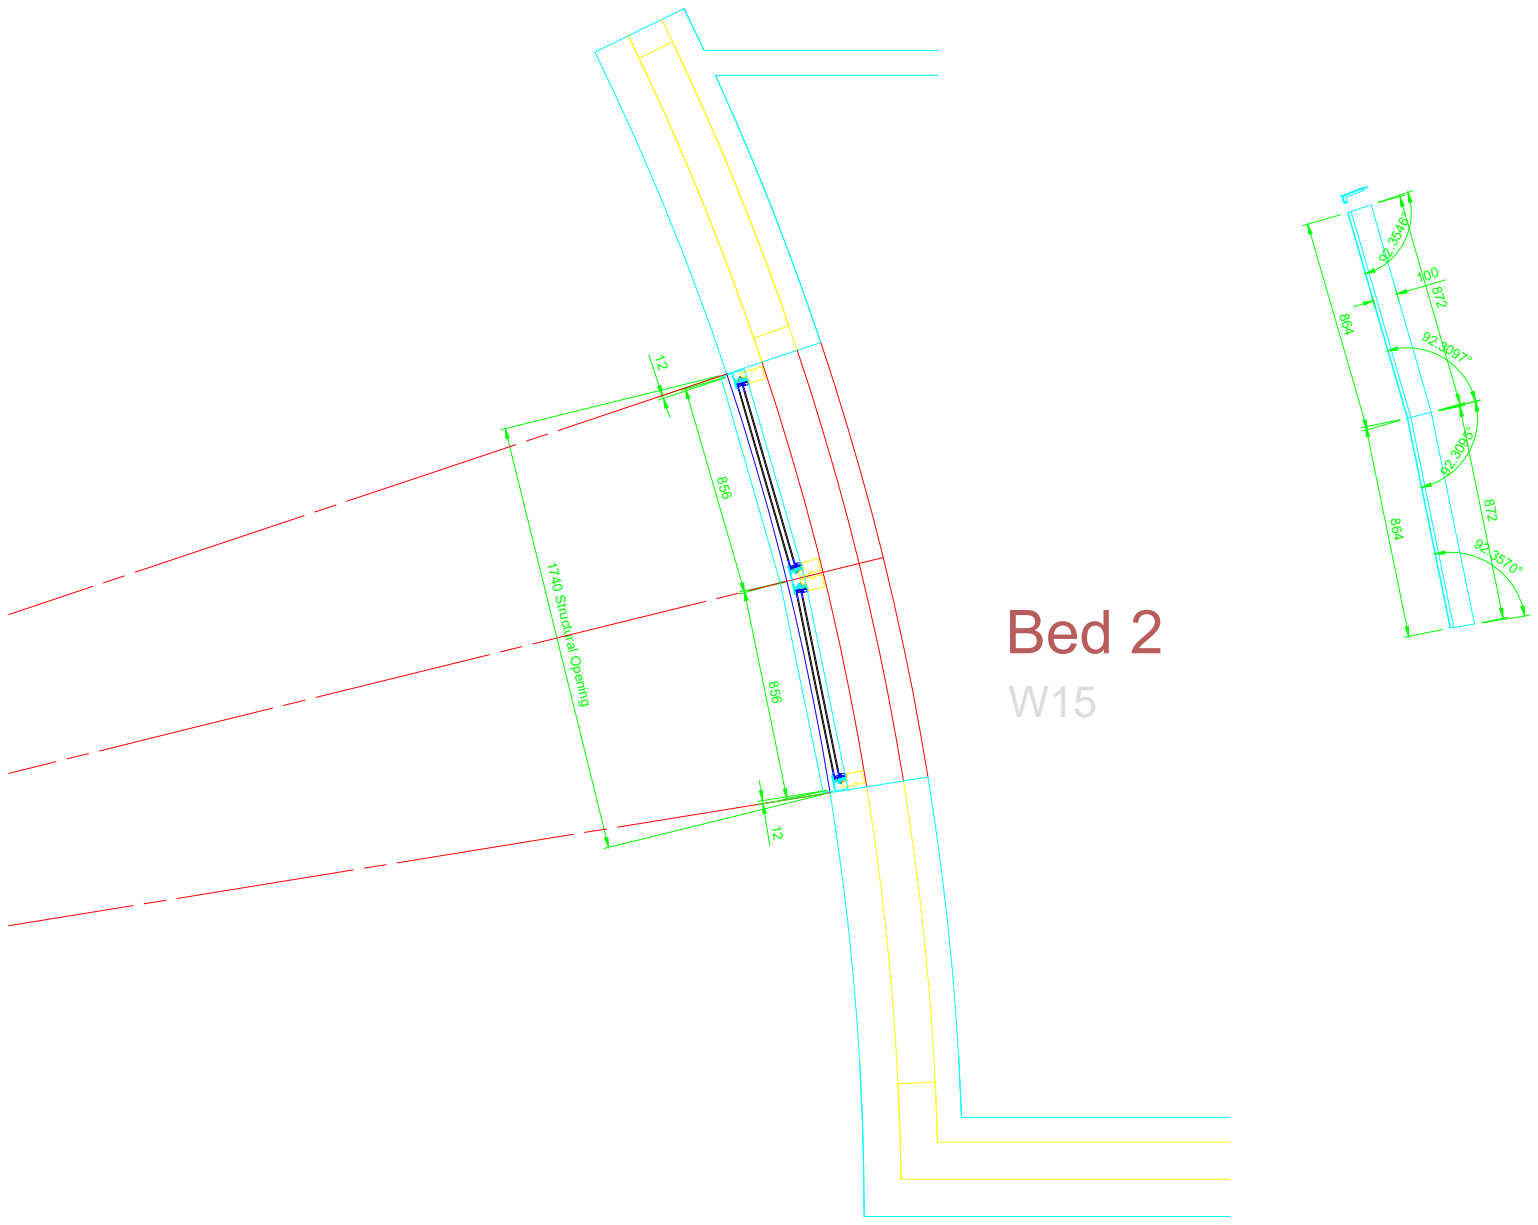
[picture p143: page 1]
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
