DanielBryars/ChadHouse/Stairs/Stair Setting Out-Iss180212.pdf

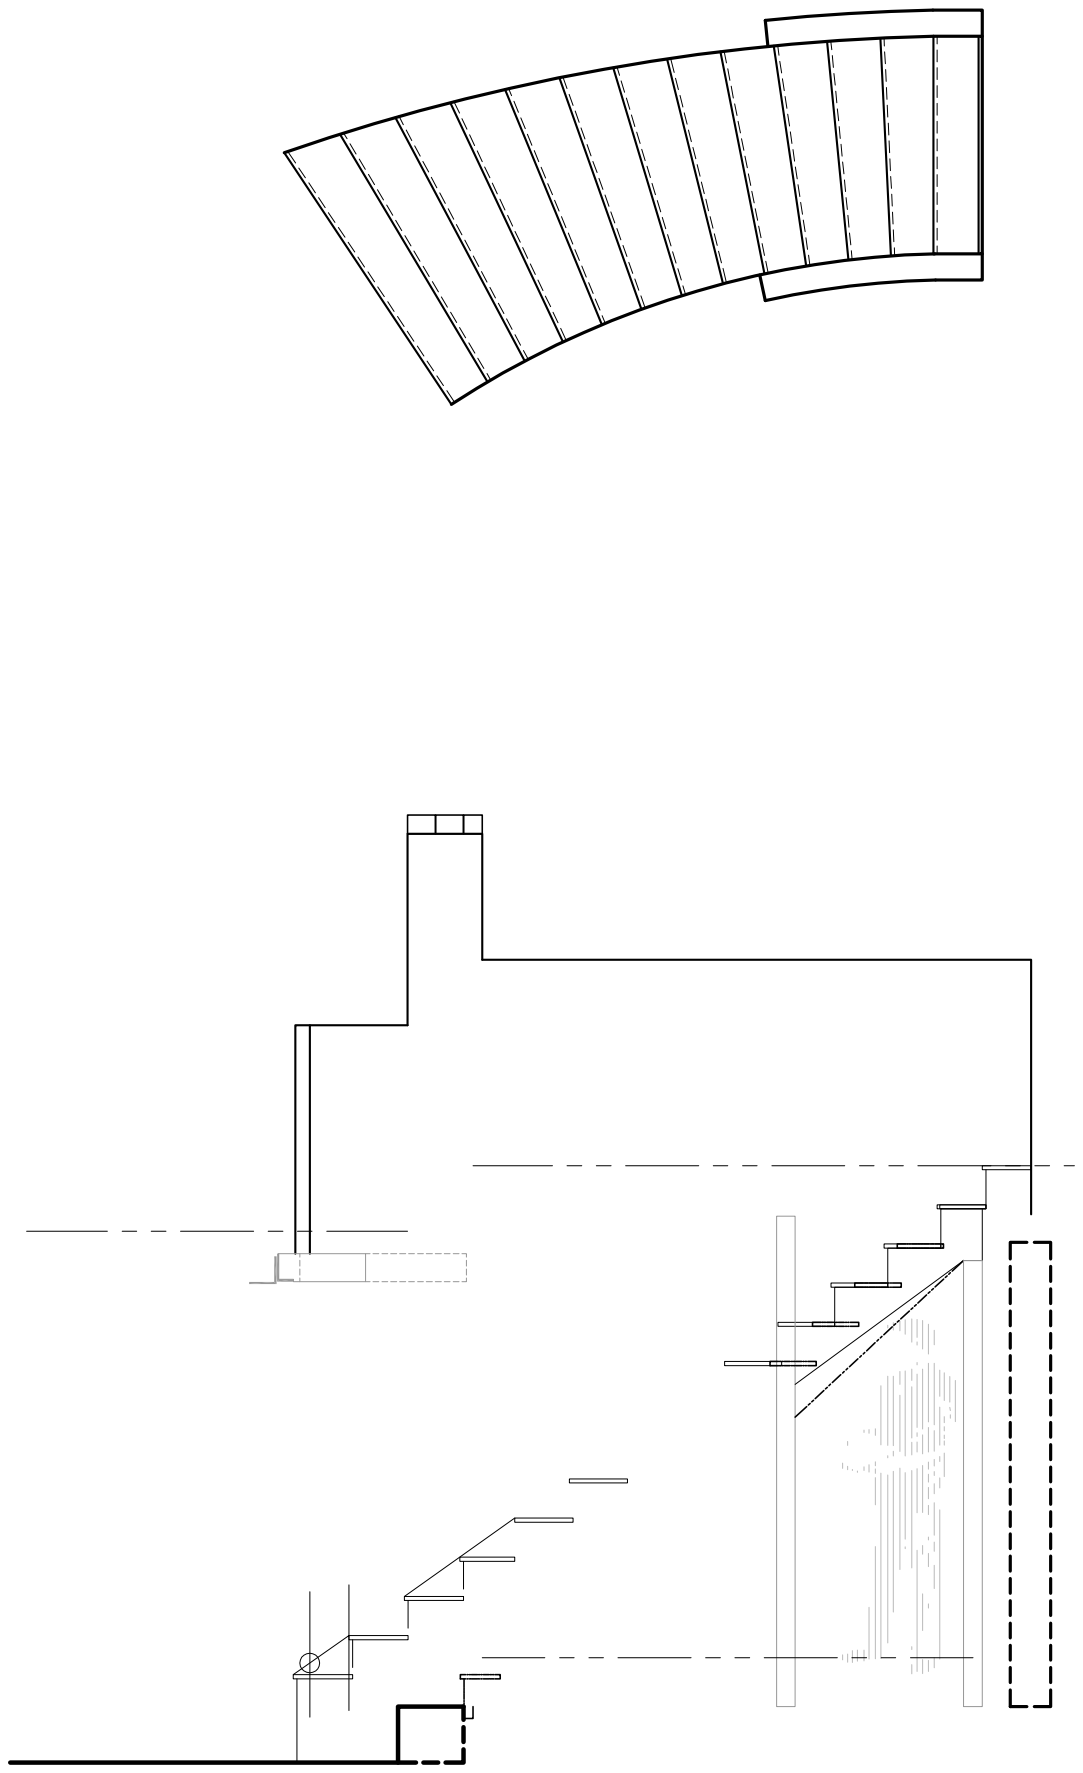
[picture p145: page 1]
