DanielBryars/ChadHouse/2D/175027 Working.pdf

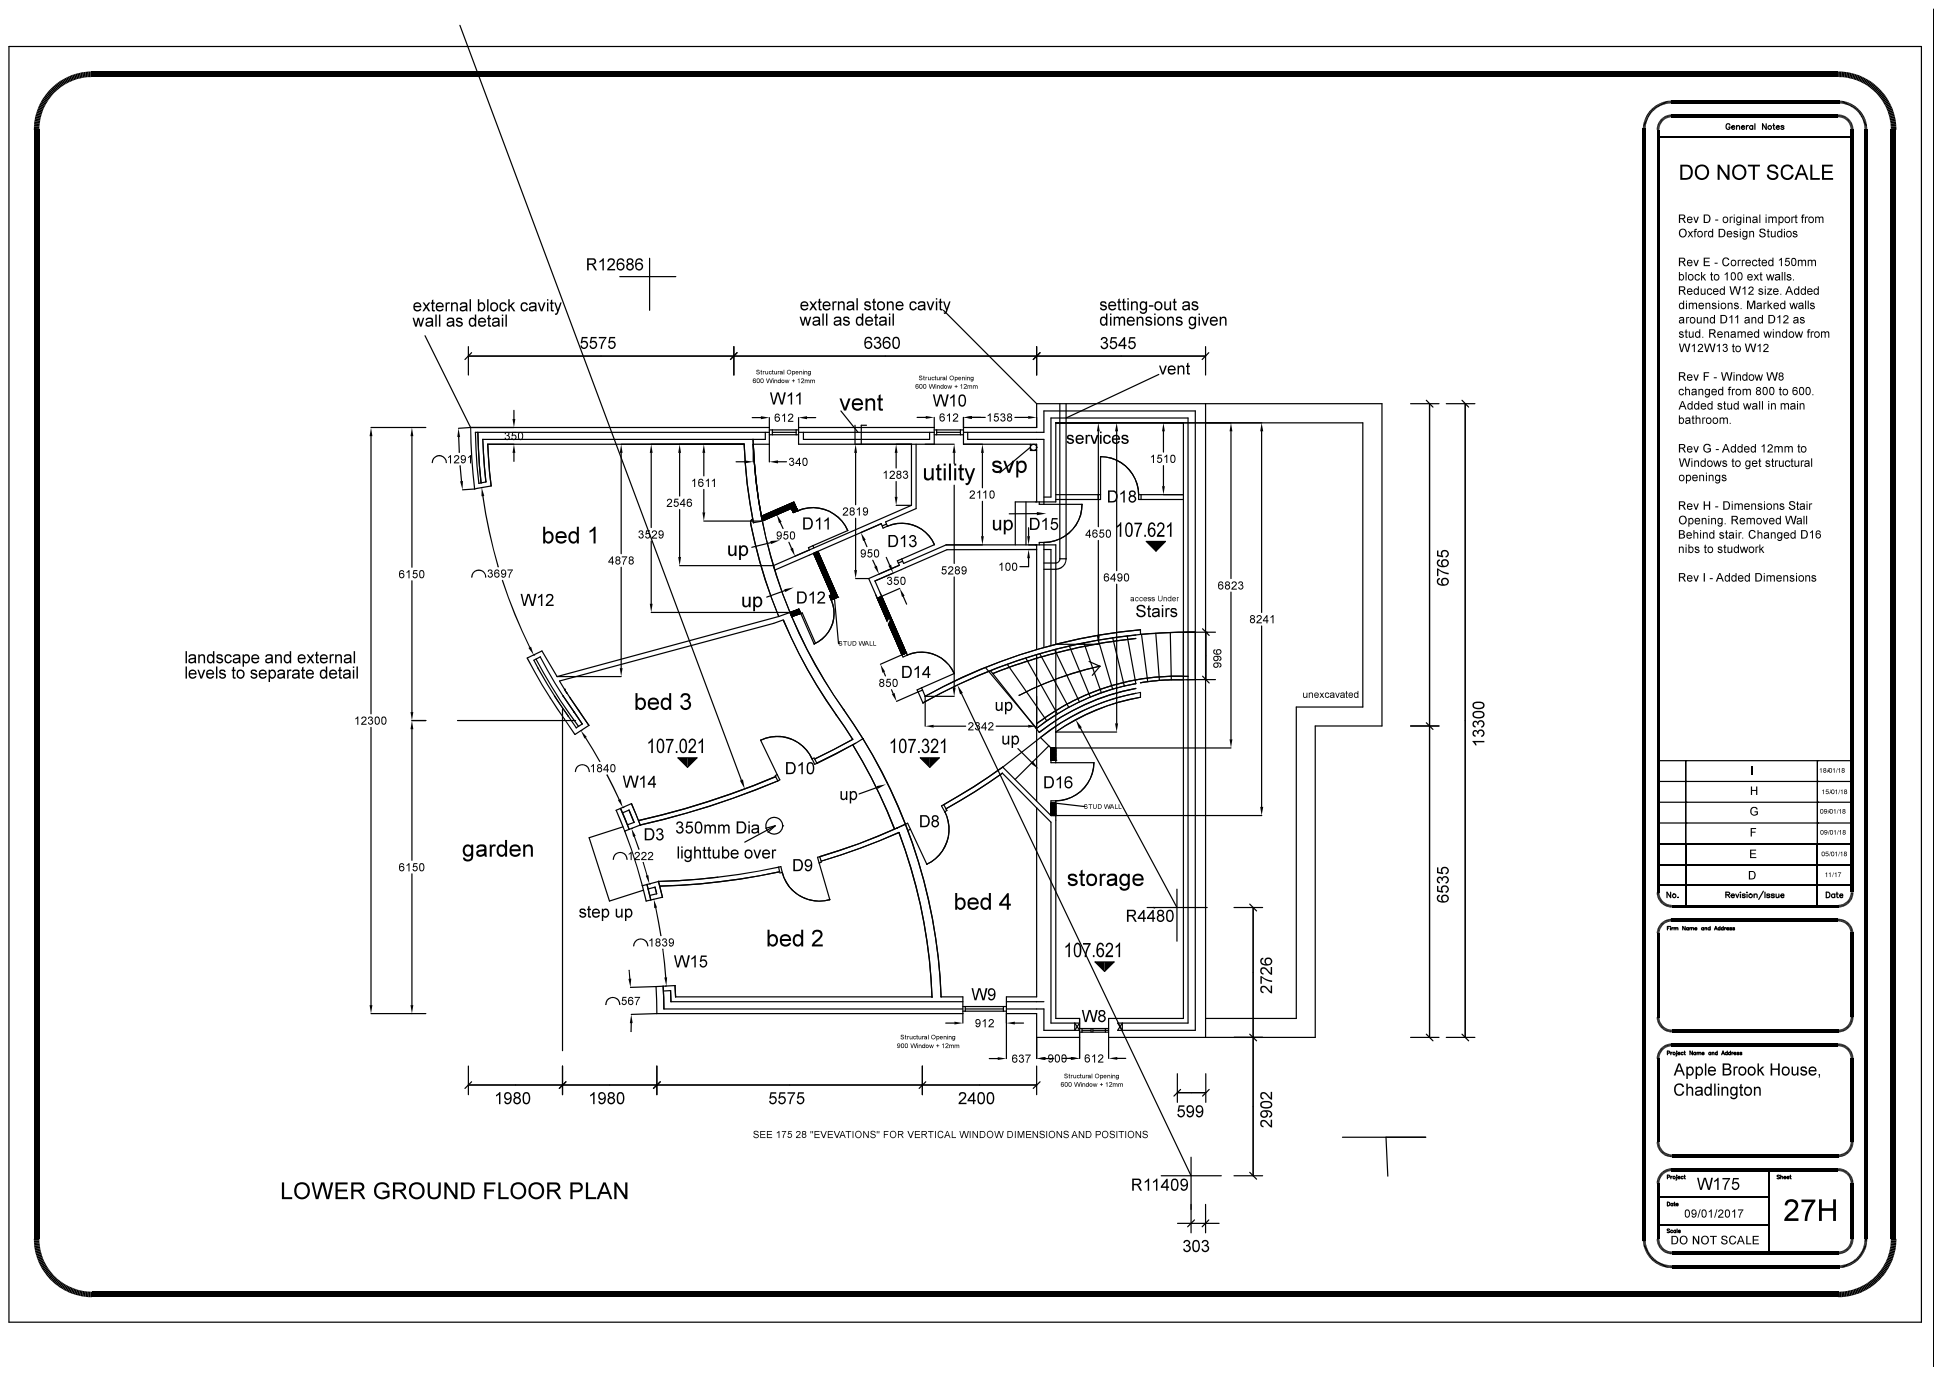
[picture p146: page 1]
