DanielBryars/ChadHouse/2D/175028 Working Elevations For Planning.pdf

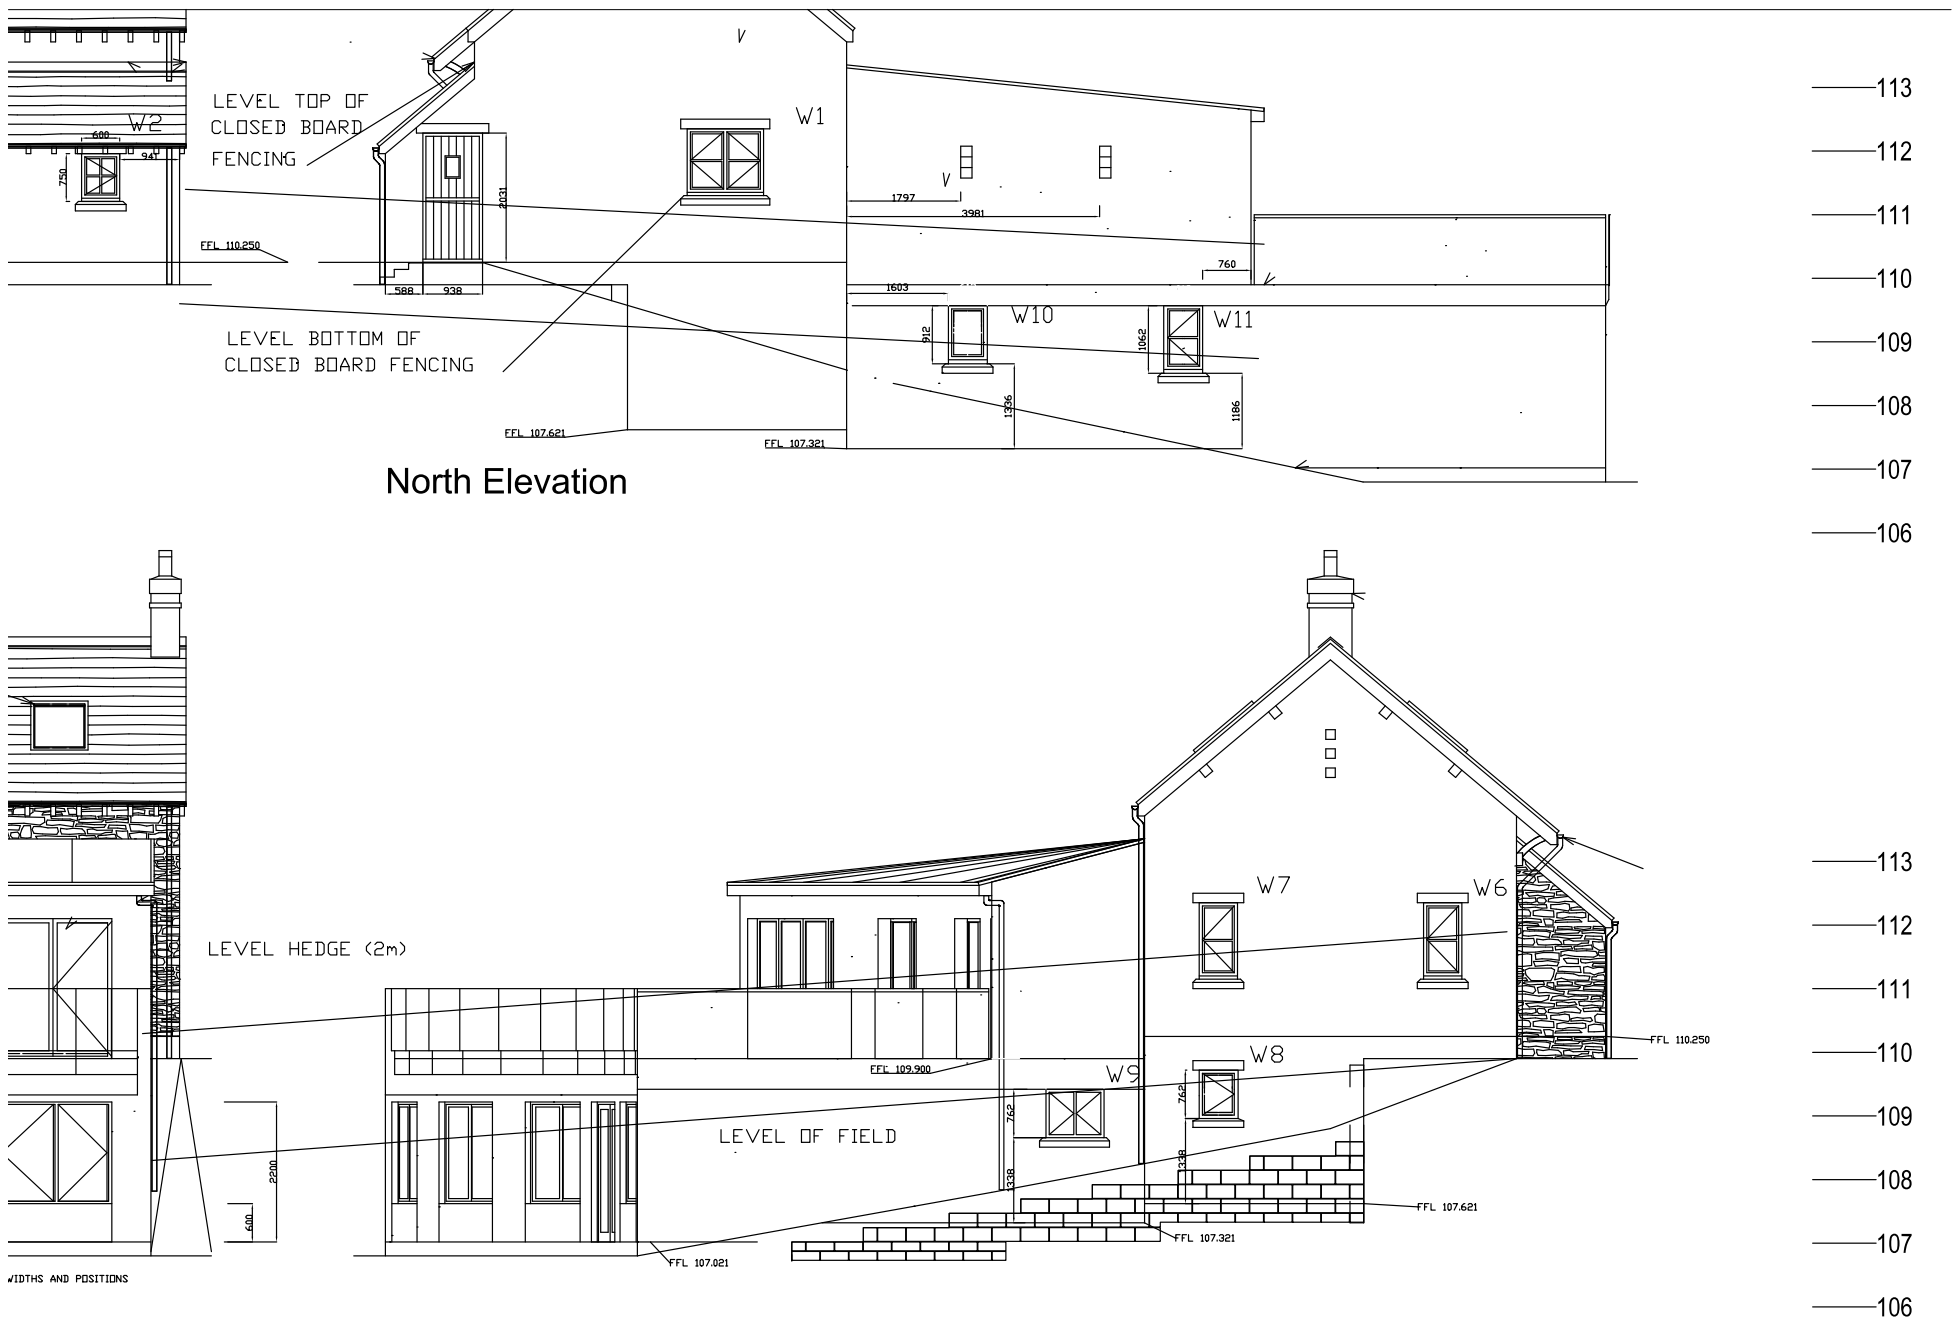
[picture p147: page 1]
