DanielBryars/ChadHouse/2D/West Elevation Window Heights.pdf

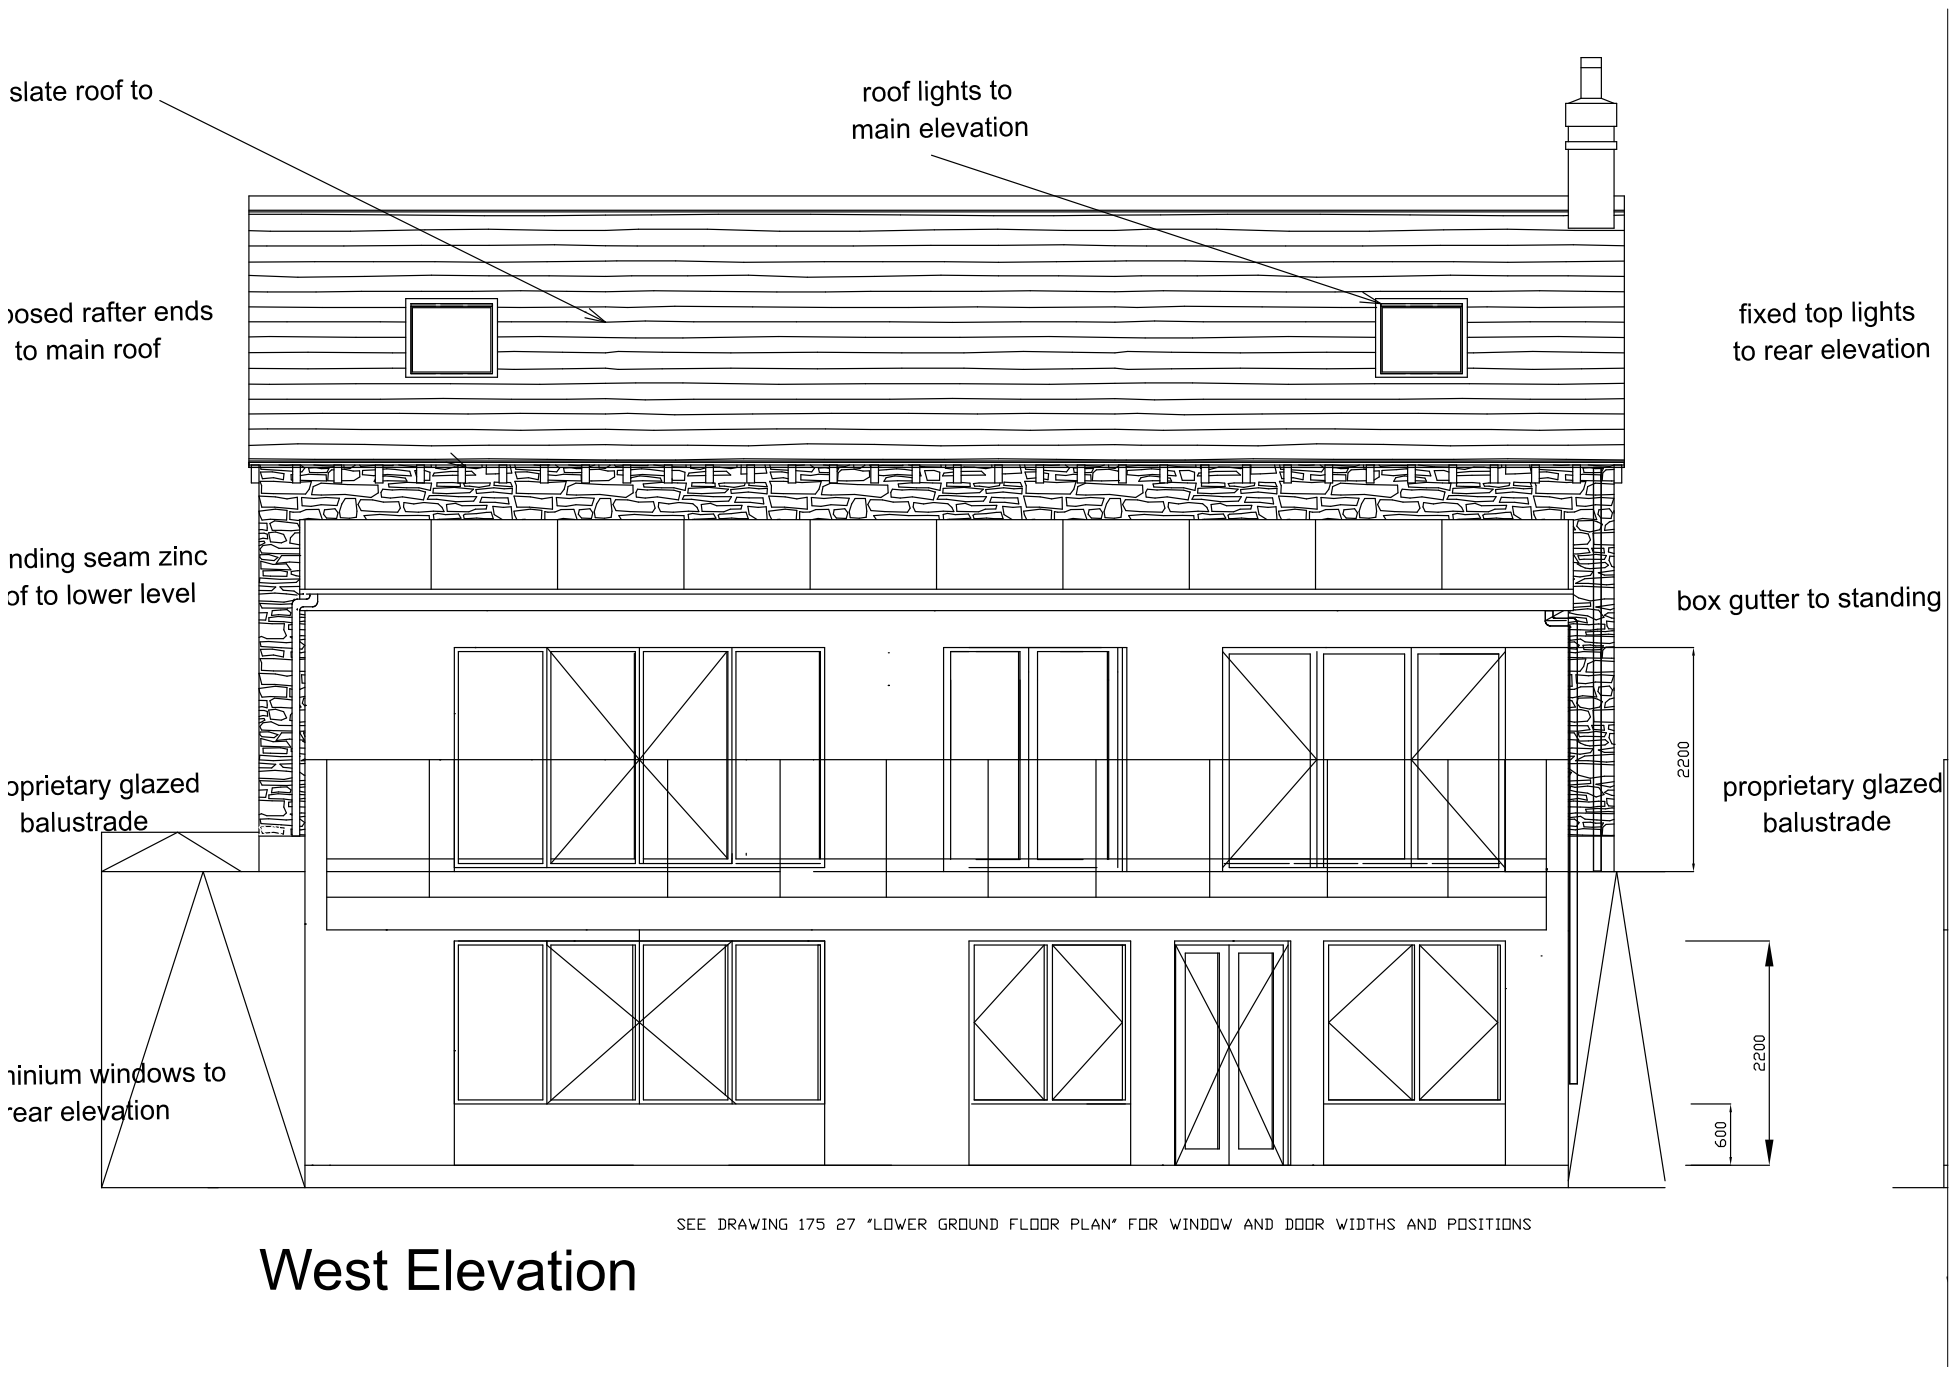
[picture p148: page 1]
