DanielBryars/ChadHouse/2D/175026 Working UGF.pdf

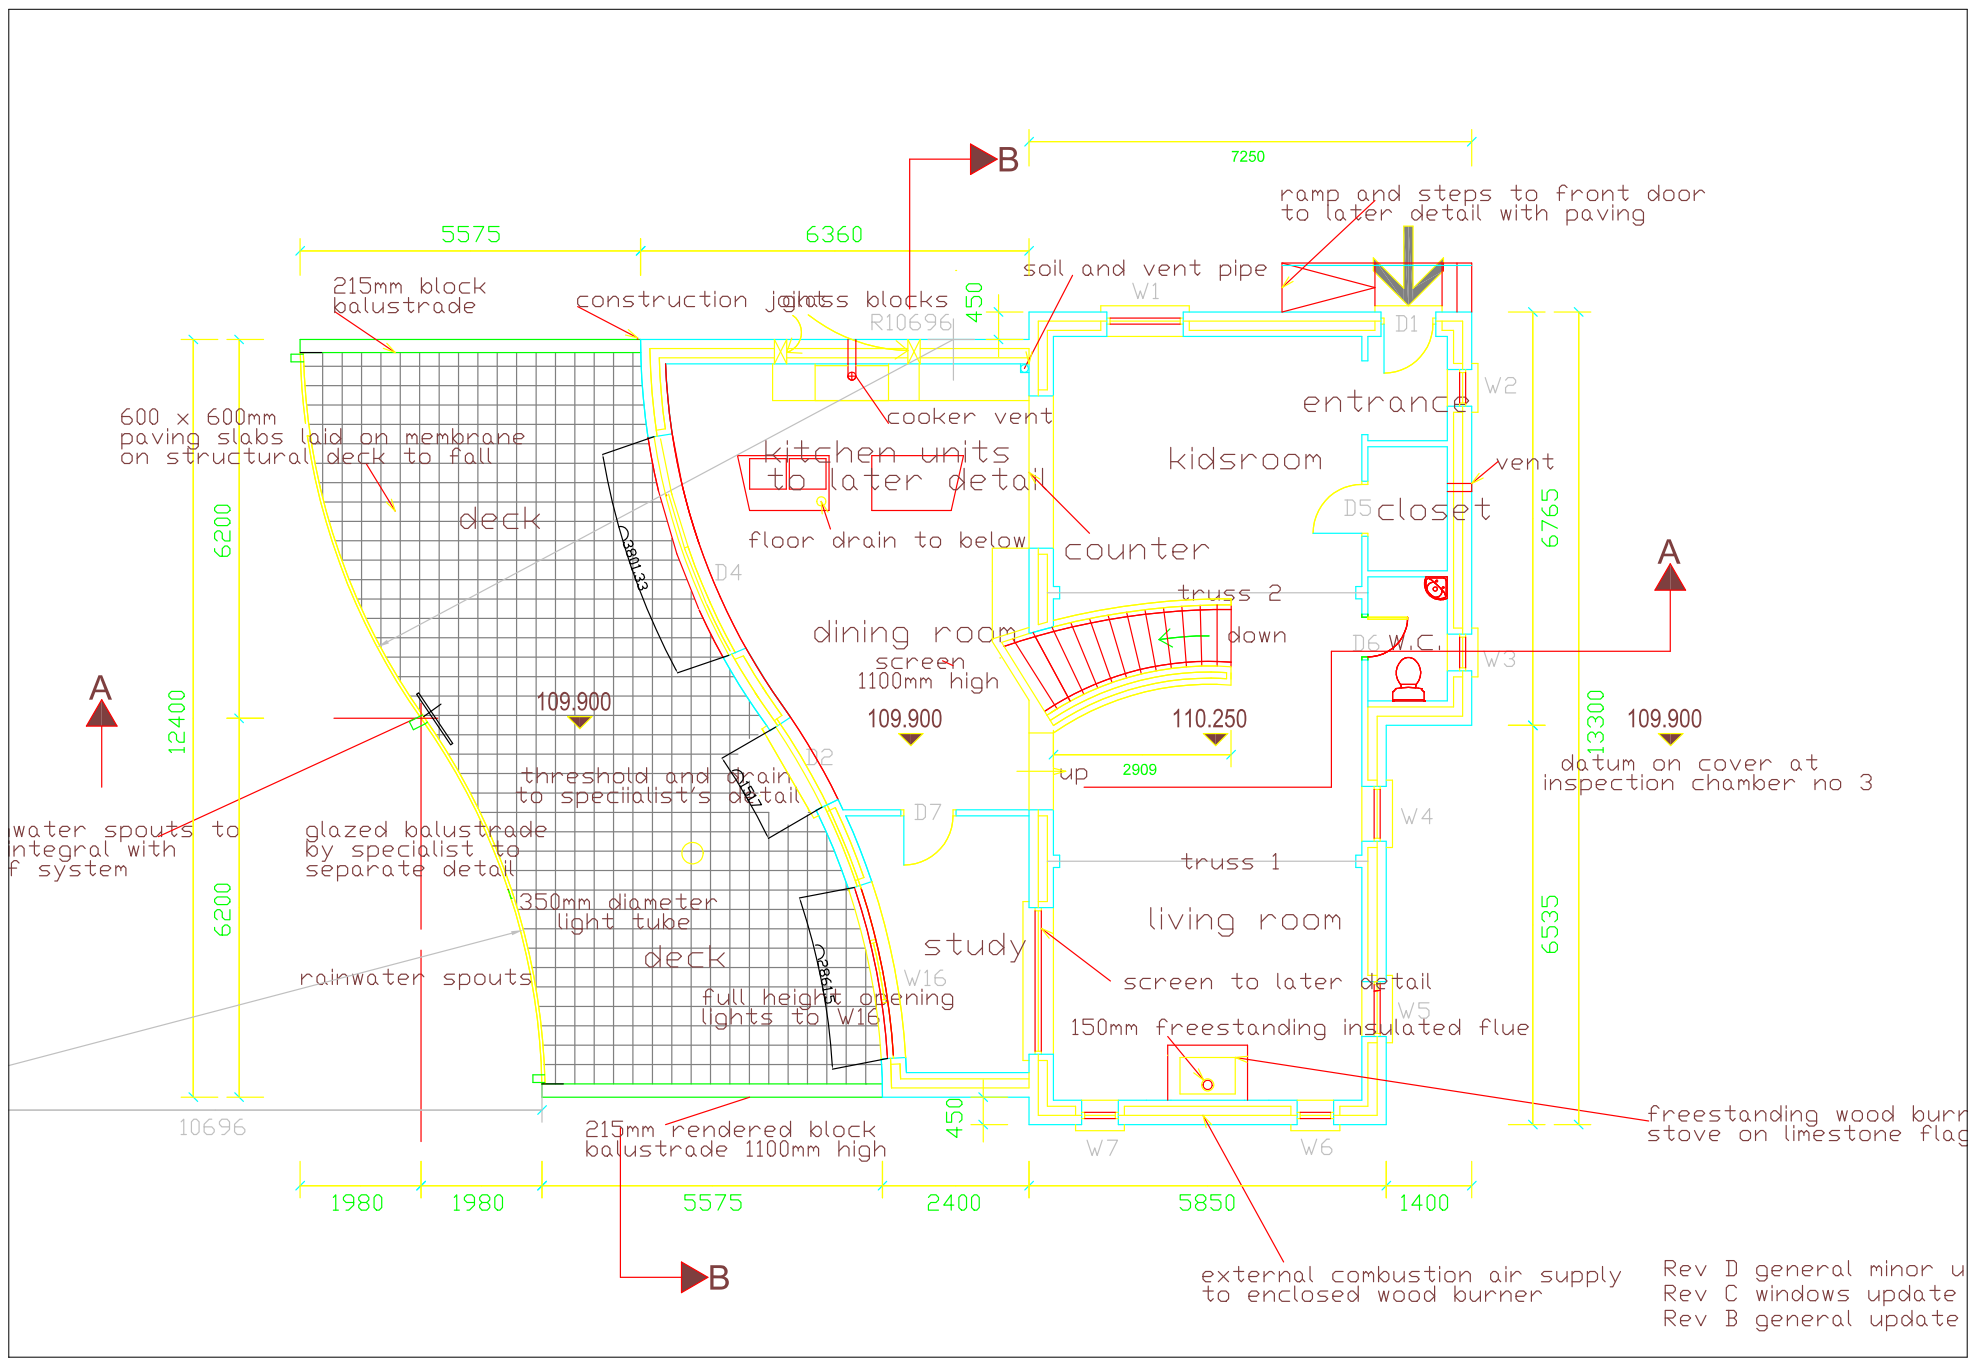
[picture p149: page 1]
