DanielBryars/ChadHouse/2D/175027 Working REV D.1 Dimensioned.pdf

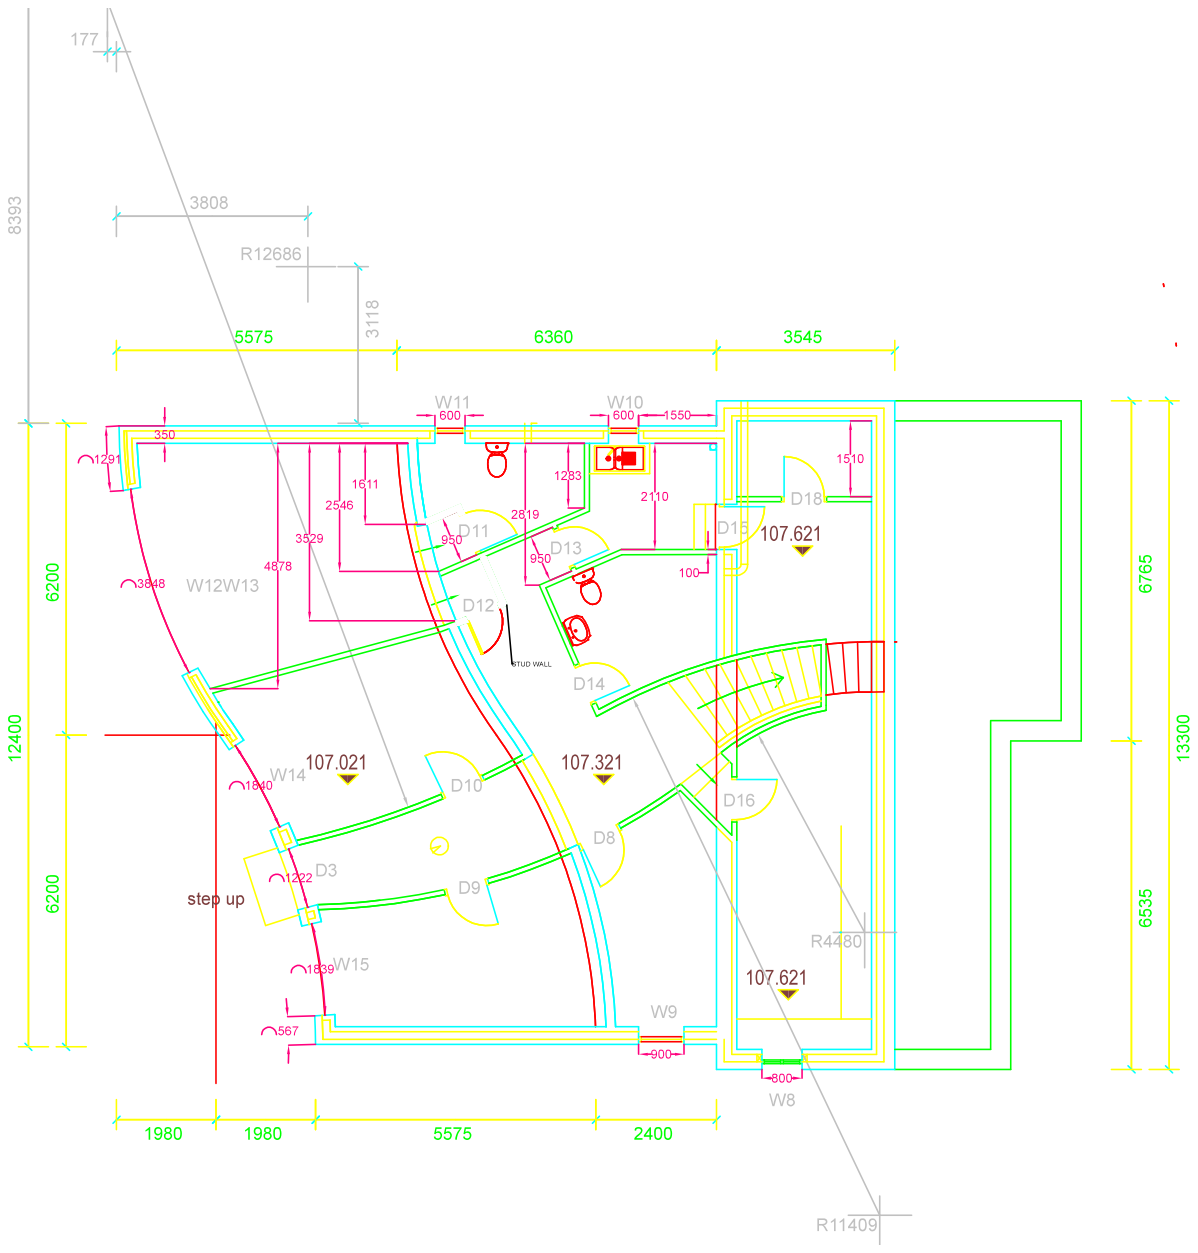
[picture p150: page 1]
