DanielBryars/ChadHouse/2D/ServiceDucts Rev A.pdf

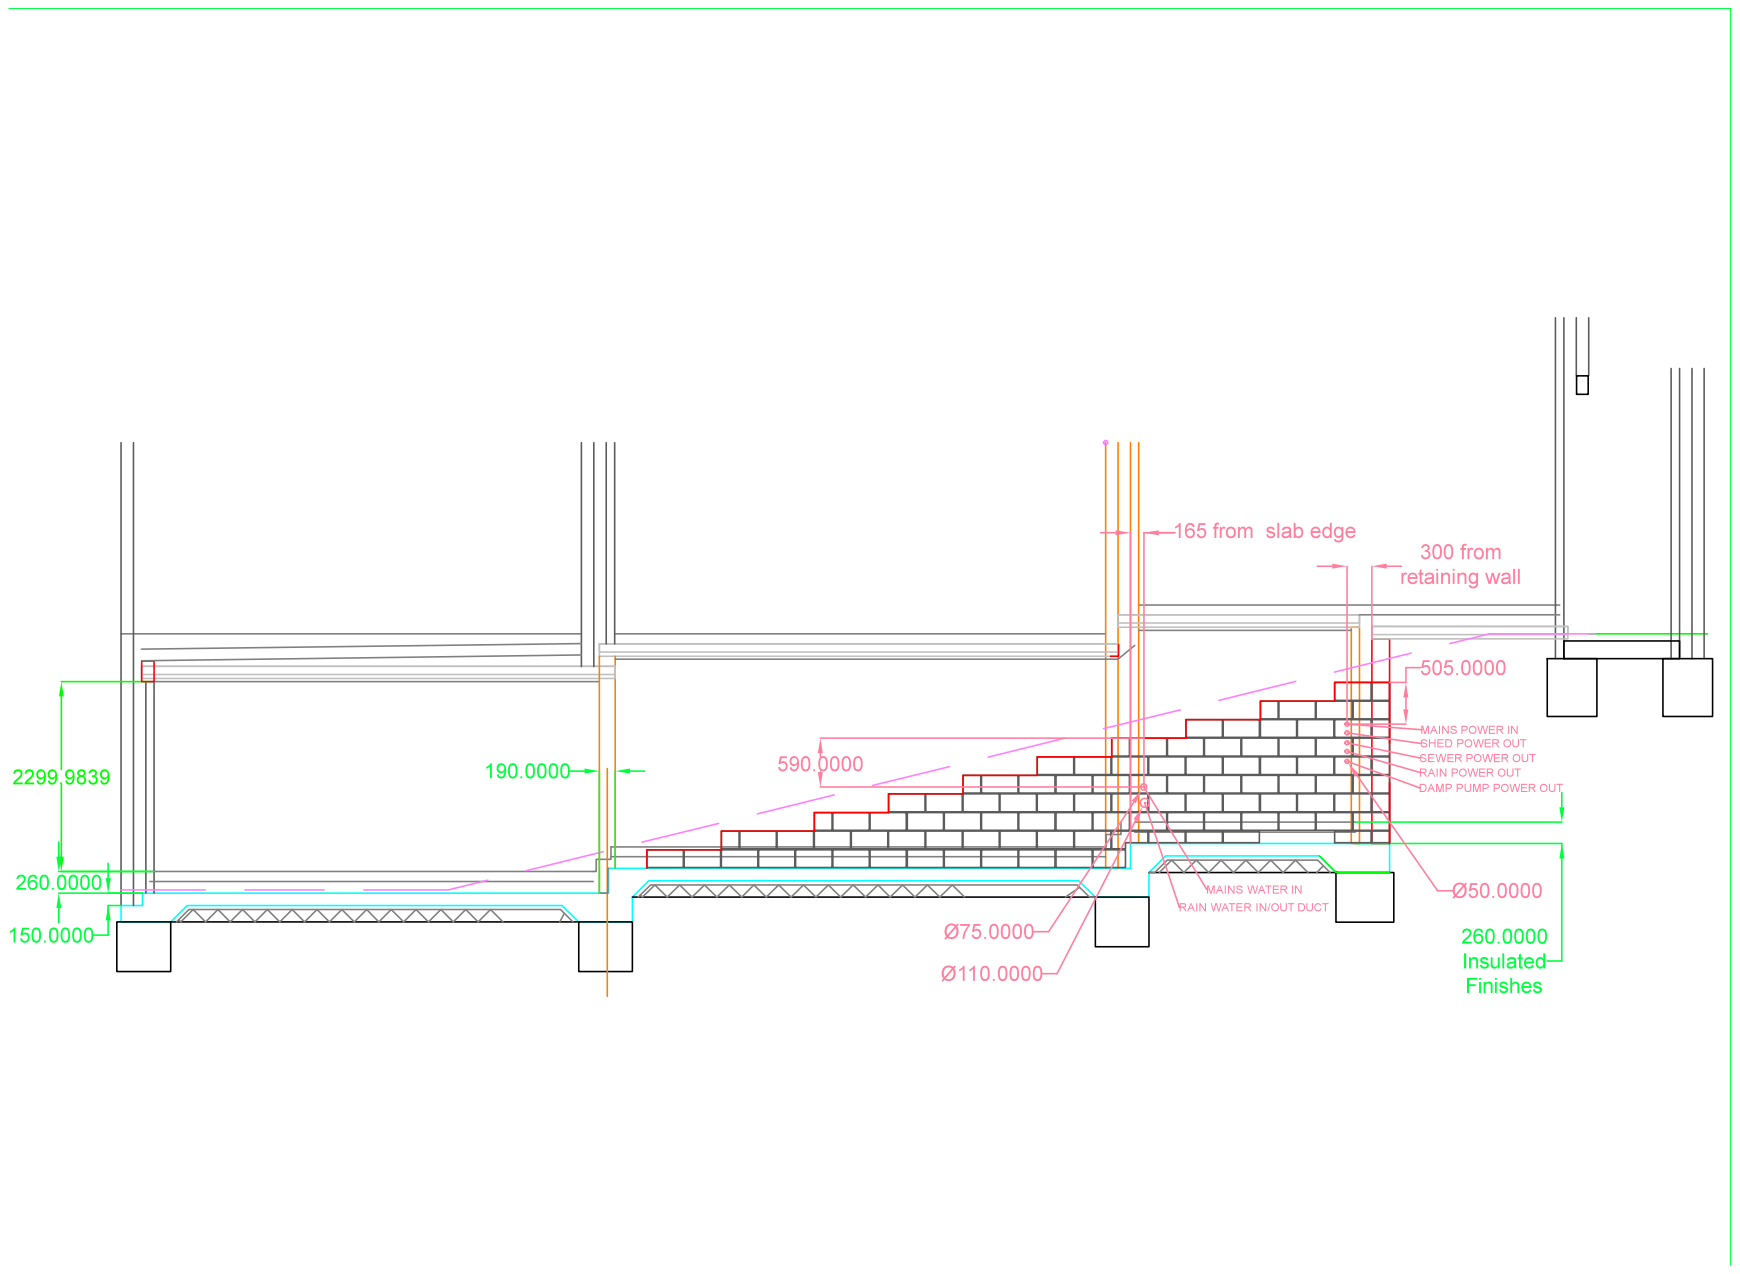
[picture p151: page 1]
