DanielBryars/ChadHouse/2D/ServiceDucts Zoom Rev A.pdf

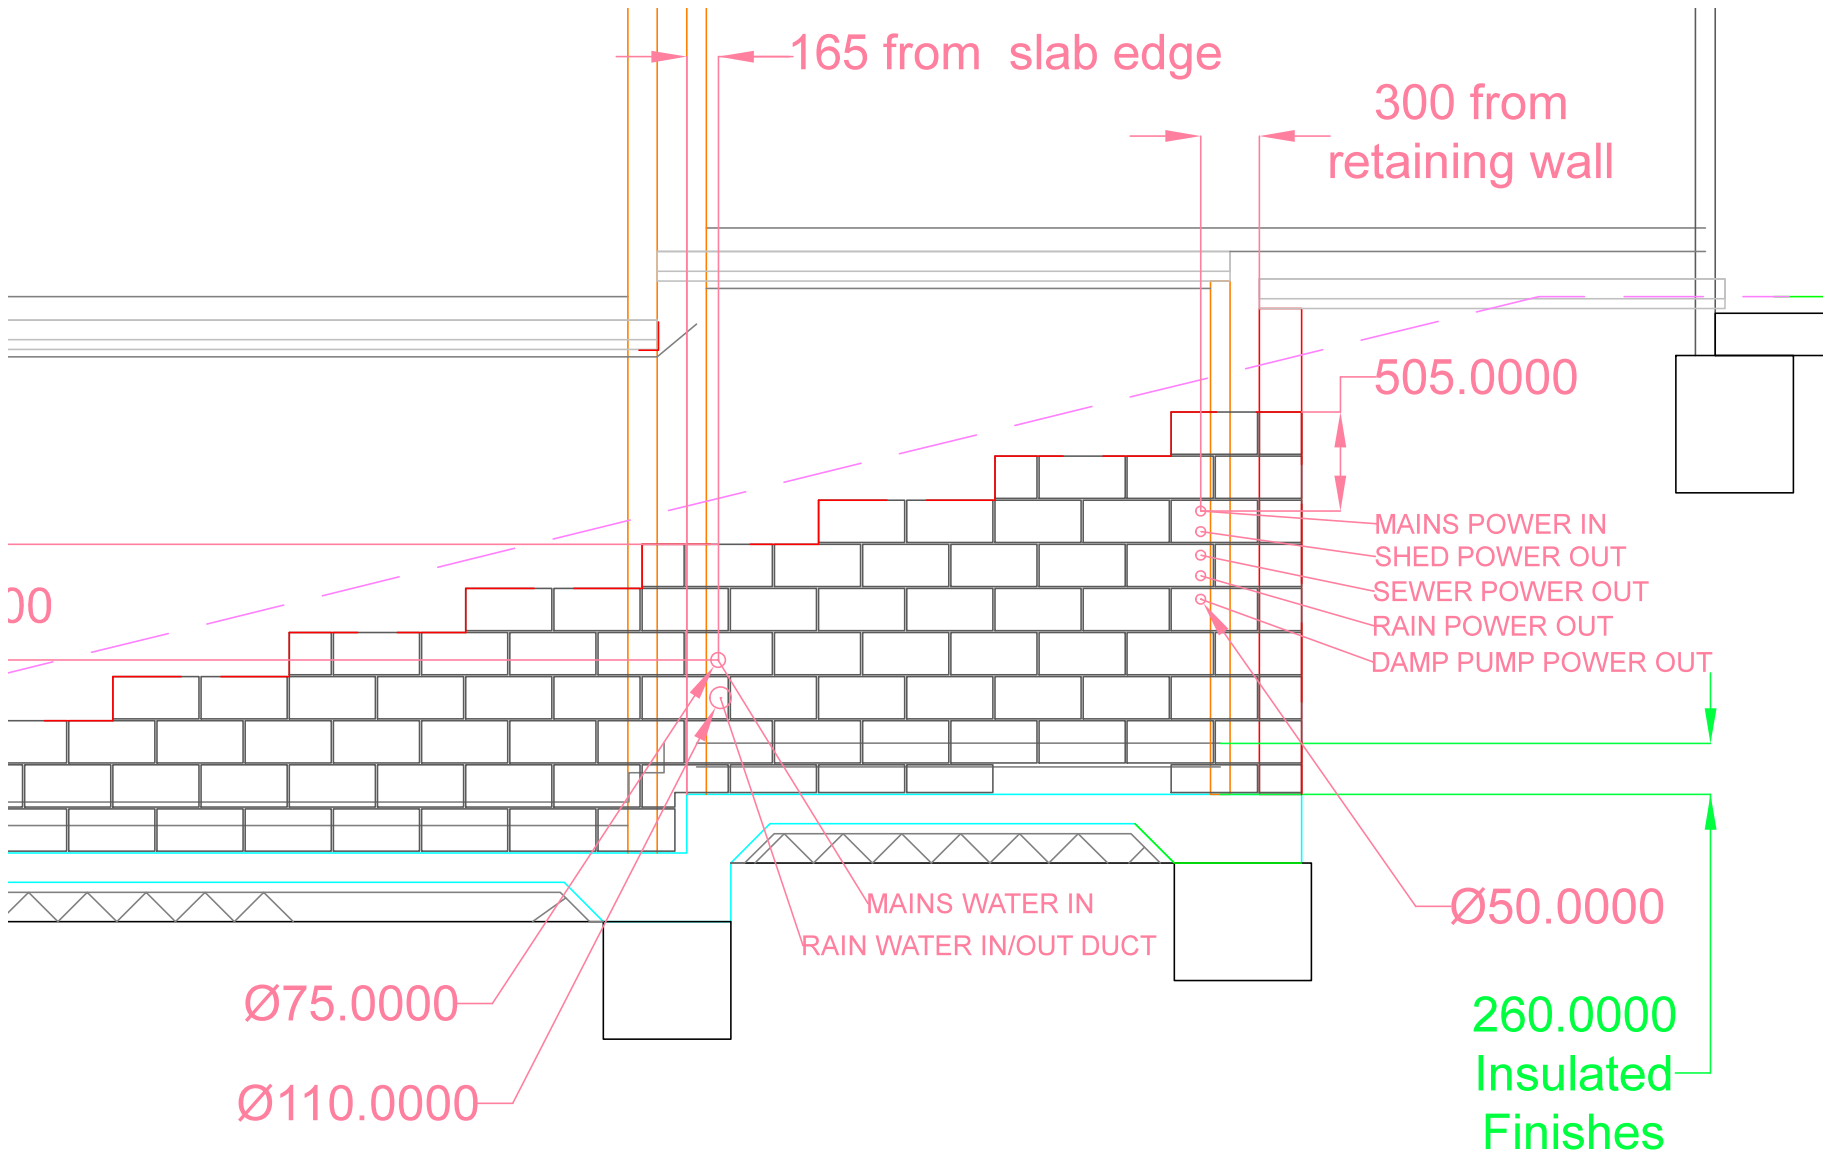
[picture p152: page 1]
