DanielBryars/ChadHouse/2D/Structural/CHB_7011-052p5.pdf

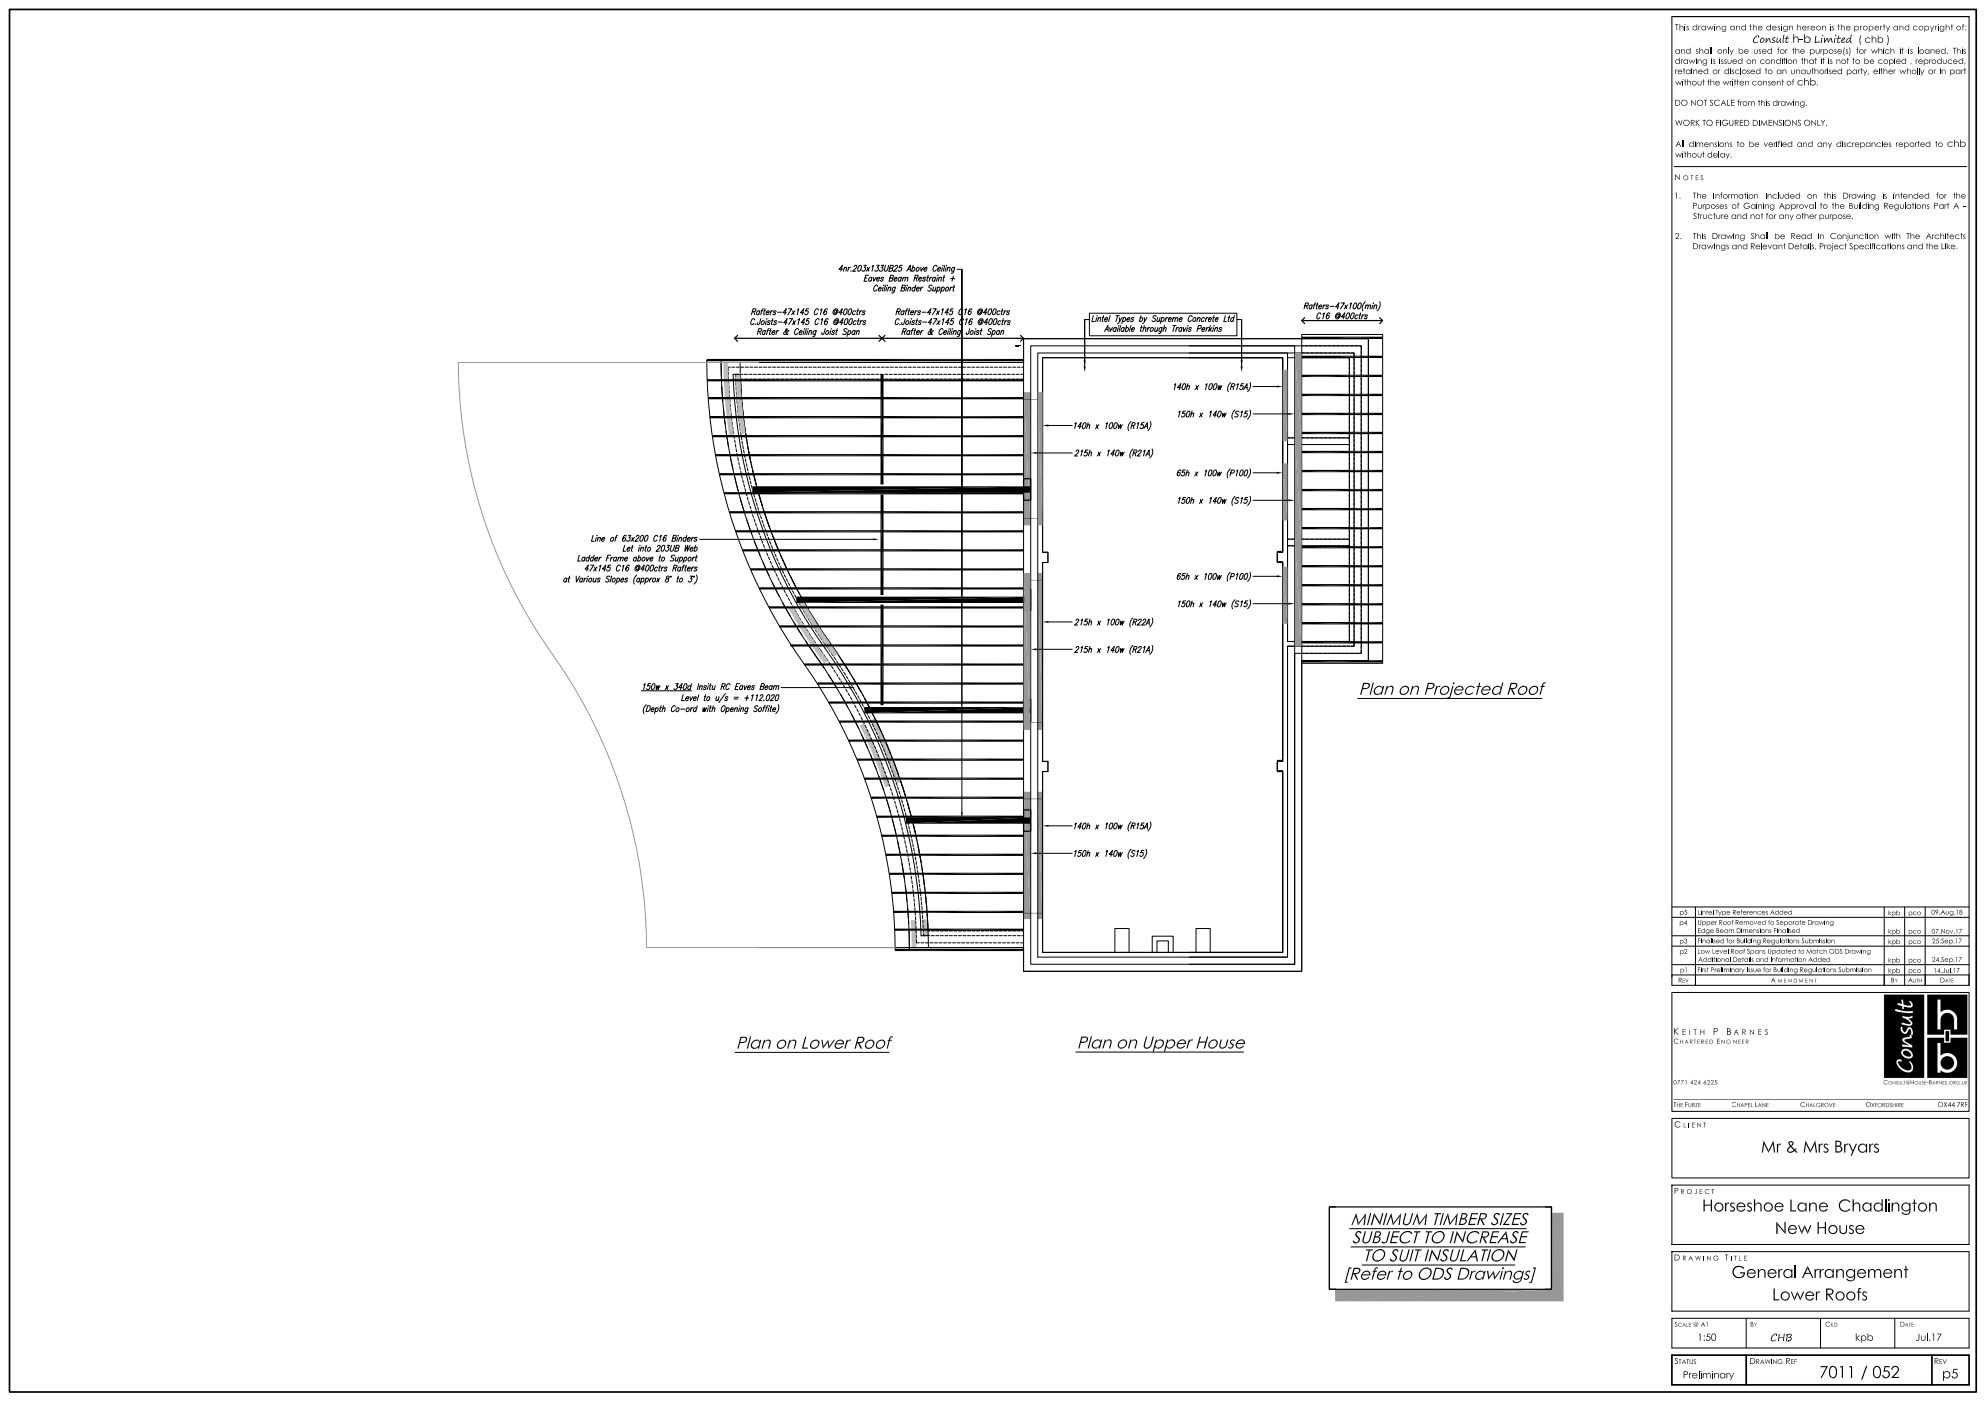
[picture p153: page 1]
