DanielBryars/ChadHouse/2D/Structural/CHB_7011-051p9.pdf

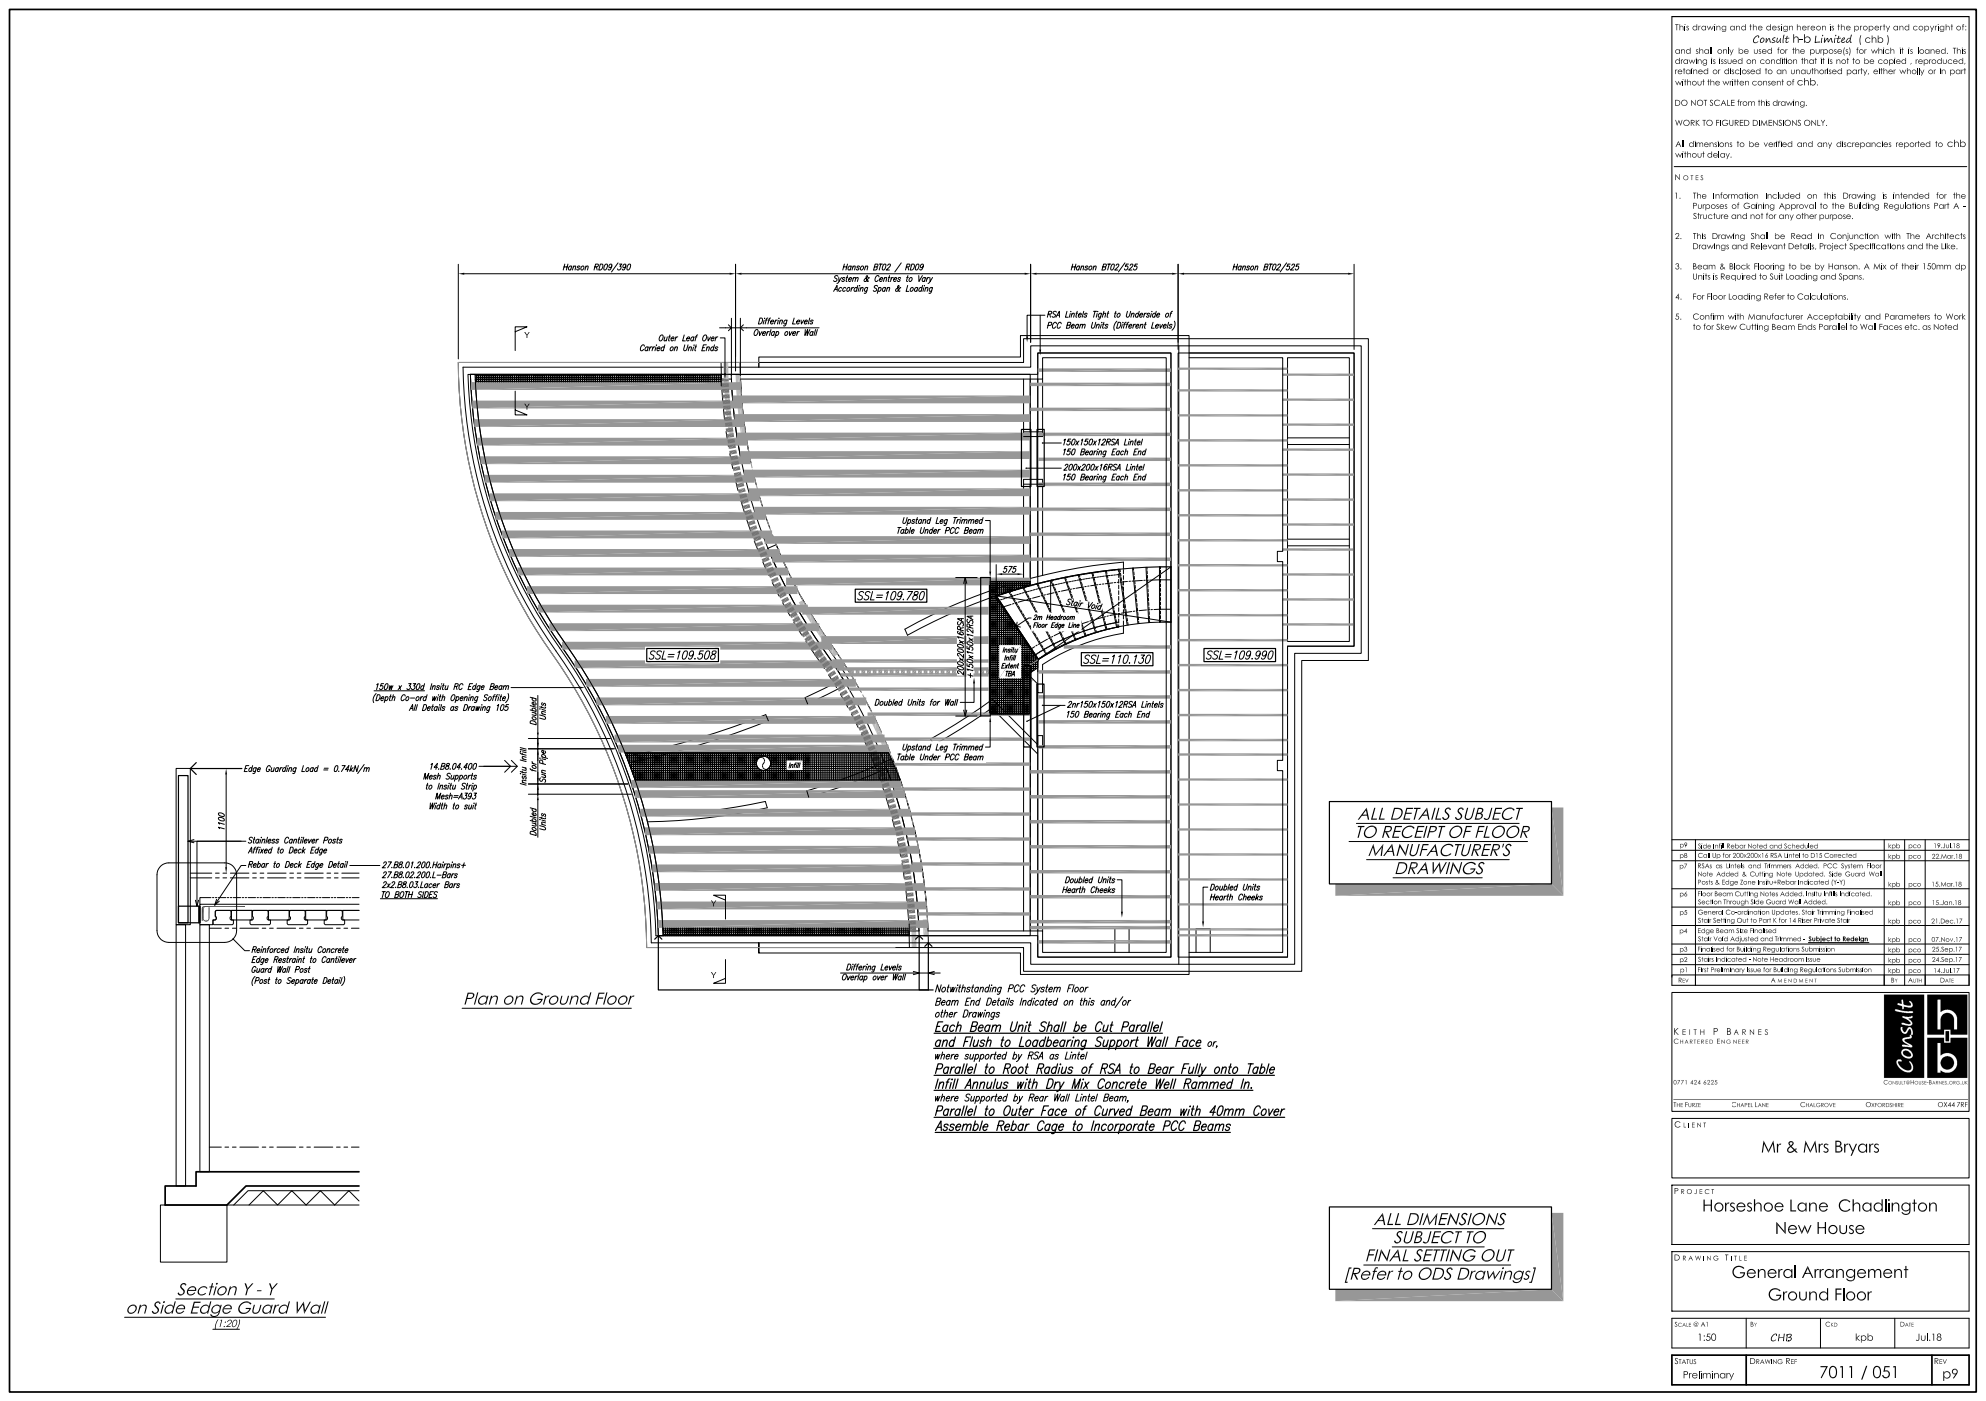
[picture p154: page 1]
