DanielBryars/ChadHouse/2D/Structural/CHB_7011-106p1.pdf

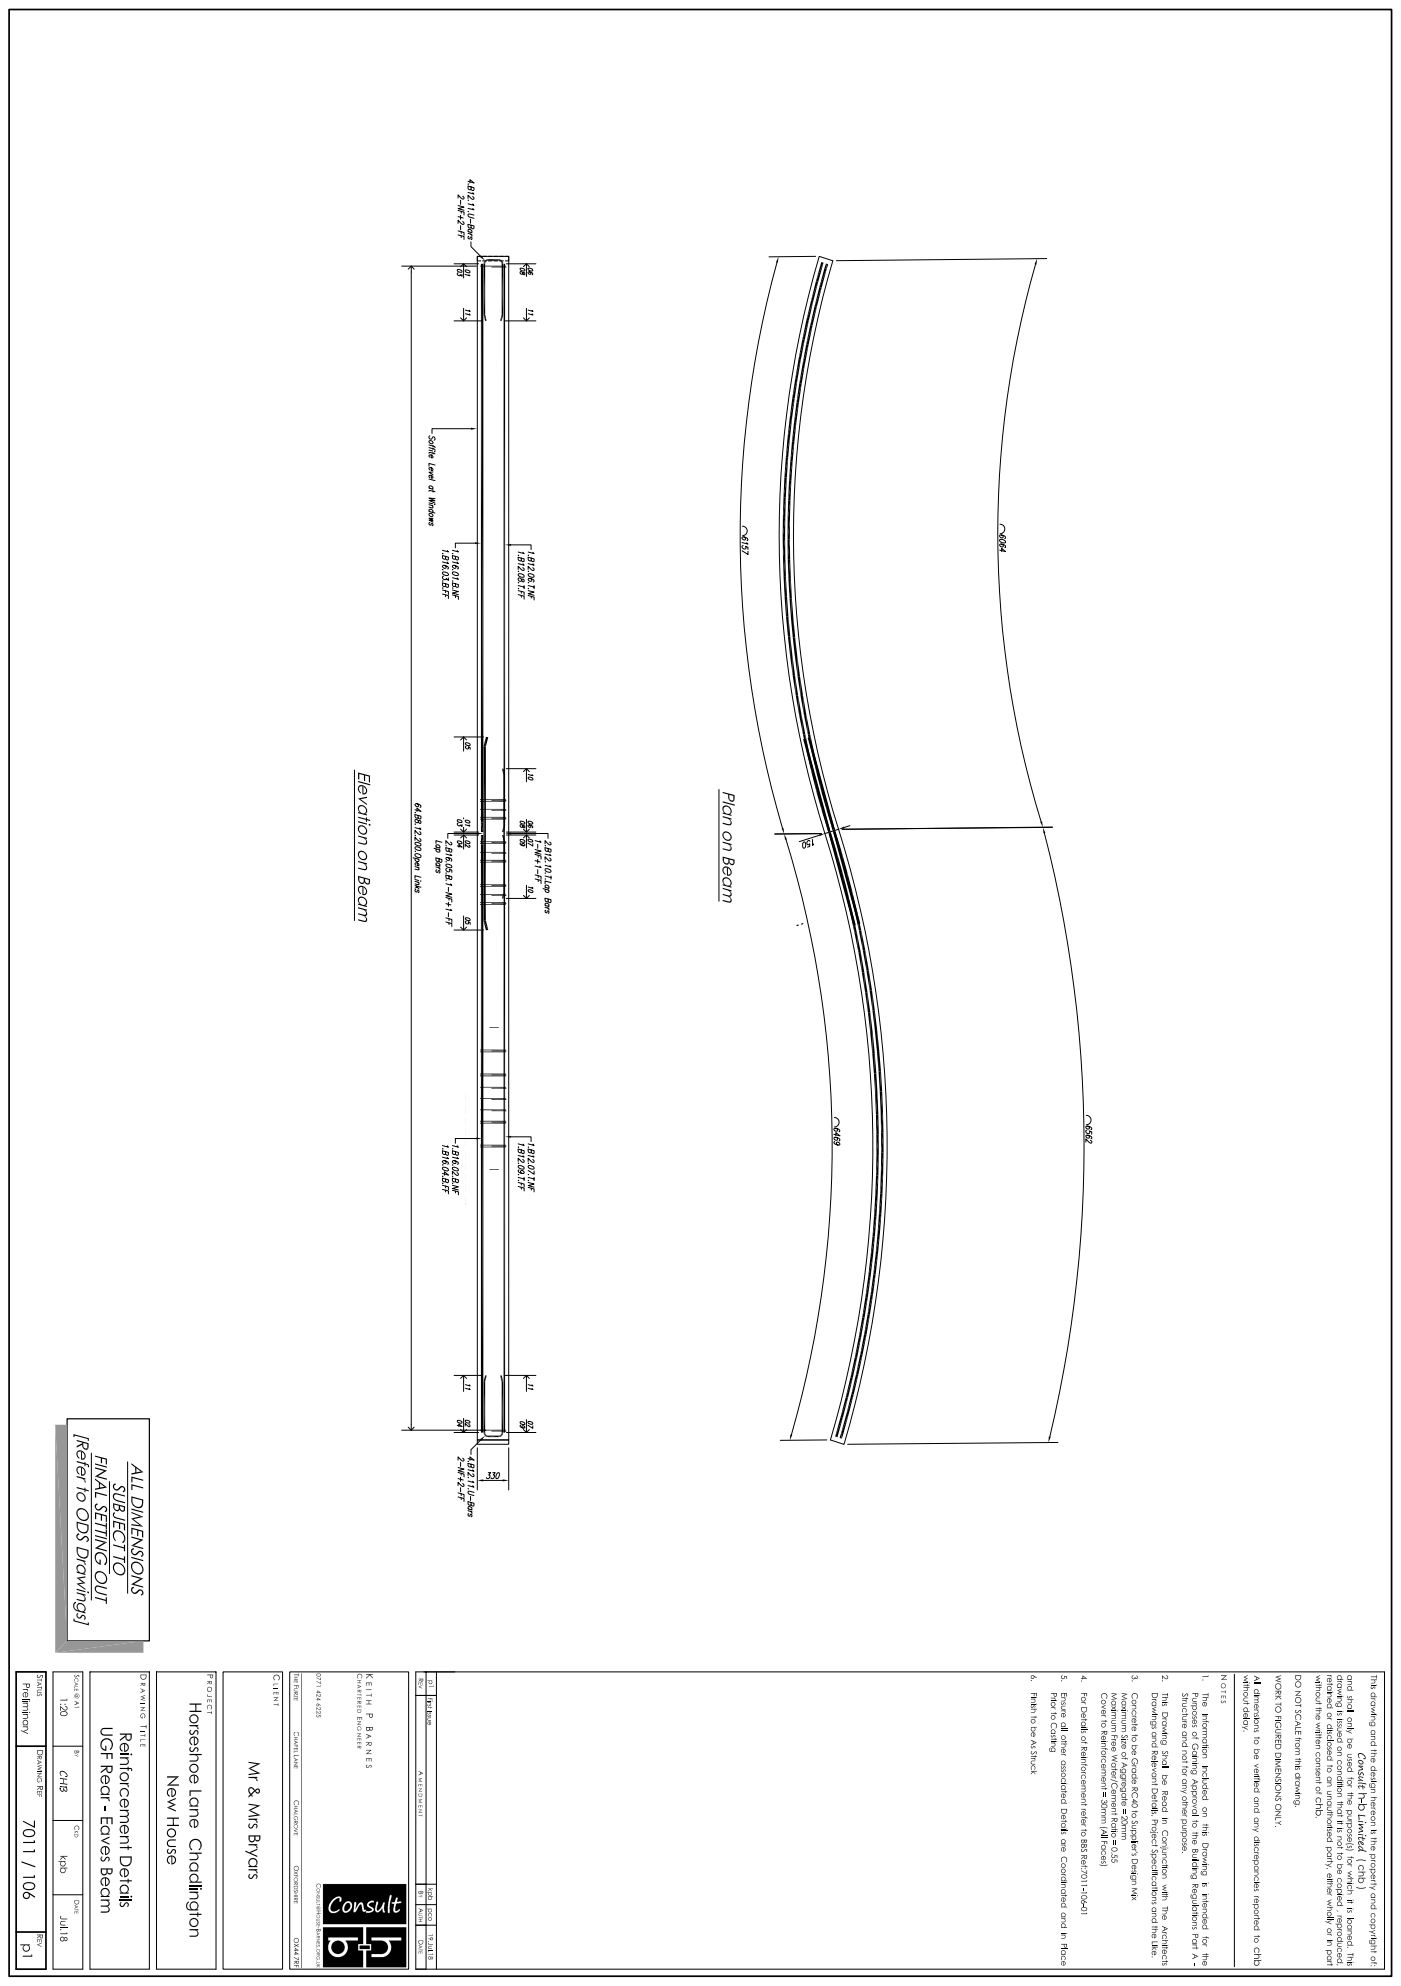
[picture p155: page 1]
