DanielBryars/ChadHouse/(commit log)

2017-01-14 Main Cottage Outline
    [HorseShoeLane.FCStd]
2017-01-14 Added Excel Sheet with dimension workings
    [Dimensions.xlsx]
2017-01-14 Main Cottage Dimensions
    [HorseShoeLane.FCStd]
2017-01-14 Lower Floor WIP
    [Dimensions.xlsx, HorseShoeLane.FCStd]
2017-01-14 LF now on correct Z
    [HorseShoeLane.FCStd]
2017-01-14 Converted to walls
    [HorseShoeLane.FCStd]
2017-01-14 Walls merged
    [HorseShoeLane.FCStd]
2017-01-14 Finished outer walls WIP
    [Dimensions.xlsx, HorseShoeLane.FCStd]
2017-01-14 Roof outline
    [Roof.FCStd]
2017-01-14 Added roof scratch
    [Roof.FCStd]
2017-01-14 Added walls together
    [HorseShoeLane.FCStd]
2017-12-17 Initial Checkin of drawings from Architect
    [CHB_7011 Model Issue171023 SETTING OUT AMENDED 31-10-17.dwg, W175-26D (1).DWG, W175-26D.DWG, W175-27D (1).dwg, W175-27D.dwg, W175-29D.dwg, W175-30D.dwg, W175-31D.dwg]
2017-12-17 Moved into seperate folders added dxf versions
    [CHB_7011 Model Issue171023 SETTING OUT AMENDED 31-10-17.dxf, W175-26D (1).DWG, W175-26D (1).dxf, W175-26D.DWG, W175-26D.dxf, W175-27D (1).dwg, W175-27D (1).dxf, W175-27D.dwg]
2018-01-02 Added more drawings
    [175027 Working.dwg]
2018-01-02 More dimensions
    [175027 Working.dwg]
2018-01-04 Added Service Duct Details
    [175027 Working.dwg, ServiceDucts.dwg]
2018-01-05 Added Rev E to W175-27E
    [175027 Working.dwg, CHB_7011 Model Dan.dxf]
2018-01-05 Updated notes on drawing
    [175027 Working.dwg]
2018-01-05 No actual changes?
    [175027 Working.dwg]
2018-01-09 Added new revisions
    [175027 Working.dwg]
2018-01-09 Renamed folder
    [#CHB_7011 Model Dan.dxf, CHB_7011 Model - to DB.dwg, CHB_7011 Model Dan.dxf, CHB_7011 Model Issue171023 SETTING OUT AMENDED 31-10-17.dwg, CHB_7011 Model Issue171023 SETTING OUT AMENDED 31-10-17.dxf]
2018-01-09 Organised folders
    [#CHB_7011 Model Dan.dxf, CHB_7011 Model - to DB.dwg, CHB_7011 Model Dan.dxf, CHB_7011 Model Issue171023 SETTING OUT AMENDED 31-10-17.dwg, CHB_7011 Model Issue171023 SETTING OUT AMENDED 31-10-17.dxf]
2018-01-10 General Arrangement changes
    [175027 Working.dwg]
2018-01-15 More dimensions!
    [175027 Working.dwg]
2018-01-30 More updates
    [175027 Working.dwg, CHB_7011 Model Issue171023 SETTING OUT AMENDED 31-10-17.dwg]
2018-02-12 More dimensinos
    [175027 Working.dwg]
2018-02-13 Added sketches and method statement
    [CHB_7011 - Structural Method Statement.xlsx]
2018-04-11 Added model from Keith
    [CHB_7011 Model Issue (BB Flr) 180411.dwg]
2018-04-14 MOved around drawings
    [W175-26D (1).DWG, W175-27D (1).dwg]
2018-04-29 Beams added
    [68631_Ground_Floor.dwg]
2018-04-30 Added calcs
    [Dan Terrace Floor Loads.xlsx]
2018-05-27 Addded Velfac details
    [SOUTH OF ANVIL COTTAGE.DWG]
2018-07-03 Added dimensions for rendering
    [175029 Working.dwg]
2018-07-03 Added render area calcs
    [Area Calcs.xlsx]
2018-07-29 Loop Cad Layout before circuits
2018-07-29 Happy with ground floor
2018-07-29 All rooms have circuits
2018-07-30 Design Complete V1
    [AppleBrookHouse.dwg]
2018-07-30 Added areas for internal plastering
    [Areas.xlsx, UFH.xlsx]
2018-07-30 Added PNGs of tube runs
2018-08-02 Added toplogical survey
    [16764-Topo.dwg, 16764.dxf, 16764csv.csv, GroundFloorDFXaug17.dwg, LowerGroundFloorDFXaug17.dwg]
2018-08-02 Various updates
    [UFH.xlsx]
2018-08-02 Added more insulation
    [UFH.xlsx]
2018-08-08 Added GAS forms
    [SOPL_FGP_570UK_METRIC_UK_Website_Version_Rev_2_09_15_1.xlsx]
2018-08-26 Added more work
    [HouseElectrics.xlsx, UFH.xlsx, Wall Supports.xlsx]
2018-10-06 Added v2 of electrical layout
    [HouseElectrics2.xlsx]
2018-10-09 Tidied up
    [HouseElectrics3.xlsx]
2018-10-09 moved files about
    [AppleBrookElectrics.xlsx, HouseElectrics.xlsx, HouseElectrics2.xlsx]
2019-01-28 Added water schematic WIP
2019-05-06 Updated passwords
    [Stair Layout.xlsx, Stairs.dwg]
2020-06-21 More Kitchen stuff
    [Cutlist-Component-enquiry-form-2020-R8.xlsx, Kitchen Island Mould.skp, Kitchen Island Mould2.skp, Kitchen Sideboard Mould .skp, MonitorGlass.skp]
